Alox01/sentinela-smart/docs/mapa/fotos/corte_placa.png

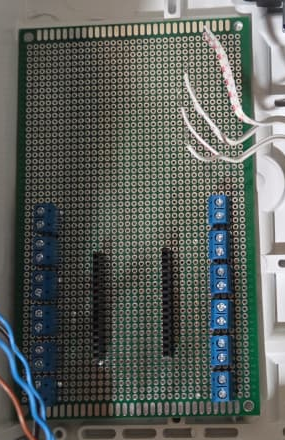
docs/mapa/fotos/corte_placa.png
