Alox01/sentinela-smart/docs/mapa/fotos/corte_fonte.png

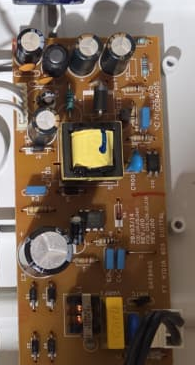
docs/mapa/fotos/corte_fonte.png
