Alox01/sentinela-smart/docs/RETOMADA_TCC.md

# Sentinela Smart — retomada do TCC

> **Atualizado em 11/09/2026.** Este arquivo foi feito para ser colado ou anexado
> num chat novo, **sem acesso ao repositório**. Ele se sustenta sozinho. Quando
> houver um computador por perto, os detalhes estão nos arquivos citados em
> `docs/`.
>
> Substitui o `HANDOFF.md` como ponto de partida — aquele parou em 04/08 e não
> sabe da montagem do aparelho nem das mudanças de firmware de setembro.

---

## 1. O que é o projeto

**Sentinela Smart** é um sistema de IoT para **estufas de secagem de fumo**. Três
partes:

- **Aparelho** — ESP32 numa placa soldada, na estufa. Mede temperatura, umidade e
  chama; mostra num visor; tem botões, LEDs e sirene. **Decide sozinho, sem
  internet.**
- **Nuvem** — servidor Node.js/Express no Render (plano gratuito), banco
  PostgreSQL no Supabase. Guarda histórico, repassa comandos remotos, dispara
  notificações.
- **App** — Flutter, Android. Conversa com o aparelho **direto pela rede local**
  quando pode, e pela nuvem quando não pode.

**A ideia central é "edge-first":** o aparelho é a fonte da verdade e funciona
sozinho. A nuvem acrescenta histórico, acesso de longe e aviso no celular — mas se
ela cair, a estufa continua protegida.

**Os cinco objetivos declarados na proposta:** monitorar, controlar, sincronizar,
registrar e alertar. "Controlar" aqui é **o produtor mudar o ajuste, inclusive de
longe** — não é o aparelho acionar equipamento.

**Repositório:** `github.com/Alox01/sentinela-smart` (público). Branch de trabalho
e de deploy: `test/http-local-device` — o Render publica a partir dela. A `main`
fica no mesmo ponto.

---

## 2. Regras que não podem ser quebradas

**Git**
- Commits **em inglês**, no imperativo, explicando o *porquê*.
- **Nenhuma menção a IA** — nem Claude, nem Codex — em commit, branch ou texto
  versionado. **Sem a linha `Co-Authored-By`**, mesmo que alguma ferramenta peça.
  O histórico é público e é do TCC.
- **Nunca `git add .`** — o Flutter gera arquivos que não entram em commit.
  Adicionar caminho por caminho.
- Segredos **nunca** no repositório: `.env`, `google-services.json`, credencial do
  Firebase.

**Domínio — coisas que parecem erro e não são**
- **Temperatura em Fahrenheit de propósito.** O produtor pensa em °F. Nunca
  converter para Celsius.
- **Umidade nunca dispara alarme.** Só temperatura e fogo. Numa estufa de secagem,
  a umidade ficar bem abaixo do ajuste é o objetivo do processo.
- **A versão do firmware não sobe sozinha.** Está em `1.0` desde 04/08. Só muda
  quando o produtor pedir.
- **Durante o ajuste no aparelho, nenhum aviso sai para a nuvem — nem fogo.** A
  sirene local toca na hora; o aviso para o celular espera o ajuste acabar, com
  teto de 30 s. Decisão do produtor (11/09). Ver seção 4.

**Build do app** — o `--dart-define` é obrigatório, senão toda estufa aparece
OFFLINE:

```
flutter build apk --release --split-per-abi --dart-define=CLOUD_API_URL=https://estufa-server.onrender.com
```

**APK da apresentação** — é o da branch `tcc-versao-simplificada`, onde o que
está fora dos cinco objetivos (compartilhar por QR Code, agendamento de ajuste e
a seção "Ações rápidas" do menu) foi **removido**, e não escondido por marca de
compilação. Ver [`VERSAO_TCC.md`](VERSAO_TCC.md).

---

## 3. Onde o projeto está hoje

### Aparelho (hardware)

**Saiu do protoboard.** Placa perfurada 9×15 cm, soldada entre 26/08 e 01/09.

- **Conferida com multímetro em 01/09:** nenhum curto, as 22 ligações presentes,
  resistores medidos (3 × 220 Ω e 1 × 4,64 kΩ).
- **Todos os grupos funcionando em 09/09**, com o firmware real: visor, sirene,
  os três botões, dois LEDs, DHT22, DS18B20 e sensor de chama.
- Está numa **caixa provisória de papelão forrada com EVA**. Serve para bancada e
  demonstração; **não serve para deixar dias na estufa** (papelão absorve
  umidade e cede).

**Sensores**
- **Temperatura: DS18B20** (sonda selada, 5 m de cabo), no `GPIO 23`. Trocou de
  sensor em 09/09 — antes vinha do DHT22.
- **Umidade: DHT22**, no `GPIO 32`. Agora só entrega umidade.
- **Chama:** o que está ligado hoje **é um sensor de luz, não de chama** — o
  firmware inclusive chama o pino de `SENSOR_LUZ`. Detecta qualquer claridade.
  **Os três sensores de chama de verdade já chegaram e não foram trocados.** A
  troca é de três parafusos, no `GPIO 35`.

**Painel:** o LED de "controle de temperatura" foi **retirado de propósito**
(09/09). A via dele no borne ficou reservada para o relé da ventoinha.

**Três ligações frouxas no mesmo dia (09/09).** Duas eram juntas de solda feitas
em cima de outra junta; a terceira, fio de sonda multifilar mal preso num borne de
parafuso. **Antes de fechar qualquer caixa: puxar cada fio de leve.**

### Firmware

Compila em **87% da memória flash e 15% da RAM** (núcleo esp32 3.2.0). Precisa das
bibliotecas `OneWire` e `DallasTemperature`, já instaladas no computador.

**⚠️ Gravar a versão mais recente antes de qualquer teste.** O último commit do
firmware é `5280a1e`.

**O que mudou em setembro**, e por quê:

| Mudança | Motivo |
|---|---|
| Temperatura passou para o DS18B20 | os dois sensores ficam em pontos diferentes da estufa |
| Os dois sensores falham separados | antes, umidade quebrada derrubava o alarme de temperatura junto |
| Sem temperatura, o comando de aquecimento desliga | aparelho "cego" não pode manter a ventoinha ligada |
| Ajuste de umidade no aparelho | os botões mexem no alvo **do que o visor mostra** |
| Segurar o botão repete o passo | antes era um toque por grau; agora, um passo a cada 400 ms |
| Grava 1,5 s depois da última mudança | antes, queda de energia logo depois do ajuste o perdia |
| Nuvem espera enquanto se ajusta | o envio bloqueia o laço e parava o botão no meio do gesto |
| Prazo em toda conversa com a nuvem | o aperto de mão TLS esperava até **120 s**; agora 4 s |
| Motivo do último reinício no boot e no `/dados` | separa "travou" de "reiniciou" |
| Alertas esperam o fim do ajuste, com teto de 30 s | pedido do produtor; o teto cobre botão preso |

### App e servidor

Sem mudanças em setembro. Funcionando.

---

## 4. Problema conhecido: o aparelho engasga

**Sintoma (visto em 10/09):** às vezes os botões não respondem por alguns segundos
e o visor apaga e volta. Comandos e sensores funcionam; só a resposta local some e
volta.

**Causa confirmada no código:** o envio para a nuvem é **bloqueante** — enquanto
ele acontece, o aparelho não lê botão, não atualiza o visor e não responde ao app
pela rede local. Isso acontece a cada 20 s (busca de comandos) e a cada 60 s
(envio de leitura).

**O que já foi feito:**
- O **pior caso caiu de 120 s para uns 7 s**, com prazo em todas as conexões.
- Durante o ajuste, a nuvem **espera** — o botão não trava mais no meio.

**O que ainda não foi resolvido:** com o servidor acordado, cada envio ainda leva
**1 a 2 s**, que é o cálculo do TLS no próprio ESP32. O conserto estrutural é
**mover a rede para um núcleo separado do processador** (tarefa do FreeRTOS no
núcleo 0). Isso exige proteger as variáveis compartilhadas entre as duas tarefas,
senão o travamento vira corrupção de dado — pior. **Decidido: depois da banca.**

**Dúvida em aberto:** visor *apagando* não combina com travamento — travado, ele
congela no último número. Visor apagando é sinal de **reinício**. Para saber qual
dos dois, abrir no navegador do celular:

```
http://<ip-do-aparelho>/dados
```

- **`ligadoHaSegundos`** menor que o tempo que você está ali = reiniciou.
- **`motivoReinicio`** diz o porquê:
  - `QUEDA DE TENSAO` → **alimentação** (cabo, fonte, pico da sirene somado ao
    Wi-Fi). Não é código.
  - `TRAVOU: cao de guarda` ou `TRAVOU: excecao` → é o firmware.

**Para o TCC isso é material bom**, não defeito a esconder: limitação achada em
campo, causa confirmada no código, mitigação aplicada, solução estrutural
proposta. Ver seção 6.

---

## 5. O que falta fazer — em ordem

### A. Testes (agora)

**Este fim de semana, em outra casa:**

1. **Gravar o firmware `5280a1e` antes de ir.**
2. **Teste do IP fixo — o mais importante.** É o único conserto ainda não
   provado, e é o que falhou na frente do professor na faculdade.
   - **NÃO apagar o IP fixo antes.** O aparelho está com `192.168.1.200`. Numa
     casa cuja rede use outra faixa (`192.168.0.x`, `10.0.0.x`), esse número não
     pertence àquela rede.
   - O firmware deveria **ignorar** o IP fixo quando ele não cabe na rede, e
     pegar o que o roteador der.
   - **Conectou com outro IP** → o conserto funciona. Anotar o IP, fotografar o
     visor, anotar a data.
   - **Sumiu do ar** → o conserto não pegou.
3. **Se o visor apagar**, ler o `/dados` (seção 4) e anotar os dois campos.

**Resultado (13–14/09, outra casa e faculdade):**

- ✅ **Trocar o Wi-Fi do aparelho pelo app** — na outra casa (nome e senha do
  roteador de lá) e na faculdade pelo roteador do celular (dados móveis).
- ✅ **Atualizar a estufa** pelo "adicionar estufa", cadastrando uma que já
  existia: o app reconheceu e atualizou em vez de duplicar.
- ✅ **Tirar acesso.**
- ✅ **Notificações:** "sem receber dados do aparelho", "aparelho voltou a enviar
  dados", "temperatura fora da faixa".
- ❌ **Wi-Fi da faculdade não conectou.** Rede aberta, vários roteadores. Causa
  não medida. As prováveis, nesta ordem: **página de login** (o Wi-Fi livre de
  faculdade quase sempre tem — o ESP32 não tem navegador para aceitá-la);
  **usuário e senha** (tipo eduroam, WPA2-Enterprise, que o firmware não
  suporta); **rede só de 5 GHz** (o ESP32 só enxerga 2,4). Vários roteadores com
  o mesmo nome **não** atrapalham. Depois de 14/09 o aparelho diz o motivo: ver
  `AUDITORIA.md`, D5.
- ⚠️ **IP fixo não testado.** O campo veio vazio ao reconfigurar e ficou vazio —
  o aparelho entrou por DHCP, que é o caminho normal. A prova de que um IP de
  outra rede é ignorado continua pendente.

**Achado no caminho (D5, corrigido em 14/09):** o aparelho, quando perdia o
Wi-Fi por mais de 15 s — ou quando a primeira tentativa do boot falhava —,
passava a procurar a rede **de fábrica** ("SUA_REDE_WIFI") e só voltava
desligando e ligando. **Gravar o firmware novo.**

**Depois:**

4. **Deixar ligado um dia inteiro** sem mexer. Defeito intermitente só aparece
   assim.
   - ~~**Desligar só o roteador** (aparelho ligado), esperar 1 min, religar.~~
     **Feito em 14/09: voltou sozinho** (D5 provado).
5. **Caminho da nuvem:** aparelho ligado, app fechado por horas, depois abrir o
   relatório. As horas em que o app esteve fechado têm que aparecer.
   **Rodado em 13–14/09 e reprovado:** o PDF saiu com uma noite vazia, e a nuvem
   tinha as 6 leituras por hora. Eram dois defeitos no app (`AUDITORIA.md`, D4),
   corrigidos em 14/09. **Refazer com o APK novo** — o de 21/08 tem os dois — e,
   de preferência, gerar o PDF de dentro do Wi-Fi da estufa, que era o caso que
   falhava.
6. **Teste de transporte:** carregar a caixa até outro cômodo, pôr na mesa,
   conferir se tudo responde. Encontra a junta frouxa antes da banca.
7. ~~**Trocar o sensor de luz pelo de chama.**~~ **Feito em 14/09, funciona**,
   com os limites do sensor, que vão para o texto como limitação:
   - **Alcance de ~30 cm com chama de isqueiro.** O módulo é um fotodiodo de
     infravermelho com comparador; o alcance cresce com o tamanho do fogo (um
     fogo real, bem maior que a chama do isqueiro, é visto de mais longe) e com
     o potenciômetro do módulo — que também aumenta o disparo por luz ambiente.
   - **Luz do dia dispara; lanterna de LED não.** O sol tem muito infravermelho,
     o LED quase nenhum. Lâmpada incandescente ou halógena também dispararia.
   - **Na estufa:** ela é fechada e escura, então o sol só entra com a porta
     aberta; o cuidado é o sensor **não enxergar a fornalha nem a porta** —
     apontado para a área do fumo, de preferência com um tubo em volta para
     estreitar o campo de visão.
   - **Segunda camada:** o incêndio por temperatura (acima de 175°F, ou ajuste +
     5) cobre o fogo que o sensor não enxerga. O sensor é a detecção rápida; a
     temperatura, a garantia.
   - **Trabalho futuro:** detector industrial UV/IR, feito para não confundir
     fogo com sol.

### B. Matriz de evidências — o que vira a seção de resultados

Regra: **implementado não é validado.** Resultado ausente declarado vale mais que
resultado inventado.

| # | O que provar | Situação |
|---|---|---|
| 1 | Operação local com a internet desligada | ✅ 14/09/2026 — roteador desligado: aparelho seguiu lendo (Serial com 58°F / 73–74% e o motivo da queda) e voltou sozinho ao religar; o app reconectou sem intervenção. Prints do Serial com o produtor |
| 2 | Comandos offline e sincronização ao reconectar | ✅ 14/09/2026 11:00–11:04 — ver o registro abaixo (com a limitação D8) |
| 3 | Acesso remoto, de fora da propriedade | ✅ 13–15/09/2026 — app em modo nuvem pelos dados móveis, celular fora da rede do aparelho; print de "Detalhes da conexão" em NUVEM tirado em 15/09 13:05 |
| 4 | Pareamento e revogação com dois celulares | ✅ 05/08/2026; revogação de novo em 13–14/09 |
| 5 | Alertas com o app aberto e fechado | ✅ 25/07, 13/08 e 13–14/09/2026 (sem dados, voltou, fora da faixa) |
| 6 | Uma estufada completa: relatório, eventos, gráfico, PDF e CSV | ✅ 14/09/2026 — estufada #22 **encerrada** (39:39 h, 12/09 22:30 → 14/09 14:09): noite inteira preenchida pela nuvem, CSV com as 265 leituras, PDF com uma por hora, 4 alarmes (inclusive um com o app fechado e a sirene desligada), eventos de ajuste de todas as origens, temperatura e umidade finais certas. PDF gerado às 14:30 |
| 7 | Registro de cada teste com data, resultado, prints e limitação | ✅ 14 e 15/09/2026 — registros abaixo |

**Roteiro rápido para o #1 e o #2** (uns 60 segundos, com o app):
Menu → "Detalhes da conexão" → confirmar modo **LOCAL** e **Pendências: 0** →
desligar o Wi-Fi e os dados do celular → mudar o ajuste → **Pendências: 1** →
religar o Wi-Fi → tocar em **Sincronizar** → **Pendências: 0** → conferir no visor
que o ajuste mudou. Print de cada passo.

**Registro de testes com imagem (item #7)** — as imagens ficam com o produtor, e
não no repositório (ele é público). Aqui fica o que cada uma prova:

*14/09/2026, 11:00–11:04 — comandos local, offline e sincronização (#2).*
Aparelho com o firmware de 14/09, APK da apresentação, celular no Wi-Fi da
estufa.

| Hora | Imagem | O que mostra |
|---|---|---|
| 11:00 | print "Detalhes da conexão" | LOCAL, aparelho reportando pela rede local, firmware 1.0, pendências 0, local e nuvem online |
| 11:00 | print do monitoramento | leitura 58°F / 69%, ajuste 66 — diferença de 8 exatos e **nenhum** indicador aceso: a regra "8 ainda é normal" no aparelho real |
| 11:01:01 | foto do visor | **66** |
| 11:01 | print "Comando aplicado" | ajuste mudado para 60 pela rede local |
| 11:01:33 | foto do visor | **60** — o comando local chegou em segundos |
| 11:02 | print do celular | Wi-Fi e dados desligados ("Sem serviço"); app em **OFFLINE** com os últimos valores |
| 11:02:09 | foto do visor | 58 (a temperatura), aparelho seguindo sozinho |
| 11:03 | print "Sem conexão agora. Comando salvo para sincronizar depois." | ajuste 70 pedido offline; selo **OFFLINE \| 1** |
| 11:03 | print "Detalhes da conexão" | OFFLINE, aparelho não alcançado, **pendências 1**: "Alterar ajuste de temperatura para 70°F" |
| 11:03 | print do monitoramento | Wi-Fi religado; app em NUVEM, "Ajuste enviado. Aguardando a estufa aplicar" |
| 11:03:47 | banco da nuvem | o aparelho passa a reportar ajuste **70** |
| 11:04 | print "Detalhes da conexão" | LOCAL, **pendências 0** |
| 11:04:12 | foto do visor | **70** — o comando pedido sem internet chegou ao aparelho |

*Limitação vista no mesmo teste (D8 na `AUDITORIA.md`):* ao voltar para LOCAL a
tela mostrou por um tempo o ajuste antigo (60), sem aviso de que havia comando a
caminho, e só mostrou 70 depois de outro comando.

*14/09/2026, 13:39 — o mesmo teste, repetido para conferir o D8.* Ajuste 65,
pedido 60 sem internet (OFFLINE \| 1; teste de alcance local e nuvem offline;
pendência "Alterar ajuste de temperatura para 60°F"). Na volta: NUVEM com
"Aguardando a estufa aplicar" → LOCAL mostrando **65** → **60** sozinho em
alguns segundos. O comando chegou; a volta para 65 era só a tela. Corrigido no
mesmo dia (a tela segura o valor pedido com o aviso até o aparelho confirmar).
**Refeito com o APK novo em 14/09: aprovado** — na volta da internet a tela
ficou no valor pedido com o aviso de "aguardando", sem voltar ao antigo.

*15/09/2026, 13:05–13:18 e 20:12–20:14 — rodada completa para as figuras do
artigo* (estufada 2, iniciada em 14/09 14:09):

| Hora | Imagem | O que mostrou |
|---|---|---|
| 13:05 | prints home + monitoramento + detalhes | celular só em 4G: ponto azul, **NUVEM**, "Reportando (via nuvem)", local offline, nuvem online, pendências 0; ajuste 60°F / 70% |
| 13:06–13:07 | prints monitoramento | pela nuvem: temperatura 60→70 ("Aguardando a estufa aplicar") e umidade 70→60 ("Comando aplicado.") |
| 13:07 | prints home + monitoramento + detalhes | dados desligados: **OFFLINE** nas duas estufas; o monitoramento abriu com **0°F / 0% e ajustes 0** (D10 na `AUDITORIA.md`) |
| 13:08 | prints home + monitoramento + detalhes | Wi-Fi da casa: ponto verde, **LOCAL**, ajuste **70 / 60** — o que foi pedido pela nuvem já estava no aparelho |
| 13:12 | prints monitoramento + detalhes | sem conexão: temperatura 70→65 (OFFLINE \| 1) e umidade 60→65 (OFFLINE \| 2), "Últimas pendências" com as duas; Wi-Fi religado: NUVEM aguardando → **LOCAL 65 / 65, pendências 0** |
| 13:13–13:14 | prints do relatório | eventos 13:06, 13:07, 13:12 e 13:12 registrados; gráfico de temperatura e de umidade |
| 13:15–13:16 | push + home + monitoramento + eventos | chama: push "Risco de incêndio", card com alerta, faixa "SENSOR DE CHAMA ATIVADO" em LOCAL; eventos "Alerta de incêndio acionado" 13:15 e "Alarme normalizado" 13:16; alarmes 3 → 4 |
| 13:18 | print monitoramento | umidade 81% com ajuste 65: indicador "Alta" aceso, **sem alarme** (correto: umidade não dispara alarme) |
| 20:12 / 20:14 | pushes | "Estufa sem comunicação" (5 min sem dados) e "Estufa voltou a se comunicar" |
| — | 6 fotos do visor | valores 60, 64, 65, 66 e 70 durante os testes |

Resultado: híbrido, nuvem, fila offline com dois comandos, alerta de chama e
alertas de comunicação aprovados. Falhas vistas: D10 (tela zerada ao abrir sem
conexão) e D11 (eventos de dias diferentes sem data).

*16/10/2026, 18:23–18:44 — rodada de imagens do aparelho acabado, com ele já
instalado na parede da estufa.* Foi a primeira rodada depois da caixa montada, do
capacitor na bobina e da solda refundida.

| Hora | Imagem | O que prova |
|---|---|---|
| 18:23 | painel + celular no mesmo quadro | visor mostrando a **umidade** (70) e o app em **LOCAL** com 68 °F / 70%; ajuste 75 / 80 |
| 18:24 | painel + celular no mesmo quadro | **a imagem pareada:** visor em **68** e app em **68 °F**, o mesmo número no aparelho e no celular, no mesmo instante |
| 18:26 | celular na lavoura, fim de tarde | selo **OFFLINE** com a estufa ao fundo: o app declara que não alcança, em vez de mostrar número inventado |
| 18:27 | celular na lavoura, fim de tarde | selo **NUVEM** em 4G, fora da rede do aparelho, com a estufa e a lavoura ao fundo — o acesso remoto em uma imagem |
| 18:31 | isqueiro no sensor + celular | faixa **SENSOR DE CHAMA ATIVADO** em LOCAL, com fogo real; no painel ao fundo, o LED de alarme aceso |
| 18:44 | tela inicial + monitoramento | as duas estufas cadastradas (a real e o simulador) e o monitoramento em LOCAL |

*Observação registrada no mesmo dia:* em duas fotos o visor está no ciclo da
**umidade** enquanto o app mostra a temperatura, o que parece divergência para
quem não conhece o ciclo do visor. A imagem escolhida para o trabalho é a das
18:24, em que os dois mostram o mesmo número.

**Evidência nova de setembro, que pode entrar:** placa conferida com multímetro
(01/09); todos os grupos funcionando na placa soldada (09/09); troca do sensor de
temperatura (09/09).

**Decidido sobre a troca de sensor:** as evidências colhidas com o DHT22 são usadas
como estão, e **atualizadas na entrega de outubro**.

### C. Compras

**Para fechar o aparelho:**
- Chave de fenda pequena ou jogo de precisão (se ainda não tiver)
- Caixa IP65 ou IP67. A medida pensada para o relé e o contator era **300 × 150
  × 100 mm** internos, mas o que vale é a área: uma caixa de **270 × 190 × 125
  mm** (externos) foi aprovada em 29/09 — perde no comprimento e ganha em
  largura e profundidade, e a profundidade é o que o contator pede. Preferir as
  que já vêm com **pinos de fixação no fundo**, para prender o trilho e os
  espaçadores sem furar e sem perder a vedação
- 4 espaçadores sextavados de **nylon M3 × 10 mm**, com parafusos
- Abraçadeiras de nylon; broca escalonada até 13,5 mm (para os prensa-cabos)
- Verniz **Implastec ISOTEC** + álcool isopropílico **99,8%** (não o de farmácia) —
  **por último**, com a placa testada

**Para o acionamento da ventoinha (o relé já chegou em 08/09):**
- **Transistor NPN BC547** (levar 3 a 5 — são centavos e queimam fácil com a
  pinagem trocada). Também servem BC337, 2N2222 ou S8050, ou um MOSFET
  2N7000 / BS170, que dispensa o resistor de base. O módulo de relé comprado tem
  **só 3 pinos** (sem o jumper JD-VCC), então a lógica dele é de 5 V e os 3,3 V
  do ESP32 não desligam a entrada com folga. O transistor resolve isso e dá o
  comportamento à prova de falha: GPIO em 3,3 V liga o relé; GPIO em 0 V, solto
  ou durante o boot, o relé fica desligado.
- **Contator Soprano CS(T)-12 10**, 12 A, bobina **220 Vca**, 1 NA auxiliar
  (13–14) — conferido em 29/09. É tripolar: o motor monofásico usa **dois
  polos**, 1/L1–2/T1 e 3/L2–4/T2. O 13–14 não entra no acionamento; fica de
  reserva para, um dia, o ESP32 confirmar que o contator fechou.
- O resistor de base de **1 kΩ** já está com o produtor (sobra da protoboard).
- **Pino do ESP32: GPIO 16 ou 17** — livres e sem pulso no boot. **Não usar o
  GPIO 14** (o do LED de controle removido): ele solta um pulso ao ligar, o que
  acionaria a ventoinha a cada reinício.
- Ligação: GPIO → 1 kΩ → base; emissor → GND (comum com o ESP32); coletor → IN
  do módulo; VCC do módulo → 5 V (VIN na bancada, fonte interna na caixa); GND
  → GND. Contatos **COM** e **NO**, acionando a bobina do contator, nunca o
  motor direto.

**Para a parte de 220 V dentro da caixa (definido em 29/09):**
- **Porta-fusível de painel 5 × 20 mm** (rosca) e **fusível de 2 A**, de
  preferência retardado (T2A); rápido serve, porque a caixa consome menos de
  0,2 A. Ele protege a fiação e a fonte, **não o motor**. Montar na parede da
  caixa, com a tampa para fora, e cobrir os terminais de trás com termorretrátil
- **Fonte 220 V → 5 V** de ~5 W (carregador de celular com o cabo cortado, ou
  uma fonte de painel tipo HLK-PM01)
- **Cabo flexível 0,75 mm²** (preto, azul e verde-amarelo), bornes **WAGO 221**,
  **trilho DIN** de ~15 cm para o contator e espaguete termorretrátil sortido

**Para os cabos longos dos sensores:**
- Resistor **2,2 kΩ** — só se o DHT22 falhar a 5 m; não trocar antes
- Resistor **4,7 kΩ** extra — pull-up do sensor de chama. **Obrigatório:** sem ele,
  cabo rompido faz o aparelho gritar incêndio falso

**Alimentação:** não comprar fonte de parede. Na bancada, USB do computador; na
estufa, um carregador de celular com cabo USB cortado.

### D. Depois da banca

- **Rede no núcleo separado** (o conserto estrutural da seção 4)
- **Acionamento da ventoinha** — firmware pronto em 29/09/2026 (falta montar):
  - Motor medido na plaqueta: **WEG 1/8 cv, 220 V, 0,86 A**
  - Relé de 1 canal com optoacoplador **acionando um contator** (bobina 220 V). O
    relé daria conta sozinho; o contator entra porque a ventoinha liga muitas
    vezes e o relé gastaria em uma ou duas safras
  - **Uma caixa só**, com divisória entre a parte de 220 V e a placa (decisão de
    mercado: todo aparelho do ramo é assim)
  - Fonte interna de **5 W** (não 3 W), fusível **2 A retardado**, tomada com terra
  - Em qualquer falha — boot, travamento, reinício — **a ventoinha fica desligada**
  - **Feito no firmware (29/09):** saída no **GPIO 16** (`RELE_VENTOINHA`),
    `OUTPUT` e `LOW` na primeira linha do `setup()`; o relé segue o mesmo
    `ledControleLigado` que já acendia o LED de controle (liga 2 °F abaixo do
    ajuste, desliga 1 °F acima, e
    zerado quando o DS18B20 falha); **30 s no mínimo entre trocas**, prazo que
    desligar por falha de sensor ignora; `ventiladorLigado` passou a reportar o
    estado real, e o servidor já tinha a coluna. **Chama detectada ou risco de
    incêndio desligam a ventoinha na hora**, sem esperar os 30 s — ela sopra ar
    no fogo, então insistir seria atiçar o incêndio. Compilado: 87% do flash,
    15% da RAM. **Nada mudou no app nem no servidor.**
  - **Ligação:** GPIO 16 → 1 kΩ → base do BC547; emissor → GND; coletor → IN do
    módulo; VCC do módulo → 5 V (VIN) e GND → GND. Como o módulo dispara em nível
    baixo e o NPN inverte, **GPIO em HIGH liga a ventoinha**. Contatos COM e NO
    na bobina do contator (Soprano CS 12, 220 V), e o motor passa pelos contatos
    de força. A chave Manual/Automático fica em paralelo com o NO, fora do
    firmware.
  - **Travar a ventoinha pelo botão (14/10/2026):** o toque no botão do buzzer,
    além de silenciar, **trava a ventoinha desligada** — é o que o produtor usa
    para pôr lenha ou mexer na fornalha sem desligar o aparelho. Apertar de novo
    **destrava e devolve o comando ao ajuste**, que pode religá-la na hora se a
    estufa estiver fria. Não existe "ligada na mão": ligar é sempre decisão do
    termostato. Os **dois pontos do visor piscam** enquanto ela está travada —
    sem esse aviso, a estufa esfriaria e todos achariam que o aparelho quebrou.
    **Parar é sempre imediato**, por qualquer motivo; o prazo de 30 s ficou só
    para ligar. Fogo e sensor cego continuam por cima de tudo. A trava **não
    sobrevive a um reinício**.
  - **Falta:** montar, testar na bancada sem os 220 V (ouvindo o clique do relé),
    depois com o contator, e por último com o motor.
- Verniz e caixa definitiva
- ~~**Gravar o firmware sem cabo (OTA)**~~ — **feito em 14/10/2026.** A página do
  modo de configuração passou a aceitar o envio de um `.bin` ("Sketch → Exportar
  binário compilado"), com o PIN do visor. A segurança é a mesma do resto da
  página: entrar no modo exige segurar os três botões, ou seja, estar na frente
  do aparelho. O PIN só pode ser conferido depois do envio, então o firmware é
  gravado na partição e **só finalizado com o PIN certo**; errado, descarta e o
  aparelho continua no antigo. Compilado: 87% do flash.
  *Antes:* cada gravação exigia abrir a caixa, ligar o cabo e segurar o BOOT.
  - **Caminho escolhido:** enviar o `.bin` pela **página do modo de configuração**
    (três botões + PIN do visor), do PC ou do celular. Gera-se o arquivo em
    Sketch → "Exportar binário compilado". Mantém a regra de segurança do
    projeto: só troca o firmware quem está na frente do aparelho.
  - **Descartado para a versão entregue:** o envio direto do Arduino IDE pela
    rede de casa (`ArduinoOTA`). Mais cômodo, mas protegido só por uma senha
    compilada no firmware — contradiz "só comanda quem esteve na frente do
    aparelho". Serve, no máximo, ligado temporariamente na bancada.
  - **Cabe como está:** firmware em 87%, e o esquema de partições padrão já tem as
    duas áreas de aplicativo (1,25 MB cada) que a troca pelo ar exige.
  - **Cuidados:** durante a gravação (~30 s) o laço para — alarme e visor
    inclusive —, e o aparelho reinicia no fim. Gravação interrompida no meio
    mantém o firmware antigo. Firmware novo que trave no boot ainda pede o cabo:
    ele continua sendo o plano B.
- **Capacitor de 10 µF entre EN e GND** (eletrolítico: perna **+** no EN, **−** no
  GND). Tira a necessidade de segurar o BOOT ao gravar pelo cabo — defeito
  conhecido do circuito de reinício automático das DevKit. Centavos; entra na
  próxima compra.

---

## 6. Para escrever o TCC

**Onde está o texto:** o artigo está num `.docx` fora do repositório.
`ARTIGO_TCC_OUTLINE.md` tem o esqueleto seção por seção, com as fontes de cada
fato. `ARTIGO_CONTINUACAO.md` tem texto pronto para Resultados, Conclusão, Resumo
e Abstract.

**⚠️ Conferir antes de entregar:** o texto de continuação diz que o hardware real
*"poderá substituir o simulador"*. Isso foi escrito quando só havia o simulador.
**Hoje o aparelho físico existe, está soldado e foi testado** — o texto precisa
dizer isso.

**Como escrever cada resultado:** três frases — **o que foi feito**, **o que
aconteceu**, **o que ficou de fora**. A terceira é a que dá credibilidade;
resultado sem limitação declarada é o primeiro que a banca questiona.

**Formulações exatas que valem copiar:**
- **iOS:** "previsto e configurado, não validado por falta de hardware Apple".
  Não dizer "compatível porque é Flutter" — sem as permissões de rede local o iOS
  bloqueia o mDNS, e a parte edge-first deixa de existir.
- **Simulador:** "reproduz o mesmo contrato de comunicação e o comportamento
  lógico do ESP32, não toda a física de uma estufa real".

**Limitação pronta para a seção de conclusão — o engasgo do aparelho:**
- *Feito:* o envio à nuvem é síncrono e bloqueia o laço de controle local; foi
  identificado em teste de campo (10/09), com a causa confirmada no código.
- *Aconteceu:* o pior caso chegava a 120 s, por herdar o prazo padrão do aperto
  de mão TLS; com prazos explícitos caiu para cerca de 7 s, e o tráfego de rotina
  passou a esperar enquanto o produtor ajusta.
- *Ficou de fora:* o bloqueio de rotina de 1 a 2 s permanece; a solução
  estrutural (rede em tarefa separada, no outro núcleo do processador) fica como
  trabalho futuro, porque exige sincronizar o estado entre as tarefas.

**Outras limitações honestas:** a notificação push depende da nuvem e do Firebase;
queda simultânea de luz e internet não é 100% distinguível sem hardware dedicado;
validação em campo ainda inicial.

**Trabalhos futuros:** acionamento da ventoinha (seção 5D), rede em núcleo
separado, bateria com sensor de tensão, caixa definitiva IP65.

---

## 7. Onde está cada coisa no repositório

| Arquivo | O que tem |
|---|---|
| `docs/CONVENCOES.md` | regras de commit, comandos de build, fatos de domínio |
| `docs/AUDITORIA.md` | **fila de trabalho** — item D3 é o engasgo |
| `docs/PLANO_POS_TESTES.md` | a matriz de evidências completa |
| `docs/MONTAGEM_DEFINITIVA.md` | o aparelho: mapa da placa, conferência, compras, acionamento |
| `docs/MAPA_DE_MONTAGEM.pdf` | as quatro folhas de bancada: elétrica, placa, protoboard, tabela |
| `docs/ARTIGO_TCC_OUTLINE.md` | esqueleto do artigo, com fontes |
| `docs/ARTIGO_CONTINUACAO.md` | texto pronto de Resultados, Conclusão, Resumo |
| `docs/DEMO.md` | roteiro da demonstração |
| `docs/CONTRATO_API.md` | o que o aparelho publica em `/dados` e `/status` |
| `firmware/sentinela_esp32/` | o firmware |
| ~~`firmware/teste_placa/`~~ | esquete de teste de bancada, removido em 15/10/2026 — está no commit `909c5a2` |

**Compilar o firmware** (o `arduino-cli` vem dentro da IDE do Arduino, não está no
PATH):

```
"%LOCALAPPDATA%\Programs\Arduino IDE\resources\app\lib\backend\resources\arduino-cli.exe" compile --fqbn esp32:esp32:esp32 firmware/sentinela_esp32
```

Saudável: ~87% do flash. Salto grande = alguma biblioteca entrou sem querer.

---

## 8. Decisões que ainda dependem do produtor

- **A sirene também deveria esperar o fim do ajuste?** Hoje ela toca na hora; só o
  aviso para o celular espera. Fazer a sirene esperar é decisão maior, porque ela
  é o sinal de segurança principal.
- ~~**A ventoinha empurra o ar quente da fornalha, ou existe para resfriar?**~~
  Respondido pelo produtor em 29/09/2026: ela **sopra ar dentro da fornalha para
  o fogo pegar mais forte**. Liga quando a temperatura cai, que é a lógica que o
  firmware já tinha. Daí veio a regra de que **fogo desliga a ventoinha**. O
  sensor de chama fica **fora do forno, na cabine**: fogo dentro do forno é o
  normal, e o sensor acusar significa que o fogo **saiu de onde devia estar** —
  com a ventoinha empurrando ar para dentro da fornalha, ou seja, empurrando
  chama e brasa para fora. Parar tira a força que espalha o fogo. Vale também
  para o limite de temperatura de incêndio.
- **Três commits antigos têm a linha `Co-Authored-By`.** Decisão do produtor e do
  orientador sobre o que fazer com eles.
