Alox01/sentinela-smart/docs/README.md

# Índice da documentação

São 28 arquivos. Este índice existe para ninguém abrir seis para achar um — e
para separar o que **vale hoje** do que é **registro do que já foi**.

## Comece por aqui

| Se você quer… | Leia |
|---|---|
| mexer no código | **`CONVENCOES.md`** — regras de commit, comandos de build, e os fatos de domínio que parecem bug e não são |
| saber o estado do projeto | **`HANDOFF.md`** |
| pegar a próxima tarefa | **`AUDITORIA.md`** — é a fila de trabalho, com caixas |
| ver as melhorias mais recentes | **`MELHORIAS_CODIGO_2026-10-15.md`** — segurança, TLS, rastreabilidade e pendências operacionais |

## O sistema como ele é

- **`CONTRATO_API.md`** — o JSON que app, aparelho e nuvem falam entre si. É a
  referência de quem mexe em qualquer uma das três pontas.
- **`CONFIGURACAO_ESP32.md`** — pinagem, modo de configuração, endereçamento na
  rede, chave por aparelho e PIN de emparelhamento. O maior e o mais consultado.
- **`NOTIFICACOES_PUSH.md`** — quais avisos existem, quem acorda de madrugada e
  a pegadinha dos canais do Android. Ao fim, preserva separadamente uma ideia
  de produto **pós-TCC**, que não entra no APK nem na apresentação da banca.
- **`HISTORICO_FIRMWARE.md`** — o que cada versao do firmware mudou e por que.
  Morava no topo do `.ino`; o motivo medido em campo esta aqui, o *quando* esta
  no `git log`.
- **`AMBIENTE_ESTUFA.md`** — como é a propriedade e a estufa. Sem isso, decisão
  de limiar e de sensor vira chute.
- **`SEGURANCA.md`** e **`SEGURANCA_COMANDOS.md`** — o modelo de ameaça e o
  emparelhamento por PIN.
- **`PLANO_BANCO_DADOS.md`** — o que é guardado, por quanto tempo e por quê.

## Planos e filas

- **`AUDITORIA.md`** — dívida técnica, com progresso marcado.
- **`PLANO_POS_TESTES.md`** — testes de campo e o que cada um provou.
- **`ROADMAP_PRE_APK.md`** — o que precedeu o primeiro APK. Histórico.

## Trabalho futuro (nada disso está construído)

- **`HUB_LORA.md`** — evolução pós-TCC: hub local com ESP-NOW/LoRa, tela touch,
  SD, alarmes sem internet e comandos confirmados. Leia o aviso do topo: não
  entra no APK, na demonstração nem nos critérios da banca.
- **`AGENDAMENTO_CURA.md`** — curva de cura por fases, além do agendamento
  simples que já existe.
- **`SUPRESSAO_INCENDIO.md`** — atuação contra fogo, não só aviso.
- **`VIABILIDADE_COMERCIAL.md`** — se um dia virar produto.

## TCC

- **`VERSAO_TCC.md`** — o que a branch `tcc-versao-simplificada` removeu da
  versão de produção, por quê, e o que continua existindo. É a resposta para
  "por que o sistema não faz X?".

- **`MAPA_DO_CODIGO.md`** — o que responder quando perguntarem "qual biblioteca
  você usou para isso?" ou "onde está a lógica do alarme?". Feito para ler uma vez
  antes de apresentar.

- **`ARTIGO_TCC_OUTLINE.md`** e **`ARTIGO_CONTINUACAO.md`** — estrutura e
  rascunhos do texto.
- **`DIAGRAMAS.md`** — DER, arquitetura, sequência e o modelo local.

## Apoio a quem desenvolve

- **`IOS.md`** — o que já está configurado para iPhone, o que só se resolve com
  um Mac, e por que a falta de duas chaves no `Info.plist` mata a rede local sem
  dar erro nenhum.
- **`EXECUCAO_LOCAL.md`** — subir servidor e app na máquina.
- **`ESP32_VIRTUAL.md`** e **`TESTE_ESP32_REAL.md`** — testar com e sem aparelho.
- **`DEMO.md`** — roteiro de demonstração.
- **`NUVEM_POR_APARELHO.md`** — como um aparelho vira estado na nuvem.
- **`MONTAGEM_DEFINITIVA.md`** — sair do protoboard: o que comprar, por que
  caixa IP67 não basta sozinha, e as armadilhas de compra (TM1637 × TM1650,
  módulo de 5 V numa GPIO de 3,3 V, o teto de 80 °C do DHT22).
- **`MAPA_DE_MONTAGEM.pdf`** — as quatro folhas para levar junto da bancada:
  a parte elétrica inteira numa figura (com foto das peças deste aparelho), a
  placa perfurada via por via, a mesma montagem em protoboard e a tabela de
  ligações. Desenhado por `mapa/montar_pdf.py`, que o refaz do zero — mexer no
  PDF é mexer no script, nunca no arquivo gerado.

## Quando o documento e o código divergem

Quando um documento contradiz o código, **o código está certo** — e o documento
virou dívida. Corrija-o no mesmo commit.
