Alox01/sentinela-smart/docs/CONVENCOES.md

# Convenções do projeto

Regras que valem para qualquer um que mexa neste repositório. Existem porque
**cada uma já foi quebrada pelo menos uma vez**, e o estrago só apareceu depois.

## Git

- **Mensagens de commit em inglês**, no imperativo, descrevendo o *porquê* — não
  o *o quê*, que o diff já conta.
- **Nunca `git add .` nem `git add estufa_app`.** O Flutter regenera
  `estufa_app/{linux,macos,windows}/flutter/generated_*` a cada build, e esses
  arquivos **não entram em commit**. Estagie caminho por caminho
  (`git add estufa_app/lib docs/…`).
- **Nada de segredo versionado:** `.env`, `google-services.json` e a credencial
  do Firebase estão no `.gitignore` e devem continuar fora.
- Branch de trabalho: `test/http-local-device` — é dela que o Render publica.

## Build

**APK** — o `--dart-define` é obrigatório. Sem ele o app sobe com a nuvem
desconfigurada e **toda estufa aparece OFFLINE**, incluindo o simulador:

```
flutter build apk --release --dart-define=CLOUD_API_URL=https://estufa-server.onrender.com
```

Esse comando gera **um APK só, com as três arquiteturas dentro** — 64,6 MB, dos
quais o celular usa um terço. Para instalar num aparelho de verdade, prefira
separado por arquitetura:

```
flutter build apk --release --split-per-abi --dart-define=CLOUD_API_URL=https://estufa-server.onrender.com
```

Saem três, em `build/app/outputs/flutter-apk/`:

| Arquivo | Tamanho | Para quem |
|---|---|---|
| `app-arm64-v8a-release.apk` | 23,7 MB | **qualquer celular Android dos últimos ~8 anos** — é este |
| `app-armeabi-v7a-release.apk` | 21,4 MB | aparelho antigo, 32 bits |
| `app-x86_64-release.apk` | 25,3 MB | emulador no PC |

Na dúvida sobre o aparelho: `adb shell getprop ro.product.cpu.abi`.

**Nesta branch não existe `ESCOPO_TCC`.** Ela *é* a versão reduzida: o que a
marca escondia foi removido do código, e sai um APK só. A branch de produção
(`test/http-local-device`) continua com o app completo e com a marca — é de lá
que o produtor instala.

O APK único continua servindo para **mandar para alguém sem perguntar o modelo
do celular** — ele instala em qualquer um, ao custo dos 40 MB que sobram.

**Firmware** — o `arduino-cli` não está no PATH; ele vem dentro da instalação da
IDE do Arduino:

```
"…/Arduino IDE/resources/app/lib/backend/resources/arduino-cli.exe" compile --fqbn esp32:esp32:esp32 firmware/sentinela_esp32
```

Saudável: ~86% do flash, ~15% da memória. Salto grande = alguma biblioteca
entrou sem querer.

**Testes** — servidor: `node --test "estufa_server/test/*.test.js"`.
App: `flutter test` dentro de `estufa_app`.

## Domínio (erros que parecem bug e não são)

- **`Push nuvem -> HTTP 401` pode ser o banco pausado, não chave errada**
  (14/10/2026). O Supabase do plano gratuito **pausa o projeto** depois de dias
  sem atividade. Com o banco fora, a consulta da chave do aparelho volta vazia,
  a nuvem cai na comparação com a chave universal — que o aparelho não manda,
  ele manda a dele — e responde **401**, exatamente como se a chave estivesse
  errada. Antes de mexer em chave, abra o painel do Supabase e veja se o projeto
  está **pausado**; se estiver, "Resume project" resolve e os dados voltam
  inteiros. **Risco de banca:** confirmar o painel na véspera, e deixar o
  aparelho ligado reportando nos dias anteriores, porque é o tráfego dele que
  evita a pausa.

- **Temperatura em Fahrenheit de propósito.** O produtor pensa em °F; converter
  para Celsius "para ficar certo" quebra a leitura dele.
- **Número de versão do firmware não sobe sozinho.** Reiniciou em `1.0` em
  04/08/2026 e só muda quando o produtor pede — ele diz *o que está na mão de
  alguém*, não *o que mudou no código*, que o `git log` já conta. Versões citadas
  em documentos antigos (`v1.16.0`, `v1.18.0`, `v1.24.0`…) são da numeração de
  bancada, listada em `HISTORICO_FIRMWARE.md`, e não existem mais como alvo de
  gravação.
- **Umidade não vira evento no relatório** (11/08/2026). Ela continua sendo
  medida, guardada e desenhada no gráfico, que tem aba própria — mas "umidade
  abaixo do ajuste" se repetia a estufada inteira e empurrava para fora da tela o
  que diz alguma coisa: alarme, mudança de ajuste, queda de conexão. Numa estufa
  de secagem, ficar muito abaixo do ajuste **é o objetivo do processo**.
- **A umidade tem ajuste no aparelho desde 09/09/2026, e ele não aciona nada.**
  Os botões mexem no alvo **do que o visor está mostrando** — umidade se está na
  umidade, temperatura se está na temperatura. Antes, entrar em ajuste jogava o
  visor de volta para a temperatura, e quem estava olhando a umidade concluía que
  tinha errado o botão. O número continua sendo **registrado, nunca atuado**: ele é
  a linha tracejada do gráfico de umidade e o que o app sincroniza, e nenhuma
  decisão do aparelho olha para ele.
- **Durante o ajuste no aparelho, nenhum aviso sai para a nuvem — nem fogo**
  (11/09/2026, decisão do produtor). Enviar é bloqueante, e enviar no meio do
  gesto parava o segurar-para-subir. A **sirene local toca na hora** de qualquer
  jeito, porque ela não trava nada; o que espera é só o aviso para quem não está
  na estufa. O alerta **não se perde**: fica pendente e sai no primeiro laço
  depois do ajuste, com o alvo já no valor final — e passar do ponto e voltar no
  mesmo ajuste não manda nada, porque nada mudou. **Teto de 30 s**
  (`ESPERA_MAX_ALERTA_NO_AJUSTE_MS`): sem ele, um botão preso manteria o ajuste
  aberto para sempre, e o aviso de fogo nunca sairia.
- **Umidade nunca dispara alarme.** Só temperatura e fogo. Isso vale também na
  **aparência**: no relatório da estufada a umidade sai como `registro`, em
  cinza, e não com a marca vermelha de quem acionou alarme. Ela chegou a sair
  vermelha, no meio das linhas de "Alarme acionado", e a estufada parecia ter
  tido dezessete emergências que nunca existiram. Numa estufa de secagem a
  umidade ficar muito abaixo do ajuste é **o objetivo do processo**.
- **Desvio é mais de 8 do ajuste, para cima e para baixo — em todo lugar**
  (14/09/2026, decisão do produtor). °F na temperatura, % na umidade. Vale para
  a sirene e o aviso no celular (só temperatura), o LED, o gráfico, os eventos do
  relatório e a gravação antecipada no banco. Diferença de **8 exata ainda é
  normal**; 9 já é desvio. Os lugares: `margemF` (firmware), `margemAjuste`
  (app, usado também pelo `detector_oscilacao.dart`), `TOLERANCIA_TEMP` /
  `TOLERANCIA_UMID` (`logica.js`) e `LIMITE_*` (`storage_policy.js`). Mudar um
  sem os outros é o defeito que já aconteceu três vezes: uma tela chamando de
  desvio o que o aparelho trata como normal. Duas coisas somam ou sobem acima
  dos 8 de propósito: a **folga da acomodação** (até +8 por 5 min depois de mudar
  o ajuste) e o nível **crítico** do relatório (mais de 20).
- **O aparelho é a fonte da verdade.** O app espelha o que ele reporta, não emite
  um segundo parecer.
- **O interruptor da sirene é sobre o ALARME**, não sobre todo som: apitos de
  confirmação tocam mesmo com ela desligada, e a notificação do celular é canal
  separado, com preferências próprias.

## Onde vai um arquivo novo

Convivem duas organizações no app, porque uma migração começou e parou:
`features/<assunto>/` e as pastas por camada na raiz (`screens/`, `services/`,
`widgets/`, `models/`). Sem destino declarado, cada um decide sozinho —
e já aconteceu: uma tela nova criou `features/home/screens/` porque a pasta não
existia, sem que isso fosse decisão de ninguém.

**O destino é `features/`.** Regra de bolso:

- **Tem dono claro?** (agendamento, notificações, monitoramento, aparelho, home,
  relatório) → `features/<assunto>/` — com `models/`, `screens/`, `services/`,
  `widgets/` dentro, conforme precisar.
- **Serve a todo mundo?** (`api_service`, `isar_service`, `monitor_estufas`, as
  entidades do Isar) → fica onde está, na raiz. É infraestrutura, não assunto.
- **Na dúvida entre dois assuntos**, escolha o que *usa*, não o que *parece*.

**Migração por oportunidade, nunca em bloco.** Mover arquivo em massa produz um
commit gigante que ninguém revisa e apaga o histórico de quem mexeu no quê. Ao
tocar num arquivo da raiz que tem dono claro, mova-o **no mesmo commit** se for
barato; se não for, deixe.

O que sobrou na raiz hoje (`screens/`, três widgets) é legado, não
modelo a seguir.

## Plataformas: Android e iOS, mais nada

**Decidido em 04/08/2026.** A web saiu, e junto foram `linux/`, `macos/` e
`windows/`, que existiam só porque o Flutter os cria.

O que a web custava, e que agora não existe: um **banco em memória inteiro**
escrito à mão (`isar_service_web`, 316 linhas) mais uma segunda cópia dentro do
próprio `isar_service_native` (22 desvios `kIsWeb`), três pares
`_web`/`_io`/`_stub`, cinco modelos `_web` e um caminho separado de formulário. E
o preço apareceu no mesmo dia: remover o backup exigiu editar os dois lados do
banco, e a remoção automática levou junto o `_limparHistoricoAntigo` do lado web.
O `analyze` pegou — mas o lado que ninguém executava foi quem quase quebrou a
retenção do lado que todo mundo executa.

Além disso a web nunca poderia contar a história do sistema: **no navegador não
existe rede local com o aparelho**, então ela seria só a nuvem — o contrário do
edge-first que o projeto defende.

**iOS é alvo declarado, e ainda não existe de fato.** A pasta `ios/` é o
esqueleto que o Flutter criou. Para valer, falta: `GoogleService-Info.plist`
(push), `NSLocalNetworkUsageDescription` e `NSBonjourServices` no `Info.plist`
(sem isso o iOS **bloqueia mDNS e a rede local**, e o app só falaria com a
nuvem), um Mac para compilar e conta de desenvolvedor. Nada disso é obstáculo de
código — mas quem mexer no app deve saber que **iOS hoje não é testado**.

**Consequência boa e imediata:** sumiu a armadilha de `estufa_app/{linux,macos,
windows}/flutter/generated_*` reaparecer modificado a cada build e entrar em
commit sem querer. Ela já pegou duas vezes.

## Arquivos gerados (`.g.dart`)

Os `.g.dart` do Isar são **versionados de propósito** — ~8.500 linhas, 38% do
app. Não é descuido: eles precisam estar em sincronia com os modelos, e já houve
incidente de código gerado desatualizado derrubando o app no boot
(`IsarError: Collection id is invalid`).

Portanto: **ao mexer numa entidade do Isar, regenere e commite junto.**

```
dart run build_runner build --delete-conflicting-outputs
```

Não confundir com os `generated_*` de `linux/macos/windows`, que o Flutter
regera a cada build e **não entram em commit**.

## Onde está o plano

- `AUDITORIA.md` — dívida técnica, com caixas de progresso. **É a fila de
  trabalho.**
- `HANDOFF.md` — estado geral e o que falta.
- `PLANO_POS_TESTES.md` — testes de campo e resultados.

Marque a caixa **no mesmo commit** da mudança. Documento que diz "feito" sobre
trabalho que não existe é pior que documento nenhum — já aconteceu aqui.

## Trabalho em partes

O projeto é grande demais para uma tacada só, e trabalho longo demais erra mais
perto do fim. Então:

- **Uma tarefa por vez**, ou em áreas que não se cruzam. Duas frentes na mesma
  tela dão conflito silencioso.
- **Quem escreve não verifica.** Conferir o próprio trabalho tende a acreditar em
  si mesmo; a conferência vale mais vinda de fora.
- **Mutação de teste se desfaz com cópia, nunca com `git checkout`.** Provar que
  um teste pega a regressão exige estragar o código de propósito — e desfazer
  isso com `git checkout -- arquivo` **apaga todo o trabalho não commitado
  daquele arquivo**, não só a estragadinha. Já aconteceu aqui, e custou a
  reconstrução de uma tela inteira. Copie antes, restaure da cópia.
- **Refatoração precisa de prova de que nada mudou** — inventário antes/depois,
  a suíte inteira, e um teste de fumaça que exercite o caminho real.
