Alox01/sentinela-smart/docs/DIAGRAMAS.md

# Diagramas do TCC (fontes editáveis)

Fontes dos diagramas do artigo, em código, para renderizar e exportar como
imagem. Fiéis ao schema/código do projeto — atualizar aqui se o código mudar.

**Como gerar a imagem para o Word:** cole o bloco em <https://mermaid.live>,
depois use *Actions → PNG* (ou SVG) e insira no documento. Para PNG de alta
resolução, aumente o zoom antes de exportar.

---

## 1. DER — banco de dados em nuvem (PostgreSQL/Supabase)

Escopo: persistência na nuvem. As entidades de *estufada* e *eventos* ficam hoje
no banco local do app (Isar, NoSQL) e não entram neste DER relacional.
Fonte: `database/schema.sql`.

> **O bloco Mermaid abaixo mostra quatro tabelas; o banco tem sete.**
> `push_dispositivos`, `comandos_pendentes` e `comandos_agendados` nasceram
> depois, direto no `db.js`, e nunca entraram aqui. Ficar fora do desenho foi o
> mesmo motivo de elas terem escapado da revisão de RLS uma vez.
>
> A figura completa, com as sete e com a distinção entre chave estrangeira
> declarada e ligação por `identificador_hardware`, é gerada por
> `docs/figuras/der_nuvem.py` e sai em `docs/figuras/der_nuvem.png`. É ela que
> vai para o artigo.

```mermaid
erDiagram
    dispositivos ||--|| configuracoes : "tem"
    dispositivos ||--o{ leituras : "gera"
    dispositivos ||--o{ comandos_sync : "recebe"

    dispositivos {
        uuid id PK
        text nome
        text identificador_hardware UK
        text tipo_dispositivo
        text ip_local
        boolean ativo
        timestamptz created_at
        timestamptz updated_at
    }
    configuracoes {
        uuid dispositivo_id PK_FK
        numeric temperatura_meta
        bigint temp_timestamp
        numeric umidade_meta
        bigint umid_timestamp
        boolean modo_silencioso
        bigint modo_silencioso_timestamp
        timestamptz updated_at
    }
    leituras {
        bigserial id PK
        uuid dispositivo_id FK
        timestamptz timestamp_leitura
        bigint timestamp_origem_ms
        numeric temperatura
        numeric umidade
        numeric temperatura_meta
        numeric umidade_meta
        boolean alerta_incendio
        text aviso
        text cor_status
        text fase_atual
        boolean tem_energia
        boolean tem_internet
        integer sinal_wifi
        boolean aquecedor_ligado
        boolean ventilador_ligado
        boolean umidificador_ligado
        text fonte
        timestamptz created_at
    }
    comandos_sync {
        bigserial id PK
        uuid dispositivo_id FK
        text identificador_hardware
        jsonb payload
        text status
        text origem
        text erro
        timestamptz created_at
        timestamptz synced_at
    }
```

Relacionamentos e regras (do schema):
- `dispositivos` 1:1 `configuracoes` (a PK de `configuracoes` é também FK;
  `on delete cascade`).
- `dispositivos` 1:N `leituras` (`on delete cascade`).
- `dispositivos` 1:N `comandos_sync` (`on delete set null` — a FK aceita nulo).
- `identificador_hardware` é único em `dispositivos`.
- Checks de domínio: `tipo_dispositivo ∈ {simulador, hardware}`;
  `leituras.fonte ∈ {simulador, hardware, manual}`;
  `comandos_sync.status ∈ {pendente, enviado, aplicado, ignorado, erro}`;
  `comandos_sync.origem ∈ {app, hardware, simulador, admin}`.

---

## 2. Arquitetura híbrida (app ↔ controlador ↔ nuvem)

Fontes: `DEMO.md`, `api_service.dart` (resolução local → porta 80 → nuvem).

```mermaid
flowchart LR
    subgraph local["Rede local · Wi-Fi da propriedade"]
        controlador["Controlador<br/>ESP32 real ou virtual<br/>sensores · borda"]
        app["App (celular)<br/>Flutter<br/>resolve local → nuvem"]
    end
    nuvem["Nuvem<br/>Render + PostgreSQL (Supabase)<br/>histórico · acesso remoto"]

    app <-->|"1 · LOCAL (Wi-Fi)"| controlador
    app <-->|"2 · NUVEM (fallback)"| nuvem
    controlador -->|"push HTTP · POST /leitura"| nuvem
```

Modos: **LOCAL** (app lê o aparelho pela Wi-Fi, sem internet — prioridade);
**NUVEM** (assume quando o local não responde); **OFFLINE** (nenhum acessível —
comandos e leituras ficam em fila até reconectar).

## 3. Sequência da sincronização (fila offline + Last-Write-Wins)

Fontes: `DEMO.md` (cenário 3), lógica de sync do servidor e da fila local.

> **A nuvem não aparece no bloco abaixo, e deveria.** Aqui a fila volta sempre
> pela rede local, e não é o que acontece: na volta da conexão o aplicativo
> entrega por onde conseguir, e pela nuvem o comando ainda espera o controlador
> buscar. É dessa espera que sai a limitação de "até cerca de vinte segundos"
> declarada no artigo — ou seja, justamente o que o desenho omitia.
>
> A figura com os dois caminhos, em bloco `alt`, é gerada por
> `docs/figuras/sequencia_sync.py`. É ela que vai para o artigo.

```mermaid
sequenceDiagram
    actor U as Usuário
    participant A as App
    participant F as Fila local (Isar)
    participant C as Controlador

    U->>A: altera ajuste de temperatura
    A->>C: tenta enviar comando
    C-->>A: inacessível (offline)
    A->>F: enfileira comando + timestamp
    F-->>A: pendente
    Note over A: UI: "comando enfileirado"

    Note over U,C: aparelho volta · próxima leitura

    A->>F: busca comandos pendentes
    F-->>A: comando + timestamp
    A->>C: POST /sincronizar
    Note over C: aplica Last-Write-Wins por campo:<br/>o timestamp mais recente vence;<br/>comando antigo é ignorado
    C-->>A: estado atualizado
    A->>F: marca como sincronizado
```

## 4. Modelo do banco local (Isar, NoSQL) — complementar ao DER

Não é um DER: o Isar não usa tabelas nem chaves estrangeiras. São **coleções de
objetos**, e as ligações são **referência lógica por id** (o app casa os ids;
o banco não impõe integridade). `PK` = id automático, `IDX` = `@Index`,
`UQ` = índice único. Fontes: `estufa_app/lib/models/*_entity.dart`.

```mermaid
classDiagram
    class EstufaEntity {
        Id id
        String chave
        String nome
        String ip
        String tokenAcesso
        DateTime criadaEm
    }
    class CicloSecagemEntity {
        Id id
        String ipEstufa
        String nomeEstufa
        DateTime inicio
        DateTime fim
        String status
        String observacao
    }
    class EventoCicloEntity {
        Id id
        String ipEstufa
        int cicloId
        String nomeEstufa
        DateTime timestamp
        String tipo
        String severidade
        String descricao
        double valorAnterior
        double valorAtual
    }
    class HistoricoLeituraEntity {
        Id id
        String ipEstufa
        String nomeEstufa
        DateTime timestamp
        double temperatura
        double umidade
        double temperaturaMeta
        double umidadeMeta
        String aviso
        bool alertaIncendio
    }
    class PendingSyncCommandEntity {
        Id id
        String ipEstufa
        String payloadJson
        DateTime createdAt
    }

    EstufaEntity ..> CicloSecagemEntity : ip = ipEstufa
    EstufaEntity ..> HistoricoLeituraEntity : ip = ipEstufa
    EstufaEntity ..> PendingSyncCommandEntity : ip = ipEstufa
    CicloSecagemEntity ..> EventoCicloEntity : id = cicloId
    CicloSecagemEntity ..> HistoricoLeituraEntity : ip + intervalo
```

Índices por coleção: `EstufaEntity.chave` (único); `ipEstufa` é indexado em
`CicloSecagemEntity`, `EventoCicloEntity`, `HistoricoLeituraEntity` e
`PendingSyncCommandEntity`; `cicloId` é indexado em `EventoCicloEntity`.
Ligações: as demais coleções apontam para a estufa por `ip = ipEstufa`; o evento
aponta para o ciclo por `cicloId`; a leitura associa-se ao ciclo por `ipEstufa`
mais o intervalo de tempo (`inicio..fim`), não por id direto.
