Alox01/sentinela-smart/docs/figuras/casos_de_uso.png

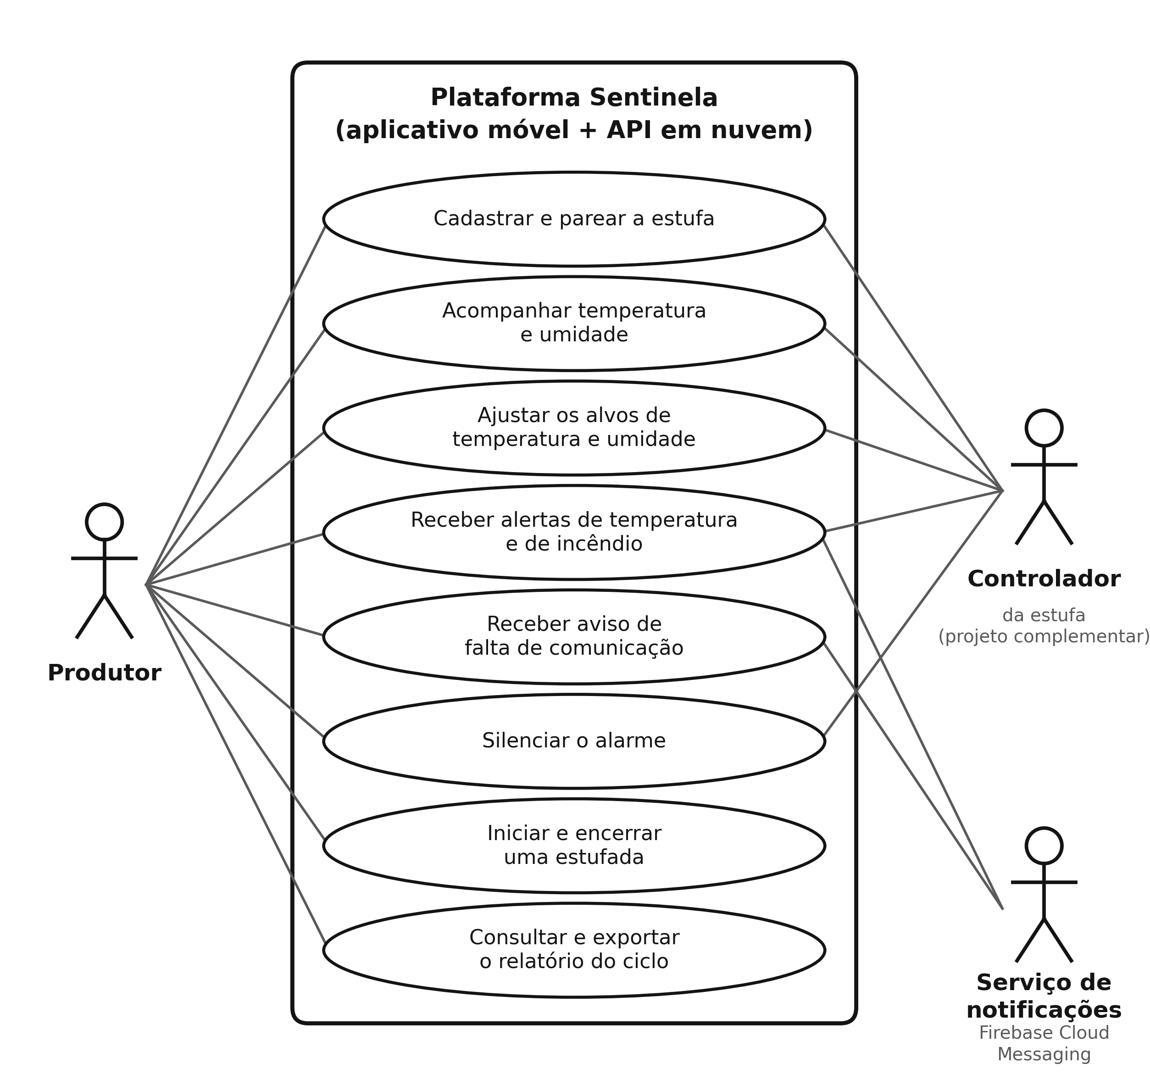
docs/figuras/casos_de_uso.png
