Alox01/sentinela-smart/docs/figuras/der_chen.png

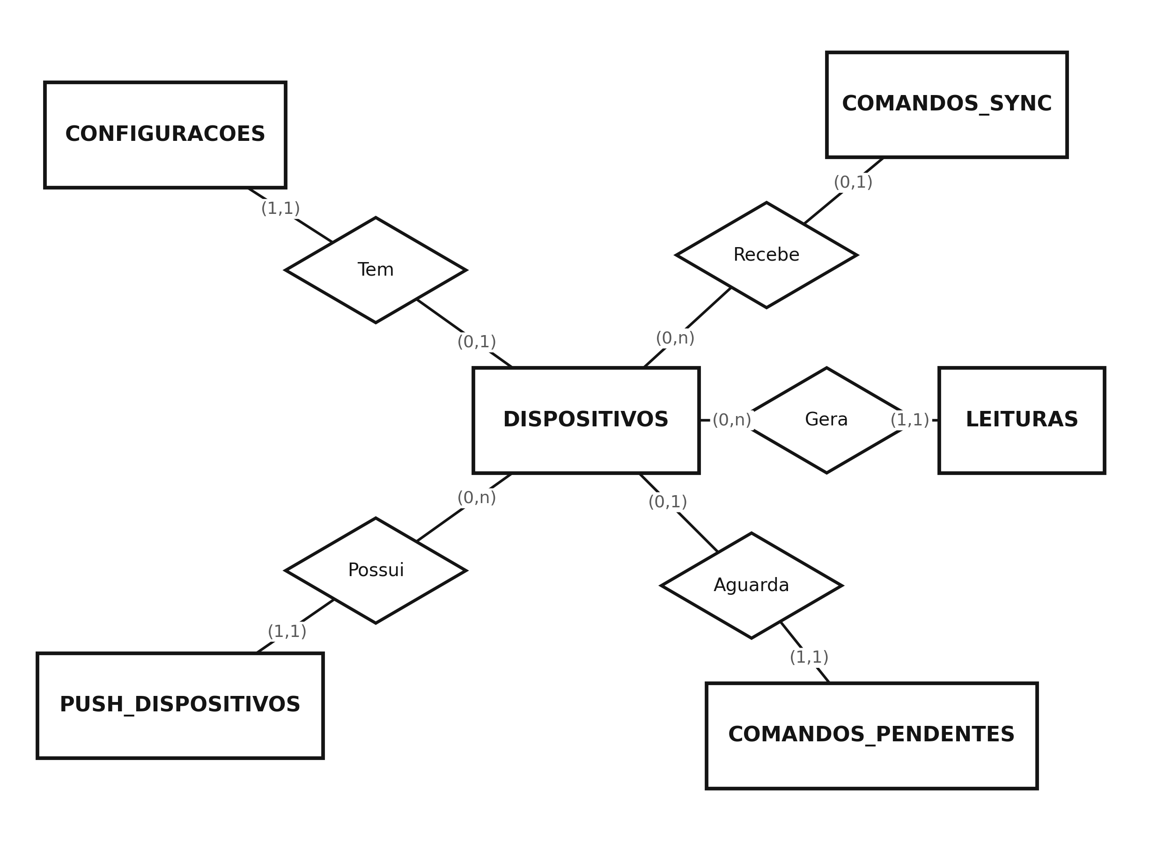
docs/figuras/der_chen.png
