Alox01/sentinela-smart/docs/figuras/der_nuvem.png

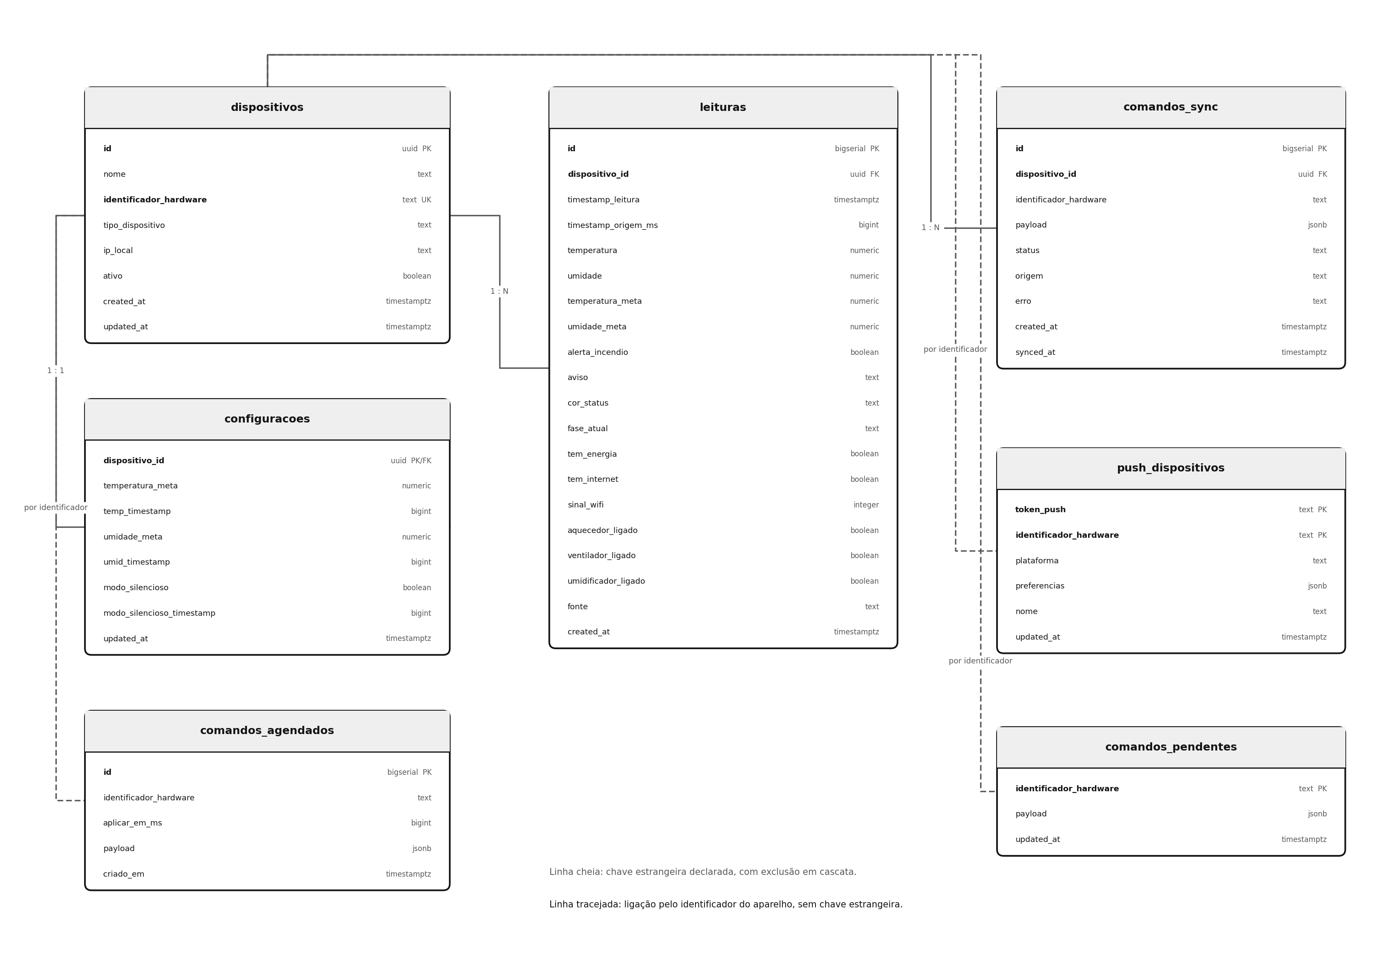
docs/figuras/der_nuvem.png
