Alox01/sentinela-smart/docs/figuras/sequencia_sync.png

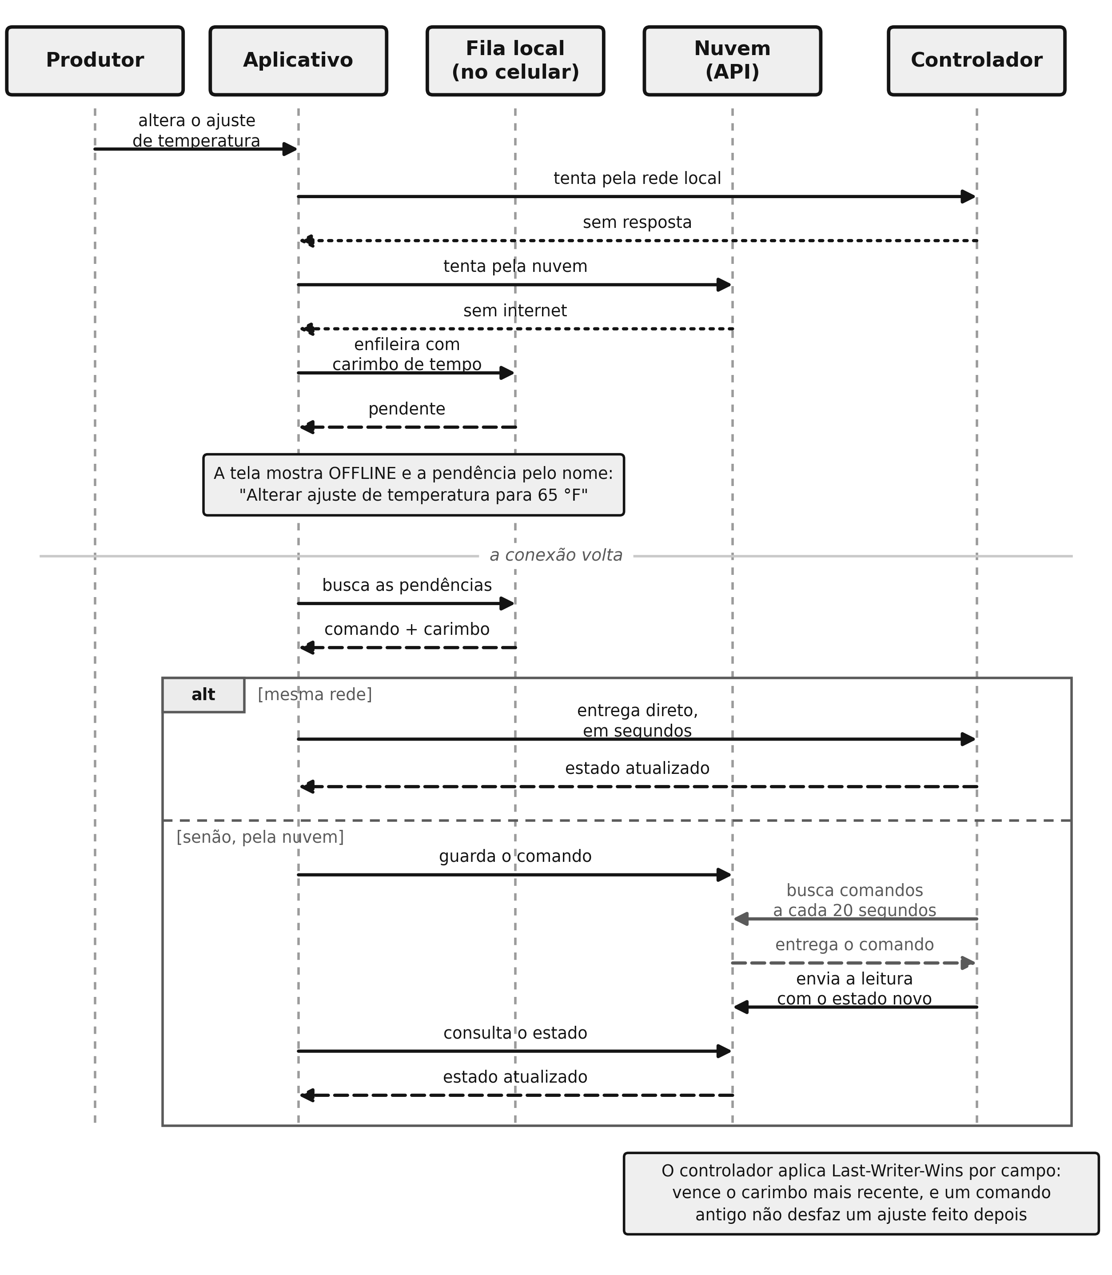
docs/figuras/sequencia_sync.png
