Alox01/sentinela-smart/docs/mapa/fotos/corte_contator.png

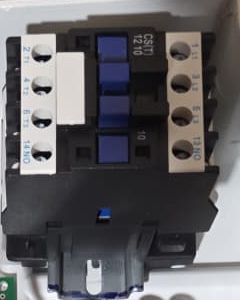
docs/mapa/fotos/corte_contator.png
