Alox01/sentinela-smart/docs/MAPA_DE_MONTAGEM.pdf

# SENTINELA SMART mapa elétrico do acionamento da ventoinha

## CONTATOR Soprano CS(T)-12 10

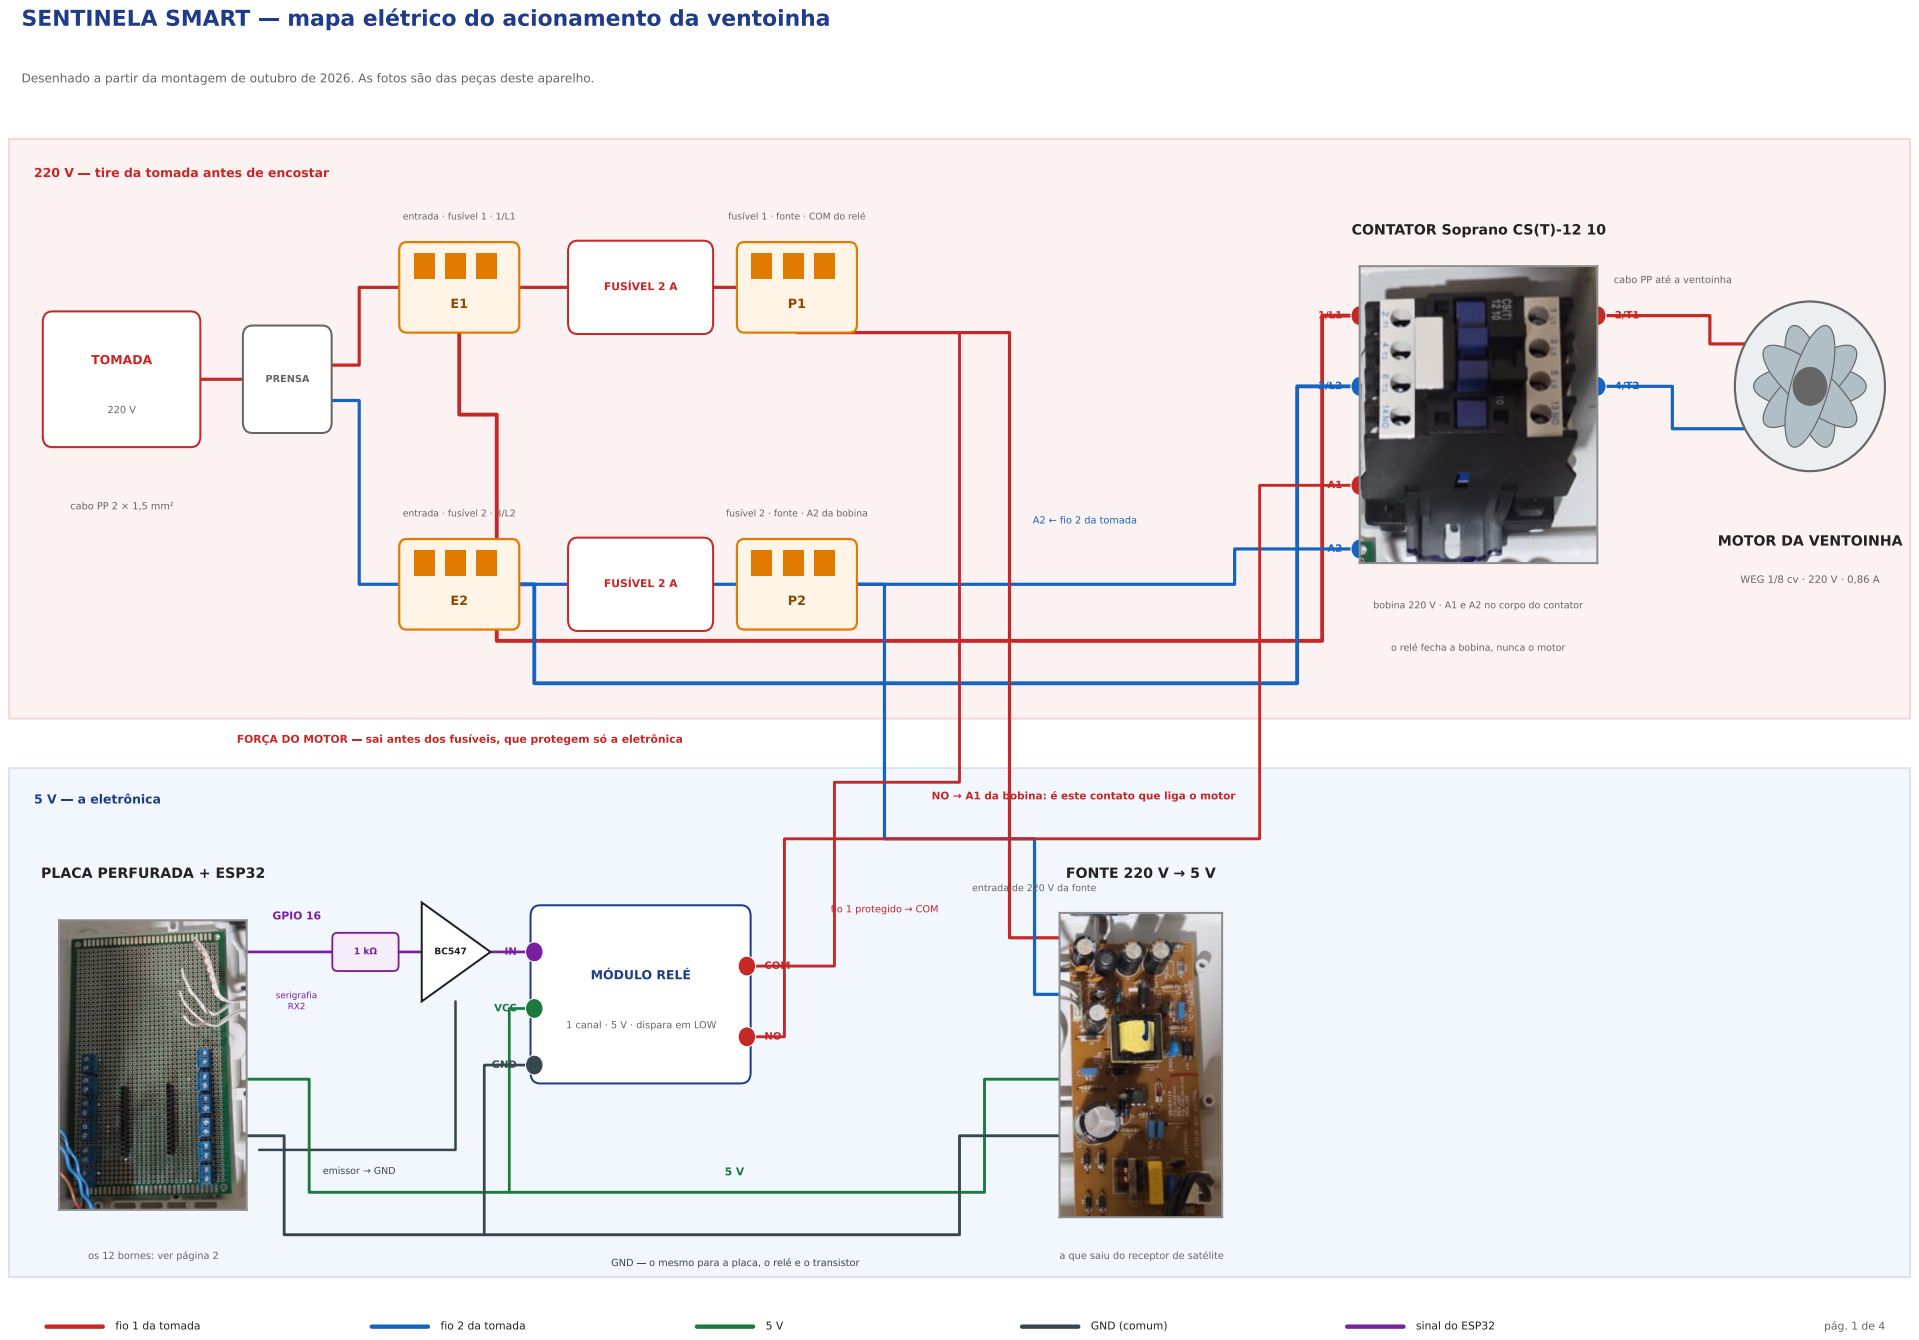
[picture p8: page 1]
tire da tomada antes de encostar; a eletrônica; fio 1 da tomada; fio 2 da tomada; GND (comum); sinal do ESP32; pág. 1 de 4; TOMADA; PRENSA; FUSÍVEL 2 A; MÓDULO RELÉ; entrada · fusível 1 · 1/L1; entrada · fusível 2 ·; FORÇA DO MOTOR; sai antes dos fusíveis, que protegem só a eletrônica; VCC; GND; COM; GPIO 16; serigrafia RX2; emissor; o mesmo para a placa, o relé e o transistor; fio 1 protegido; A1 da bobina: é este contato que liga o motor; WEG 1/8 cv · 220 V · 0,86 A; PLACA PERFURADA + ESP32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

Desenhado a partir da montagem de outubro de 2026. As fotos são das peças deste aparelho.

fusível 1 · fonte · COM do relé

cabo PP até a ventoinha

fusível 2 · fonte · A2 da bobina cabo PP 2 × 1,5 mm²

MOTOR DA VENTOINHA

bobina 220 V · A1 e A2 no corpo do contator

o relé fecha a bobina, nunca o motor

entrada de 220 V da fonte

1 canal · 5 V · dispara em LOW

os 12 bornes: ver página 2

a que saiu do receptor de satélite

# A PLACA PERFURADA, COMO ESTÁ MONTADA

Montada em 26 29/08 e 01/09/2026; o DS18B20 entrou em 09/09 e ocupou as duas vias que ainda estavam livres. Os nomes das vias são os da serigrafia da própria placa.

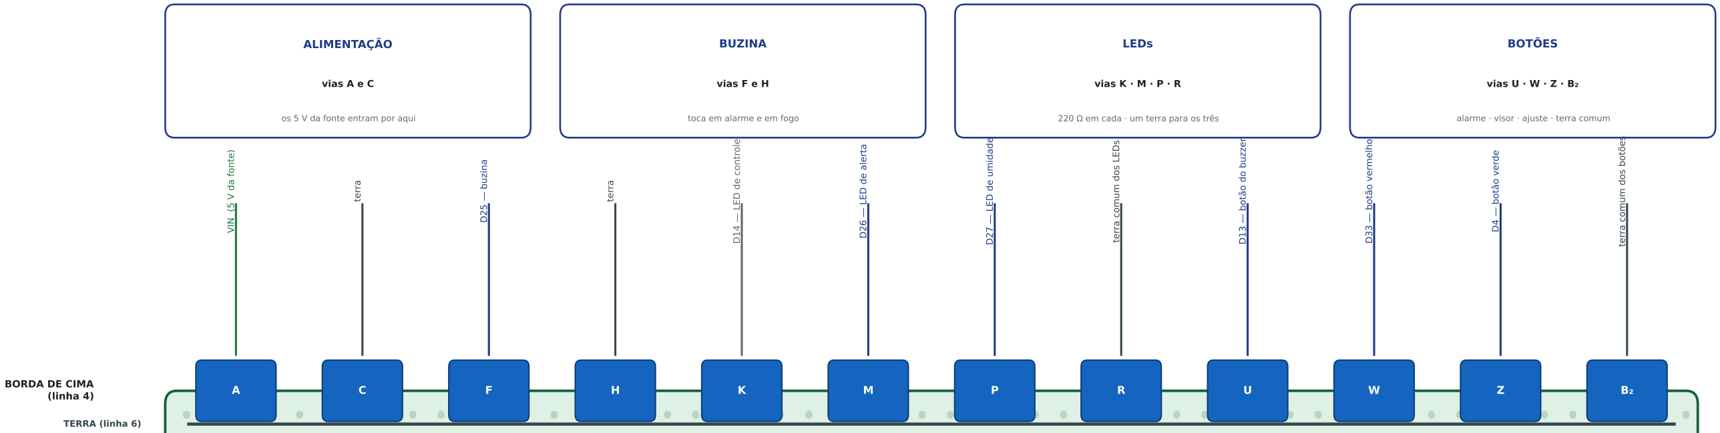
[picture p9: figure]
ALIMENTAÇÃO; vias A e C; os 5 V da fonte entram por aqui; BUZINA; vias F e H; toca em alarme e em fogo; LEDs; vias K · M · P · R; em cada · um terra para os três; BOTÕES; vias U · W · Z · B; alarme · visor · ajuste · terra comum; TERRA (linha 6); AVIN ⁽⁵ V da fonte⁾; Cterra; FD²⁵ buzina; Hterra; KD¹⁴ LED de controle; MD²⁶ LED de alerta; PD²⁷ LED de umidade; Rterra comum dos LEDs; UD¹³ botão do buzzer; WD³³ botão vermelho; ZD⁴ botão verde; Bterra comum dos botões; BORDA DE CIMA (linha 4)
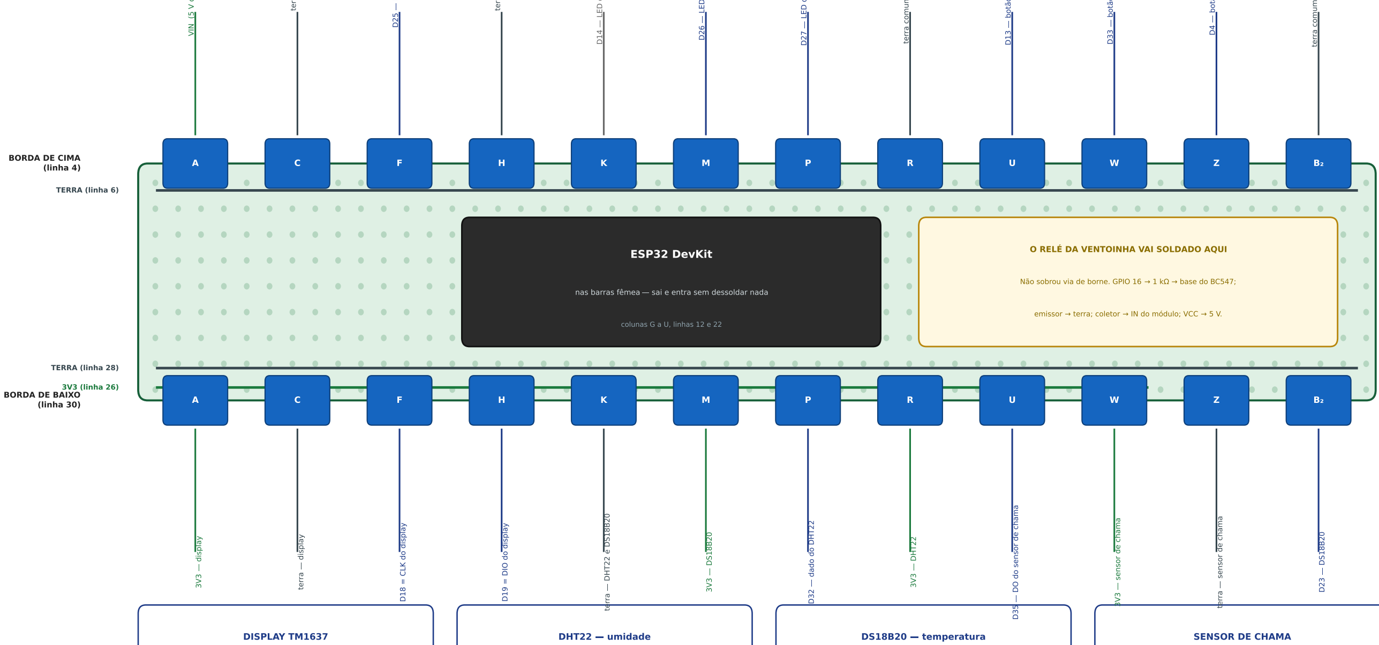
[picture p10: figure]
DISPLAY TM1637; DHT22; umidade; temperatura; SENSOR DE CHAMA; ESP32 DevKit; colunas G a U, linhas 12 e 22; TERRA (linha 28); 3V3 (linha 26); A 3V3 display; C terra display; F D¹⁸ = CLK do display; H D¹⁹ = DIO do display; K terra DHT22 e DS18B20; P D³² dado do DHT22; R 3V3 DHT22; U D³⁵ DO do sensor de chama; W3V3 sensor de chama; Z terra sensor de chama; B D²³ DS18B20; BORDA DE BAIXO (linha 30); O RELÉ DA VENTOINHA VAI SOLDADO AQUI; emissor; terra; coletor; IN do módulo; VCC

nas barras fêmea | sai e entra sem dessoldar nada
Não sobrou via de borne. GPIO 16 | 1 k | base do BC547;

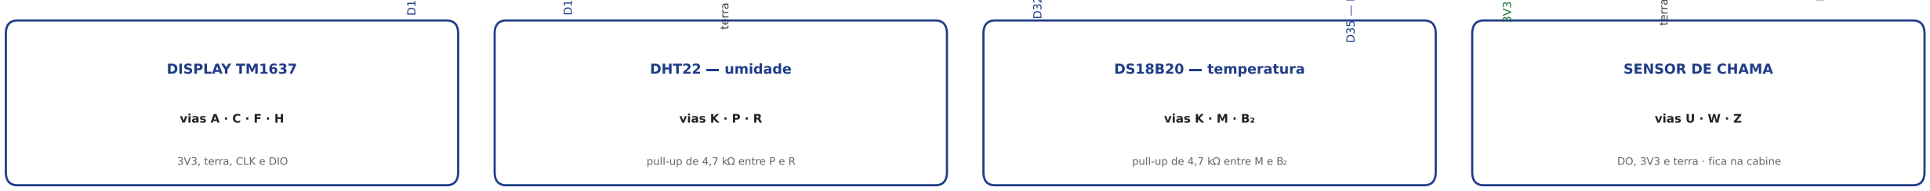
[picture p11: figure]
vias A · C · F · H; 3V3, terra, CLK e DIO; vias K · P · R; pull-up de 4,7 k entre P e R; vias K · M · B; pull-up de 4,7 k entre M e B; vias U · W · Z; DO, 3V3 e terra · fica na cabine

A via K da borda de cima está no mapa porque a placa foi feita para três LEDs. O terceiro | controle, D14 | nunca foi instalado: são dois LEDs.

# O MESMO APARELHO EM PROTOBOARD

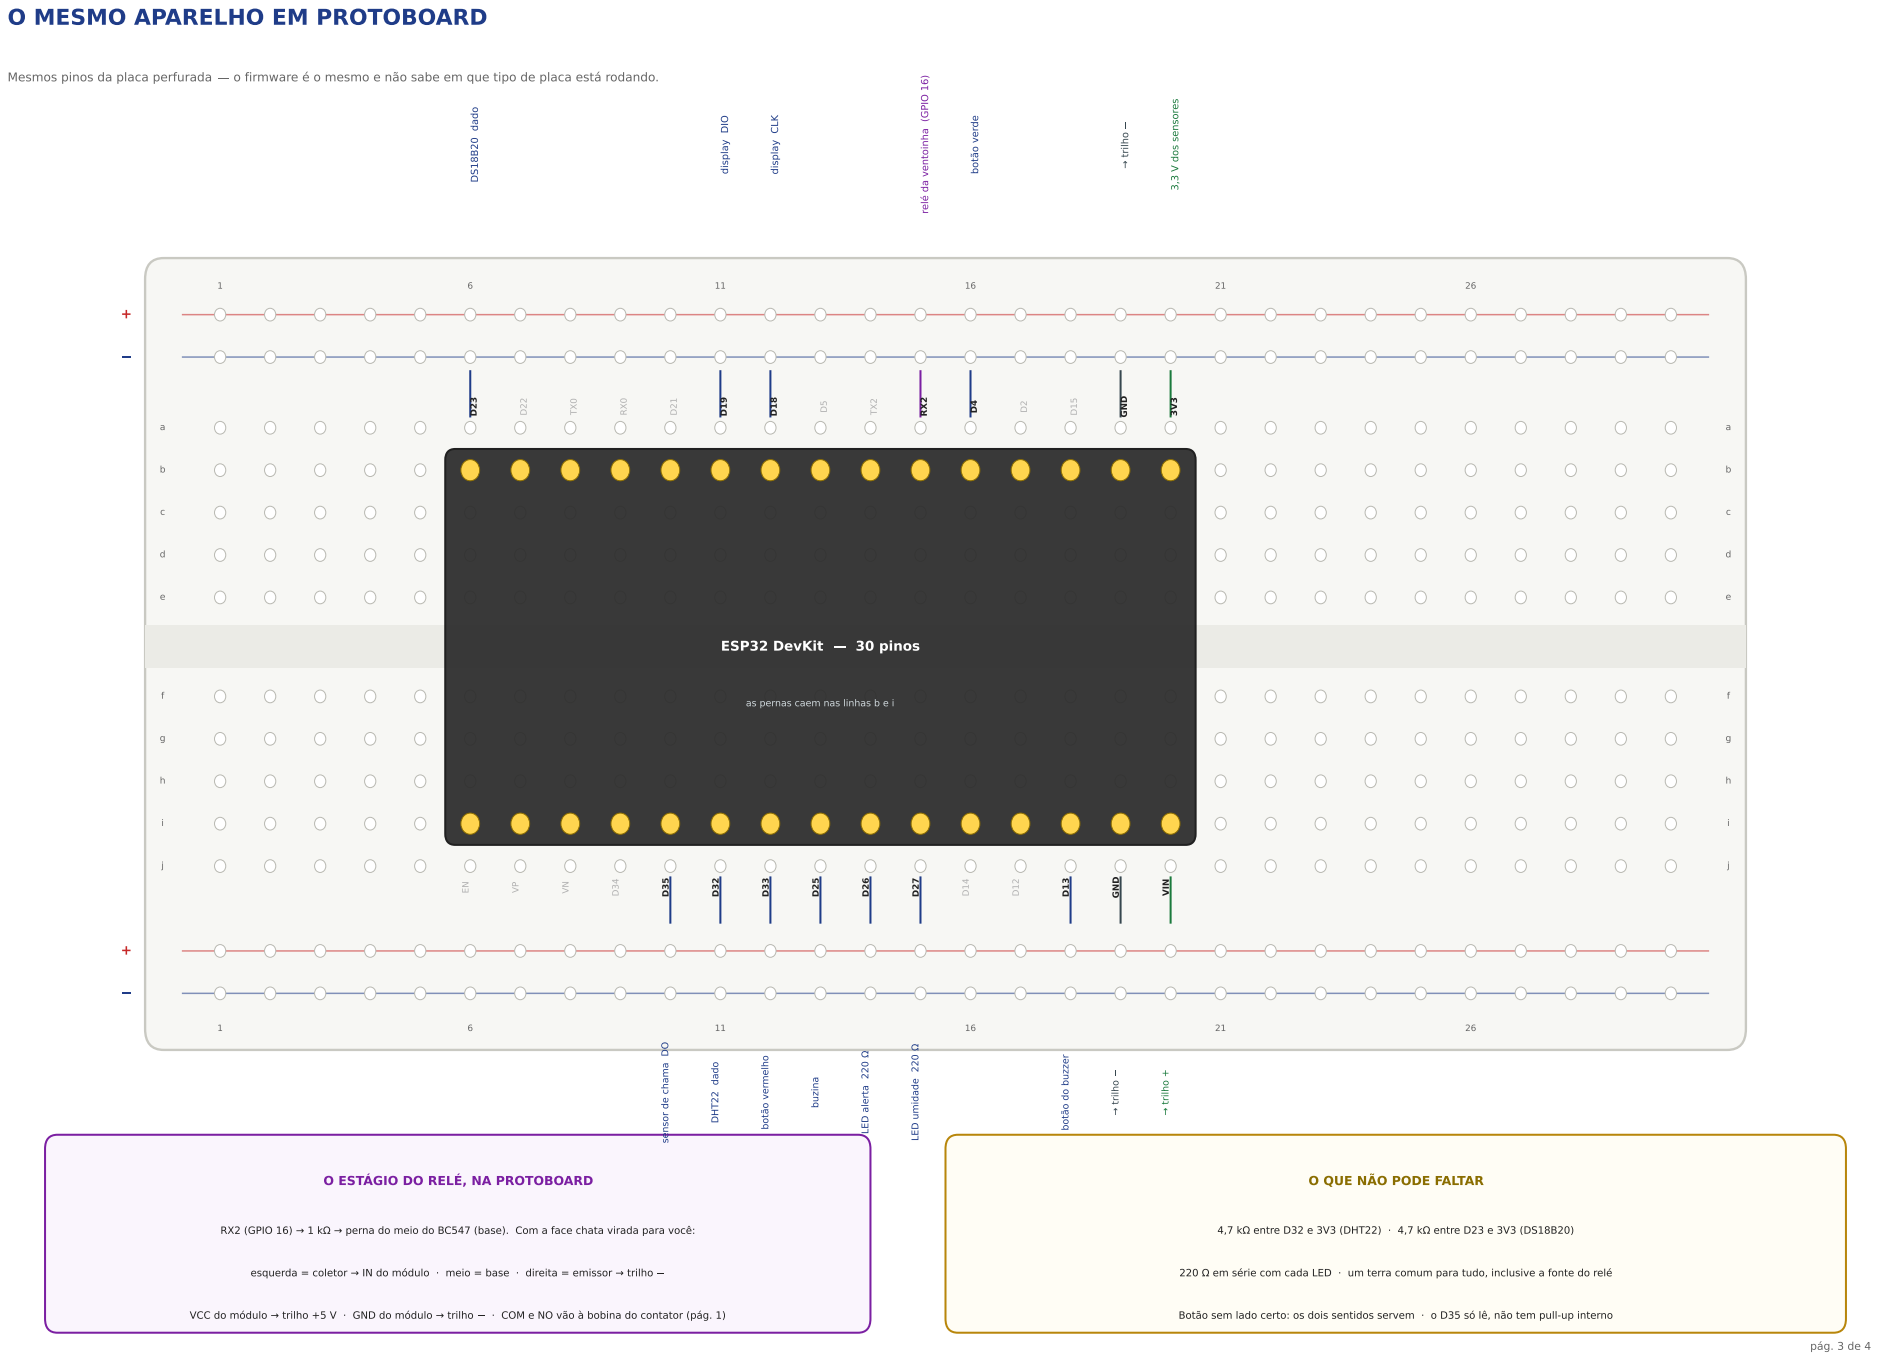
[picture p12: page 3]

RX2 relé da ventoinha (GPIO 16)

as pernas caem nas linhas b e i

D35 sensor de chama DO

O ESTÁGIO DO RELÉ, NA PROTOBOARD

O QUE NÃO PODE FALTAR

Botão sem lado certo: os dois sentidos servem · o D35 só lê, não tem pull-up interno

# TABELA DE LIGAÇÕES

Os nomes dos pinos são os da serigrafia do ESP32; as vias são as da placa perfurada (página 2).

## OS QUATRO WAGO DA PARTE DE 220 V

PINO | O QUE É | PLACA PERFURADA | PROTOBOARD | OBSERVAÇÃO
VIN | 5 V da fonte | cima · via A | trilho +
GND | terra comum | cima · C H R B / baixo · C K Z | trilho | um só retorno para LEDs e botões
3V3 | alimentação dos sensores | baixo · A R W M | trilho de 3,3 V
D4 | botão verde | ajuste e + | cima · via Z | linha b ou i
D13 | botão do buzzer | silencia e trava a ventoinha | cima · via U | linha b ou i | segurar 3 s liga/desliga o alarme
D33 | botão vermelho | troca o visor e | cima · via W | linha b ou i
D25 | buzina | cima · via F | linha b ou i
D18 | display TM1637 | CLK | baixo · via F | linha b ou i
D35 | sensor de chama | DO | baixo · via U | linha b ou i | só entrada, sem pull-up interno
D16 | relé da ventoinha | soldado direto (sem via livre) | linha b ou i | 1 k + BC547 · serigrafia RX2
WAGO | O QUE SE JUNTA DENTRO DELE | OBSERVAÇÃO
E1 | fio 1 da tomada · entrada do fusível 1 · 1/L1 do contator | o motor sai daqui, antes do fusível
E2 | fio 2 da tomada · entrada do fusível 2 · 3/L2 do contator | o motor sai daqui, antes do fusível
P1 | saída do fusível 1 · fonte 220 V · COM do relé | protegido por 2 A
P2 | saída do fusível 2 · fonte 220 V · A2 da bobina | protegido por 2 A

A REGRA DA VENTOINHA, NO FIRMWARE

Liga 2 °F abaixo do ajuste e desliga 1 °F acima. Entre duas partidas passam sempre 30 s; parar nunca espera. Para na hora com fogo detectado, com a sonda falhando ou travada no botão

e nesse caso os dois pontos do visor piscam. No boot o GPIO 16 nasce baixo: a ventoinha nunca parte sozinha ao ligar o aparelho.
