Alox01/sentinela-smart/docs/PLANO_POS_TESTES.md

# Plano depois dos testes de campo

> Escrito em 25/07/2026, atualizado em 11/08/2026. App e servidor no ar, e o
> firmware **1.0 gravado** no aparelho. A ordem abaixo pressupõe que os testes de
> campo aconteçam primeiro — vários itens só fazem sentido depois deles.
>
> **A matriz de evidências está logo abaixo** e é o que vira a seção de
> resultados do TCC. O resto deste documento é o histórico de como se chegou até
> ela.

## Matriz de evidências

A distinção que organiza tudo: **implementado** não é **validado**. Código
funcionando e teste automatizado provam qualidade técnica; a seção de resultados
precisa de uso real, com data, resultado e limitação declarada.

Preencher conforme testar. O que estiver em branco fica em branco — resultado
ausente declarado vale mais que resultado inventado.

> **Fechada em 16/10/2026.** Os sete itens foram testados em campo entre 25/07 e
> 15/09/2026. O relato hora a hora de cada rodada, com o que cada imagem prova,
> está em `RETOMADA_TCC.md`; aqui fica o resultado em uma linha, que é o que a
> seção de resultados precisa.

| # | O que provar | Data | Resultado | Limitação declarada |
|---|---|---|---|---|
| 1 | **Operação local com a internet desligada** — comandar e ler com o roteador sem link | 14/09/2026 | **Aprovado.** Roteador desligado: o aparelho seguiu lendo e controlando sozinho (58 °F / 73–74 % no Serial, com o motivo da queda registrado) e voltou à rede sozinho ao religar; o app reconectou sem intervenção | A prova é o Serial e os prints, não captura automatizada. O aparelho não mede tensão da rede elétrica: para ele, "sem internet" e "sem energia" só se distinguem pela ausência de leituras |
| 2 | **Comandos acumulados e sincronização** — dar ordens offline e ver a fila esvaziar ao reconectar | 14/09/2026 11:00–11:04 | **Aprovado.** Ajuste 66 → 60 pela rede local em 32 s; celular sem Wi-Fi e sem dados, ajuste 70 pedido offline (selo `OFFLINE \| 1`, pendência nomeada); ao religar, a fila esvaziou e o visor mostrou **70** às 11:04:12 | Descoberto no mesmo teste (D8): ao voltar para LOCAL a tela mostrava o ajuste antigo por alguns segundos, sem avisar que havia comando a caminho. **Corrigido no mesmo dia e refeito com o APK novo: aprovado** |
| 3 | **Acesso remoto** — comandar de fora da propriedade, pela nuvem | 13–15/09/2026 | **Aprovado.** Celular só em dados móveis, fora da rede do aparelho: selo **NUVEM**, "Reportando (via nuvem)", e comandos aplicados pela nuvem (60 → 70 °F e 70 → 60 %), confirmados no visor e no banco | O servidor é de plano gratuito e hiberna: a primeira chamada depois do ócio leva segundos. Mitigado pelo `keep_alive` e pelos prazos de conexão, não eliminado |
| 4 | **Pareamento e revogação com dois celulares** | 05/08 e 13–14/09/2026 | **Aprovado.** O segundo celular ganhou acesso pelo QR, perdeu na revogação e recuperou com QR novo; o principal nunca perdeu | Atraso de alguns segundos até o segundo celular aceitar comando; causa não determinada entre duas hipóteses (ver seção da revogação) |
| 5 | **Alertas com o app aberto e fechado** | 25/07, 13/08 e 13–14/09/2026 | **Aprovado.** Em 13/08 achou-se em campo um aviso que não saía: estufa desligada à noite, religada fria de manhã, nenhuma notificação. Corrigido e **reverificado no aparelho** (desligar → "sem comunicação" → religar → "temperatura fora da faixa") | O aviso sai **na borda**, uma vez por episódio; ficar horas fora da faixa não repete. Canais do Android congelam na criação: mudar som exige incrementar o sufixo do id |
| 6 | **Uma estufada completa** — relatório, eventos, gráfico, PDF e CSV de uma cura inteira | 14/09/2026 | **Aprovado.** Estufada #22 encerrada, **39 h 39 min** (12/09 22:30 → 14/09 14:09): CSV com as **265 leituras**, PDF com uma por hora, **4 alarmes** — um deles com o app fechado e a sirene desligada —, eventos de ajuste de todas as origens e valores finais corretos | O registro local só acontece com a tela de monitoramento aberta; os trechos com o app fechado vêm da nuvem, que grava 6 por hora. Um defeito achado aqui (D11): eventos de dias diferentes apareciam só com a hora, e a lista parecia fora de ordem. **Corrigido em 15/10/2026** |
| 7 | **Registro de cada teste** com data, resultado, prints e limitações | 14, 15/09 e 16/10/2026 | **Aprovado.** Dois registros hora a hora, com o que cada imagem prova, em `RETOMADA_TCC.md`: a rodada de comandos (11:00–11:04) e a rodada completa de 15/09 (13:05–13:18 e 20:12–20:14), esta última incluindo alerta de chama, pushes de "sem comunicação" e de retorno. Em 16/10, com o aparelho já instalado na parede da estufa, uma rodada de imagens em campo: visor e app com o mesmo número no mesmo quadro, LOCAL, NUVEM em 4G fora da rede, OFFLINE declarado e alerta de chama com fogo real | As imagens ficam com o produtor e **não** no repositório, que é público. Nesta rodada apareceu o D10 (tela zerada ao abrir sem conexão), **corrigido em 15/10/2026** |

### O que já está provado por partes

Não substitui os sete acima, mas conta como evidência de apoio:

- **Gráfico da estufada** (05/08) — desenhava vazio para estufada encerrada há
  mais de uma hora; corrigido e coberto por 4 testes que contam os pontos.
- **Contagem de alarmes** (11/08) — contava leituras, não episódios; agora bate
  com o que o produtor conta a mão na lista de eventos.
- **Modo de configuração** (04-05/08) — três botões com retorno visual, PIN
  exigido também para gravar, saída pelo botão.
- **Firmware** — compilação real no CI a cada push, core esp32 3.2.0, 86% do
  flash.
- **Aviso que não saía depois do silêncio** (13/08) — o servidor guardava o
  último estado de cada aparelho em memória para avisar só na subida. Quando o
  aparelho ficava horas mudo e voltava **ainda** fora da faixa, ele comparava com
  o que sabia de antes, concluía "já estava assim" e calava. Agora o aviso de
  "sem comunicação" faz o servidor esquecer aquele aparelho — silêncio não deixa
  ninguém sabendo de nada. 5 testes, e verificado no aparelho.
- **Sirene própria para fogo** (13/08) — os canais dividiam o mesmo som, e "vá
  ver a lenha" soava igual a "corra". Os sons passaram a ser agrupados por
  **ação**: sirene para incêndio e >175 °F (*sair*), som antigo para desvio de
  temperatura e sem comunicação (*ir conferir*).
- **Testes automatizados** — 208 no app e 234 no servidor em 15/10/2026. Provam robustez do
  software; **não** provam utilidade da solução, que é o que os sete itens acima
  fazem.

### Como escrever cada um no TCC

Três frases: **o que foi feito**, **o que aconteceu**, **o que ficou de fora**.
A terceira é a que dá credibilidade — resultado sem limitação declarada é o que
a banca cutuca primeiro.

Duas formulações que valem copiar, porque são exatas:

- **iOS:** "previsto e configurado, não validado por falta de hardware Apple".
  Não dizer "compatível porque é Flutter": o app depende de `GoogleService-Info.plist`,
  chave APNs e das permissões de rede local no `Info.plist` — sem estas o iOS
  **bloqueia mDNS**, e a metade edge-first para de existir. O que já foi feito
  está em `IOS.md`.
- **Simulador:** "reproduz o mesmo contrato de comunicação e o comportamento
  lógico do ESP32, não toda a física de uma estufa real".

## Por que testar antes de continuar

Muita coisa foi escrita em poucos dias, e o risco era ter código correto no
papel e não provado. Os testes de **notificação** já foram feitos e acharam dois
bugs que nenhum teste automatizado pegaria — um silencioso (comando parado numa
caixa que o simulador nunca consulta) e um intermitente (a resolução do nome
mDNS estourando o prazo da sonda).

Sobram os que **dependem do aparelho em campo**. O ESP já está com a **1.18.0**,
então nenhum deles espera gravação.

## 1. Testes de campo (só o produtor pode fazer)

| Teste | O que prova | Depende de |
|---|---|---|
| Segurar o botão do buzzer 3 s | liga/desliga a sirene sem celular (2 apitos × 1 longo) | 1.13.0 ✅ |
| Som contínuo no fogo | chama e temperatura de incêndio contínuos; alarme comum intermitente | 1.18.0 ✅ |
| Modo de configuração num celular real | portal cativo e IP fixo, **nunca abertos fora do código** | 1.13.0 ✅ |
| Ponte de leitura | energia sim, internet da propriedade não, celular no 4G → **sem** falso "sem comunicação" | APK |
| Cadastrar / atualizar estufa | os fluxos novos de provisionamento | APK |

### Acrescentados em 04/08/2026 — **liberados**, o firmware foi gravado

O aparelho foi regravado em 04/08 e está com a 1.0. Antes de qualquer um destes,
confirme em "Detalhes da conexão" que o app mostra **Firmware 1.0**: se disser
1.24.0, é o firmware velho e o teste mede a coisa errada.

| Teste | O que prova | Como saber que falhou |
|---|---|---|
| Segurar os 3 botões | os LEDs acendem **enquanto conta** e o apito só vem ao entrar; a contagem aguenta o dedo escorregando | LED não acende, ou a contagem parece loteria como antes |
| Entrar em configuração logo depois de uma leitura | a nuvem espera enquanto os 3 botões estão na mão | segurar 3 s não faz nada, aleatoriamente |
| Configurar numa rede **sem senha** | `semsenha=1` grava senha vazia de propósito | o aparelho não conecta e não diz por quê |
| Salvar pelo app numa rede com senha | senha vazia continua mantendo a atual | o aparelho some da nuvem depois de salvar |

E, sem depender de gravação:

| Teste | O que prova |
|---|---|
| Abrir o relatório de uma estufada **encerrada há mais de uma hora** | o gráfico desenha linha e pontos (era o caso que abria vazio) |
| Abrir "Relatórios" logo depois do monitoramento | entra sem o giro de carregamento |
| Compartilhar acesso por QR num segundo celular | o único caminho que sobrou; sem convite escrito não há reserva |

### Revogação de acesso — **testada e aprovada** (05/08/2026)

Feita com dois celulares e o aparelho real, na rede local. O ciclo inteiro:

1. QR Code compartilhado, estufa cadastrada no segundo celular, **comando
   confirmado** — sem esta etapa uma recusa depois não provaria nada;
2. revogação pelo celular principal ("Tirar acesso dos outros celulares");
3. **o segundo celular passou a ser recusado** — é este passo que prova;
4. QR Code novo compartilhado, **o segundo celular voltou a comandar**;
5. o celular principal **nunca perdeu o acesso**.

**Ressalva medida: há um atraso de alguns segundos.** Depois de o segundo celular
atualizar a estufa pelo QR Code novo, o primeiro comando ainda deu "Chave
inválida"; sair da estufa e entrar de novo resolveu. Duas causas plausíveis, e
não foi determinado qual das duas (ou as duas):

- o app entrega a chave **por cópia** — lista, cartão e monitor seguram valores
  em memória, e há uma janela entre gravar no banco e todos pegarem o novo. É a
  mesma família do defeito corrigido horas antes, em outro caminho (ver
  `AUDITORIA.md`, item D1);
- o nome `.local` ainda não resolvia no segundo celular, então o comando foi pela
  nuvem e caiu na janela de consistência eventual descrita em
  `SEGURANCA_COMANDOS.md`.

Nos dois casos **se resolve sozinho**, e o contorno é natural (sair e entrar).
Registrado como está: um resultado com ressalva medida vale mais que um resultado
redondo que esconde o que aconteceu.

### O caminho até aqui (o que os testes acharam em 05/08)

Vale para a seção de resultados: a revogação **não funcionou de primeira**, e as
quatro tentativas frustradas acharam quatro defeitos diferentes — firmware antigo
sem a rota que devolve a chave, sonda de alcance engolindo a chave nova, mDNS não
resolvendo e mandando tudo para a nuvem, e por fim a lista da home segurando a
chave velha. Nenhum deles apareceu como erro: todos se manifestaram como a mesma
frase, "Chave inválida", apontando para a causa errada.

### Desembaraçar as três estufas (29/07/2026) — **primeiro de todos**

As três estufas cadastradas ficaram apontadas para o **mesmo aparelho** (o ESP
real), então os três cartões espelhavam o mesmo display. Causa em
`HANDOFF.md`: o app aprendia o `idHardware` de quem atendesse no endereço e
sobrescrevia o que já sabia, e endereços repetidos fizeram três estufas virarem
uma. Enquanto isso não for desfeito **à mão**, nada mais medido na lista de
estufas significa coisa alguma.

| Estufa | Endereço | ID do aparelho |
|---|---|---|
| Esp32-1 (real) | nome mDNS dele | `ESP32_215788` |
| Esp32-2 (do primo) | o do aparelho **dele** | vazio — aprende ao conectar lá |
| Estufa L (simulador) | qualquer um, diferente dos outros | `ESP32_REALISTIC_V2` |

O simulador **precisa** do id digitado: não existe aparelho na rede para ser
descoberto. Foi o que fez o cartão dele dizer OFFLINE depois de trocar o
endereço — e o motivo de a mensagem virar "SEM ID".

Depois de arrumar, o que provar: **cada cartão com números próprios**, e o
Esp32-1 parando de piscar entre LOCAL e NUVEM (a histerese de duas falhas).

| Teste | O que prova |
|---|---|
| Salvar duas estufas no mesmo endereço | é **recusado**, com explicação |
| Cartão sem id | diz **SEM ID**, não OFFLINE |
| Detalhes da conexão | mostram a versão do firmware e o id do aparelho |

**O que anotar em cada um:** o que aconteceu, quanto tempo levou e se o app
estava aberto ou fechado. Esses números viram a seção de resultados do TCC — e,
se algo falhar, são eles que dizem se o problema é canal, permissão ou
preferência.

### Resultados já obtidos (25/07/2026)

| Teste | Resultado |
|---|---|
| Lembrete de agendamento (simulador) | ✅ chegou na hora marcada |
| Agendamento aplicar o ajuste (simulador) | ❌ **falhava** — o agendador jogava na caixa que só aparelho real consulta. Corrigido e coberto por teste. |
| Silêncio de 10 min durante fogo (1.15.0, campo) | ✅ cala — mas achou o furo abaixo |
| Fogo **começando** dentro dos 10 min silenciados | ❌ **não tocava nada**. O silêncio cobria fogo de que o produtor nunca ficou ciente. Corrigido na 1.16.0 e ✅ **confirmado em campo**. |
| Nome da estufa no push | ✅ chegou "Esp32-2 · …", teste e alarme real |
| Versão do firmware pela nuvem | ✅ 1.17.0 confirmada de fora, sem terminal na rede local |
| **Queda de energia** (29/07/2026) | ✅ passou inteiro: o "sem comunicação" chegou no prazo, o ajuste **voltou do NVS** (não nos valores padrão) e o aviso de retorno chegou ao religar |
| Chave própria registrada na nuvem (TOFU, 1.18.0) | ✅ o aparelho registrou sozinho, no ciclo de comandos, sem intervenção |
| Desembaraçar as três estufas | ✅ feito à mão pelo produtor |
| Alarme com "Não perturbe" ligado | ✅ **toca** — a permissão de furar o DND funciona |
| Alarme no modo silencioso | ❌ não toca (limitação do Android, ver `NOTIFICACOES_PUSH.md`) |
| Alarme no modo vibrar | vibra, não toca |
| Conexão local pelo nome mDNS | ⚠️ caía na nuvem por alguns segundos, de forma **intermitente**. Causa: a resolução do nome estourava o timeout de 2 s da sonda. Corrigido (4 s só para nomes). |
| "Temperatura muito elevada" (leitura falsa via `POST /leitura`) | ✅ chegou como alarme, com título próprio, separado do incêndio |
| O mesmo aviso com "Tocar" **desligado** | ✅ chegou como notificação comum — o interruptor faz o que promete |
| Sirene parando ao abrir o app | ✅ depois de trocar a seleção de canais por `cancelAll()` |

**Como testar sem o aparelho:** `POST /leitura` com um `idHardware` real e
`riscoIncendio: true` (ou `perigoChama: true`) dispara o alerta com o ESP
desligado — o servidor lê o estado direto do corpo. Como o aviso sai na **borda
de subida**, mande uma leitura normal entre um teste e outro. Isso vira leitura
de verdade: o app mostra o valor e ele pode entrar no histórico da estufada.

> **Não dá para testar push pelo simulador:** `avaliarAlertas` o ignora de
> propósito, para o aparelho de demonstração não disparar alarme.

### Os testes de notificação estão concluídos (25/07/2026)

Sobraram apenas os que dependem do aparelho em campo: modo de configuração num
celular real, queda de energia, hold de 3 s e a ponte de leitura.

## 2. Correções do que os testes acharem

Deixado em branco de propósito. É a razão de os itens abaixo não estarem
agendados: qualquer falha em campo tem prioridade sobre funcionalidade nova.

Dois pontos já conhecidos, que os testes podem confirmar ou derrubar:

- **Acomodação de 5 min pode ser curta** para fornalha lenta: se o alarme de
  temperatura baixa disparar sempre depois de um ajuste para cima, o valor
  precisa subir (`TEMPO_ACOMODACAO_MS`).
- **Os alarmes usam a mesma sirene.** Confirmado em teste e **decidido**: cada
  aviso ganha o seu som, o atual fica com o desvio de temperatura. Aguardando os
  áudios do produtor. Requisitos dos arquivos e a pegadinha do canal congelado
  em `NOTIFICACOES_PUSH.md`.

## 3. Decisão do limiar de incêndio — **fechada** (29/07/2026)

**Fica em 175 °F.** O produtor mediu o que faltava: atiçar a fornalha passa do
ajuste em **não mais de 2 °F**, e só passa disso com clima muito quente, ajuste
em 160 °F e fumo quase seco. Com 160 + 2, sobram 13 °F até o limite — o alarme
falso que a inferência previa não acontece. Velocidade de subida e "sustentado
por N minutos" foram descartados antes, também por evidência dele. Detalhes e o
raciocínio em `AMBIENTE_ESTUFA.md` §3.

## 4. Provisionamento, Parte 1 — **feito** (25/07/2026)

A tela de sucesso da configuração leva endereço e chave de volta ao formulário
de cadastro, em vez de o produtor decorar um nome como
`sentinela-215788.local`. E, quando aberta pelo menu de uma estufa já cadastrada,
oferece **atualizar** — sem isso, trocar a chave no aparelho deixava a do app
velha e os comandos passavam a ser recusados sem explicação.

Falta só testar em campo.

## 5. Escrita do TCC

O prazo que o produtor definiu era começar por volta de 08/08/2026. Os quatro
objetivos específicos estão implementados; o que falta para a escrita são os
**números dos testes** do item 1.

## Fora deste plano (trabalho futuro declarado)

- **Provisionamento Parte 2** — chave gerada pelo aparelho, TOFU. Muda o servidor
  de chave global para chave por aparelho: grande, e não bloqueia o TCC.
- **Curva de cura por fases** — ver `AGENDAMENTO_CURA.md`.
- MQTT, HTTPS no ESP, atuadores/relé, APK assinado para a Play Store.
