Alox01/sentinela-smart/pcb/sentinela/esquematico.pdf

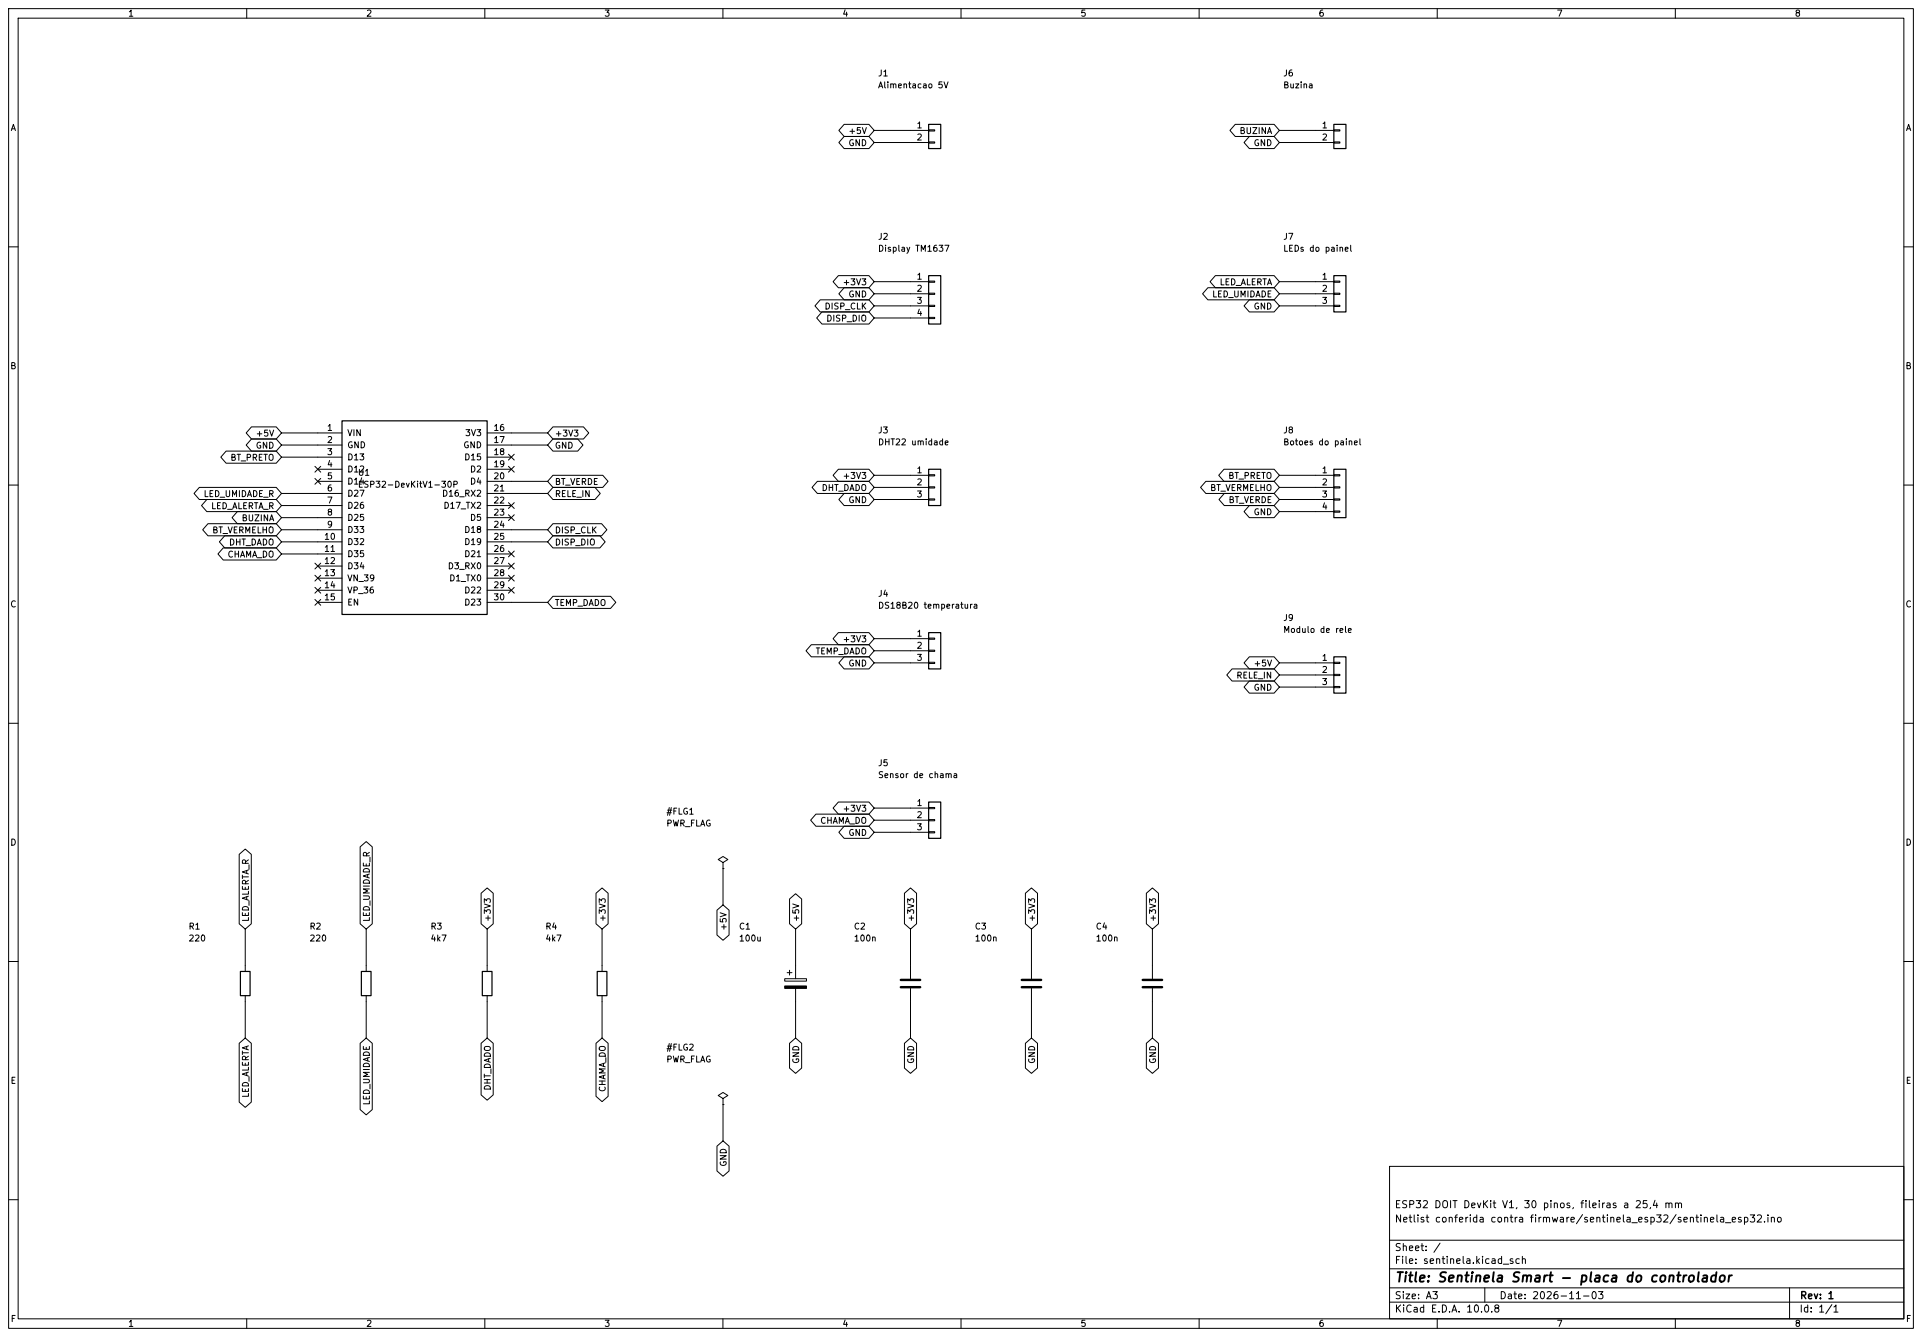
[picture p13: page 1]

ESP32 DOIT DevKit V1, 30 pinos, fileiras a 25,4 mm
Netlist conferida contra firmware/sentinela_esp32/sentinela_esp32.ino

Sheet: /
File: sentinela.kicad_sch
Title: Sentinela Smart - placa do controlador

Size: A3 | Rev: 1 | F Date: 2026-11-03
KiCad E.D.A. 10.0.8 | Id: 1/1
