Alox01/sentinela-smart/pcb/sentinela/sentinela.kicad_sch

## KiCad design pcb/sentinela/sentinela.kicad_sch (2026-11-03)

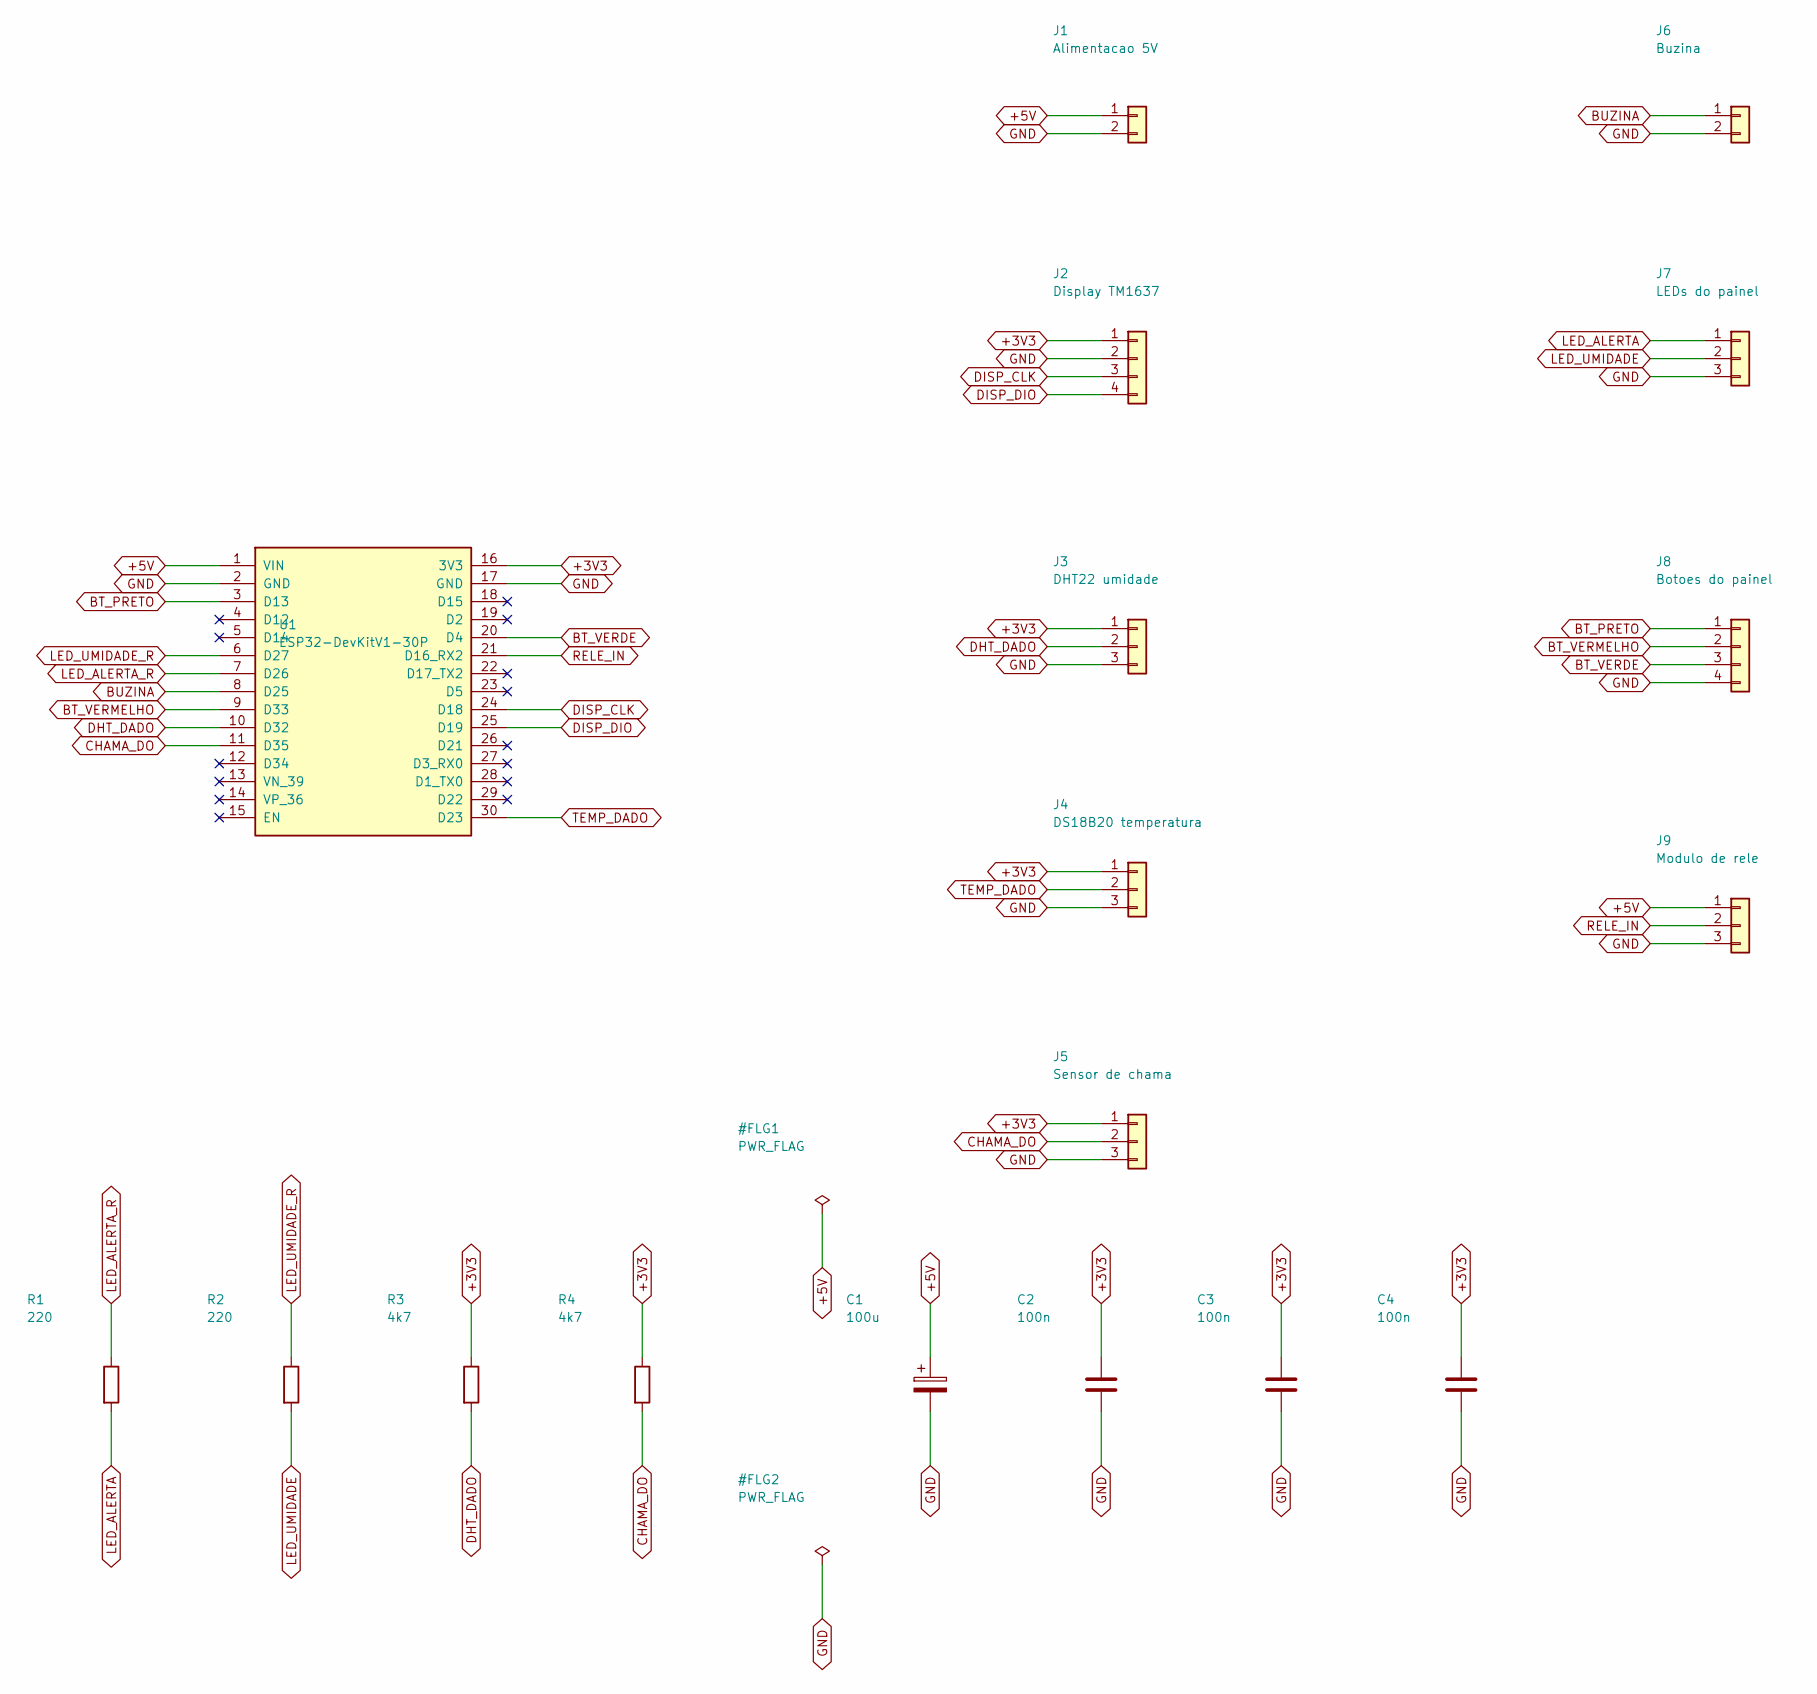
[picture p14: schematic sentinela.kicad_sch]

Parts:
C1: 100u; CP_Radial_D6.3mm_P2.50mm
C2, C3, C4: 100n; C_Disc_D5.0mm_W2.5mm_P5.00mm
J1: Alimentacao 5V; PhoenixContact_MSTBA_2,5_2-G-5,08_1x02_P5.08mm_Horizontal
J2: Display TM1637; PhoenixContact_MSTBA_2,5_4-G-5,08_1x04_P5.08mm_Horizontal
J3: DHT22 umidade; PhoenixContact_MSTBA_2,5_3-G-5,08_1x03_P5.08mm_Horizontal
J4: DS18B20 temperatura; PhoenixContact_MSTBA_2,5_3-G-5,08_1x03_P5.08mm_Horizontal
J5: Sensor de chama; PhoenixContact_MSTBA_2,5_3-G-5,08_1x03_P5.08mm_Horizontal
J6: Buzina; PhoenixContact_MSTBA_2,5_2-G-5,08_1x02_P5.08mm_Horizontal
J7: LEDs do painel; PhoenixContact_MSTBA_2,5_3-G-5,08_1x03_P5.08mm_Horizontal
J8: Botoes do painel; PhoenixContact_MSTBA_2,5_4-G-5,08_1x04_P5.08mm_Horizontal
J9: Modulo de rele; PhoenixContact_MSTBA_2,5_3-G-5,08_1x03_P5.08mm_Horizontal
R1, R2: 220; R_Axial_DIN0207_L6.3mm_D2.5mm_P10.16mm_Horizontal
R3, R4: 4k7; R_Axial_DIN0207_L6.3mm_D2.5mm_P10.16mm_Horizontal
U1: ESP32-DevKitV1-30P

Connections:
+3V3: C2.1, C3.1, C4.1, J2.1, J3.1, J4.1, J5.1, R3.1, R4.1, U1.16 (3V3)
+5V: C1.1, J1.1, J9.1, U1.1 (VIN)
BT_PRETO: J8.1, U1.3 (D13)
BT_VERDE: J8.3, U1.20 (D4)
BT_VERMELHO: J8.2, U1.9 (D33)
BUZINA: J6.1, U1.8 (D25)
CHAMA_DO: J5.2, R4.2, U1.11 (D35)
DHT_DADO: J3.2, R3.2, U1.10 (D32)
DISP_CLK: J2.3, U1.24 (D18)
DISP_DIO: J2.4, U1.25 (D19)
GND: C1.2, C2.2, C3.2, C4.2, J1.2, J2.2, J3.3, J4.3, J5.3, J6.2, J7.3, J8.4, J9.3, U1.2 (GND), U1.17 (GND)
LED_ALERTA: J7.1, R1.2
LED_ALERTA_R: R1.1, U1.7 (D26)
LED_UMIDADE: J7.2, R2.2
LED_UMIDADE_R: R2.1, U1.6 (D27)
RELE_IN: J9.2, U1.21 (D16_RX2)
TEMP_DADO: J4.2, U1.30 (D23)
