Alox01/sentinela-smart/firmware/sentinela_esp32/sentinela_esp32.ino

/*
  Sentinela Smart - firmware do ESP32 (controlador local + camada de rede)

  Baseado no controlador standalone (DHT22, botoes, display, LEDs, buzzer),
  mantendo toda a logica local intacta - ela continua funcionando mesmo sem
  Wi-Fi (edge-first). Acrescenta por cima uma camada de rede que fala o contrato
  do app (docs/CONTRATO_API.md):

    GET  /status        -> estado completo (status + config)
    GET  /  e  /dados   -> formato simples compativel com o app
    POST /sincronizar   -> ajustes com token e Last-Write-Wins por campo

  Dependencias (Arduino Library Manager):
    - DHT sensor library (Adafruit)
    - TM1637Display (Avishay Orpaz)
    - ArduinoJson v7+ (Benoit Blanchon)
  Placa: ESP32 (framework Arduino).

  ATENCAO:
    1. WIFI_SSID e WIFI_PASS abaixo sao apenas o valor DE FABRICA, usado ate
       alguem configurar o aparelho.
    2. Depois de gravado, da para trocar de rede sem computador: segure o VERDE
       e o VERMELHO juntos por 3 s, conecte na rede "Sentinela-Config" e abra o
       app (ou o navegador). O que for salvo ali fica na NVS e tem precedencia.
    3. NAO ha o que preencher em DEVICE_TOKEN. O aparelho gera a propria chave
       no primeiro boot e o app a le dele, com o PIN do visor. Ninguem digita
       chave em lugar nenhum.
*/

#include <WiFi.h>
#include <ESPmDNS.h>
#include <WebServer.h>
#include <DNSServer.h>
#include <esp_netif.h>
#include <HTTPClient.h>
#include <WiFiClientSecure.h>
#include <time.h>
#include <esp_system.h>
#include <Update.h>
#include <DHT.h>
#include <OneWire.h>
#include <DallasTemperature.h>
#include <TM1637Display.h>
#include <ArduinoJson.h>
#include <Preferences.h>

// ===================== CONFIG (preencher) =====================
const char* WIFI_SSID       = "SUA_REDE_WIFI";
const char* WIFI_PASS       = "SUA_SENHA_WIFI";
// Deixe como esta. Ate a 1.19.0 esta constante tinha de casar com um campo
// "Chave de acesso" no app; desde a 1.20.0 o aparelho gera a propria chave no
// primeiro boot e o app a le por `/config/identidade`, e na v1.25.0 o campo
// saiu do app de vez. O valor abaixo e reconhecido como "de fabrica" no setup e
// substituido por uma chave aleatoria - preenche-lo a mao so serve para gravar
// varios aparelhos com a MESMA chave, que e o contrario do que se quer.
// Vazio libera comandos sem token, e so faz sentido em bancada.
const char* DEVICE_TOKEN    = "COLE_AQUI_O_MESMO_TOKEN_DO_APP";
// O id do aparelho e gerado do chip (MAC) no setup -> unico por ESP, sem
// precisar configurar nada. Cada aparelho vira o seu na nuvem (status por
// aparelho). Ex.: "ESP32_A1B2C3".
// Reiniciado em 1.0 em 04/08/2026, por decisao do produtor: a numeracao anterior
// ia ate 1.26.0 e era de bancada, contando cada experimento. A de agora e a do
// produto, e comeca quando o aparelho esta pronto para ser usado de verdade.
//
// NAO INCREMENTAR SOZINHO. O produtor avisa quando a versao muda - o numero
// passou a significar "o que esta na mao de alguem", e nao "o que mudou no
// codigo", que e o que o git ja conta. O historico antigo, com o motivo medido
// em campo de cada mudanca, esta em docs/HISTORICO_FIRMWARE.md.
//
// Continua sendo o unico jeito de saber, pelo /status, o que um aparelho em
// campo esta rodando - por isso ele existe e aparece no app.
const char* VERSAO_FIRMWARE = "1.0";
// URL da nuvem: para onde o aparelho empurra as leituras (historico + acesso
// remoto) e de onde ele busca os ajustes feitos pelo app quando o celular esta
// longe da propriedade. Deixe "" para operar so na rede local.
const char* CLOUD_URL = "https://estufa-server.onrender.com";
const unsigned long PUSH_INTERVAL_MS = 60000;  // envia uma leitura a cada 1 min
// Mais frequente que o push: e o tempo que o produtor espera entre mexer no app
// de longe e a estufa obedecer. Nao diminua muito: cada busca e um handshake
// HTTPS que segura o loop por 1-2 s, tempo que falta ao controle local.
const unsigned long COMANDOS_INTERVAL_MS = 20000;

// Prazos de toda conversa com a nuvem. Sem eles, o aperto de mao TLS herdava o
// padrao da biblioteca - 120 s - e o laco inteiro ficava parado esse tempo com o
// servidor gratuito acordando: sem ler botao, sem atualizar o visor, sem
// atender o app pela rede local. Numa emergencia seria pior: a sirene tocando e
// o botao de silencio morto por dois minutos.
//
// Estourar o prazo nao perde nada. O envio e a busca se repetem no proximo
// ciclo, e a propria tentativa ja acorda o servidor - a seguinte encontra ele de
// pe. O aparelho segue decidindo sozinho enquanto isso; e o ponto do edge-first.
const unsigned long TIMEOUT_HANDSHAKE_S = 4;     // em SEGUNDOS: e a unidade da biblioteca
const unsigned long TIMEOUT_CONEXAO_MS = 3000;
const unsigned long TIMEOUT_RESPOSTA_MS = 3000;

// Quanto um alerta pode esperar o produtor terminar de ajustar. Nao e o tempo
// normal de espera - esse e o proprio fim do ajuste, 5 s depois do ultimo
// toque. E o teto para quando o ajuste nao termina: um botao preso ou em curto
// seguraria o modo de ajuste aberto para sempre, e com ele o aviso de fogo.
const unsigned long ESPERA_MAX_ALERTA_NO_AJUSTE_MS = 30000;
unsigned long alertaRetidoDesdeMs = 0;
// =============================================================

// ---- Pinos (mapa de referencia) ----
#define DHTPIN 32
#define DHTTYPE DHT22
DHT dht(DHTPIN, DHTTYPE);

// A temperatura vem do DS18B20, nao do DHT22. A sonda dele e selada e fica
// dentro da estufa, no meio do fumo; o DHT22 mede a umidade em outro ponto.
// Ler as duas no mesmo sensor seria descrever um lugar so e chamar de dois.
#define SENSOR_TEMP 23
OneWire barramentoTemp(SENSOR_TEMP);
DallasTemperature sensorTemp(&barramentoTemp);

#define SENSOR_LUZ 35
const bool SENSOR_LUZ_ATIVO_LOW = true;

#define BOTAO_BUZZER 13
#define BOTAO_VERDE 4
#define BOTAO_VERMELHO 33

#define LED_ALERTA 26
#define LED_UMIDADE 27
#define LED_CONTROLE_TEMP 14
#define BUZZER 25

// Saida da ventoinha da fornalha. O GPIO nao fala com o rele direto: 3,3 V nao
// apagam o optoacoplador do modulo, que e alimentado em 5 V e dispara em nivel
// baixo - o rele ficava colado para sempre. Entre os dois ha um NPN (BC547) com
// 1 k na base, que inverte o sinal: GPIO em HIGH satura o transistor, puxa o IN
// do modulo para o GND e fecha o contato. Por isso HIGH = ventoinha ligada.
// O 16 nao e pino de boot nem de flash, e no reset ele nasce baixo: a ventoinha
// nunca parte sozinha.
#define RELE_VENTOINHA 16

// O prazo minimo de 30 s entre partidas SAIU em 21/10/2026, a pedido do
// produtor. A justificativa dele: a histerese ja faz a ventoinha demorar para
// ligar, porque a temperatura da estufa leva minutos para atravessar a faixa de
// 3 F entre entrar e sair - entao o prazo nao somava protecao, so atrasava o
// que o produtor acabara de mandar pelo botao.
//
// O que ele protegia era o caso de a temperatura ficar parada na fronteira.
// Fica registrado para quem vier: se o contator comecar a bater seguido, e aqui
// que se volta - e a volta e mais barata que a espera, porque um prazo curto
// (uns 5 s) ja cortaria a batida sem o atraso que incomodava.
// Quanto a temperatura precisa afastar do ajuste para a ventoinha entrar e para
// ela sair. Ver atualizarEstadoTemperatura() para o porque de serem diferentes.
const int VENTOINHA_LIGA_ABAIXO_F = 2;
const int VENTOINHA_DESLIGA_ACIMA_F = 1;

// Teto do que se pode PEDIR. Vale para os botoes do aparelho e para o que
// chega da nuvem, porque os dois passam por definirTemperaturaAlvo().
const int ALVO_MAXIMO_F = 165;

// Piso do que se pode PEDIR. Existe pelo mesmo motivo do teto, e por um defeito
// que custou 14 horas de historico em 21/10/2026: os botoes levaram o ajuste a
// 55 F, o servidor recusava abaixo de 60 e o aplicativo tambem nao oferecia
// menos. So o aparelho ficou de fora, e um ajuste que ele aceitava a nuvem
// recusava.
//
// O piso virou 50 F em 21/10/2026, por decisao do produtor, e foi movido nos
// TRES lugares de uma vez - aqui, em `ajusteTemperaturaMinimoF` no aplicativo e
// em `LIMITE_TEMPERATURA_MIN` no servidor (`sync.js` e `agendamentos.js`).
// Mover em dois e esquecer o terceiro e exatamente o defeito que esta linha
// existe para impedir.
//
// O estrago nao foi um comando recusado - foi TODA a telemetria parar. O envio
// de leitura leva a configuracao vigente junto, entao o servidor devolvia 400 e
// descartava a leitura inteira, a cada minuto, em silencio. Do lado de fora
// parecia falta de internet, e o aparelho estava com a rede perfeita
// (`segundosSemRede: 0`).
const int ALVO_MINIMO_F = 50;

// Teto do que se pode SUPORTAR. Acima disto a ventoinha nao liga e, se
// estiver girando, para na hora - sem consultar a histerese, o prazo minimo
// nem a trava do botao.
//
// Existe como rede de baixo de propositao: a decisao normal de ligar vem de
// ledControleLigado, calculado la em atualizarEstadoTemperatura(). Se um dia
// um defeito de codigo deixar essa variavel ligada com a estufa a 170 F, a
// ventoinha continuaria soprando ar na fornalha - que e exatamente o que
// transforma temperatura alta em incendio. Esta trava le a temperatura e
// decide sozinha, sem depender de nenhuma outra conta estar certa.
const int TEMPERATURA_LIMITE_VENTOINHA_F = 165;
bool ventoinhaLigada = false;
unsigned long ultimaTrocaVentoinhaMs = 0;

// Ventoinha travada desligada pelo botao do buzzer. Serve para o produtor parar
// so a ventoinha enquanto poe lenha ou mexe na fornalha, sem desligar o
// aparelho. E so isso: travar e destravar. NAO existe "ligada na mao" - apertar
// de novo devolve o comando ao ajuste, e e ele que decide se ela gira agora.
// Nao sobrevive a um reinicio: religar o aparelho destrava.
bool ventoinhaBloqueada = false;

// A trava se solta sozinha depois deste prazo, e o motivo e esquecimento.
// Travada e esquecida, a ventoinha nunca mais gira: a estufa esfria, a fase
// atrasa e a estufada se perde - e o unico aviso sao os dois pontos piscando
// no visor, que ninguem ve de longe nem de noite. Esquecer e barato de
// acontecer e caro de descobrir, entao o prazo existe como rede.
//
// Soltar a trava NAO liga a ventoinha: devolve o comando ao ajuste, que decide
// pela temperatura, como se o produtor tivesse apertado o botao de novo. Se a
// estufa estiver quente, ela segue parada.
const unsigned long TEMPO_MAXIMO_TRAVA_VENTOINHA_MS = 5UL * 60 * 1000;

// Espera minima entre PARTIDAS do contator. So para ligar: desligar e
// instantaneo, sempre, porque desligar e o lado da seguranca.
//
// Voltou em 25/10/2026, depois de o produtor travar o aparelho em campo. O
// prazo de 30 s que existia aqui saiu em 21/10 a pedido dele, e o historico do
// firmware registrou o risco: "se o contator comecar a bater seguido, e aqui
// que se volta, e um prazo curto de uns 5 s cortaria a batida sem o atraso".
// O caso previsto era a temperatura parada na fronteira da histerese. O que
// aconteceu foi mais direto: dois toques no botao preto em poucos segundos
// invertem a trava duas vezes, abrindo e fechando o contator - duas partidas
// de um motor de 1 a 3 CV a centimetros da placa. O transitorio travava o
// ESP32, e so saia tirando da tomada.
//
// Cinco segundos, e nao trinta: o que incomodava era atrasar o que o produtor
// acabara de mandar. Cinco nao se percebe no uso e nao deixa a batida nascer.
const unsigned long ESPERA_ENTRE_PARTIDAS_MS = 5000;
// Instante em que a trava foi posta. Zero quer dizer destravada, mesmo idioma
// de ultimaTrocaVentoinhaMs.
unsigned long ventoinhaBloqueadaDesdeMs = 0;

// Os dois pontos do visor piscam enquanto ela esta travada. E o unico aviso de
// que ela nao vai ligar sozinha - sem ele, a estufa esfriaria e todo mundo
// acharia que o aparelho quebrou.
const unsigned long INTERVALO_PISCA_PONTOS_MS = 600;
unsigned long ultimoPiscaPontos = 0;
bool pontosAcesos = false;

#define DISPLAY_CLK 18
#define DISPLAY_DIO 19
TM1637Display display(DISPLAY_CLK, DISPLAY_DIO);

WebServer server(80);

// ---- Estado local (do controlador original) ----
bool ultimoBuzzer = HIGH;
bool ultimoVerde = HIGH;
bool ultimoVermelho = HIGH;

bool estavelBuzzer = HIGH;
bool estavelVerde = HIGH;
bool estavelVermelho = HIGH;

unsigned long debounceBuzzer = 0;
unsigned long debounceVerde = 0;
unsigned long debounceVermelho = 0;

const unsigned long debounceDelay = 80;

unsigned long ultimoTempoLeitura = 0;
unsigned long tempoInicioUmidade = 0;
unsigned long ultimoTempoAjuste = 0;
unsigned long ultimoPiscaAjuste = 0;
unsigned long ultimoTempoBuzzer = 0;

const unsigned long intervaloLeitura = 2500;
const unsigned long tempoMostrarUmidade = 10000;
const unsigned long tempoSairAjuste = 5000;

// Segurar repete. O app usa 200 ms no BotaoContinuo, e aqui os mesmos 200 ms
// pareciam depressa demais - o motivo e o visor: ele pisca a cada
// intervaloPiscaAjuste (400 ms), entao a 200 ms o numero mudava duas vezes por
// lampejo e outras duas com o visor apagado. O produtor via saltos de quatro em
// quatro, sem enxergar onde parar. No celular o numero fica aceso e o mesmo
// ritmo se le com calma.
//
// Casado com o piscar: um valor por lampejo, todos visiveis.
const unsigned long INTERVALO_REPETICAO_MS = 400;
unsigned long ultimaRepeticaoVermelho = 0;
unsigned long ultimaRepeticaoVerde = 0;

// Quanto tempo sem mexer antes de gravar. Antes a gravacao so acontecia ao sair
// do ajuste, 5 s depois do ultimo toque, e um corte de energia nesse intervalo
// levava o ajuste junto.
const unsigned long ESPERA_APOS_ALTERACAO_MS = 1500;
const unsigned long intervaloPiscaAjuste = 400;
const unsigned long intervaloBuzzer = 1000;
const unsigned long duracaoBuzzer = 180;

bool displayAjusteLigado = true;
bool mostrandoUmidade = false;
bool modoAjuste = false;

bool alertaLuz = false;
bool alertaTemperatura = false;
bool buzzerLigadoAgora = false;
bool ledControleLigado = false;

// Silencio com prazo, espelhando TEMPO_SILENCIO do servidor (logica.js): o
// alarme volta sozinho depois de 10 min se a temperatura continuar fora. Guarda
// o instante-limite em millis() (nao no relogio NTP) para funcionar mesmo sem
// hora sincronizada. 0 = nao silenciado.
const unsigned long TEMPO_SILENCIO_MS = 10UL * 60UL * 1000UL;
unsigned long silencioAteMillis = 0;

// Que fogo ja estava acontecendo quando o silencio comecou. E so esse que o
// silencio cobre: quem aperta o botao esta dizendo "ja sei DESTE fogo", e nao
// "nao me avise de fogo por 10 minutos". As duas causas andam separadas porque
// sao noticias diferentes - a chama pegou no papel, ou a estufa inteira passou
// do limite de fogo.
bool luzCobertaPeloSilencio = false;
bool tempIncendioCobertaPeloSilencio = false;

// Leituras em numeros inteiros: o display tem 4 digitos e as casas decimais do
// DHT22 nao acrescentam nada util para o produtor.
int temperaturaF = 0;
int umidade = 0;

// Dois sensores, duas flags. Perder a umidade nao pode derrubar o alarme de
// temperatura, que e a funcao central do aparelho - e antes, com um sensor so,
// derrubava.
// Conversao do DS18B20 em andamento: pedida em lerSensores(), recolhida em
// colherTemperaturaSePronta(). A 10 bits ela leva ~190 ms; 220 da folga.
const unsigned long ESPERA_CONVERSAO_MS = 220;
unsigned long conversaoPedidaEmMs = 0;
bool conversaoPendente = false;

bool leituraOk = false;
bool umidadeOk = false;

int temperaturaAlvoF = 76;
int margemF = 8;

// Acomodacao apos mudar o alvo: a estufa leva tempo para alcancar o ajuste
// novo, e alarmar nesse caminho seria acusar um problema que o proprio
// produtor causou. A folga acompanha o tamanho da mudanca (mexer 1 grau nao
// pode perdoar um desvio de 20) e vale por um tempo. Espelha a mesma regra do
// app. Incendio NUNCA e afetado: seguranca nao se acomoda.
// 5 min: medido na estufa real, que alcanca um alvo 10-15 F acima em menos que
// isso. Precisa ser igual ao do app e do simulador.
const unsigned long TEMPO_ACOMODACAO_MS = 5UL * 60UL * 1000UL;
const int FOLGA_ACOMODACAO_MAX = 8;
unsigned long acomodacaoAteMillis = 0;
int folgaAcomodacao = 0;

// Ajustes guardados na memoria nao-volatil (NVS): sem isso, uma queda de
// energia devolvia o alvo ao padrao de fabrica no meio de uma estufada - o
// produtor recuperava a luz e a estufa voltava aquecendo para o alvo errado.
// O silencio do alarme NAO e guardado de proposito: apos um reinicio o alarme
// deve voltar a valer.
Preferences prefs;
bool configSuja = false;
uint32_t configRevisao = 0;
unsigned long ultimoSalvamentoConfig = 0;
const unsigned long INTERVALO_SALVAR_CONFIG_MS = 5000;

// ---- Novo: ajuste de umidade e timestamps para o Last-Write-Wins ----
// O hardware nao controla umidade fisicamente (sem umidificador), mas registra
// o ajuste que o app envia para exibir e reportar. Os timestamps sao epoch ms,
// vindos do app; iniciam em 0 para que o primeiro comando sempre venca.
int umidadeAlvo = 90;
long long tempTimestamp = 0;
long long umidTimestamp = 0;
long long modoSilenciosoTimestamp = 0;

// Buzzer do alarme de TEMPERATURA: o produtor pode desliga-lo (ha quem nao
// aguente o bipe durante a estufada). Fogo NUNCA e afetado - o sensor de chama
// e a temperatura de incendio (limiteFogoF()) sempre tocam. So o alarme de temperatura
// comum cala. Persistido em NVS; LWW pelo buzzerTimestamp.
bool buzzerTemperaturaAtivo = true;
long long buzzerTimestamp = 0;

unsigned long ultimaTentativaWifi = 0;
const unsigned long intervaloReconexaoWifi = 15000;

// ---- Recuperacao do radio, sem reiniciar o aparelho ----
//
// Repetir WiFi.begin() recupera queda simples de sinal e NAO recupera radio
// travado: sobre uma pilha que ficou num estado intermediario, begin() nao faz
// nada, e o aparelho fica fora da rede ate alguem tirar da tomada. Depois de
// algumas tentativas sem sucesso, o radio e desmontado e montado de novo.
//
// ESP.restart() nao entra nesta escada, em nenhum degrau. Reiniciar e APAGAR o
// aparelho: o visor morre, a sirene cala e o rele abre enquanto o chip sobe.
// Numa estufa com fogo aceso isso e pior do que ficar sem aplicativo - o
// termostato e o alarme sao locais e seguem funcionando sem rede nenhuma. Se o
// radio nao voltar, o aparelho continua cuidando da estufa; so o app se perde.
const int TENTATIVAS_ATE_REMONTAR_RADIO = 4;
int tentativasWifiSeguidas = 0;
unsigned long wifiCaiuEmMs = 0;
// Remontar e um corte de energia do radio seguido de religar. As duas metades
// ficam em passadas diferentes do laco: dormir entre elas pararia o controle,
// que e justamente o que nao pode parar.
bool radioDesligadoParaRemontar = false;
unsigned long radioDesligadoEmMs = 0;
const unsigned long PAUSA_REMONTAGEM_MS = 300;
// Quantas vezes o radio precisou ser remontado desde que o aparelho foi
// gravado. Fica na memoria permanente porque o diario e so RAM: sem isto, um
// aparelho que se recupera sozinho de madrugada nao deixa rastro nenhum, e
// "parece que esta bom" nao se distingue de "aconteceu tres vezes".
unsigned int remontagensDoRadio = 0;
// O que se faz UMA vez por boot ao entrar na rede (relogio, rede aprendida, IP
// fixo). Antes so acontecia se a PRIMEIRA tentativa desse certo; quando a rede
// so aparecia depois, o relogio nunca era acertado.
bool redePreparada = false;
// Por que a ultima tentativa de Wi-Fi falhou, dito pelo proprio radio. Escrito
// pela tarefa de eventos do Wi-Fi, lido pelo laco e pela pagina de configuracao:
// sem isto, "nao conectou" nao tinha causa nenhuma a mostrar.
volatile uint8_t motivoFalhaWifi = 0;
unsigned long ultimoPushNuvem = 0;
// Ultimo estado de emergencia ja enviado, para detectar a borda e empurrar na
// hora em que algo comeca (ou termina), em vez de esperar o ciclo de 1 min.
bool ultimoFogoEnviado = false;
bool ultimoAlarmeEnviado = false;
unsigned long ultimaBuscaComandos = 0;
unsigned long ultimaTentativaMdns = 0;
String idHardware;  // definido no setup a partir do chip (unico por ESP)
String nomeLocal;   // ex.: sentinela-a1b2c3 -> http://sentinela-a1b2c3.local
bool mdnsAtivo = false;
const unsigned long intervaloTentativaMdns = 15000;

// --- Configuracao de rede em tempo de execucao ---
// Wi-Fi e chave saem da NVS; as constantes do topo viram apenas o valor de
// fabrica, usado enquanto ninguem configurou pelo modo de configuracao. Sem
// isto, trocar de roteador exigiria regravar o firmware com um computador.
String wifiSsid;
String wifiPass;
String tokenAparelho;
// Chave anterior, guardada SO enquanto a nuvem nao souber da nova. A rotacao
// precisa provar posse da antiga; sem guardar, gerar chave nova trancaria o
// proprio aparelho fora da nuvem. Apagada assim que a troca e aceita.
String chaveAnterior;
bool chaveRegistradaNaNuvem = false;
// A tarefa de rede descobriu algo sobre a chave e pede ao laco que grave.
volatile bool pedidoGravarChave = false;

// Guardado para poder medir a folga de pilha dela em /dados.
TaskHandle_t tarefaNuvemHandle = NULL;

// Diario das ultimas linhas, lido em /log quando nao ha cabo. Ver registrar().
const int LOG_LINHAS = 24;
String diario[LOG_LINHAS];
int diarioProx = 0;
// Agora o laco e a tarefa de rede escrevem aqui, cada um no seu nucleo, e o
// navegador le em /log. Sem tranca, uma escrita no meio de uma leitura entrega
// um texto que acabou de ser liberado da memoria - e isso reinicia o aparelho.
SemaphoreHandle_t trancaDiario = NULL;

// Protege o estado que os DOIS nucleos escrevem: os alvos com seus carimbos de
// tempo e as marcas de chave. Ate agora so o diario tinha tranca, e o resto
// andava por coincidencia.
//
// O caso que motiva: aplicarAjustes() e chamada pela tarefa de rede (nucleo 0,
// comando vindo da nuvem) e pelo /sincronizar (nucleo 1, comando da rede
// local). Ela faz le-compara-escreve em `long long`, que no ESP32 sao DOIS
// armazenamentos de 32 bits. Duas chamadas no mesmo instante podem deixar
// metade de um carimbo atualizada - e um carimbo com a metade alta absurda faz
// TODO comando futuro ser ignorado ate o proximo reinicio, em silencio.
//
// Regra de ordem, para nao travar: quem segura esta tranca pode pedir a do
// diario (registrar() faz isso), nunca o contrario. E NADA de I/O com ela na
// mao - as funcoes de rede copiam o que precisam e soltam antes do HTTPS.
SemaphoreHandle_t trancaEstado = NULL;

void travarEstado() {
  if (trancaEstado != NULL) xSemaphoreTake(trancaEstado, portMAX_DELAY);
}

void soltarEstado() {
  if (trancaEstado != NULL) xSemaphoreGive(trancaEstado);
}

// IP fixo (opcional). Vazio = DHCP, que e o normal. Existe porque em muita
// propriedade o roteador e do provedor e o produtor nao tem acesso para fazer
// reserva de DHCP - sem isto, so restaria reconferir o IP a cada queda de luz.
String ipFixo;
String gatewayFixo;
String mascaraFixa;
// Gateway e mascara que o roteador entregou na ultima conexao por DHCP. Servem
// de base quando o produtor fixa um IP sem informar os dois - ele nao tem por
// que saber esses numeros, e o roteador ja os disse ao aparelho.
String gatewayAprendido;
String mascaraAprendida;

// --- Modo de configuracao (ponto de acesso) ---
// Entra segurando o VERDE e o VERMELHO juntos por 3 s: quem nao esta na frente
// do aparelho nao abre a pagina. Sai sozinho depois de um tempo ocioso, para um
// modo aberto por engano nao ficar exposto ate alguem lembrar.
// Responder a QUALQUER consulta de nome com o proprio IP e o que faz o celular
// abrir a pagina sozinho ("conectar-se a rede"), como num Wi-Fi de hotel. Sem
// isto o produtor teria que digitar 192.168.4.1 de cabeca.
DNSServer dnsServer;
const byte PORTA_DNS = 53;
const char* NOME_AP_CONFIG = "Sentinela-Config";
const unsigned long TEMPO_SEGURAR_CONFIG_MS = 3000;
// Quanto tempo os dois podem parecer soltos sem que a contagem recomece. Um
// unico digitalRead solto zerava tudo, e sem nada na tela dizendo - a pessoa
// continuava segurando achando que estava em 2,5 s quando estava em 0,3.
const unsigned long TOLERANCIA_SOLTURA_MS = 150;
// Quanto tempo segurar QUALQUER botao para sair do modo de configuracao. Nao e
// toque: o aparelho fica na estufa, e um esbarrao no meio do preenchimento
// custaria refazer os 3 s da combinacao e reconectar o celular na rede dele.
const unsigned long TEMPO_SAIR_CONFIG_MS = 1500;
unsigned long algumBotaoDesdeMs = 0;
// Entrar exige segurar dois botoes por 3 s, entao no instante em que o modo
// abre a mao AINDA esta em cima deles. Sem esperar a soltura, os mesmos dedos
// que abriram fechariam 1,5 s depois - o modo piscaria e ninguem entenderia por
// que. So conta para sair depois que todos ficarem soltos uma vez.
bool botoesSoltosDesdeQueEntrou = false;
const unsigned long TEMPO_CONFIG_OCIOSO_MS = 5UL * 60UL * 1000UL;
bool modoConfig = false;
// PIN de emparelhamento: 4 digitos sorteados a cada entrada no modo de
// configuracao e mostrados no visor. E o que prova que quem pede a chave esta
// OLHANDO o aparelho - sem ele, o ponto de acesso e aberto e qualquer um ao
// alcance do wifi naquele momento levaria a chave. O visor tem 4 digitos, entao
// o PIN cabe nele inteiro; a chave longa, nao.
//
// 4 digitos bastam porque o PIN e temporario: vale so enquanto o modo de
// configuracao durar (que ja expira sozinho), so na rede local, e morre depois
// de poucos erros. Mesmo racional do pareamento de Bluetooth.
int pinConfig = -1;
int tentativasPin = 0;
const int MAX_TENTATIVAS_PIN = 5;
unsigned long comboConfigDesdeMs = 0;
// Ultima vez que os dois estavam mesmo apertados. Serve para nao desistir da
// contagem por causa de um chacoalho do contato ou de um dedo que escorrega.
unsigned long ultimoComboPressionadoMs = 0;
unsigned long ultimaAtividadeConfig = 0;

// --- Liga/desliga a sirene de temperatura no proprio aparelho ---
// Segurar SO o botao do buzzer por 3 s alterna `buzzerTemperaturaAtivo`. Existe
// porque o interruptor do app e global (vale para todas as estufas): desligar
// uma so estufa e uma decisao tomada na frente daquele aparelho, e o produtor no
// meio da lavoura pode nao ter celular, sinal, nem internet. Fogo nunca e
// afetado - so a sirene de temperatura cala.
const unsigned long TEMPO_SEGURAR_BUZZER_MS = 3000;
unsigned long buzzerSeguradoDesdeMs = 0;
bool buzzerAlternadoNesteAperto = false;

// Prototipos explicitos: o gerador automatico do Arduino as vezes nao monta a
// assinatura certa para funcoes que recebem tipos do ArduinoJson.
void aplicarAjustes(JsonObjectConst entrada, JsonArray aplicadas,
                    JsonArray ignoradas);
void buscarComandosNuvem();
const char* motivoDoReinicio();
void prepararConexaoNuvem(WiFiClientSecure &cliente, HTTPClient &http);
void sincronizarChaveNuvem();
bool estadoDeAlertaMudou();
void carregarConfigPersistida();
void salvarConfigSeNecessario();
bool botaoRepetindo(int pino, unsigned long &ultimaRepeticao);
void definirTemperaturaAlvo(int novoAlvo);
void definirUmidadeAlvo(int novoAlvo);
void ajustarAlvo(int passo);
int margemVigente();
void atualizarEstadoTemperatura();
bool estaSilenciado();
void silenciarPorPrazo();
void reativarAlarme();
void verificarSegurarBuzzer();
void confirmarAlternanciaBuzzer(bool ligou);
long long nowMs();
void iniciarMdns();
void aplicarIpFixoSeCouberNaRede();
void verificarModoConfig();
void entrarModoConfig();
void descartarAjusteAcidental();
void sairModoAjuste();
void handleConfigPagina();
void handleConfigSalvar();
void guardarRedeAprendida();
void handleConfigIdentidade();
void prepararRedeConectada();
void marcarChaveRegistrada();
void aoPerderWifi(arduino_event_id_t evento, arduino_event_info_t info);
const char* textoMotivoFalhaWifi(uint8_t motivo);
void aplicarVentoinha();
void colherTemperaturaSePronta();
void forcarReescritaVisor();
void tarefaNuvem(void* _);
void gravarPendenciasDeChave();
uint8_t pontosDoVisor();
void registrar(const String& linha);
void handleLog();
void handleAtualizarUpload();
void handleAtualizarFim();
bool pinDoVisorConfere();

// ============================================================
//  SETUP
// ============================================================
// Monta o aparelho na ordem em que uma coisa depende da outra: identidade a
// partir do chip, config gravada, sensores e saidas, rede, e so entao as rotas
// HTTP. O controle local ja funciona antes da rede - e o ponto do edge-first.
void setup() {
  // Antes de qualquer outra coisa: a ventoinha move um motor de 220 V, e o
  // caminho ate aqui (Serial, MAC, config, sensores) leva mais de um segundo.
  // Deixar o pino solto nesse intervalo e deixar o contator no chute.
  pinMode(RELE_VENTOINHA, OUTPUT);
  digitalWrite(RELE_VENTOINHA, LOW);

  trancaDiario = xSemaphoreCreateMutex();
  trancaEstado = xSemaphoreCreateMutex();

  Serial.begin(115200);
  delay(1000);

  // Identidade usa o MAC inteiro. Usar so os 6 hex finais causou uma colisao
  // real entre dois ESP32 em propriedades diferentes: ambos viraram 215788,
  // compartilharam a mesma linha na nuvem e a segunda chave recebeu HTTP 401.
  uint64_t chipMac = ESP.getEfuseMac();
  char idBuf[20];
  snprintf(idBuf, sizeof(idBuf), "ESP32_%012llX",
           (unsigned long long)(chipMac & 0xFFFFFFFFFFFFULL));
  idHardware = idBuf;
  char nomeLocalBuf[28];
  snprintf(nomeLocalBuf, sizeof(nomeLocalBuf), "sentinela-%012llx",
           (unsigned long long)(chipMac & 0xFFFFFFFFFFFFULL));
  nomeLocal = nomeLocalBuf;
  Serial.print("ID do aparelho: ");
  Serial.println(idHardware);
  Serial.print("Motivo do ultimo reinicio: ");
  Serial.println(motivoDoReinicio());

  carregarConfigPersistida();

  dht.begin();

  // 10 bits: 0,25 C de resolucao, ~187 ms de conversao. O display mostra
  // Fahrenheit inteiro e a margem de alarme e de 8 F, entao resolucao maior so
  // custaria tempo de laco - a 12 bits a conversao trava 750 ms, e esse laco
  // tambem atende HTTP.
  sensorTemp.begin();
  sensorTemp.setResolution(10);
  // A biblioteca, por padrao, segura requestTemperatures() ate a conversao
  // terminar. Aqui quem espera e o laco, sem travar.
  sensorTemp.setWaitForConversion(false);
  Serial.print("DS18B20 encontrados no barramento: ");
  Serial.println(sensorTemp.getDeviceCount());

  pinMode(SENSOR_LUZ, INPUT);
  pinMode(BOTAO_BUZZER, INPUT_PULLUP);
  pinMode(BOTAO_VERDE, INPUT_PULLUP);
  pinMode(BOTAO_VERMELHO, INPUT_PULLUP);

  pinMode(LED_ALERTA, OUTPUT);
  pinMode(LED_UMIDADE, OUTPUT);
  pinMode(LED_CONTROLE_TEMP, OUTPUT);
  pinMode(BUZZER, OUTPUT);

  digitalWrite(LED_ALERTA, LOW);
  digitalWrite(LED_UMIDADE, LOW);
  digitalWrite(LED_CONTROLE_TEMP, LOW);
  digitalWrite(BUZZER, LOW);

  display.setBrightness(7);
  display.clear();

  WiFi.onEvent(aoPerderWifi, ARDUINO_EVENT_WIFI_STA_DISCONNECTED);
  conectarWifi();

  // Coleta os cabecalhos de autenticacao (o WebServer so guarda os listados).
  const char* cabecalhos[] = {"Authorization", "X-Device-Token", "X-API-Token"};
  server.collectHeaders(cabecalhos, 3);

  server.on("/status", HTTP_GET, handleStatus);
  server.on("/", HTTP_GET, handleSimple);
  server.on("/dados", HTTP_GET, handleSimple);
  server.on("/log", HTTP_GET, handleLog);
  server.on("/sincronizar", HTTP_POST, handleSincronizar);
  server.on("/salvar", HTTP_POST, handleConfigSalvar);
  server.on("/config/identidade", HTTP_GET, handleConfigIdentidade);
  // Gravacao sem cabo: o upload roda no terceiro parametro, e o primeiro so
  // e chamado quando o arquivo inteiro chegou.
  server.on("/atualizar", HTTP_POST, handleAtualizarFim, handleAtualizarUpload);
  server.onNotFound([]() {
    // No ponto de acesso, qualquer endereco cai no formulario: o produtor nao
    // precisa acertar a URL, basta abrir o navegador.
    if (modoConfig) {
      String meuEndereco = WiFi.softAPIP().toString();
      // O celular testa a internet buscando uma URL conhecida e esperando uma
      // resposta especifica. Responder com DESVIO para o aparelho e o sinal que
      // ele entende como "esta rede tem uma pagina para abrir" - e o que faz
      // surgir o aviso de conectar-se a rede. Servir a pagina direto aqui nao
      // aciona esse aviso de forma confiavel.
      if (server.hostHeader() != meuEndereco) {
        server.sendHeader("Location", "http://" + meuEndereco + "/", true);
        server.send(302, "text/plain", "");
        return;
      }
      handleConfigPagina();
      return;
    }
    server.send(404, "application/json", "{\"erro\":\"Rota nao encontrada\"}");
  });
  server.begin();
  iniciarMdns();

  // 12 KB de pilha: o handshake TLS e guloso, e uma pilha curta aqui vira
  // reinicio por estouro no meio de uma conexao.
  xTaskCreatePinnedToCore(tarefaNuvem, "nuvem", 12288, NULL, 1,
                          &tarefaNuvemHandle, 0);

  Serial.println("Sistema iniciado");
  Serial.print("Servidor HTTP em: http://");
  Serial.println(WiFi.localIP());
}

// ============================================================
//  LOOP
// ============================================================
// O laco e todo por tempo decorrido, sem delay(): qualquer espera bloqueante
// aqui atrasaria a leitura do sensor e a resposta dos botoes, que sao a parte
// que precisa funcionar mesmo com a internet fora.
void loop() {
  unsigned long agora = millis();

  server.handleClient();
  if (modoConfig) dnsServer.processNextRequest();
  manterWifi();

  verificarModoConfig();

  // A tarefa de rede descobriu algo sobre a chave e pediu para gravar. A
  // gravacao fica aqui porque o objeto Preferences e um so para os dois
  // nucleos. Ver tarefaNuvem().
  gravarPendenciasDeChave();

  verificarSensorLuz();
  verificarBotoes();
  verificarTempos();
  salvarConfigSeNecessario();

  if (agora - ultimoTempoLeitura >= intervaloLeitura) {
    ultimoTempoLeitura = agora;
    lerSensores();
  }
  colherTemperaturaSePronta();

  atualizarSaidas();
  atualizarDisplay();
}

// ============================================================
//  REDE
// ============================================================
// A conversa com a nuvem roda no NUCLEO 0, sozinha. O laco do controle fica no
// nucleo 1 e nao pode parar: e ele que le botao, decide alarme e mexe no rele.
// Cada chamada HTTPS segura quem a executa por 1 a 3 s - o handshake e caro e
// bloqueante -, e enquanto isso o aparelho ficava cego e surdo. Visto no visor:
// os dois pontos paravam de piscar e nenhum botao respondia.
//
// O que a tarefa toca do lado de fora: alvos e timestamps (inteiros, escrita
// atomica no ESP32) e as marcas de chave, que ela NAO grava na memoria
// permanente - pede, e o laco grava. Isso existe porque o objeto Preferences e
// um so: dois nucleos abrindo-o ao mesmo tempo e corrupcao garantida.
void tarefaNuvem(void* _) {
  for (;;) {
    // No modo de configuracao o aparelho e um ponto de acesso, sem saida para a
    // internet: tentar falar com a nuvem so gastaria tempo em conexoes fadadas
    // a falhar.
    //
    // Com a combinacao na mao, a nuvem espera. Sao 20 s ate a proxima busca e
    // 60 ate o proximo envio - nada que se perca. Hoje um handshake preso no
    // outro nucleo nao atrasa mais a contagem dos 3 s, mas a regra fica: o que
    // se quer ali e entrar na configuracao, nao conversar com o servidor.
    //
    // E quem esta ajustando o alvo tambem espera: um alvo que ainda esta sendo
    // movido nao e ajuste, e cada valor intermediario seria ruido na nuvem.
    if (!modoConfig && comboConfigDesdeMs == 0) {
      // Durante o ajuste, alerta nenhum sai daqui - nem fogo - ate o produtor
      // terminar, com teto de 30 s. A regra e o motivo estao em
      // estadoDeAlertaMudou().
      if (estadoDeAlertaMudou()) {
        ultimoPushNuvem = millis();
        empurrarLeituraNuvem();
      } else if (!modoAjuste && millis() - ultimoPushNuvem >= PUSH_INTERVAL_MS) {
        ultimoPushNuvem = millis();
        empurrarLeituraNuvem();
      }

      if (!modoAjuste && millis() - ultimaBuscaComandos >= COMANDOS_INTERVAL_MS) {
        ultimaBuscaComandos = millis();
        buscarComandosNuvem();
        // Pega carona no mesmo intervalo: nao ha pressa, e a funcao sai na hora
        // quando nao ha nada a registrar.
        sincronizarChaveNuvem();
      }
    }
    // Dorme de verdade: entrega o nucleo em vez de rodar em vazio.
    vTaskDelay(pdMS_TO_TICKS(200));
  }
}

// Grava o que a tarefa de rede descobriu sobre a chave. Roda no laco, que e o
// unico lugar que mexe na memoria permanente.
void gravarPendenciasDeChave() {
  if (!pedidoGravarChave) return;
  pedidoGravarChave = false;
  // Copia sob tranca e grava solto: o Preferences e lento e nao pode segurar a
  // tarefa de rede do outro nucleo.
  travarEstado();
  const bool registrada = chaveRegistradaNaNuvem;
  const bool semAnterior = chaveAnterior.length() == 0;
  soltarEstado();
  prefs.begin("sentinela", false);
  prefs.putBool("chaveReg", registrada);
  if (registrada && semAnterior) {
    prefs.remove("chaveAnt");
  }
  prefs.end();
}

// Primeira tentativa de entrar na rede da casa, com prazo. Falhar nao e fatal:
// o aparelho segue no controle local e manterWifi() continua tentando.
void conectarWifi() {
  if (wifiSsid.length() == 0) return;
  WiFi.mode(WIFI_STA);
  // Sem economia de energia no radio. O padrao do ESP32 em STA e dormir entre
  // os beacons do roteador e acordar de tempos em tempos: a resposta que leva
  // 50 ms passa a levar segundos de vez em quando, ou se perde. No app isso
  // aparece como o selo indo de LOCAL para OFFLINE e voltando sozinho a cada
  // dez ou quinze segundos, com a rede inteira funcionando - e o pior e que
  // some quando alguem vai olhar, porque mexer no celular mantem o trafego
  // acordado.
  //
  // O preco sao uns 25 mA a mais, continuos. O aparelho vive na tomada, e a
  // caixa fica fora da zona quente da estufa: nao ha onde esses 80 mW
  // incomodem. Prazo de sonda do lado do app ja tinha sido alongado por causa
  // deste sintoma (4 s para nome mDNS) - tratava o efeito, nao a causa.
  WiFi.setSleep(false);
  WiFi.setAutoReconnect(true);
  // Entra SEMPRE por DHCP, mesmo havendo IP fixo configurado. O fixo so e
  // aplicado depois, e so se pertencer a faixa que o roteador entregou.
  //
  // Antes ele era aplicado aqui, antes de begin(), sem conferir nada - e um IP
  // de outra rede deixava o aparelho mudo sem dar erro nenhum: ele ASSOCIA no
  // Wi-Fi normalmente (isso e camada 2), mas fica com endereco de outra faixa,
  // sem gateway e sem DNS validos. Nao alcanca a nuvem e ninguem o alcanca. Foi
  // o que aconteceu ao levar o aparelho para outra rede levando junto o IP fixo
  // da rede de origem. Entrar por DHCP primeiro custa uns segundos e garante que
  // um numero errado nunca mais tire o aparelho do ar.
  WiFi.begin(wifiSsid.c_str(), wifiPass.c_str());

  Serial.print("Conectando ao Wi-Fi");
  unsigned long inicio = millis();
  while (WiFi.status() != WL_CONNECTED && millis() - inicio < 15000) {
    delay(300);
    Serial.print(".");
  }
  Serial.println();

  if (WiFi.status() == WL_CONNECTED) {
    prepararRedeConectada();
  } else {
    Serial.print("Sem Wi-Fi - operando em modo local standalone. Motivo: ");
    Serial.println(textoMotivoFalhaWifi(motivoFalhaWifi));
  }
}

// Passos de quem acabou de entrar na rede. Uma vez por boot: o relogio segue
// sincronizando sozinho depois de configurado, e o IP fixo aplicado vale para
// as reconexoes seguintes.
void prepararRedeConectada() {
  if (redePreparada) return;
  redePreparada = true;
  motivoFalhaWifi = 0;
  Serial.print("Conectado. IP: ");
  Serial.println(WiFi.localIP());
  guardarRedeAprendida();
  aplicarIpFixoSeCouberNaRede();
  // NTP para timestamp real (fuso nao importa, usamos epoch em ms).
  configTime(0, 0, "pool.ntp.org", "time.google.com");
}

// Guarda o motivo que o radio deu para cair ou nao entrar.
void aoPerderWifi(arduino_event_id_t, arduino_event_info_t info) {
  const uint8_t motivo = info.wifi_sta_disconnected.reason;
  // Saida pedida pelo proprio aparelho (entrar no modo de configuracao, um
  // begin() novo): nao e causa de nada, e apagaria o motivo verdadeiro antes de
  // a pagina de configuracao mostra-lo.
  if (motivo == WIFI_REASON_ASSOC_LEAVE) return;
  motivoFalhaWifi = motivo;
}

// O codigo do radio em portugues, do jeito que o produtor consegue agir.
const char* textoMotivoFalhaWifi(uint8_t motivo) {
  switch (motivo) {
    case 0:
      return "nenhuma falha registrada";
    case WIFI_REASON_NO_AP_FOUND:
    case WIFI_REASON_NO_AP_FOUND_W_COMPATIBLE_SECURITY:
    case WIFI_REASON_NO_AP_FOUND_IN_AUTHMODE_THRESHOLD:
    case WIFI_REASON_NO_AP_FOUND_IN_RSSI_THRESHOLD:
      // O ESP32 so enxerga 2,4 GHz: rede so em 5 GHz some para ele.
      return "rede nao encontrada (nome errado, longe demais, ou rede so de 5 GHz)";
    case WIFI_REASON_AUTH_FAIL:
    case WIFI_REASON_AUTH_EXPIRE:
    case WIFI_REASON_4WAY_HANDSHAKE_TIMEOUT:
    case WIFI_REASON_HANDSHAKE_TIMEOUT:
    case WIFI_REASON_MIC_FAILURE:
      // Rede com usuario E senha (as de faculdade, tipo eduroam) cai aqui.
      return "senha recusada (ou rede que pede usuario e senha)";
    case WIFI_REASON_ASSOC_FAIL:
    case WIFI_REASON_ASSOC_TOOMANY:
    case WIFI_REASON_CONNECTION_FAIL:
      return "o roteador recusou a entrada (cheio ou bloqueando aparelhos)";
    case WIFI_REASON_BEACON_TIMEOUT:
      return "sinal perdido (longe do roteador)";
    default:
      return "outro motivo (codigo do radio)";
  }
}

// Anota o que o roteador entregou, para um IP fixo configurado depois nao
// precisar que o produtor saiba o gateway e a mascara da rede dele. So grava
// quando muda: a NVS tem ciclos de escrita contados, e isto roda a cada conexao.
void guardarRedeAprendida() {
  if (WiFi.status() != WL_CONNECTED) return;
  const String gateway = WiFi.gatewayIP().toString();
  const String mascara = WiFi.subnetMask().toString();
  if (gateway == "0.0.0.0" || mascara == "0.0.0.0") return;
  if (gateway == gatewayAprendido && mascara == mascaraAprendida) return;

  gatewayAprendido = gateway;
  mascaraAprendida = mascara;
  prefs.begin("sentinela", false);
  prefs.putString("gwDhcp", gateway);
  prefs.putString("mascDhcp", mascara);
  prefs.end();
  Serial.print("Rede aprendida - gateway ");
  Serial.print(gateway);
  Serial.print(", mascara ");
  Serial.println(mascara);
}

// Fixa o endereco antes de conectar, quando o produtor configurou um. Se algo
// estiver malformado, cai no DHCP: um IP invalido deixaria o aparelho invisivel
// na rede, que e pior do que um endereco que muda.
// Dois enderecos estao na mesma faixa sob esta mascara?
static bool mesmaFaixa(IPAddress a, IPAddress b, IPAddress mascara) {
  for (int i = 0; i < 4; i++) {
    if ((a[i] & mascara[i]) != (b[i] & mascara[i])) return false;
  }
  return true;
}

// Troca o endereco entregue pelo DHCP pelo IP fixo - mas SO se ele pertencer a
// rede em que o aparelho acabou de entrar.
//
// Chamada depois da conexao de proposito: e o unico momento em que se sabe qual
// e a faixa de verdade. Gateway e mascara vem medidos do proprio roteador, e nao
// adivinhados: ha redes com gateway em .254, e chutar .1 nelas deixaria o
// aparelho sem DNS - local funcionando, nuvem muda, nada na tela explicando.
void aplicarIpFixoSeCouberNaRede() {
  if (ipFixo.length() == 0) return;

  IPAddress ip;
  if (!ip.fromString(ipFixo)) {
    Serial.println("IP fixo invalido: seguindo no DHCP.");
    return;
  }

  const IPAddress atribuido = WiFi.localIP();
  IPAddress mascara = WiFi.subnetMask();
  IPAddress gateway = WiFi.gatewayIP();
  // Valores informados a mao (pela pagina do proprio aparelho) ainda valem,
  // desde que facam sentido nesta rede.
  IPAddress informado;
  if (informado.fromString(mascaraFixa)) mascara = informado;
  if (informado.fromString(gatewayFixo)
      && mesmaFaixa(informado, atribuido, mascara)) {
    gateway = informado;
  }

  if (!mesmaFaixa(ip, atribuido, mascara)) {
    // O caso que ja tirou o aparelho do ar: IP fixo trazido de outra rede.
    // Ignorar e ficar no DHCP mantem tudo funcionando; aplicar deixaria o
    // aparelho associado e inalcancavel.
    Serial.print("IP fixo ");
    Serial.print(ipFixo);
    Serial.print(" nao pertence a esta rede (");
    Serial.print(atribuido);
    Serial.println("): ignorado, seguindo no DHCP.");
    return;
  }

  // O gateway tambem responde como DNS na esmagadora maioria das redes.
  if (!WiFi.config(ip, gateway, mascara, gateway)) {
    Serial.println("Falha ao aplicar IP fixo: seguindo no DHCP.");
    return;
  }
  Serial.print("IP fixo: ");
  Serial.println(ipFixo);
}

// Reconecta em segundo plano sem travar o controle local.
void manterWifi() {
  // No modo de configuracao o radio esta servindo o ponto de acesso: tentar
  // reconectar aqui derrubaria a pagina que o produtor esta usando.
  if (modoConfig) return;
  if (wifiSsid.length() == 0) return;
  if (WiFi.status() == WL_CONNECTED) {
    if (wifiCaiuEmMs != 0) {
      registrar(String("Rede de volta depois de ") +
                ((millis() - wifiCaiuEmMs) / 1000) + "s fora.");
      wifiCaiuEmMs = 0;
    }
    tentativasWifiSeguidas = 0;
    radioDesligadoParaRemontar = false;
    prepararRedeConectada();
    iniciarMdns();
    return;
  }

  if (mdnsAtivo) {
    MDNS.end();
    mdnsAtivo = false;
  }
  // Segunda metade da remontagem: o radio foi desligado numa passada anterior
  // e agora volta. Sem delay() - quem espera e o laco, andando.
  if (radioDesligadoParaRemontar) {
    if (millis() - radioDesligadoEmMs < PAUSA_REMONTAGEM_MS) return;
    radioDesligadoParaRemontar = false;
    WiFi.mode(WIFI_STA);
    // Mesma razao da conexao inicial: radio remontado volta dormindo.
    WiFi.setSleep(false);
    WiFi.begin(wifiSsid.c_str(), wifiPass.c_str());
    registrar(F("Radio religado; tentando entrar na rede de novo."));
    return;
  }

  if (millis() - ultimaTentativaWifi < intervaloReconexaoWifi) return;
  ultimaTentativaWifi = millis();

  if (wifiCaiuEmMs == 0) wifiCaiuEmMs = millis();
  tentativasWifiSeguidas++;

  // A cada N tentativas sem sucesso, desmonta o radio em vez de repetir um
  // begin() que ja se mostrou inutil.
  if (tentativasWifiSeguidas % TENTATIVAS_ATE_REMONTAR_RADIO == 0) {
    remontagensDoRadio++;
    prefs.begin("sentinela", false);
    prefs.putUInt("radioOff", remontagensDoRadio);
    prefs.end();
    registrar(String("Radio travado ha ") + ((millis() - wifiCaiuEmMs) / 1000) +
              "s: desmontando e montando de novo (" + remontagensDoRadio +
              "a vez desde a gravacao).");
    WiFi.disconnect(true);
    WiFi.mode(WIFI_OFF);
    radioDesligadoParaRemontar = true;
    radioDesligadoEmMs = millis();
    return;
  }
  // A rede CONFIGURADA. Ate 14/09/2026 aqui estavam WIFI_SSID e WIFI_PASS - o
  // valor de fabrica, "SUA_REDE_WIFI" -, esquecidos quando o Wi-Fi passou a ser
  // configuravel (20/07). Qualquer queda de mais de 15 s, ou uma primeira
  // tentativa que nao desse certo, deixava o aparelho procurando uma rede que
  // nao existe ate alguem desligar e ligar de novo.
  Serial.print("Wi-Fi fora do ar (");
  Serial.print(textoMotivoFalhaWifi(motivoFalhaWifi));
  Serial.println("): tentando de novo.");
  WiFi.begin(wifiSsid.c_str(), wifiPass.c_str());
}

// Publica um nome estavel na rede local sem depender do IP entregue pelo
// roteador. O sufixo vem do MAC, portanto duas estufas nao disputam o mesmo
// nome. mDNS e uma conveniencia: o IP continua sendo o caminho alternativo.
void iniciarMdns() {
  if (mdnsAtivo || WiFi.status() != WL_CONNECTED || nomeLocal.length() == 0) {
    return;
  }

  if (ultimaTentativaMdns != 0 &&
      millis() - ultimaTentativaMdns < intervaloTentativaMdns) {
    return;
  }
  ultimaTentativaMdns = millis();

  if (!MDNS.begin(nomeLocal.c_str())) {
    Serial.println("Falha ao iniciar mDNS; use o IP exibido acima.");
    return;
  }

  MDNS.addService("http", "tcp", 80);
  mdnsAtivo = true;
  Serial.print("Nome local: http://");
  Serial.print(nomeLocal);
  Serial.println(".local");
}

// ============================================================
//  MODO DE CONFIGURACAO
// ============================================================

// Vigia a combinacao de botoes e o tempo ocioso do modo aberto.
void verificarModoConfig() {
  if (modoConfig) {
    // PIN queimado: o modo nao serve mais para NADA - as duas rotas que fazem
    // alguma coisa exigem o PIN, e ele morreu. Ficar aberto ate o prazo vencer e
    // so um ponto de acesso sem senha no ar sem utilidade nenhuma. Sai na hora.
    if (pinConfig < 0) {
      Serial.println("PIN bloqueado: saindo do modo de configuracao.");
      delay(200);
      ESP.restart();
    }
    if (millis() - ultimaAtividadeConfig >= TEMPO_CONFIG_OCIOSO_MS) {
      Serial.println("Modo de configuracao ocioso: reiniciando.");
      delay(200);
      ESP.restart();
    }
    // Sair na mao, sem esperar os 5 minutos. Quem desistiu, ou errou o PIN, nao
    // tem por que deixar o aparelho fora do ar - em configuracao ele nao le
    // sensor para a nuvem nem reporta nada.
    //
    // Segurar, e nao tocar: um toque acidental aqui custaria refazer tudo.
    bool algum = digitalRead(BOTAO_BUZZER) == LOW ||
                 digitalRead(BOTAO_VERDE) == LOW ||
                 digitalRead(BOTAO_VERMELHO) == LOW;
    if (!algum) {
      botoesSoltosDesdeQueEntrou = true;
      algumBotaoDesdeMs = 0;
      return;
    }
    if (!botoesSoltosDesdeQueEntrou) return;
    if (algumBotaoDesdeMs == 0) {
      algumBotaoDesdeMs = millis();
      return;
    }
    if (millis() - algumBotaoDesdeMs >= TEMPO_SAIR_CONFIG_MS) {
      // Dois apitos curtos: o mesmo par que confirma qualquer decisao tomada no
      // aparelho. Sem som, soltar o botao e ver o visor apagar seria
      // indistinguivel de o aparelho ter travado.
      for (int i = 0; i < 2; i++) {
        digitalWrite(BUZZER, HIGH);
        delay(80);
        digitalWrite(BUZZER, LOW);
        delay(80);
      }
      Serial.println("Saindo do modo de configuracao pelo botao.");
      delay(200);
      ESP.restart();
    }
    return;
  }

  // Verde e vermelho juntos. Eram os TRES, e o botao do buzzer responde de
  // forma intermitente - a combinacao dependia justamente do botao menos
  // confiavel do aparelho, e quem segurava os 3 s nao tinha como saber se
  // errou o gesto ou se o botao nao desceu.
  //
  // Segurar os tres continua abrindo o modo, porque verde e vermelho estao
  // entre eles: quem aprendeu o gesto antigo nao fica de fora.
  //
  // O preco e que os dois que sobraram sao justamente os de ajuste de alvo. O
  // primeiro a fechar contato mexe no alvo antes de a combinacao ser
  // reconhecida - entrarModoConfig() descarta isso recarregando o que esta
  // gravado.
  bool comboPressionado = digitalRead(BOTAO_VERDE) == LOW &&
                          digitalRead(BOTAO_VERMELHO) == LOW;
  if (!comboPressionado) {
    // Uma leitura solta nao cancela nada: contato de botao chacoalha, e a mao
    // que segura dois botoes de uma vez inevitavelmente escorrega. So desiste
    // depois de TOLERANCIA_SOLTURA_MS realmente sem os dois.
    if (comboConfigDesdeMs != 0
        && millis() - ultimoComboPressionadoMs < TOLERANCIA_SOLTURA_MS) {
      return;
    }
    if (comboConfigDesdeMs != 0) {
      // Desistiu no meio dos 3 s. Quem descarta o ajuste acidental e
      // entrarModoConfig(), e aqui ele nunca vai ser chamado - sem este
      // descarte o alvo ficaria com o toque que abriu a combinacao.
      comboConfigDesdeMs = 0;
      descartarAjusteAcidental();
      return;
    }
    comboConfigDesdeMs = 0;
    return;
  }
  ultimoComboPressionadoMs = millis();

  if (comboConfigDesdeMs == 0) {
    comboConfigDesdeMs = millis();
    return;
  }
  if (millis() - comboConfigDesdeMs >= TEMPO_SEGURAR_CONFIG_MS) {
    entrarModoConfig();
  }
}

// Desfaz o ajuste de alvo que o primeiro botao da combinacao fez sem querer.
//
// Apertar dois botoes quase nunca e simultaneo, e desde que a combinacao e
// verde + vermelho os dois SAO os botoes de ajuste: o que desce primeiro abre a
// janela de ajuste ou mexe no alvo antes de existir combinacao nenhuma. Isso
// deixou de ser acidente de borda - como era com os tres botoes - e passou a
// acontecer em toda tentativa.
//
// Reler a NVS devolve o ultimo valor que o produtor realmente confirmou, e nada
// legitimo se perde porque salvarConfigSeNecessario() nao grava enquanto a
// combinacao esta contando.
void descartarAjusteAcidental() {
  prefs.begin("sentinela", true);
  const int tempGravada = prefs.getInt("tempAlvo", temperaturaAlvoF);
  const int umidGravada = prefs.getInt("umidAlvo", umidadeAlvo);
  const long long tempTsGravado = prefs.getLong64("tempTs", tempTimestamp);
  const long long umidTsGravado = prefs.getLong64("umidTs", umidTimestamp);
  prefs.end();

  travarEstado();
  temperaturaAlvoF = tempGravada;
  umidadeAlvo = umidGravada;
  // Os carimbos voltam junto com os valores. Sem isso o alvo antigo ficaria com
  // a hora do toque acidental e venceria, no LWW, um comando remoto legitimo
  // mais velho que o toque - mas mais novo que o alvo que esta voltando.
  tempTimestamp = tempTsGravado;
  umidTimestamp = umidTsGravado;
  soltarEstado();

  if (modoAjuste) sairModoAjuste();
}

// Abre o ponto de acesso "Sentinela-Config" e sorteia o PIN do visor. Enquanto
// estiver aberto, o aparelho aceita ser reconfigurado - por isso ele sai
// sozinho por inatividade.
void entrarModoConfig() {
  modoConfig = true;
  comboConfigDesdeMs = 0;
  botoesSoltosDesdeQueEntrou = false;
  algumBotaoDesdeMs = 0;
  ultimaAtividadeConfig = millis();

  // Confirmacao fisica de que entrou no modo: um apito curto e um pisca dos
  // tres LEDs juntos. O visor de 7 segmentos nao mostra texto legivel, entao o
  // sinal do produtor e este - inconfundivel e sem depender de olhar o display.
  //
  // Toca DE PROPOSITO mesmo com a sirene de temperatura desligada, e isso nao e
  // descuido: o interruptor e sobre o ALARME, nao sobre todo som do aparelho.
  // Isto e resposta a uma acao que o produtor acabou de fazer, com ele na frente
  // segurando os botoes. Calar aqui deixaria segurar os dois sem retorno
  // nenhum, e a instrucao da tela ("segure ate apitar") viraria mentira.
  // PIN novo a cada entrada: um PIN fixo viraria segredo permanente de 4
  // digitos, que e fraco. Sorteado por entrada, ele so vale para esta sessao.
  pinConfig = (int)(esp_random() % 10000);
  tentativasPin = 0;

  digitalWrite(LED_ALERTA, HIGH);
  digitalWrite(LED_UMIDADE, HIGH);
  digitalWrite(LED_CONTROLE_TEMP, HIGH);
  digitalWrite(BUZZER, HIGH);
  delay(250);
  digitalWrite(BUZZER, LOW);
  digitalWrite(LED_ALERTA, LOW);
  digitalWrite(LED_UMIDADE, LOW);
  digitalWrite(LED_CONTROLE_TEMP, LOW);

  configSuja = false;
  descartarAjusteAcidental();

  if (mdnsAtivo) {
    MDNS.end();
    mdnsAtivo = false;
  }

  WiFi.disconnect(true);
  WiFi.mode(WIFI_AP);
  WiFi.softAP(NOME_AP_CONFIG);

  // Anuncia o proprio aparelho como servidor DNS na entrega do endereco. Sem
  // isto alguns Android consultam o DNS que ja tinham e nunca percebem o
  // portal - o celular conecta, mas nada abre sozinho.
  esp_netif_t* rede = esp_netif_get_handle_from_ifkey("WIFI_AP_DEF");
  if (rede != nullptr) {
    esp_netif_dns_info_t dns;
    dns.ip.type = ESP_IPADDR_TYPE_V4;
    dns.ip.u_addr.ip4.addr = (uint32_t)WiFi.softAPIP();
    uint8_t oferecerDns = 1;
    esp_netif_dhcps_stop(rede);
    esp_netif_set_dns_info(rede, ESP_NETIF_DNS_MAIN, &dns);
    esp_netif_dhcps_option(rede, ESP_NETIF_OP_SET,
                           ESP_NETIF_DOMAIN_NAME_SERVER, &oferecerDns,
                           sizeof(oferecerDns));
    esp_netif_dhcps_start(rede);
  }

  dnsServer.start(PORTA_DNS, "*", WiFi.softAPIP());

  Serial.print("Modo de configuracao. Rede: ");
  Serial.print(NOME_AP_CONFIG);
  Serial.print(" -> http://");
  Serial.println(WiFi.softAPIP());
}

// Evita que um SSID com aspas quebre o HTML do formulario.
String escaparHtml(const String& texto) {
  String saida;
  saida.reserve(texto.length() + 8);
  for (unsigned int i = 0; i < texto.length(); i++) {
    char c = texto.charAt(i);
    if (c == '&') saida += "&amp;";
    else if (c == '<') saida += "&lt;";
    else if (c == '>') saida += "&gt;";
    else if (c == '"') saida += "&quot;";
    else saida += c;
  }
  return saida;
}

// Serve o formulario de configuracao pelo navegador. E o caminho de quem esta
// sem o app, e continua sendo a recuperacao quando algo no app nao serve.
void handleConfigPagina() {
  ultimaAtividadeConfig = millis();

  // A senha nao volta preenchida: quem abre a pagina nao precisa ve-la, e
  // deixa-la no HTML seria entregar a senha do Wi-Fi a quem estiver na rede.
  String html = F(
      "<!doctype html><html lang=\"pt-br\"><head><meta charset=\"utf-8\">"
      "<meta name=\"viewport\" content=\"width=device-width,initial-scale=1\">"
      "<title>Sentinela Smart</title><style>"
      "body{font-family:sans-serif;background:#0e1012;color:#fff;margin:0;"
      "padding:24px}h1{font-size:20px}label{display:block;margin:14px 0 4px;"
      "font-size:14px;color:#bbb}input{width:100%;padding:10px;border-radius:8px;"
      "border:1px solid #333;background:#1c1c1e;color:#fff;font-size:16px;"
      "box-sizing:border-box}button{margin-top:20px;width:100%;padding:12px;"
      "border:0;border-radius:8px;background:#2e7d32;color:#fff;font-size:16px}"
      "p.aviso{color:#888;font-size:12px;margin-top:18px}"
      ".nome{background:#1c1c1e;border:1px solid #2e7d32;border-radius:8px;"
      "padding:12px;margin-bottom:8px}.nome b{font-size:17px;color:#7bd88f;"
      "word-break:break-all}.nome span{font-size:12px;color:#888}"
      "details{margin-top:14px}summary{color:#bbb;font-size:14px;cursor:pointer}"
      "p.falha{background:#2a1c1c;border:1px solid #b23b3b;border-radius:8px;"
      "padding:10px;font-size:13px;color:#f0b4b4}"
      "</style></head><body><h1>Configurar aparelho</h1>"
      // O nome vem primeiro e destacado: e o dado que o produtor precisa levar
      // para o app, e ate agora so aparecia no Monitor Serial - ou seja, so
      // para quem tivesse um computador com a IDE do Arduino.
      "<div class=\"nome\"><span>Cadastre este endere&ccedil;o no app:</span>"
      "<br><b>");
  html += escaparHtml(nomeLocal + ".local");
  html += F("</b></div>");
  // Por que a rede anterior nao funcionou, se nao funcionou. E aqui que o
  // produtor chega depois de "nao conectou", e ate agora a pagina nao dizia nada.
  if (motivoFalhaWifi != 0) {
    html += F("<p class=\"falha\">&Uacute;ltima tentativa na rede <b>");
    html += escaparHtml(wifiSsid);
    html += F("</b>: ");
    html += textoMotivoFalhaWifi(motivoFalhaWifi);
    html += F(" (c&oacute;digo ");
    html += String(motivoFalhaWifi);
    html += F(").<br>Wi-Fi com p&aacute;gina de login ou com usu&aacute;rio "
              "e senha (comum em faculdade) n&atilde;o serve para o aparelho: use "
              "o roteador da propriedade ou o do celular.</p>");
  }
  html += F(
      "<form method=\"POST\" action=\"/salvar\">"
      // O mesmo numero que o app pede. Vem primeiro porque sem ele nada do
      // resto e gravado, e descobrir isso depois de preencher tudo seria pior.
      "<label>PIN do visor (4 n&uacute;meros)</label>"
      "<input name=\"pin\" inputmode=\"numeric\" maxlength=\"4\" required>"
      "<label>Rede Wi-Fi</label><input name=\"ssid\" value=\"");
  html += escaparHtml(wifiSsid);
  html += F(
      "\" required><label>Senha do Wi-Fi</label>"
      "<input name=\"senha\" type=\"password\" placeholder=\"(deixe vazio para "
      "manter a atual)\">"
      // Vazio aqui quer dizer "mantenha a que voce tem", que nao serve para
      // mudar para uma rede SEM senha: a antiga ficaria gravada e o aparelho
      // nao conectaria. Esta caixa e a unica forma de pedir senha nenhuma.
      "<label style=\"font-weight:normal\"><input type=\"checkbox\" "
      "name=\"semsenha\" value=\"1\"> Rede sem senha</label>"
      // A chave sai da frente. Ela ficava lado a lado com a rede, com um campo
      // vazio esperando texto - convite a digitar algo. Digitar aqui grava por
      // cima da chave que o aparelho gerou e que o app ja conhece, e o aparelho
      // some da nuvem. Quem precisa disso e raro; quem abre esta pagina para
      // trocar de Wi-Fi e a regra.
      "<details><summary>Chave de acesso (avan&ccedil;ado)</summary>"
      "<p class=\"aviso\">O aparelho tem chave propria e o app a le sozinho. "
      "N&atilde;o preencha nada aqui no uso normal: o que for digitado grava por "
      "cima da chave atual e o aparelho some do app e da nuvem.</p>"
      "<label>Chave de acesso</label>"
      "<input name=\"token\" placeholder=\"(vazio mant&eacute;m a chave do "
      "aparelho)\">"
      "<label style=\"font-weight:normal\"><input type=\"checkbox\" "
      "name=\"novachave\" value=\"1\"> Gerar uma chave nova</label>"
      "<p class=\"aviso\">Marque so ao trocar de dono ou se a chave vazou. A "
      "chave nova aparece na tela seguinte. Depois disso entre de novo no modo "
      "de configura&ccedil;&atilde;o e refa&ccedil;a \"Conectar o aparelho ao "
      "Wi-Fi\" pelo app: e assim que ele pega a chave nova. Ate la os comandos "
      "param de funcionar.</p>"
      "</details>"
      "<details><summary>Endere&ccedil;o fixo (opcional)</summary>"
      "<p class=\"aviso\">Use quando n&atilde;o der para reservar o IP no "
      "roteador. Deixe vazio para o roteador escolher.</p>"
      "<label>IP fixo</label><input name=\"ip\" placeholder=\"192.168.1.220\" "
      "value=\"");
  html += escaparHtml(ipFixo);
  html += F(
      "\"><label>Gateway</label><input name=\"gateway\" "
      "placeholder=\"192.168.1.1\" value=\"");
  html += escaparHtml(gatewayFixo);
  html += F(
      "\"><label>M&aacute;scara</label><input name=\"mascara\" "
      "placeholder=\"255.255.255.0\" value=\"");
  html += escaparHtml(mascaraFixa);
  html += F(
      "\"></details>"
      "<button type=\"submit\">Salvar e reiniciar</button></form>"
      // Gravar firmware sem cabo. Fica aqui, dentro do modo de configuracao,
      // porque entrar nele exige a combinacao de botoes: so troca o firmware
      // quem esta na frente do aparelho. O PIN do visor fecha o resto.
      "<details><summary>Atualizar o firmware (avan&ccedil;ado)</summary>"
      "<p class=\"aviso\">Envie o arquivo <b>.bin</b> gerado no Arduino por "
      "\"Sketch &rarr; Exportar bin&aacute;rio compilado\". N&atilde;o desligue "
      "o aparelho durante o envio; ele reinicia sozinho no fim.</p>"
      "<form method=\"POST\" action=\"/atualizar\" "
      "enctype=\"multipart/form-data\">"
      "<label>PIN do visor</label>"
      "<input name=\"pin\" inputmode=\"numeric\" maxlength=\"4\" required>"
      "<label>Arquivo .bin</label>"
      // Sem filtro de tipo de proposito. O seletor do Android traduz o
      // accept para um tipo MIME, nao acha nenhum dono para .bin e mostra a
      // pasta vazia - o arquivo esta la e nao da para escolher. Quem erra o
      // arquivo nao quebra nada: o cabecalho e conferido na gravacao.
      "<input type=\"file\" name=\"firmware\" required>"
      "<button type=\"submit\">Enviar firmware</button></form></details>"
      "<p class=\"aviso\">O aparelho reinicia e volta ao normal. "
      "O alarme continua funcionando durante a configura&ccedil;&atilde;o.</p>"
      "</body></html>");

  server.send(200, "text/html; charset=utf-8", html);
}

// ---- Gravacao do firmware sem cabo ----
//
// Recebe o .bin pela pagina do modo de configuracao e grava na particao OTA. A
// seguranca e a mesma do resto dessa pagina, e por isso ela vive aqui: entrar no
// modo exige segurar dois botoes do aparelho, e o PIN do visor confirma.
//
// O PIN so pode ser conferido DEPOIS do upload - os campos do formulario chegam
// junto com o arquivo, e recusar no meio deixaria a particao pela metade. Por
// isso grava-se primeiro e so se finaliza (`Update.end`) com o PIN certo; com o
// PIN errado, `Update.abort()` descarta tudo e o aparelho continua no firmware
// antigo.
void handleAtualizarUpload() {
  if (!modoConfig) return;

  HTTPUpload& envio = server.upload();
  if (envio.status == UPLOAD_FILE_START) {
    ultimaAtividadeConfig = millis();
    Serial.print("Atualizacao: recebendo ");
    Serial.println(envio.filename);
    // UPDATE_SIZE_UNKNOWN: o tamanho so se conhece ao fim do envio.
    if (!Update.begin(UPDATE_SIZE_UNKNOWN)) Update.printError(Serial);
  } else if (envio.status == UPLOAD_FILE_WRITE) {
    // Mantem o modo de configuracao vivo: um envio lento passaria dos 5 min de
    // inatividade e o aparelho reiniciaria no meio da gravacao.
    ultimaAtividadeConfig = millis();
    if (Update.write(envio.buf, envio.currentSize) != envio.currentSize) {
      Update.printError(Serial);
    }
  }
}

void handleAtualizarFim() {
  if (!modoConfig) {
    Update.abort();
    server.send(403, "application/json",
                "{\"erro\":\"fora do modo de configuracao\"}");
    return;
  }
  if (!pinDoVisorConfere()) {  // ja respondeu ao cliente
    Update.abort();
    Serial.println("Atualizacao recusada: PIN invalido");
    return;
  }
  if (!Update.end(true)) {
    Update.printError(Serial);
    server.send(500, "text/html; charset=utf-8",
                "<meta charset=\"utf-8\"><h2>Falhou</h2>"
                "<p>O arquivo n&atilde;o serviu. O aparelho continua com o "
                "firmware antigo. Tente de novo com o .bin certo.</p>");
    return;
  }
  Serial.println("Atualizacao gravada. Reiniciando.");
  server.send(200, "text/html; charset=utf-8",
              "<meta charset=\"utf-8\"><h2>Atualizado</h2>"
              "<p>O aparelho est&aacute; reiniciando com o firmware novo.</p>");
  delay(300);
  ESP.restart();
}

/// Confere o PIN do visor. Devolve false JA TENDO RESPONDIDO ao cliente.
///
/// Compartilhado entre a rota que ENTREGA a chave e a que a GRAVA. Por um tempo
/// so a primeira pedia o PIN, o que deixava a segunda — a que pode trocar a
/// rede, o endereco e a propria chave — aberta a quem estivesse ao alcance do
/// wifi durante os 5 minutos do modo de configuracao. O ponto de acesso e
/// ABERTO: estar nele nao prova nada.
bool pinDoVisorConfere() {
  if (pinConfig < 0) {
    server.send(403, "application/json",
                "{\"erro\":\"pin bloqueado\",\"detalhe\":\"Saia e entre de novo no modo de configuracao.\"}");
    return false;
  }
  const int pinRecebido = server.hasArg("pin") ? server.arg("pin").toInt() : -1;
  if (pinRecebido != pinConfig) {
    tentativasPin++;
    // Poucos erros e o PIN morre: 4 digitos so sao seguros com limite de
    // tentativas, senao da para varrer os 10 mil em minutos.
    if (tentativasPin >= MAX_TENTATIVAS_PIN) pinConfig = -1;
    server.send(403, "application/json",
                String("{\"erro\":\"pin invalido\",\"restantes\":")
                    + (pinConfig < 0 ? 0 : (MAX_TENTATIVAS_PIN - tentativasPin))
                    + "}");
    return false;
  }
  tentativasPin = 0;
  return true;
}

// Entrega ao app a identidade do aparelho, incluindo a CHAVE. So responde no
// modo de configuracao, e essa restricao e a seguranca inteira: entrar nele
// exige segurar dois botoes juntos, ou seja, estar na frente do aparelho, e sai
// sozinho por inatividade. Em operacao normal a rota nao existe - `/status` diz
// apenas se ha chave, nunca qual.
//
// Serve para o produtor nunca precisar ver nem digitar a chave: o app le daqui e
// guarda. Uso unico foi considerado e descartado - se o app fechasse ou o
// celular caisse da rede do aparelho no meio, a chave se perderia e o produtor
// ficaria preso. Presenca fisica mais o prazo do modo de configuracao dao a
// mesma protecao sem a fragilidade.
void handleConfigIdentidade() {
  if (!modoConfig) {
    server.send(404, "application/json", "{\"erro\":\"fora do modo de configuracao\"}");
    return;
  }
  ultimaAtividadeConfig = millis();

  // Estar na rede do aparelho nao basta: o ponto de acesso e aberto. Sem o PIN
  // do visor, quem estiver ao alcance do wifi levaria a chave sem nunca chegar
  // perto do aparelho.
  if (!pinDoVisorConfere()) return;

  JsonDocument doc;
  doc["idHardware"] = idHardware;
  doc["nomeLocal"] = nomeLocal;
  doc["chave"] = tokenAparelho;
  // A rede em que o aparelho esta hoje. O app precisa dela para reenviar a MESMA
  // rede quando volta aqui so para trocar a chave: `/salvar` recusa SSID vazio,
  // e no modo de configuracao o celular esta na rede do aparelho, sem como
  // descobrir a de casa sozinho. Nao e segredo — aparece na lista de redes de
  // qualquer celular ao alcance.
  doc["wifiSsid"] = wifiSsid;
  doc["versaoFirmware"] = VERSAO_FIRMWARE;
  // Gateway aprendido do roteador. O app usa a faixa dele para ja deixar o
  // campo de IP fixo quase pronto: no modo de configuracao o celular esta na
  // rede do APARELHO (192.168.4.x) e nao tem como descobrir a faixa da casa
  // sozinho - mas o aparelho ja esteve la e anotou.
  doc["gatewayAprendido"] = gatewayAprendido;
  String corpo;
  serializeJson(doc, corpo);
  server.send(200, "application/json", corpo);
}

void handleConfigSalvar() {
  ultimaAtividadeConfig = millis();

  // Mesma prova de presenca da rota que entrega a chave, e por um motivo mais
  // forte: aqui da para TROCAR a rede, o endereco e a propria chave. Ficou de
  // fora quando o PIN foi criado - o raciocinio ("o ponto de acesso e aberto,
  // estar nele nao prova nada") sempre valeu para as duas, e so uma foi
  // protegida.
  if (!pinDoVisorConfere()) return;

  String ssid = server.arg("ssid");
  String senha = server.arg("senha");
  String token = server.arg("token");
  ssid.trim();
  token.trim();

  if (ssid.length() == 0) {
    server.send(400, "text/html; charset=utf-8",
                "<p>Informe a rede Wi-Fi.</p><a href=\"/\">Voltar</a>");
    return;
  }

  String ip = server.arg("ip");
  String gateway = server.arg("gateway");
  String mascara = server.arg("mascara");
  ip.trim();
  gateway.trim();
  mascara.trim();

  // IP preenchido mas invalido e pior do que nao ter nenhum: o aparelho sumiria
  // da rede. Recusa antes de gravar, para o erro aparecer com o produtor ainda
  // na frente do formulario.
  IPAddress conferencia;
  if (ip.length() > 0 && !conferencia.fromString(ip)) {
    server.send(400, "text/html; charset=utf-8",
                "<p>IP fixo invalido. Use o formato 192.168.1.220.</p>"
                "<a href=\"/\">Voltar</a>");
    return;
  }

  // Chave nova pedida no formulario: guarda a anterior para poder PROVAR posse
  // na rotacao com a nuvem. Sem isso a nuvem ficaria com a antiga para sempre e
  // o aparelho sem como corrigir, porque a rotacao exige a chave que ela tem.
  const bool gerarNova = server.arg("novachave") == "1";
  String chaveSubstituida;
  if (gerarNova) {
    chaveSubstituida = tokenAparelho;
    token = gerarChaveAleatoria();
  }

  prefs.begin("sentinela", false);
  prefs.putString("wifiSsid", ssid);
  // Senha vazia mantem a atual: assim da para voltar aqui e mexer so no
  // endereco fixo, ou so na chave, sem redigitar a senha do Wi-Fi. Isso nao consegue exprimir "esta
  // rede nao tem senha" — a antiga ficaria gravada, o aparelho tentaria entrar
  // com ela numa rede aberta e nao conectaria, sem nada dizendo por que. Daí a
  // marca explicita: quem quer rede aberta pede rede aberta.
  //
  // Ausente = comportamento de antes, entao app e formulario velhos continuam
  // valendo.
  const bool redeAberta = server.arg("semsenha") == "1";
  if (redeAberta) prefs.putString("wifiPass", "");
  else if (senha.length() > 0) prefs.putString("wifiPass", senha);
  // Chave vazia MANTEM a atual, como a senha do Wi-Fi logo acima - e como o
  // proprio formulario sempre prometeu. Gravar vazio apagava a chave, e o boot
  // seguinte gerava uma aleatoria que nem o app nem a nuvem conheciam: o
  // aparelho ficava na rede, funcionando, e trancado para fora de tudo. Desde a
  // v1.20.0 o app manda vazio de proposito (ele ja leu a chave do aparelho),
  // entao salvar pelo app derrubava o aparelho.
  if (token.length() > 0) prefs.putString("token", token);
  if (gerarNova) {
    prefs.putString("chaveAnt", chaveSubstituida);
    prefs.putBool("chaveReg", false);
    travarEstado();
    chaveAnterior = chaveSubstituida;
    chaveRegistradaNaNuvem = false;
    soltarEstado();
  }
  prefs.putString("ipFixo", ip);
  prefs.putString("gateway", gateway);
  prefs.putString("mascara", mascara);
  prefs.end();

  Serial.print("Configuracao gravada. Rede: ");
  Serial.println(ssid);

  // Quem chamou pede JSON? Entao e o app, e ele precisa da CHAVE NOVA aqui.
  //
  // O aparelho reinicia logo abaixo e sai do modo de configuracao: nao ha
  // segunda chance de ler. Sem devolve-la agora, trocar a chave pelo app exigiria
  // voltar ate a estufa, refazer a combinacao de botoes e digitar um PIN novo —
  // duas idas para uma operacao so.
  //
  // So sai quando a chave ACABOU de ser gerada nesta chamada. A chave em uso nao
  // volta por aqui: para le-la existe `/config/identidade`, que cobra o PIN.
  if (server.arg("formato") == "json") {
    JsonDocument doc;
    doc["sucesso"] = true;
    doc["nomeLocal"] = nomeLocal + ".local";
    if (gerarNova) doc["chaveNova"] = token;
    if (ip.length() > 0) doc["ipFixo"] = ip;
    String corpo;
    serializeJson(doc, corpo);
    server.send(200, "application/json", corpo);
    delay(1500);  // deixa a resposta sair antes de reiniciar
    ESP.restart();
    return;
  }

  // Repete o endereco aqui tambem: o ponto de acesso vai sumir no reinicio, e
  // esta e a ultima tela em que o produtor pode anotar o nome.
  String confirmacao = F(
      "<!doctype html><meta charset=\"utf-8\">"
      "<body style=\"font-family:sans-serif;background:#0e1012;color:#fff;"
      "padding:24px\"><h1>Salvo</h1>"
      "<p>O aparelho esta reiniciando e vai conectar na rede nova.</p>"
      "<p>Cadastre este endereco no app:<br><b style=\"font-size:18px;"
      "color:#7bd88f\">");
  confirmacao += escaparHtml(nomeLocal + ".local");
  if (gerarNova) {
    // Ultima tela em que a chave nova aparece. Depois do reinicio ela volta a
    // ser segredo: em operacao normal /status so diz se existe chave, nunca qual.
    // Anotar nao e mais o caminho principal - o app le a chave sozinho no modo
    // de configuracao - mas continua sendo a rede de seguranca de quem esta com
    // o navegador na mao e sem o app.
    confirmacao += F(
        "</b></p><p>Chave nova:<br>"
        "<b style=\"font-size:18px;color:#7bd88f\">");
    confirmacao += escaparHtml(token);
  }
  confirmacao += F("</b></p>");
  if (ip.length() > 0) {
    confirmacao += F("<p>Ou o endereco fixo: <b>");
    confirmacao += escaparHtml(ip);
    confirmacao += F("</b></p>");
  }
  confirmacao += F("</body>");

  server.send(200, "text/html; charset=utf-8", confirmacao);

  delay(1500);  // deixa a resposta sair antes de reiniciar
  ESP.restart();
}

// Troca o alvo por um caminho so, abrindo a janela de acomodacao proporcional
// ao tamanho da mudanca. Todo lugar que mexe no ajuste passa por aqui.
void definirTemperaturaAlvo(int novoAlvo) {
  // O teto vale aqui porque aqui passa tudo: os botoes do aparelho, o comando
  // vindo da nuvem e o que a sincronizacao traz de volta. Barrar so no botao
  // deixaria a porta da nuvem aberta.
  if (novoAlvo > ALVO_MAXIMO_F) novoAlvo = ALVO_MAXIMO_F;
  if (novoAlvo < ALVO_MINIMO_F) novoAlvo = ALVO_MINIMO_F;

  int delta = novoAlvo - temperaturaAlvoF;
  if (delta == 0) return;

  // A folga cobre so a distancia que a mudanca CRIOU. Aproximar o alvo da
  // temperatura atual nao gera folga nenhuma: a estufa nao precisa percorrer
  // nada, entao um desvio que ja existia continua sendo alarme.
  int desvioAntes = abs(temperaturaF - temperaturaAlvoF);
  int desvioDepois = abs(temperaturaF - novoAlvo);
  int folga = leituraOk ? (desvioDepois - desvioAntes) : 0;
  if (folga < 0) folga = 0;
  if (folga > FOLGA_ACOMODACAO_MAX) folga = FOLGA_ACOMODACAO_MAX;
  // Ajustes seguidos: vale a maior folga enquanto a janela estiver aberta.
  bool janelaAberta = acomodacaoAteMillis != 0 &&
                      (long)(millis() - acomodacaoAteMillis) < 0;
  folgaAcomodacao = (janelaAberta && folgaAcomodacao > folga) ? folgaAcomodacao : folga;
  acomodacaoAteMillis = millis() + TEMPO_ACOMODACAO_MS;
  if (acomodacaoAteMillis == 0) acomodacaoAteMillis = 1;

  temperaturaAlvoF = novoAlvo;
  configSuja = true;
  configRevisao++;
  atualizarEstadoTemperatura();
}

// Umidade nao tem janela de acomodacao porque nao tem alarme para acomodar:
// ela e registrada, nunca atuada. O limite de 0 a 100 existe porque o numero e
// percentual - fora disso nao seria ajuste, seria erro guardado e sincronizado.
void definirUmidadeAlvo(int novoAlvo) {
  if (novoAlvo < 0) novoAlvo = 0;
  if (novoAlvo > 100) novoAlvo = 100;
  if (novoAlvo == umidadeAlvo) return;

  umidadeAlvo = novoAlvo;
  configSuja = true;
  configRevisao++;
}

// Ajusta o alvo DO QUE O VISOR ESTA MOSTRANDO. Antes, entrar em ajuste forcava
// o visor de volta para a temperatura: quem estava olhando a umidade e apertava
// para ajustar era jogado para outro numero sem explicacao, e concluia que
// tinha errado o botao. Mexer no que esta na frente dispensa dizer qual dos
// dois o botao muda.
void ajustarAlvo(int passo) {
  travarEstado();
  const bool ajustandoUmidade = mostrandoUmidade;
  int alvoAtualizado;
  if (ajustandoUmidade) {
    definirUmidadeAlvo(umidadeAlvo + passo);
    umidTimestamp = nowMs();  // ajuste fisico participa do LWW
    configSuja = true;
    configRevisao++;
    alvoAtualizado = umidadeAlvo;
  } else {
    definirTemperaturaAlvo(temperaturaAlvoF + passo);
    tempTimestamp = nowMs();
    configSuja = true;
    configRevisao++;
    alvoAtualizado = temperaturaAlvoF;
  }
  soltarEstado();
  Serial.print(ajustandoUmidade ? "Umidade desejada: "
                                : "Temperatura desejada: ");
  Serial.println(alvoAtualizado);
  ultimoTempoAjuste = millis();
  displayAjusteLigado = true;
  ultimoPiscaAjuste = millis();
}

// Margem valendo agora: a normal mais a folga da acomodacao, se a janela
// ainda estiver aberta.
int margemVigente() {
  if (acomodacaoAteMillis == 0) return margemF;
  if ((long)(millis() - acomodacaoAteMillis) >= 0) {
    acomodacaoAteMillis = 0;  // venceu
    folgaAcomodacao = 0;
    return margemF;
  }
  return margemF + folgaAcomodacao;
}

// Le da NVS tudo o que precisa sobreviver a uma queda de energia: ajustes,
// rede, chave. Onde nao ha nada gravado, vale o valor de fabrica do topo.
void carregarConfigPersistida() {
  prefs.begin("sentinela", true);  // somente leitura
  temperaturaAlvoF = prefs.getInt("tempAlvo", temperaturaAlvoF);
  umidadeAlvo = prefs.getInt("umidAlvo", umidadeAlvo);
  // Os timestamps voltam junto para o Last-Write-Wins continuar valendo depois
  // de um reinicio: sem eles um comando antigo poderia vencer o ajuste atual.
  tempTimestamp = prefs.getLong64("tempTs", 0);
  umidTimestamp = prefs.getLong64("umidTs", 0);
  buzzerTemperaturaAtivo = prefs.getBool("buzzerAtivo", true);
  buzzerTimestamp = prefs.getLong64("buzzerTs", 0);
  // Quantas vezes o radio ja precisou ser remontado. Volta do NVS porque a
  // pergunta que ele responde e "isto vem acontecendo?", nao "aconteceu desde
  // que liguei agora".
  remontagensDoRadio = prefs.getUInt("radioOff", 0);
  // As constantes do topo sao so o valor de fabrica: o que o produtor gravou
  // pelo modo de configuracao tem precedencia.
  wifiSsid = prefs.getString("wifiSsid", WIFI_SSID);
  wifiPass = prefs.getString("wifiPass", WIFI_PASS);
  tokenAparelho = prefs.getString("token", DEVICE_TOKEN);
  chaveAnterior = prefs.getString("chaveAnt", "");
  chaveRegistradaNaNuvem = prefs.getBool("chaveReg", false);
  // Gera chave propria SO quando nao existe nenhuma - aparelho novo, ou com a
  // constante do topo ainda no valor de fabrica. Aparelho que ja tem chave NUNCA
  // e trocado sozinho: a troca automatica deixaria app e nuvem sem a chave nova
  // se o registro falhasse, e o produtor perderia o acesso ao que funcionava.
  // Trocar e sempre ato deliberado, no modo de configuracao.
  const bool precisaGerarChave =
      tokenAparelho.length() == 0
      || tokenAparelho == "COLE_AQUI_O_MESMO_TOKEN_DO_APP";
  if (precisaGerarChave) {
    tokenAparelho = gerarChaveAleatoria();
    chaveRegistradaNaNuvem = false;
  }
  ipFixo = prefs.getString("ipFixo", "");
  gatewayFixo = prefs.getString("gateway", "");
  mascaraFixa = prefs.getString("mascara", "");
  gatewayAprendido = prefs.getString("gwDhcp", "");
  mascaraAprendida = prefs.getString("mascDhcp", "");
  prefs.end();

  // A namespace acima estava aberta como somente leitura. Gravar nela falha e
  // fazia um aparelho novo gerar outra chave a cada reinicio. Reabre em escrita
  // somente quando ha de fato uma chave nova para persistir.
  if (precisaGerarChave) {
    prefs.begin("sentinela", false);
    prefs.putString("token", tokenAparelho);
    prefs.putBool("chaveReg", false);
    prefs.end();
    Serial.println("Chave de acesso gerada e gravada (primeira vez).");
  }

  Serial.print("Wi-Fi configurado: ");
  Serial.println(wifiSsid.length() > 0 ? wifiSsid : String("(nenhum)"));

  Serial.print("Ajustes recuperados: ");
  Serial.print(temperaturaAlvoF);
  Serial.print(" F / ");
  Serial.print(umidadeAlvo);
  Serial.println(" %");
}

// Grava no maximo a cada INTERVALO_SALVAR_CONFIG_MS. Segurar o botao gera um
// ajuste por toque, e a NVS tem numero limitado de escritas - juntar as
// mudancas numa so evita gastar a flash a toa.
void salvarConfigSeNecessario() {
  travarEstado();
  const bool precisaSalvar = configSuja;
  soltarEstado();
  if (!precisaSalvar) return;
  // Combinacao em contagem: o alvo pode ter andado no primeiro botao a fechar
  // contato, e o descarte dele e reler a NVS. Gravar agora tornaria o acidente
  // permanente, e o descarte leria de volta exatamente o que quer jogar fora.
  if (comboConfigDesdeMs != 0) return;
  // Espera o produtor parar de mexer, nao terminar de ajustar. Durante o ajuste
  // ultimoTempoAjuste anda a cada toque e a cada repeticao, entao isto libera
  // 1,5 s depois da ULTIMA mudanca - com o visor ainda piscando.
  if (modoAjuste && millis() - ultimoTempoAjuste < ESPERA_APOS_ALTERACAO_MS) return;
  if (millis() - ultimoSalvamentoConfig < INTERVALO_SALVAR_CONFIG_MS) return;

  // Fotografa o estado sob a tranca e solta antes da NVS, que e I/O lento.
  // A revisao impede apagar uma alteracao que chegue enquanto a foto e gravada.
  travarEstado();
  const int tempParaSalvar = temperaturaAlvoF;
  const int umidParaSalvar = umidadeAlvo;
  const long long tempTsParaSalvar = tempTimestamp;
  const long long umidTsParaSalvar = umidTimestamp;
  const bool buzzerParaSalvar = buzzerTemperaturaAtivo;
  const long long buzzerTsParaSalvar = buzzerTimestamp;
  const uint32_t revisaoSalva = configRevisao;
  soltarEstado();

  prefs.begin("sentinela", false);
  prefs.putInt("tempAlvo", tempParaSalvar);
  prefs.putInt("umidAlvo", umidParaSalvar);
  prefs.putLong64("tempTs", tempTsParaSalvar);
  prefs.putLong64("umidTs", umidTsParaSalvar);
  prefs.putBool("buzzerAtivo", buzzerParaSalvar);
  prefs.putLong64("buzzerTs", buzzerTsParaSalvar);
  prefs.end();

  travarEstado();
  if (configRevisao == revisaoSalva) configSuja = false;
  soltarEstado();
  ultimoSalvamentoConfig = millis();
  Serial.println("Ajustes salvos na memoria");
}

// Houve mudanca no que a nuvem precisa saber com urgencia? Detecta a BORDA:
// so devolve true na transicao, para uma emergencia em curso nao virar um
// envio a cada volta do loop.
bool estadoDeAlertaMudou() {
  bool fogo = alertaLuz || riscoIncendioAgora();
  // A CONDICAO, nao a sirene. Com `alarmeAtivoAgora()` aqui, desligar o buzzer
  // de temperatura fazia a transicao passar despercebida: o envio imediato para
  // a nuvem nao acontecia e o aviso esperava o ciclo de PUSH_INTERVAL_MS. E o
  // mesmo erro ja corrigido no servidor - deixar a sirene do galpao decidir o
  // que o celular fica sabendo. Silenciar o barulho aqui e um pedido sobre o
  // barulho aqui.
  bool alarme = alertaTemperatura;

  bool mudou = (fogo != ultimoFogoEnviado) || (alarme != ultimoAlarmeEnviado);
  if (!mudou) {
    alertaRetidoDesdeMs = 0;
    return false;
  }

  // Tudo espera quem esta ajustando - desvio, os 175 F e a chama. Decisao do
  // produtor: enviar e bloqueante, e enviar no meio do gesto travava o
  // segurar-para-subir. Com o dedo no botao ele ja esta ali, e a SIRENE LOCAL
  // continua tocando na hora, porque ela nao trava nada; o que espera e so o
  // aviso para quem nao esta na estufa.
  //
  // Esperar e NAO consumir. Os ultimos-enviados so andam quando o alerta sai,
  // entao ele fica pendente e vai no primeiro laco depois do ajuste, com o alvo
  // ja no valor final. Passar do ponto e voltar dentro do mesmo ajuste nao
  // manda nada ao celular: a nuvem ve o resultado, nao o caminho.
  if (modoAjuste) {
    if (alertaRetidoDesdeMs == 0) alertaRetidoDesdeMs = millis();
    if (millis() - alertaRetidoDesdeMs < ESPERA_MAX_ALERTA_NO_AJUSTE_MS) return false;
    Serial.println("Ajuste aberto ha tempo demais: enviando o alerta retido");
  }

  alertaRetidoDesdeMs = 0;
  ultimoFogoEnviado = fogo;
  ultimoAlarmeEnviado = alarme;
  return true;
}

// Empurra a leitura atual para a nuvem (POST /leitura), que guarda o estado ao
// vivo por aparelho para o /status remoto refletir este ESP em vez do simulador.
// Bloqueia o loop por ~1-2 s durante o handshake HTTPS; como so roda a cada
// PUSH_INTERVAL_MS, nao atrapalha o controle local.
// Todo cliente da nuvem nasce aqui, para nenhum escapar sem prazo. Eram tres
// construcoes identicas, e as tres sem timeout - consertar uma e esquecer as
// outras seria o caminho natural sem um lugar so.
//
// O setTimeout do HTTPClient NAO cobre o aperto de mao TLS: ele vale para a
// leitura da resposta. O aperto de mao tem prazo proprio, no cliente seguro, e
// e ele que chegava aos 120 s.
void prepararConexaoNuvem(WiFiClientSecure &cliente, HTTPClient &http) {
  cliente.setInsecure();  // nao valida certificado (simplifica; ok para o TCC)
  cliente.setHandshakeTimeout(TIMEOUT_HANDSHAKE_S);
  http.setConnectTimeout(TIMEOUT_CONEXAO_MS);
  http.setTimeout(TIMEOUT_RESPOSTA_MS);
}

// Por que o aparelho ligou desta vez. "O display apagou e voltou" tem duas
// causas que parecem iguais de fora e se consertam de jeitos diferentes: o laco
// parado esperando a rede, com o visor congelado, ou o chip reiniciando de
// verdade. Sem esta linha nao dava para separar as duas.
//
// No ESP32 o botao EN costuma ser reportado como ligar na energia, e nao como
// reset externo - por isso os dois dividem a mesma frase.
const char* motivoDoReinicio() {
  switch (esp_reset_reason()) {
    case ESP_RST_POWERON:   return "ligado na energia (ou botao EN)";
    case ESP_RST_SW:        return "reinicio pedido pelo proprio firmware";
    case ESP_RST_PANIC:     return "TRAVOU: excecao no codigo";
    case ESP_RST_INT_WDT:
    case ESP_RST_TASK_WDT:
    case ESP_RST_WDT:       return "TRAVOU: cao de guarda";
    case ESP_RST_BROWNOUT:  return "QUEDA DE TENSAO";
    case ESP_RST_EXT:       return "reset externo";
    case ESP_RST_DEEPSLEEP: return "saiu do sono profundo";
    default:                return "desconhecido";
  }
}

void empurrarLeituraNuvem() {
  if (strlen(CLOUD_URL) == 0) return;
  if (WiFi.status() != WL_CONNECTED) return;

  JsonDocument doc;
  doc["idHardware"] = idHardware;
  doc["timestampLeitura"] = nowMs();
  doc["temperaturaAtual"] = temperaturaF;
  doc["umidadeAtual"] = umidade;
  doc["temEnergia"] = true;
  doc["temInternet"] = true;
  doc["sinalWifi"] = wifiSinalPercent();
  // Endereco do aparelho na rede local. Vai junto porque, ate aqui, o nome mDNS
  // era a UNICA porta local do app - e quando ele falha (sufixo, roteador ou
  // celular que nao resolve .local) nao sobrava nada, com a nuvem funcionando
  // escondendo o problema. Com o endereco guardado, o app ganha uma segunda
  // porta e da para dizer de fora onde o aparelho esta.
  doc["ipLocal"] = WiFi.localIP().toString();
  doc["alarmeAtivo"] = alarmeAtivoAgora();
  // A CONDICAO de temperatura fora da faixa, separada de `alarmeAtivo` (que diz
  // se a sirene esta tocando agora). Os dois divergem quando o produtor desliga
  // a sirene deste aparelho ou pede os 10 min de silencio - e o aviso no celular
  // nao pode depender disso: ele tem tela de preferencias propria, e desligar a
  // sirene da estufa e um pedido sobre o barulho ali, nao sobre ser avisado.
  doc["alertaTemperatura"] = alertaTemperatura;
  doc["alertaIncendio"] = (alertaLuz || riscoIncendioAgora());
  doc["perigoChama"] = alertaLuz;
  doc["riscoIncendio"] = riscoIncendioAgora();
  doc["aquecedorLigado"] = ledControleLigado;
  doc["ventiladorLigado"] = ventoinhaLigada;
  doc["umidificadorLigado"] = false;
  doc["faseAtual"] = fasePorAlvo(temperaturaAlvoF);
  doc["aviso"] = avisoAtual();
  doc["corStatus"] = corStatusAtual();
  doc["fonte"] = "hardware";
  // Vai junto da leitura para dar para saber, pela nuvem, qual firmware cada
  // aparelho em campo esta rodando - sem isso so olhando o Serial no local.
  doc["versaoFirmware"] = VERSAO_FIRMWARE;

  JsonObject config = doc["config"].to<JsonObject>();
  config["idHardware"] = idHardware;
  config["temperaturaMeta"] = temperaturaAlvoF;
  config["tempTimestamp"] = tempTimestamp;
  config["umidadeMeta"] = umidadeAlvo;
  config["umidTimestamp"] = umidTimestamp;
  config["modoSilencioso"] = estaSilenciado();
  config["modoSilenciosoTimestamp"] = modoSilenciosoTimestamp;
  config["buzzerAtivo"] = buzzerTemperaturaAtivo;
  config["buzzerTimestamp"] = buzzerTimestamp;

  String corpo;
  serializeJson(doc, corpo);

  WiFiClientSecure cliente;
  HTTPClient http;
  prepararConexaoNuvem(cliente, http);
  String url = String(CLOUD_URL) + "/leitura";
  if (!http.begin(cliente, url)) return;
  http.addHeader("Content-Type", "application/json");
  travarEstado();
  const String chaveDoEnvio = tokenAparelho;
  soltarEstado();
  if (chaveDoEnvio.length() > 0) {
    http.addHeader("X-Device-Token", chaveDoEnvio);
  }
  int codigo = http.POST(corpo);
  registrar("Push nuvem -> HTTP " + String(codigo));
  http.end();

  // A nuvem so aceita esta leitura se ja conhecer a chave que foi junto (ou se
  // ela for a universal). Aceitou uma chave propria: o registro ou a troca que
  // sincronizarChaveNuvem() tentava ja valeu la. Sem isto, uma troca cuja
  // resposta se perdeu no caminho (a nuvem gravou, o aparelho estourou o prazo)
  // ficava tentando de novo a cada 20 s com a chave ANTIGA - que a nuvem ja
  // tinha descartado - e levando 401 para sempre, com uma chamada HTTPS
  // bloqueante a mais em cada ciclo. Visto no Serial em 14/09/2026.
  travarEstado();
  const bool faltavaConfirmar =
      !chaveRegistradaNaNuvem || chaveAnterior.length() > 0;
  const bool registroDadoPorFeito =
      chaveRegistradaNaNuvem && chaveAnterior.length() == 0;
  soltarEstado();
  if (codigo == 200 && faltavaConfirmar && chaveDoEnvio != DEVICE_TOKEN) {
    registrar(F("A nuvem ja aceita a chave deste aparelho."));
    marcarChaveRegistrada();
  }

  // 401 com o registro dado como concluido: a nuvem nao conhece mais esta chave.
  // Acontece quando a chave e gerada de novo aqui, quando a flash e apagada
  // inteira na gravacao, ou quando um registro ficou pela metade - e, ate agora,
  // o aparelho repetia o 401 para sempre, uma chamada HTTPS desperdicada por
  // ciclo, sem nunca tentar se apresentar de novo. Reabre a tentativa de
  // registro: se a nuvem tiver mesmo outra chave, ela responde 409 e
  // sincronizarChaveNuvem() desiste sozinha, entao isto nao vira laco.
  if (codigo == 401 && registroDadoPorFeito && chaveDoEnvio != DEVICE_TOKEN) {
    registrar(F("A nuvem recusou a chave: vou registrar de novo."));
    travarEstado();
    chaveRegistradaNaNuvem = false;
    soltarEstado();
    pedidoGravarChave = true;
  }
}

// ---- Diario curto na memoria ----
//
// Com o aparelho fechado na caixa nao ha Monitor Serial, e e justamente em campo
// que se precisa saber o que aconteceu. Guarda as ultimas linhas e serve em
// /log, pelo navegador do celular. Fica so na RAM: reiniciou, perdeu - o que
// importa aqui e o passado recente, nao o historico.
void registrar(const String& linha) {
  Serial.println(linha);
  if (trancaDiario == NULL) return;
  xSemaphoreTake(trancaDiario, portMAX_DELAY);
  diario[diarioProx] = String(millis() / 1000) + "s  " + linha;
  diarioProx = (diarioProx + 1) % LOG_LINHAS;
  xSemaphoreGive(trancaDiario);
}

void handleLog() {
  String saida;
  saida.reserve(LOG_LINHAS * 56);
  // Comeca na posicao seguinte a ultima escrita: assim sai da mais antiga para a
  // mais nova, que e como se le um diario. Copia tudo com a tranca na mao e
  // responde depois: a resposta pela rede e lenta e nao pode segurar quem quer
  // registrar.
  if (trancaDiario != NULL) xSemaphoreTake(trancaDiario, portMAX_DELAY);
  for (int i = 0; i < LOG_LINHAS; i++) {
    const String& linha = diario[(diarioProx + i) % LOG_LINHAS];
    if (linha.length() > 0) {
      saida += linha;
      saida += '\n';
    }
  }
  if (trancaDiario != NULL) xSemaphoreGive(trancaDiario);
  if (saida.length() == 0) saida = F("(sem registros ainda)\n");
  server.send(200, "text/plain; charset=utf-8", saida);
}

// A nuvem conhece a chave atual: para de tentar registrar ou trocar.
void marcarChaveRegistrada() {
  travarEstado();
  chaveRegistradaNaNuvem = true;
  chaveAnterior = "";
  soltarEstado();
  // Quem grava e o laco, em gravarPendenciasDeChave(): esta funcao roda na
  // tarefa de rede, no outro nucleo, e o Preferences nao aceita dois donos.
  pedidoGravarChave = true;
}

// Conta a propria chave para a nuvem, para ela deixar de depender da chave
// global. Registro simples enquanto o aparelho nunca teve chave la (TOFU);
// rotacao quando ha uma anterior guardada, porque ai a nuvem tem outra e so
// aceita a troca de quem provar posse da antiga.
//
// Roda de vez em quando, nao uma vez so: a primeira tentativa pode cair com a
// nuvem hibernada ou a internet fora, e nesse caso a chave nova nao pode ficar
// valendo apenas aqui.
void sincronizarChaveNuvem() {
  if (strlen(CLOUD_URL) == 0) return;
  if (WiFi.status() != WL_CONNECTED) return;
  // Fotografa as chaves e solta: daqui para baixo ha HTTPS, que leva segundos,
  // e segurar a tranca durante ele prenderia o /sincronizar do outro nucleo.
  travarEstado();
  const bool jaRegistrada = chaveRegistradaNaNuvem;
  const String anterior = chaveAnterior;
  const String atual = tokenAparelho;
  soltarEstado();
  if (jaRegistrada && anterior.length() == 0) return;
  if (atual.length() == 0) return;
  // Mesma regra do resto: emergencia manda, e o handshake HTTPS trava o loop.
  if (alertaLuz || riscoIncendioAgora()) return;

  const bool rotacionando = anterior.length() > 0;

  JsonDocument doc;
  doc["idHardware"] = idHardware;
  if (rotacionando) {
    doc["chaveAtual"] = anterior;
    doc["chaveNova"] = atual;
  } else {
    doc["chave"] = atual;
  }
  String corpo;
  serializeJson(doc, corpo);

  WiFiClientSecure cliente;
  HTTPClient http;
  prepararConexaoNuvem(cliente, http);
  String url = String(CLOUD_URL)
               + (rotacionando ? "/aparelhos/chave/rotacionar" : "/aparelhos/chave");
  if (!http.begin(cliente, url)) return;
  http.addHeader("Content-Type", "application/json");
  // Autentica com a credencial que a nuvem AINDA conhece: a anterior durante uma
  // rotacao, a atual quando e o primeiro registro.
  http.addHeader("X-Device-Token", rotacionando ? anterior : atual);
  int codigo = http.POST(corpo);
  http.end();

  registrar("Chave -> nuvem HTTP " + String(codigo));

  if (codigo == 200) {
    marcarChaveRegistrada();
    registrar(F("Chave registrada na nuvem."));
    return;
  }

  // 409: a nuvem ja tem chave para este aparelho e nao e esta. Sem a anterior
  // guardada nao ha como provar posse, entao insistir nao resolve - so o modo de
  // configuracao (presenca fisica) desfaz isso. Para de tentar para nao ficar
  // batendo na nuvem a cada ciclo.
  if (codigo == 409) {
    travarEstado();
    chaveRegistradaNaNuvem = true;
    soltarEstado();
    pedidoGravarChave = true;
    registrar(F("A nuvem ja tem outra chave para este aparelho."));
  }
}

// Busca na nuvem um ajuste feito pelo app quando o celular estava longe da
// propriedade. O aparelho nao e alcancavel de fora (fica atras do roteador do
// produtor), entao quem procura e ele. O servidor entrega o comando uma vez; o
// POST /leitura seguinte ja leva a config nova e serve de confirmacao. Se algo
// se perder, o app reenvia pela fila de pendencias que ele ja mantem.
void buscarComandosNuvem() {
  if (strlen(CLOUD_URL) == 0) return;
  if (WiFi.status() != WL_CONNECTED) return;
  // Emergencia manda: o handshake HTTPS trava o loop por 1-2 s, e durante um
  // incendio esse tempo faz falta para a sirene e os botoes. A nuvem espera.
  if (alertaLuz || riscoIncendioAgora()) return;

  WiFiClientSecure cliente;
  HTTPClient http;
  prepararConexaoNuvem(cliente, http);
  String url = String(CLOUD_URL) + "/comandos?idHardware=" + idHardware;
  if (!http.begin(cliente, url)) return;
  travarEstado();
  const String chaveDaBusca = tokenAparelho;
  soltarEstado();
  if (chaveDaBusca.length() > 0) {
    http.addHeader("X-Device-Token", chaveDaBusca);
  }

  int codigo = http.GET();
  if (codigo != 200) {
    http.end();
    return;
  }

  JsonDocument resposta;
  DeserializationError erro = deserializeJson(resposta, http.getString());
  http.end();
  if (erro) return;

  JsonObjectConst comando = resposta["comando"].as<JsonObjectConst>();
  if (comando.isNull()) return;  // nada esperando por este aparelho

  JsonDocument descartavel;
  JsonArray aplicadas = descartavel["a"].to<JsonArray>();
  JsonArray ignoradas = descartavel["i"].to<JsonArray>();
  travarEstado();
  aplicarAjustes(comando, aplicadas, ignoradas);
  soltarEstado();
  if (aplicadas.size() == 0) return;

  // Confirma na hora, em vez de esperar o proximo push: e a leitura empurrada
  // que avisa a nuvem que o comando foi obedecido, e ate ela chegar o app fica
  // mostrando "aguardando o aparelho".
  ultimoPushNuvem = millis() - PUSH_INTERVAL_MS;

  Serial.print("Comando da nuvem aplicado. Campos: ");
  Serial.println(aplicadas.size());
}

// epoch em milissegundos quando o NTP sincronizou; senao, fallback para millis().
long long nowMs() {
  time_t agora = time(nullptr);
  if (agora > 1700000000) {  // relogio plausivel (apos ~2023)
    return (long long)agora * 1000LL;
  }
  return (long long)millis();
}

// Converte o RSSI em algo que o produtor consiga ler. Aproximacao grosseira de
// proposito: serve para dizer "fraco" ou "bom", nao para medir.
int wifiSinalPercent() {
  if (WiFi.status() != WL_CONNECTED) return 0;
  long rssi = WiFi.RSSI();
  if (rssi <= -100) return 0;
  if (rssi >= -50) return 100;
  return (int)(2 * (rssi + 100));
}

// Nome da fase da cura correspondente ao ajuste atual. E vocabulario do
// produtor, nao do sistema: e assim que ele fala da estufada.
const char* fasePorAlvo(int alvo) {
  if (alvo <= 100) return "1. Amarelacao";
  if (alvo <= 110) return "2. Murchamento";
  if (alvo <= 120) return "3. Fixacao da Cor";
  if (alvo <= 135) return "4. Secagem da Folha";
  if (alvo <= 150) return "5. Secagem do Talo";
  if (alvo <= 165) return "6. ALERTA: ajuste acima do recomendado";
  return "CRITICO: ajuste muito elevado";
}

// Limite de incendio por temperatura. Espelha limiteFogo de logica.js: o
// aparelho e a nuvem precisam concordar sobre o que e fogo, e ate a v1.16.0 nao
// concordavam - o firmware usava 175 fixo enquanto o servidor ja acompanhava o
// ajuste. Com ajuste em 172, um alarmava aos 175 e o outro so aos 177.
//
// Acompanhar o ajuste importa porque a folga entre a maxima de trabalho
// (165 F) e o limite e de so 10 F, e o sensor fica no ar mais quente da estufa.
// Quem pede um ajuste alto de proposito nao deveria receber alarme de incendio
// por ter conseguido o que pediu.
// A regra vive em tres linguagens - aqui, em logica.js e em limiar_incendio.dart
// - e ja divergiu em campo. Com o teto de 165 F o ramo de cima virou inalcancavel,
// mas ele FICA: o teto e decisao de produto e pode mudar; a regra e do dominio.
// Apagar aqui e nao apagar nos outros dois seria recriar a divergencia de julho.
int limiteFogoF() {
  return temperaturaAlvoF > 170 ? temperaturaAlvoF + 5 : 175;
}

// Chave aleatoria de 32 hex (128 bits). Aleatoria e por aparelho e melhor que
// escolhida pelo produtor por dois motivos: nao repete entre aparelhos e nao e
// adivinhavel. `esp_random()` usa o gerador de hardware.
String gerarChaveAleatoria() {
  const char* hex = "0123456789abcdef";
  String chave;
  chave.reserve(32);
  for (int i = 0; i < 32; i++) chave += hex[esp_random() & 0x0F];
  return chave;
}

// Ha fogo agora? Chama vista pelo sensor de luz OU temperatura acima do limite
// de incendio. Nunca depende de umidade, e nunca e silenciavel por ajuste.
bool riscoIncendioAgora() {
  return leituraOk && temperaturaF > limiteFogoF();
}

// O silencio expirou? Comparacao com sinal para sobreviver ao rollover do
// millis() (~49 dias): negativo significa que o limite ainda esta no futuro.
bool estaSilenciado() {
  if (silencioAteMillis == 0) return false;
  if ((long)(millis() - silencioAteMillis) >= 0) {
    silencioAteMillis = 0;  // prazo vencido: volta a apitar
    return false;
  }
  return true;
}

// Silenciar e sempre "por 10 minutos a partir de agora" - nunca um liga/desliga.
// Apertar o botao de novo apenas reinicia o prazo, em vez de fazer a sirene
// voltar na hora, que era o comportamento antigo.
void silenciarPorPrazo() {
  silencioAteMillis = millis() + TEMPO_SILENCIO_MS;
  if (silencioAteMillis == 0) silencioAteMillis = 1;  // 0 e "nao silenciado"
  // Fotografa o fogo deste instante: e dele que o produtor esta ciente.
  luzCobertaPeloSilencio = alertaLuz;
  tempIncendioCobertaPeloSilencio = riscoIncendioAgora();
  digitalWrite(BUZZER, LOW);
  buzzerLigadoAgora = false;
}

// Rodada a cada ciclo enquanto o silencio vale. Responde se apareceu fogo que o
// silencio NAO cobre, e ao mesmo tempo descobre as causas que cessaram - uma
// chama que apaga e volta e fogo novo, e ninguem esta ciente dela ainda.
bool fogoNovoDuranteSilencio() {
  bool luzAgora = alertaLuz;
  bool tempAgora = riscoIncendioAgora();
  bool novo = (luzAgora && !luzCobertaPeloSilencio)
              || (tempAgora && !tempIncendioCobertaPeloSilencio);
  if (!luzAgora) luzCobertaPeloSilencio = false;
  if (!tempAgora) tempIncendioCobertaPeloSilencio = false;
  return novo;
}

// Encerra o silencio na hora, sem esperar o prazo vencer.
void reativarAlarme() {
  silencioAteMillis = 0;
  ultimoTempoBuzzer = 0;
}

// Sirene fisica ligada agora? Incendio ou temperatura fora da faixa. Os dois
// aceitam silencio temporario; fogo novo cancela o silencio em atualizarSaidas().
bool alarmeAtivoAgora() {
  if (!alertaLuz && !alertaTemperatura) return false;
  // O silencio de 10 min cobre todos os alarmes, inclusive o fogo que ja estava
  // acontecendo quando o botao foi apertado. Fogo novo cancela o silencio em
  // atualizarSaidas(), entao aqui basta consultar.
  if (estaSilenciado()) return false;
  // Buzzer de temperatura desligado cala so o alarme comum.
  if (!alertaLuz && !buzzerTemperaturaAtivo && !riscoIncendioAgora()) {
    return false;
  }
  return true;
}

// Textos que o produtor le (aparecem no app e no corpo do push), entao vao
// acentuados. O JSON e UTF-8; o visor de 7 segmentos nao mostra texto de
// qualquer forma, entao nao ha motivo para escrever sem acento.
String avisoAtual() {
  if (alertaLuz) return "Sensor de chama ativado";
  if (riscoIncendioAgora()) return "Risco de incêndio";
  if (alertaTemperatura) {
    return temperaturaF > temperaturaAlvoF ? "Temperatura alta" : "Temperatura baixa";
  }
  if (!leituraOk) return "Sem leitura de temperatura";
  return "Estável";
}

// Cor do cartao no app, derivada do mesmo estado que gera o aviso.
String corStatusAtual() {
  if (alertaLuz || riscoIncendioAgora()) return "red";
  if (alertaTemperatura) return temperaturaF > temperaturaAlvoF ? "orange" : "purple";
  return "green";
}

// Confere a chave de quem esta mandando um comando. Leitura e livre na rede
// local; alterar o aparelho exige a chave dele.
bool tokenValido() {
  String esperado = tokenAparelho;
  if (esperado.length() == 0) return true;  // sem token = liberado

  String recebido = "";
  if (server.hasHeader("Authorization")) {
    String h = server.header("Authorization");
    if (h.startsWith("Bearer ")) recebido = h.substring(7);
  }
  if (recebido.length() == 0 && server.hasHeader("X-Device-Token")) {
    recebido = server.header("X-Device-Token");
  }
  if (recebido.length() == 0 && server.hasHeader("X-API-Token")) {
    recebido = server.header("X-API-Token");
  }
  recebido.trim();
  return recebido == esperado;
}

// ============================================================
//  HANDLERS HTTP (contrato do app)
// ============================================================
// Estado completo em JSON: leitura, ajustes, alarme e identidade. E a rota que
// a nuvem e o app usam para saber tudo de uma vez.
void handleStatus() {
  JsonDocument doc;

  JsonObject status = doc["status"].to<JsonObject>();
  status["idHardware"] = idHardware;
  status["timestampLeitura"] = nowMs();
  status["temperaturaAtual"] = temperaturaF;
  status["umidadeAtual"] = umidade;
  status["temEnergia"] = true;  // sem sensor de tensao ainda
  status["temInternet"] = (WiFi.status() == WL_CONNECTED);
  status["sinalWifi"] = wifiSinalPercent();
  status["ipLocal"] = WiFi.localIP().toString();  // ver empurrarLeituraNuvem()
  status["alarmeAtivo"] = alarmeAtivoAgora();
  status["alertaTemperatura"] = alertaTemperatura;  // ver comentario em empurrarLeituraNuvem()
  status["alertaIncendio"] = (alertaLuz || riscoIncendioAgora());
  status["perigoChama"] = alertaLuz;
  status["riscoIncendio"] = riscoIncendioAgora();
  status["aquecedorLigado"] = ledControleLigado;
  status["ventiladorLigado"] = ventoinhaLigada;
  status["umidificadorLigado"] = false;
  status["faseAtual"] = fasePorAlvo(temperaturaAlvoF);
  status["aviso"] = avisoAtual();
  status["corStatus"] = corStatusAtual();
  // Faltava so aqui. `/dados` e o envio para a nuvem sempre mandaram a versao;
  // `/status` nao — e e ele que o app le quando esta LOCAL. O resultado era
  // "Firmware: Desconhecida" justamente na conexao direta com o aparelho, que e
  // onde a pergunta "o que esta gravado nele?" mais aparece.
  status["versaoFirmware"] = VERSAO_FIRMWARE;

  JsonObject config = doc["config"].to<JsonObject>();
  config["idHardware"] = idHardware;
  config["temperaturaMeta"] = temperaturaAlvoF;
  config["tempTimestamp"] = tempTimestamp;
  config["umidadeMeta"] = umidadeAlvo;
  config["umidTimestamp"] = umidTimestamp;
  config["modoSilencioso"] = estaSilenciado();
  config["modoSilenciosoTimestamp"] = modoSilenciosoTimestamp;
  config["buzzerAtivo"] = buzzerTemperaturaAtivo;
  config["buzzerTimestamp"] = buzzerTimestamp;

  String saida;
  serializeJson(doc, saida);
  server.send(200, "application/json", saida);
}

// Formato enxuto, compativel com o app desde antes de /status existir. No modo
// de configuracao a raiz vira o formulario, mas /dados continua JSON.
void handleSimple() {
  // No ponto de acesso a raiz e o formulario, nao o JSON: quem abre o navegador
  // ali esta configurando o aparelho, nao consultando leitura.
  // So a raiz vira formulario: `/dados` segue devolvendo JSON mesmo aqui, e e
  // por ele que o app descobre o nome local para mostrar ao produtor.
  if (modoConfig && server.uri() == "/") {
    handleConfigPagina();
    return;
  }

  JsonDocument doc;
  doc["temperaturaF"] = temperaturaF;
  doc["umidade"] = umidade;
  doc["temperaturaAlvoF"] = temperaturaAlvoF;
  doc["umidadeAlvo"] = umidadeAlvo;
  doc["margemF"] = margemVigente();
  doc["alertaTemperatura"] = alertaTemperatura;
  doc["alertaLuz"] = alertaLuz;
  doc["mostrandoUmidade"] = mostrandoUmidade;
  doc["modoAjuste"] = modoAjuste;
  doc["buzzerSilenciado"] = estaSilenciado();
  // A DECISAO do controle de temperatura. O nome vem de quando ela so acendia um
  // LED; esse LED nao existe mais no aparelho, e hoje quem obedece a ela e o
  // rele da ventoinha.
  doc["ledControleLigado"] = ledControleLigado;
  // O estado REAL do rele, que e o que se quer ver em campo. Difere da linha
  // acima quando a trava manual esta posta, ou quando ha fogo.
  doc["ventoinhaLigada"] = ventoinhaLigada;
  doc["ventoinhaBloqueada"] = ventoinhaBloqueada;
  doc["segundosAteDestravar"] = segundosAteDestravarVentoinha();
  doc["leituraOk"] = leituraOk;
  doc["umidadeOk"] = umidadeOk;
  // Os dois vao no /dados para serem lidos pelo navegador do celular, sem
  // computador: e assim que se investiga em campo, onde nao ha Serial. Tempo
  // ligado menor que o tempo que voce esta ali quer dizer que ele reiniciou.
  doc["motivoReinicio"] = motivoDoReinicio();
  // Memoria livre agora e o pior momento desde que ligou. O arquivo usa String
  // em tudo - diario, respostas, concatenacao a cada evento -, e isso fragmenta
  // o heap ao longo de semanas. Sem estes dois, um reinicio no decimo dia de
  // estufada nao tem como ser atribuido a nada. O minimo e o que importa: ele
  // guarda o fundo do poco mesmo que a medida de agora esteja folgada.
  doc["heapLivre"] = ESP.getFreeHeap();
  doc["heapMinimo"] = ESP.getMinFreeHeap();
  // Folga de pilha da tarefa de rede, em bytes. Os 12 KB dela foram escolhidos
  // por estimativa e nunca medidos; o handshake TLS e o que mais consome.
  // Ja vem em BYTES: no port Xtensa o StackType_t e uint8_t, diferente do
  // FreeRTOS de manual, onde a conta sai em palavras e se multiplica por 4.
  // Multiplicar aqui reportaria quatro vezes mais folga do que existe.
  doc["pilhaNuvemLivre"] =
      tarefaNuvemHandle != NULL
          ? (uint32_t)uxTaskGetStackHighWaterMark(tarefaNuvemHandle)
          : 0;
  doc["ligadoHaSegundos"] = millis() / 1000;
  // O que a rede andou fazendo enquanto ninguem olhava. Numero alto aqui com
  // "ligado na energia" no motivo quer dizer que o aparelho NAO reiniciou: foi
  // o radio que travou e voltou sozinho, e isso e outra investigacao.
  doc["remontagensDoRadio"] = remontagensDoRadio;
  doc["segundosSemRede"] =
      wifiCaiuEmMs == 0 ? 0 : (millis() - wifiCaiuEmMs) / 1000;
  doc["ip"] = WiFi.localIP().toString();
  doc["nomeLocal"] = nomeLocal + ".local";
  doc["tokenConfigurado"] = (tokenAparelho.length() > 0);
  doc["versaoFirmware"] = VERSAO_FIRMWARE;

  String saida;
  serializeJson(doc, saida);
  server.send(200, "application/json", saida);
}

// Aplica ajustes com Last-Write-Wins por campo. Vale tanto para o comando que
// chega direto do app na rede local (POST /sincronizar) quanto para o que o
// aparelho busca na nuvem: e a mesma regra, entao e o mesmo caminho.
void aplicarAjustes(JsonObjectConst entrada, JsonArray aplicadas,
                    JsonArray ignoradas) {
  // Temperatura (LWW por tempTimestamp).
  if (!entrada["temperaturaMeta"].isNull()) {
    long long ts = entrada["tempTimestamp"].as<long long>();
    if (ts > tempTimestamp) {
      definirTemperaturaAlvo((int)round(entrada["temperaturaMeta"].as<float>()));
      tempTimestamp = ts;
      configSuja = true;
      configRevisao++;
      aplicadas.add("temperaturaMeta");
    } else {
      ignoradas.add("temperaturaMeta");
    }
  }

  // Umidade (LWW por umidTimestamp). Registrada, nao atuada fisicamente.
  if (!entrada["umidadeMeta"].isNull()) {
    long long ts = entrada["umidTimestamp"].as<long long>();
    if (ts > umidTimestamp) {
      definirUmidadeAlvo((int)round(entrada["umidadeMeta"].as<float>()));
      umidTimestamp = ts;
      configSuja = true;
      configRevisao++;
      aplicadas.add("umidadeMeta");
    } else {
      ignoradas.add("umidadeMeta");
    }
  }

  // Silenciar (aceita modoSilencioso ou o formato antigo {"comando":"silenciar"}).
  bool temModo = !entrada["modoSilencioso"].isNull();
  bool ehComandoSilenciar =
      entrada["comando"].is<const char*>() &&
      String((const char*)entrada["comando"]) == "silenciar";
  if (temModo || ehComandoSilenciar) {
    long long ts = entrada["modoSilenciosoTimestamp"].isNull()
                       ? nowMs()
                       : entrada["modoSilenciosoTimestamp"].as<long long>();
    if (ts > modoSilenciosoTimestamp) {
      bool silenciar = temModo ? entrada["modoSilencioso"].as<bool>() : true;
      if (silenciar) {
        silenciarPorPrazo();
      } else {
        reativarAlarme();
      }
      modoSilenciosoTimestamp = ts;
      aplicadas.add("modoSilencioso");
    } else {
      ignoradas.add("modoSilencioso");
    }
  }

  // Liga/desliga o buzzer do alarme de temperatura (LWW por buzzerTimestamp).
  // Fogo nao passa por aqui - continua tocando sempre (ver atualizarSaidas).
  if (!entrada["buzzerAtivo"].isNull()) {
    long long ts = entrada["buzzerTimestamp"].isNull()
                       ? nowMs()
                       : entrada["buzzerTimestamp"].as<long long>();
    if (ts > buzzerTimestamp) {
      buzzerTemperaturaAtivo = entrada["buzzerAtivo"].as<bool>();
      buzzerTimestamp = ts;
      configSuja = true;
      configRevisao++;
      aplicadas.add("buzzerAtivo");
    } else {
      ignoradas.add("buzzerAtivo");
    }
  }
}

void handleSincronizar() {
  if (!tokenValido()) {
    server.send(401, "application/json",
                "{\"sucesso\":false,\"erro\":\"Nao autorizado\"}");
    return;
  }

  if (!server.hasArg("plain")) {
    server.send(400, "application/json",
                "{\"sucesso\":false,\"erro\":\"Payload invalido\"}");
    return;
  }

  JsonDocument entrada;
  DeserializationError erro = deserializeJson(entrada, server.arg("plain"));
  if (erro) {
    server.send(400, "application/json",
                "{\"sucesso\":false,\"erro\":\"JSON invalido\"}");
    return;
  }

  JsonDocument resp;
  JsonArray aplicadas = resp["alteracoesAplicadas"].to<JsonArray>();
  JsonArray ignoradas = resp["alteracoesIgnoradas"].to<JsonArray>();

  travarEstado();
  aplicarAjustes(entrada.as<JsonObjectConst>(), aplicadas, ignoradas);
  soltarEstado();

  resp["sucesso"] = true;
  JsonObject cfg = resp["configAtualizada"].to<JsonObject>();
  cfg["idHardware"] = idHardware;
  cfg["temperaturaMeta"] = temperaturaAlvoF;
  cfg["tempTimestamp"] = tempTimestamp;
  cfg["umidadeMeta"] = umidadeAlvo;
  cfg["umidTimestamp"] = umidTimestamp;
  cfg["modoSilencioso"] = estaSilenciado();
  cfg["modoSilenciosoTimestamp"] = modoSilenciosoTimestamp;
  cfg["buzzerAtivo"] = buzzerTemperaturaAtivo;
  cfg["buzzerTimestamp"] = buzzerTimestamp;

  String saida;
  serializeJson(resp, saida);
  server.send(200, "application/json", saida);
}

// ============================================================
//  CONTROLE LOCAL (preservado do firmware original)
// ============================================================
bool botaoFoiPressionado(int pino, bool &ultimoEstado, bool &estadoEstavel,
                         unsigned long &ultimoDebounce) {
  bool leituraAtual = digitalRead(pino);
  bool pressionado = false;

  if (leituraAtual != ultimoEstado) {
    ultimoDebounce = millis();
  }

  if ((millis() - ultimoDebounce) > debounceDelay) {
    if (leituraAtual != estadoEstavel) {
      estadoEstavel = leituraAtual;
      if (estadoEstavel == LOW) {
        pressionado = true;
      }
    }
  }

  ultimoEstado = leituraAtual;
  return pressionado;
}

// Verdadeiro a cada INTERVALO_REPETICAO_MS enquanto o botao segue apertado. O
// primeiro passo nao sai daqui - ele ja saiu do toque, em botaoFoiPressionado -
// entao a primeira repeticao vem 200 ms depois, e nao instantanea.
bool botaoRepetindo(int pino, unsigned long &ultimaRepeticao) {
  if (digitalRead(pino) != LOW) {
    ultimaRepeticao = 0;
    return false;
  }
  if (ultimaRepeticao == 0) {
    ultimaRepeticao = millis();
    return false;
  }
  if (millis() - ultimaRepeticao < INTERVALO_REPETICAO_MS) return false;

  ultimaRepeticao = millis();
  return true;
}

// Segurar SO o botao do buzzer por 3 s liga/desliga a sirene de temperatura
// deste aparelho. Exige os outros dois soltos: verde e vermelho juntos sao a
// combinacao do modo de configuracao.
//
// O aperto CURTO ja disparou no instante em que o botao desceu (silencia por 10
// min, e so quando ha alarme tocando). Nao ha conflito: os dois apontam para o
// mesmo lado - calar. Segurar leva mais longe, tornando o silencio permanente.
void verificarSegurarBuzzer() {
  bool soBuzzerPressionado = digitalRead(BOTAO_BUZZER) == LOW &&
                             digitalRead(BOTAO_VERDE) == HIGH &&
                             digitalRead(BOTAO_VERMELHO) == HIGH;

  if (!soBuzzerPressionado) {
    buzzerSeguradoDesdeMs = 0;
    buzzerAlternadoNesteAperto = false;
    return;
  }

  // Uma alternancia por aperto: sem isto, continuar segurando ficaria ligando e
  // desligando a cada passagem do loop.
  if (buzzerAlternadoNesteAperto) return;

  if (buzzerSeguradoDesdeMs == 0) {
    buzzerSeguradoDesdeMs = millis();
    return;
  }
  if (millis() - buzzerSeguradoDesdeMs < TEMPO_SEGURAR_BUZZER_MS) return;

  buzzerAlternadoNesteAperto = true;
  travarEstado();
  buzzerTemperaturaAtivo = !buzzerTemperaturaAtivo;
  // Participa do LWW como qualquer ajuste: um toque fisico e mais recente que
  // um comando remoto antigo, e o app reflete a mudanca na proxima leitura.
  buzzerTimestamp = nowMs();
  configSuja = true;
  configRevisao++;
  const bool buzzerLigado = buzzerTemperaturaAtivo;
  soltarEstado();

  // Religar deve religar de verdade: se havia um silencio de 10 min correndo,
  // ele perderia o sentido logo apos o produtor pedir a sirene de volta.
  if (buzzerLigado) reativarAlarme();

  confirmarAlternanciaBuzzer(buzzerLigado);
  Serial.print("Sirene de temperatura ");
  Serial.println(buzzerLigado ? "LIGADA (botao)" : "DESLIGADA (botao)");
}

// Confirmacao fisica, sem depender do visor: dois apitos curtos quando liga, um
// longo quando desliga. Como a confirmacao do modo de configuracao, ignora o
// interruptor de proposito - inclusive ao DESLIGAR, porque o apito e o aviso de
// que o pedido foi entendido. Sem ele, desligar seria indistinguivel de o
// aparelho nao ter percebido o toque.
void confirmarAlternanciaBuzzer(bool ligou) {
  if (ligou) {
    for (int i = 0; i < 2; i++) {
      digitalWrite(LED_ALERTA, HIGH);
      digitalWrite(BUZZER, HIGH);
      delay(120);
      digitalWrite(BUZZER, LOW);
      digitalWrite(LED_ALERTA, LOW);
      delay(120);
    }
  } else {
    digitalWrite(LED_ALERTA, HIGH);
    digitalWrite(BUZZER, HIGH);
    delay(500);
    digitalWrite(BUZZER, LOW);
    digitalWrite(LED_ALERTA, LOW);
  }
}
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
