Alox01/sentinela-smart/(commit log)

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2026-07-03 Add reading ingestion route and offline buffer
    Add POST /leitura so hardware (or a bridge) can push telemetry into cloud
    history, mirroring the app's offline command queue for the readings side.
    When the cloud DB is temporarily unreachable, readings are stored in a local
    JSONL buffer and replayed in chronological order once the connection returns.
    Also default alerta_incendio to false on insert so ingested payloads that omit
    the alarm flag no longer violate the NOT NULL constraint.
2026-07-03 Add virtual ESP32 push mode
    Let the simulator behave like the real device: when PUSH_TARGET_URL is set, the
    process pushes readings over HTTP (POST /leitura) to the cloud server instead of
    relying on the in-process polling. Readings that fail to send are held in a
    local buffer and replayed in order once the connection returns, mirroring what
    the physical ESP32 would need to do in the field.
    Generalize reprocessarBuffer to drain a buffer into any sink (cloud DB or HTTP
    push). Document the two-role topology and deployment in docs/ESP32_VIRTUAL.md.
2026-07-03 Add device-mode flag to avoid duplicate persistence
    When PUSH_TARGET_URL is set the process now runs as a device and disables the
    local persistence scheduler by default, so the cloud is the single writer of
    history. Add PERSISTIR_LOCAL to override, and document the two roles in the
    env example and docs.
2026-07-03 Add hybrid demo walkthrough
    Document the local/cloud/offline demo scenarios, including how the app auto
    switches between the local device and the cloud fallback, and how to show the
    reading buffer surviving a connection drop.
2026-07-03 Harden greenhouse form and temperature adjustment
    Clamp the temperature adjustment to the 60-200 range accepted by the server so
    out-of-range setpoints are no longer rejected with a 400. Show an error message
    when saving a greenhouse fails instead of failing silently.
2026-07-03 Fix release build by raising isar_flutter_libs compileSdk
    The isar_flutter_libs plugin pins compileSdk 30, which lacks android:attr/lStar
    and breaks assembleRelease with a resource linking error. Override it to 35 via
    finalizeDsl so the release APK builds. Debug builds also avoid the Isar 3.1.0
    negative-collection-id crash that only triggers in debug mode.
2026-07-03 Regenerate Isar schemas with correct collection ids
    The committed .g.dart files had truncated collection ids (generated by an older
    isar_generator), which made the current Isar runtime reject them at startup with
    "Collection id is invalid", crashing the app on device. Regenerating with the
    matching generator restores the full 64-bit ids.
2026-07-03 Allow network access in release build
    Add the INTERNET permission (Flutter only injects it for debug/profile, so the
    release APK had no network access and showed everything offline) and enable
    cleartext traffic so the app can reach local devices over plain HTTP.
2026-07-04 Speed up and stabilize connection resolution
    Probe local, port-80 and cloud candidates in parallel instead of sequentially,
    so resolution takes the slowest probe instead of the sum of timeouts. Give the
    cloud longer timeouts than the LAN (mobile networks plus Render need more than
    2s), remember the last working connection across screens so reopening a
    greenhouse no longer starts from scratch, drain queued commands right after a
    successful direct command, and label the port-80 probe distinctly in the
    connection details dialog.
2026-07-05 Align status leds and unify legend typography
    Left-align the Alta/Baixa leds inside a centered block so the dots line up
    vertically, and use the same font and icon size for the alarm legend as the
    temperature and humidity ones.
2026-07-05 Show full greenhouse name on home cards
    Let the name wrap to two lines on the home cards (with the status led pinned to
    the first line) so producers can read the whole name, and slightly reduce the
    monitoring title font so more of the name fits before truncating.
2026-07-05 Fit full 24-char greenhouse names on home cards
    The name still truncated on narrow phone cards even wrapped to 2 lines: the
    menu button reserved 34dp on every line (not just the first) and the card was
    almost square, leaving little room. Make cards slightly taller, allow 3 lines,
    shrink the 3-dot menu button and its reserved space, and use a smaller font so
    the full 24-character limit fits without ellipsis on phone-width cards.
2026-07-05 Clean up the drying report chart
    Stop the chart from looping back in time and crowding points together:
    - Sample history on a periodic interval or on events, but throttle event-driven
    samples with a 3-minute cooldown so bursts of adjustments no longer stack
    points on the same instant.
    - Draw the reading as a step line instead of a smoothed curve (the spline was
    overshooting and creating the loops), and add a dashed setpoint line so the
    reading can be compared against the target.
    - Sort readings by time so the line and the colored dots stay in order.
2026-07-05 Serve drying history from the cloud
    Add GET /historico so the app report can fill periods recorded while it was
    closed, and persist the setpoint per reading (new temperatura_meta/umidade_meta
    columns) so the remote history can rebuild the target line and point colors.
    The virtual ESP32 now pushes the current setpoint alongside each reading.
2026-07-06 Add PDF report service (work in progress)
    Add a PDF report generator for the drying cycle (header, summary, temperature
    and humidity charts, events and readings table) using the pdf/printing
    packages. Not wired to the UI yet; the download button still needs a PDF/CSV
    menu. Also add a handoff doc describing the current state and pending work.
2026-07-06 Add PDF download option to the report screen
    Turn the report download button into a PDF/CSV menu. The PDF is generated from
    the filtered cycle data and shared through the native share sheet (WhatsApp,
    print, save), which is far more useful for the grower than raw CSV. CSV stays
    available for data analysis.
2026-07-06 Drop the empty charts from the PDF report
    The pdf package chart rendered only the axes without plotting the series, so it
    added no value. Remove both charts and rely on the readings table, which
    already carries the full temperature/humidity record in a clear format.
2026-07-06 Pause monitoring polling when the app is backgrounded
    The monitoring screen polled the device every second even while the app was in
    the background, wasting battery and data until the OS suspended it. Observe the
    app lifecycle and stop the timer when the app leaves the foreground, resuming
    (with an immediate refresh) when it returns.
2026-07-06 Do not flag setpoint changes as climate oscillation
    When the operator changes the temperature/humidity setpoint, the reading is
    naturally far from the new target while the greenhouse catches up. The
    oscillation detector was treating that expected lag as a climate/fire event,
    adding spurious marks near every setpoint change. Add a settling window after a
    setpoint change during which the "attention" level deviation is ignored; only
    the critical level (>20) still fires as an alarm.
2026-07-06 Light the Alta/Baixa LEDs at 5 and respect the settling window
    The reading LEDs used a tight 2-degree/percent threshold and lit right after a
    setpoint change while the greenhouse was still reaching the new target. Raise
    the threshold to 5 (consistent with the graph and oscillation logic) and, during
    the settling window after a setpoint change, only light on the critical level
    (20), so a deliberate adjustment is no longer shown as a climate deviation.
2026-07-10 Extract oscillation detection into a testable class
    Move the temperature/humidity oscillation state machines (with the settling
    window after a setpoint change) out of the monitoring screen into a pure
    DetectorOscilacao class that returns detected events; the screen still registers
    them. Behavior preserved 1:1, with unit tests locking the transitions. The
    screen drops ~14 state fields and ~200 lines (1029 -> 761 across both phases).
2026-07-11 Start the settling window on setpoint tap, not on server echo
    The Alta/Baixa LED briefly lit when changing the setpoint because the settling
    window only opened once the server echoed the new value (up to a second later).
    Open it immediately when the user taps, so the LED no longer flickers.
2026-07-11 Document the real ESP32 test checklist
    The app already reads/controls the ESP32 locally (contract verified against the
    firmware). Add a checklist for flashing and registering it, and note the cloud
    history phase (app-as-bridge) to implement once the device is on hand.
2026-07-11 Add a per-greenhouse actions drawer (phase A)
    Replace the app bar's info/sync icons with a menu button that opens a right-side
    drawer scoped to the current greenhouse. The drawer holds connection details,
    sync pending, and a "Preparar nova estufada" action that sets the setpoints to
    90F/100F and reuses the existing end-cycle prompt. Fan control and scheduling
    are phase B, to do with the real ESP32.
2026-07-11 Widen the temperature alarm tolerance to 5 degrees
    The device siren fired at 2 F off the setpoint, which was too sensitive and beeped
    on small swings. Raise it to 5 F, matching the LED and report-event thresholds.
    Humidity still does not sound the siren by design (producers rarely track it).
2026-07-11 QA: validate the greenhouse address and refine graph thinning
    Reject clearly invalid addresses on the greenhouse form with a friendly hint
    (accepts IP, hostname/mDNS, optional http:// and port). Refine the report graph
    thinning so the final point replaces the last kept one when it is glued to it,
    avoiding a leftover close pair at the right edge.
2026-07-11 Show greenhouse power loss and plan push notifications
    Surface the power-supply state in the monitoring screen: an amber
    banner when the greenhouse reports no mains power, plus power-loss and
    power-restored events recorded in the cycle timeline.
    Add a design note for future push notifications (FCM) covering alarm,
    fire and power-loss alerts so the phone can warn even when the app is
    closed.
2026-07-11 Plan notification preferences and power-loss detection
    Detail the push-notification design: a global per-event preference
    matrix (notify and ring/vibrate toggles for alarm, fire, power loss and
    loss of communication), mapped to Android channels and enforced both in
    the open app and server-side.
    Document the hardware requirement for telling a power cut apart from an
    internet drop (battery-backed ESP32 with a mains-voltage sensor) and the
    'uncertain cause' message shown when only silence is observed.
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2026-07-18 Keep cloud reads tied to the greenhouse's own device
    Reading /status without an idHardware made the cloud answer with the
    default device (today, the simulator), so a greenhouse could briefly show
    another device's numbers. The root-path fallback was worse: it stamps the
    reading with the current time, which also hid the "not reporting" state.
    Neither happens on the cloud anymore - showing nothing beats showing the
    wrong greenhouse. Also stop probing the cloud before reading it, since the
    probe is the same GET /status and doubled every remote call, and give it a
    longer timeout so a server waking up is not declared dead.
2026-07-18 Tell apart a quiet device from a phone with no internet
    The greenhouse list still showed a green dot when the device had stopped
    reporting, because a card only turned red when the request itself failed -
    and the cloud keeps answering with the last reading. The monitoring screen
    had the same gap in its header and in the connection dialog.
    Both now use the reading timestamp, like the warning banner already did,
    and show SEM SINAL instead of folding it into OFFLINE: the grower needs to
    know whether it is his own internet or the greenhouse that went down.
    While here, the first load no longer claims OFFLINE before it has tried
    anything (CONECTANDO), and both pollings skip a round while one requ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
2026-07-18 Allow typing the device id when registering a greenhouse
    The device id was only ever filled by the automatic capture on the first
    local connection, which a greenhouse reached solely through the cloud never
    goes through - it would stay silent forever. The field is optional and the
    automatic capture still fills it when left blank.
    Editing a greenhouse also used to drop the captured id, since the update
    built a fresh entity without carrying it over. It is kept now unless the
    form provides another one.
2026-07-18 Hold commands on the cloud until the device fetches them
    An adjustment made away from the property never reached the equipment. The
    cloud applied every POST /sincronizar to the simulator, ignoring idHardware,
    and answered 200 - so the app reported success while nothing happened, and
    the device's next reading overwrote the value on screen.
    The device is behind the grower's router and cannot be reached from outside;
    it is always the one starting the conversation. So the command now waits in a
    per-device inbox until the device asks for it through GET /comandos, and the
    existing per-field LWW still settles the outcome on the device.
    Commands for the simulator keep being applied inline, so it s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
2026-07-18 Give the silence a deadline and fetch commands from the cloud
    Silencing had no expiry on the device: the 10-minute rule existed only in the
    server (TEMPO_SILENCIO in logica.js), so the real greenhouse stayed quiet for
    as long as the temperature was off. The button was worse - a plain toggle, so
    pressing it twice brought the siren straight back.
    Both now go through one path: silencing means "quiet for 10 minutes from now",
    and pressing again restarts the deadline instead of undoing it. The deadline
    uses millis() rather than the NTP clock, so it works before time syncs. Fire
    stays non-silenceable.
    The device also polls the cloud for adjustments made while the phone was away,
    applying them th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
2026-07-18 Address commands to the greenhouse they belong to
    Without a destination the cloud cannot tell which device a command is for, and
    would fall back to the simulator. Local commands do not need it - the device
    answering is the destination - but sending it either way keeps a single
    payload and lets the offline queue drain through whichever path is available.
2026-07-18 Show the pending adjustment instead of the stale one
    A command accepted by the cloud stayed invisible to GET /status, which keeps
    serving the device's last reported config. So the app snapped back to the old
    value seconds after the user changed it, and only caught up when the device
    had fetched the command and pushed a reading - up to eighty seconds of looking
    like the adjustment had failed.
    The live status now shows the device config with the pending command on top,
    flagged as aguardandoAparelho so the app can tell the two apart.
    Delivering a command no longer clears it either. The device confirms by
    reporting a config whose timestamp is at least as new, which also covers a
    reboot between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
    [sentinela_esp32.ino]
2026-07-18 Say when an adjustment is still waiting on the greenhouse
    The cloud reports aguardandoAparelho while a command has not been obeyed yet,
    but the app ignored it and simply showed the new value - so a command that the
    device never picked up looked exactly like one already applied.
    An amber banner now says the adjustment is on its way, which is a wait rather
    than a failure, so the red "no communication" banner keeps its meaning.
2026-07-18 Read each greenhouse once for the whole app
    The card on the greenhouse list and the monitoring screen each owned an
    ApiService and a timer, so opening a greenhouse threw away a reading taken
    milliseconds earlier and started over - up to fifteen seconds of an empty
    screen over the cloud. Meanwhile the cards behind kept polling, so N+1
    requests ran at once for no benefit.
    Both now observe one EstufaMonitor per greenhouse, keyed by the Isar id so
    editing the address does not turn it into a different greenhouse. The monitor
    hands the last reading to whoever subscribes, which is what makes the screen
    open already filled, and polls only while someone is watching - the cards stop
    on their own once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
2026-07-18 Stop re-probing every time the connection dialog opens
    Opening the dialog always started the reach test from scratch, and probing the
    cloud alone can take over ten seconds - so the section sat spinning on every
    visit, re-answering a question it had just answered.
    The result is kept on the ApiService, which the screens now share, so it
    survives closing and reopening. The dialog shows what is already known, says
    when it was checked, and offers a re-test for when the answer might have
    changed. Only the first visit probes on its own.
    The caption under the heading is gone: the section is named after what it does
    and the Aparelho line above already says whether the device is reporting.
2026-07-18 Show on the card when a reading came through the cloud
    The list only said whether a greenhouse was fine, never how the app was
    reaching it - so a reading fetched from far away looked the same as one taken
    on the local network. The dot now turns blue in that case, matching the NUVEM
    badge on the monitoring screen.
    Health still comes first: orange for a stale reading and red for an alarm both
    outrank blue, since how the data arrived matters far less than a greenhouse
    that needs attention.
    Also renames the name-field example, the last place still saying galpão.
2026-07-18 Require the token to read greenhouse data from the cloud
    The read routes (/status, /historico and the ESP32-format ones) answered
    without any authentication, so anyone holding the cloud URL could watch a
    greenhouse's telemetry and walk its history - readings are the grower's data,
    not public. Commands were already protected; reads now go through the same
    middleware. The device keeps serving its local /status openly on the farm
    network, where edge-first operation depends on it.
    Error responses stop echoing error.message: database failure details belong in
    the server log, not in what any client receives.
    idHardware is now validated on ingestion too - it becomes a map key and a
    device row, so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
2026-07-18 Document the security posture and warn on backup export
    The exported backup carries the greenhouse access keys - restoring needs
    them - so sharing the file is sharing the keys. The share sheet now says to
    treat it like a password.
    docs/SEGURANCA.md records what is protected, which risks were accepted and
    why (device-side TLS without cert validation, one shared token, no rate
    limiting), and what to rotate if a secret leaks.
2026-07-19 Survive a server restart without losing pending commands
    The command inbox lived only in memory, and the free tier recycles the
    process often - an adjustment made away from the farm would vanish silently
    if the dyno restarted before the device fetched it, with the app snapping
    back to the old value and no one the wiser.
    The inbox is now mirrored to Postgres (one row per device, merged payload):
    written when a command is stored, deleted when the device confirms, reloaded
    on boot. Memory stays the source of truth, so a database hiccup delays
    nothing - it only weakens the restart guarantee.
    GET /versao (public, no greenhouse data) reports the deployed commit and
    uptime. Today a security fix s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
2026-07-19 Bump firmware to 1.1.0 and note what each version means
    The version string never moved while the behavior changed underneath it, so
    /status could not tell which firmware a device in the field was running -
    and this week's mixed-version confusion is exactly the failure that invites.
    Verified: compiles clean on esp32 core 3.2.0 (82% flash, 14% RAM).
    [sentinela_esp32.ino]
2026-07-19 Run server, app and firmware checks on every push
    The test suites existed but nothing ran them automatically, and the firmware
    had never been through a compiler before being flashed. CI now runs the Node
    tests, flutter analyze/test, and a real ESP32 build of the sketch with the
    same core version used locally.
2026-07-19 Point the health check at /versao
    Requiring the token on /status locked out Render's own health checker, which
    sends no credentials - every deploy since then came up, failed the check and
    was discarded, leaving the pre-auth version serving indefinitely. The security
    fix silently blocked its own rollout.
    /versao is public, carries no greenhouse data and always answers 200, which is
    exactly what a liveness probe should hit.
2026-07-20 Only enforce database certificate validation when a CA is provided
    Defaulting to rejectUnauthorized: true looked stricter but broke every write:
    the Supabase pooler presents its own certificate chain, which fails public-CA
    validation (tested against the live pooler - "self-signed certificate in
    certificate chain"). Had this reached the deploy branch, persistence would
    have died silently on the next release.
    The connection stays encrypted either way. Real validation turns on by
    setting DB_SSL_CA to the certificate downloadable from the Supabase
    dashboard; without it the server logs a warning instead of refusing to work.
2026-07-20 Advertise each device by a stable mDNS name
    Registering a greenhouse meant hunting the IP on the serial monitor, and a
    router handing out a new lease silently broke the app's local path. The
    device now announces sentinela-<chip>.local (suffix from the MAC, so two
    units never fight over a name), re-announcing after Wi-Fi drops; the IP keeps
    working as the fallback and mDNS failure is only logged. Firmware 1.2.0,
    compiled at 84% flash / 15% RAM.
    Also drops the stale esp32/ copy of the sketch that predated firmware/.
    [sentinela_esp32.ino]
2026-07-20 Drop the stale MODO_RECEPTOR mention from a firmware comment
    The receiver mode was removed from the server long ago; the push comment
    still described the cloud as needing it. The per-device live state is what
    actually backs the remote /status now.
2026-07-20 Add a cloud retention window for readings
    The database had no automatic cleanup, so it only ever grew - which is how
    the readings table reached 2.7 million rows and blew past the Supabase free
    quota. The per-reading dedup caps the rate, but nothing removed old data.
    A daily job now deletes readings past a retention window (default ~300 days,
    CLOUD_RETENTION_DAYS), mirroring the app's local Isar retention. It runs on
    boot and every 24h, and a failure only logs - retention is housekeeping, not
    a critical path.
2026-07-20 Add notification preferences (phase 1 of push alerts)
    Groundwork for the push notifications the proposal calls for: a global
    preferences screen where the producer chooses, per event (temperature alarm,
    fire, power loss, no-communication), whether to be notified and whether the
    phone should ring/vibrate.
    Stored with shared_preferences and loaded at boot. Turning off the fire alert
    asks for confirmation - it is the critical event, and the screen reminds that
    the device's own siren stays independent. No Firebase yet: this layer is what
    those toggles will gate once the push channel exists.
2026-07-20 Send push alerts for fire, power loss and temperature alarms
    The app already registered FCM tokens and rendered incoming pushes, but the
    cloud had no endpoints to register against and nothing that ever sent one -
    the alerting half of the feature was missing.
    The server now stores subscriptions per (token, device), fires on the rising
    edge of each condition so a lasting problem does not notify every minute, and
    honours the per-event preferences the app uploads. Tokens the FCM rejects as
    gone are dropped, so the list cannot fill with uninstalled phones.
    Sending stays optional: without FIREBASE_SERVICE_ACCOUNT the sender reports
    itself disabled and the rest of the server runs untouched - a re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
2026-07-20 Warn when a greenhouse goes quiet
    A power cut is the case the device cannot report: it dies before it can say
    anything, so the only evidence is silence. Nothing was watching for that, which
    left the most likely emergency the one nobody would hear about.
    The cloud now checks subscribed devices every five minutes and, after fifteen
    without a reading, pushes an alert - and says plainly that the cause may be
    power or internet, because from here the two are indistinguishable. A second
    message confirms when readings resume. Both fire on the edge, so a long outage
    does not notify every cycle.
    Last contact falls back to the database when the live state is empty,
    otherwise a device that died before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
2026-07-20 Report an emergency the moment it starts
    The device only pushed on a fixed one-minute cycle, so a fire reached the
    cloud up to a minute late - and a quick test on the flame sensor began and
    ended between two pushes, so the cloud never saw it at all and no alert was
    ever sent. The siren and the app were right; the notification simply had
    nothing to react to.
    It now pushes immediately when fire or alarm turns on or off, detected on the
    edge so an ongoing emergency does not push every loop. The scheduled cycle
    still carries routine readings.
    [sentinela_esp32.ino]
2026-07-20 Send the firmware version with each reading
    Diagnosing a device in the field meant guessing which firmware it ran: the
    version only appeared on the local /status, so from the cloud there was no way
    to tell whether a fix had actually been flashed. It now rides along with the
    push and shows up in the remote status.
    [sentinela_esp32.ino]
2026-07-20 Let the device forgive the climb to a new setpoint
    Raising the target ten degrees set the siren off at once: the accommodation
    window lived only in the app, while the alarm that actually fires is the
    device's, on a fixed eight-degree margin. So the greenhouse was flagged for
    being far from a target the producer had just moved - the exact case the
    window exists to forgive.
    The device now runs the same rule as the app: changing the target opens a
    twenty-minute window whose slack matches how far the target moved, capped at
    twenty. Fire is never affected - safety does not accommodate. Every path that
    changes the target now goes through one function, so the physical buttons and
    a cloud command b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
    [sentinela_esp32.ino]
2026-07-20 Give the simulator the same post-adjustment tolerance
    The accommodation window existed in the app and, as of the last change, in the
    firmware - but not in the simulator, which alarmed the moment a target moved.
    Since the simulator stands in for a device during development and demos, the
    three would have disagreed about the same situation.
    Same rule everywhere now: changing the target opens a twenty-minute window
    whose slack matches how far it moved, capped at twenty, from either the app or
    the simulated physical button. Fire is never accommodated.
2026-07-20 Accept readings from a device that never received a command
    A freshly flashed ESP reports its config with all timestamps at zero - it has
    no command history yet. The reading validator required them to be positive, so
    every push from a new device came back 400 and the device stayed mute in the
    cloud: no live status, no history, and no fire alert, because the alert path
    never saw a reading at all.
    Zero is a legitimate "never adjusted" for a device reporting its own state.
    Commands keep the strict rule, which is where LWW actually needs a real
    instant; negative values are still rejected either way.
2026-07-20 Forgive only the distance the adjustment created
    Sizing the slack by how far the target moved silenced alarms it should not.
    Starting at 127F with a target of 70, moving the target to 110 counted as a
    40-degree change and bought 20 degrees of slack - enough to hide the 17 that
    remained. But the target moved toward the reading: the greenhouse has nothing
    to travel, and that deviation was already there before the touch.
    The slack is now the increase in deviation the change caused, so approaching
    the reading buys nothing and moving away buys exactly what it costs. Applied
    in the firmware, the app and the simulator, for temperature and humidity.
    Also fixes the suppression comparing the signed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
    [sentinela_esp32.ino]
2026-07-20 Keep the setpoints through a power cut
    The targets lived only in RAM, so any reboot returned them to the factory 76F.
    In the field that is the project's own headline scenario turned against it: a
    cut during a 140F cure would restore power and leave the greenhouse heating
    toward the wrong target, ruining the batch after the electricity was already
    back.
    Targets and their LWW timestamps now live in NVS, restored at boot. Writes are
    coalesced - holding a button steps one degree at a time and the flash has a
    finite write budget - and are held off while the producer is still adjusting.
    The alarm silence is deliberately not persisted: after a restart the alarm
    should stand.
    [sentinela_esp32.ino]
2026-07-20 Let the device decide whether the temperature is off
    The screen could show the siren ringing next to two unlit temperature
    indicators: the alarm came from the device while the indicators were the app's
    own calculation, each with its own accommodation state. Two verdicts on the
    same temperature, free to disagree - and when they did, the app looked broken.
    The indicators now follow the device's own reading of the situation, which it
    already publishes through corStatus, so siren and indicator always agree. This
    is also what edge-first means here: the device decides, the app reports.
    Humidity stays computed in the app - the device has no opinion on it and it
    never sounds the siren, so there is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
2026-07-20 Warn about a silent greenhouse sooner
    Fifteen minutes was too long for the headline scenario of the project: a
    power cut in the middle of a curing batch. Drop the silence threshold to
    five minutes and check every minute, so the alert lands in 5-6 min.
    Five missed pushes is the floor worth using. Below that the warning starts
    catching normal gaps - a router rebooting or the device reconnecting to
    Wi-Fi go quiet for a minute or two - and a false alarm at night teaches the
    grower to ignore the notifications.
    Both timings can now be tuned from the environment
    (WATCHDOG_SILENCIO_MIN, WATCHDOG_VERIFICACAO_MIN) to allow trying other
    values in the field without reflashing the server.
2026-07-20 Shorten the settling window to five minutes
    Measured on the real greenhouse: it reaches a target 10-15 F higher in
    under five minutes, so twenty minutes of forgiveness only delayed the
    alert for a deviation that was already real.
    The window has to hold the same value in the firmware, the simulator and
    the app, otherwise the app reports an oscillation while the device is
    still forgiving the same deviation. Changed in all three, with the reason
    recorded next to each constant.
    Firmware goes to 1.7.0 so a device in the field can be identified by
    /status.
    [sentinela_esp32.ino]
2026-07-20 Cap the settling slack at eight degrees
    Twenty was wide enough to hide a real problem inside the forgiveness for a
    setpoint change: a greenhouse sitting nineteen degrees off target looked
    the same as one still climbing to a new one.
    Eight matches the band the LEDs already treat as off target, so the slack
    can no longer cover a deviation the operator would want to see. Changed in
    the firmware, the simulator and the app together, and the tests now
    separate proportionality from the cap instead of exercising both at once.
    Firmware goes to 1.8.0.
    [sentinela_esp32.ino]
2026-07-20 Correct the ESP32 setup notes
    The document still opened with an integration gap that closed a while ago,
    claiming the firmware had no Wi-Fi, no HTTP server, no token and no
    persisted configuration. All four exist and are validated on hardware, so
    the file described a project that no longer exists.
    The access point setup mode is the part that really is missing, and it now
    says so plainly instead of sitting in a future-work list as though it were
    scheduled. Changing the Wi-Fi still means reflashing, which is worth
    admitting: it is the weakest point for a system that argues for autonomy
    in the field. What softens it is recorded next to it - mDNS and a DHCP
    reservation already cover the address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
2026-07-21 Let the grower change the Wi-Fi without a computer
    Until now the network name, password and access key were constants in the
    sketch, so moving the device to another router meant reflashing it with a
    laptop and a cable. For a system that argues for autonomy on a rural
    property, that turned every router change into a call for technical help.
    Holding all three buttons for three seconds turns the device into the
    Sentinela-Config access point, with a form at 192.168.4.1. What is saved
    there lives in NVS and takes precedence over the constants, which are now
    just factory defaults.
    Three buttons are the whole authentication, and deliberately so: anyone
    who can open the mode is already standing at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
2026-07-21 Open the setup page without typing an address
    The not-found handler was supposed to make any address reach the form, but
    it only ever catches wrong paths. A domain fails earlier than that, at name
    resolution, because the access point ran no DNS - so in practice the grower
    had to type 192.168.4.1 from memory, standing in a shed.
    Answering every name lookup with the device address makes the phone offer
    the page on its own, the way hotel Wi-Fi does.
    Worth noting for whoever tests it: Android warns that the network has no
    internet and asks whether to stay connected. Declining sends it back to
    mobile data and the page never loads.
    [sentinela_esp32.ino]
2026-07-21 Make the phone offer the setup page on its own
    Connecting to the access point worked, but nothing opened: the grower was
    left with an address to type from memory while standing in a shed, which
    is not a real answer.
    A phone decides a network has a sign-in page by fetching a known URL and
    looking at what comes back. Two things were missing for that verdict.
    Some Android versions ask the DNS server they already had, never reaching
    the wildcard responder, so the access point now advertises itself as the
    DNS server when it hands out addresses. And the check has to be answered
    with a redirect - serving the page directly with a 200 does not reliably
    trigger the prompt.
    This stays best effort: th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
    [sentinela_esp32.ino]
2026-07-21 Reach the setup form from the app menu
    The captive portal only ever gets the phone to offer the page, and whether
    it does is the phone's decision - Android private DNS defeats it outright.
    That left an address to type as the fallback, which is no fallback at all
    for the person this is built for.
    The grower already has the app, so the menu now carries the same three
    fields and posts them straight to the device. No address, no browser.
    Keeping the form inside the app rather than launching a browser avoids a
    new dependency and avoids handing off to the browser on a network with no
    internet, which is where browsers tend to stall. The page served by the
    device stays as the route for anyone with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
2026-07-21 Show the device address and allow a fixed IP
    Two gaps that only show up on a real property.
    The local name was the address to register in the app, and the only place
    it appeared was the serial monitor - which assumes the grower has a
    computer running the Arduino IDE. It now leads the setup page, appears
    again on the confirmation because the access point disappears on reboot,
    and shows in the app screen with a copy button.
    A DHCP reservation was the answer for a changing address, but plenty of
    rural routers belong to the internet provider and nobody else has the
    admin password. The device can now hold its own address instead. An
    invalid one is refused before it is stored, and one that fails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
    [sentinela_esp32.ino]
2026-07-21 Drop the power failure notification
    It could never fire. The device has no voltage sensor and no battery, so
    temEnergia is hardcoded true in the firmware, and the only path that would
    have raised the event was closed at both ends.
    Leaving it on the screen was worse than useless. A grower wanting to be
    warned about a power cut could reasonably keep power failure switched on
    and turn off no communication as redundant, then end up with no warning at
    all during the exact scenario this project exists for. The screen promised
    a distinction the system cannot make.
    Silence is ambiguous by nature - no power and no internet both arrive as
    nothing - so there is one event now, and its wording carries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
2026-07-21 Remove code that could not run
    Three leftovers, found while checking whether the power failure event had
    company.
    The root fallback adapter in the app was the one worth hurrying. It only
    ran if /status failed, which no device in the field does, but if it ever
    had run it translated a temperature alarm or a failed sensor reading into
    alertaIncendio - the critical, non-silenceable alert that now rings an
    alarm tone on the phone for thirty seconds. It also mapped a humidifier
    to whether the display happened to be showing humidity, and stamped a
    fixed ESP32_REAL as the hardware id. A false fire alarm kept on a shelf,
    waiting for a rare condition. Its two number and boolean helpers went with
    it,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
2026-07-21 Put the notification settings where they apply
    The preferences are stored under a single key with no greenhouse attached,
    so they have always applied to every greenhouse at once. The only way in
    was the menu of one particular greenhouse, which suggests the opposite.
    The screen says so at the top, but only once it is open.
    They now also sit in the app bar of the greenhouse list, which is the
    screen that actually covers all of them, and the entry inside a greenhouse
    states the scope in its subtitle so nobody has to open it to find out.
    Making them per greenhouse remains possible - the server already keys push
    registrations by device - but it is not obviously wanted yet.
2026-07-21 Write down how the curing barn actually works
    Decisions about thresholds, sensor choice and mounting only make sense
    against the real process, and none of that was written anywhere. Every
    time the work is picked up again it started by asking the same questions.
    Covers the forced air barn layout and airflow, the fact that the
    circulation fan runs constantly while only the ash pit blower modulates
    the heat, where the two measurement points sit and why they differ, and
    the working maximum of 165 F.
    Field knowledge and my own inferences are marked separately, so a wrong
    conclusion can be traced to whether the premise or the reasoning failed.
    Two findings worth acting on came out of it. The fi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
2026-07-22 Capture the commercial viability discussion
    Notes on scaling the project from a thesis prototype to a product sold in
    the thousands, so the reasoning is not lost between sessions.
    The core tension is that a lifetime purchase and an always-on cloud
    service cannot both be free forever - someone pays for the running server.
    The edge-first design is the way out: local monitoring costs nothing and
    can honestly be lifetime, while remote access is a service. The cost that
    scales with the number of units is the database, so moving history off the
    cloud and leaving a stateless relay decouples cost from scale. Push stays
    free, a small broker is cheap, and the free tiers were right for the
    thesis but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
2026-07-22 Record the local hub architecture
    Adds the design the discussion converged on: a second ESP32 in the house
    acting as a hub, with the phone always talking to the hub over Wi-Fi and
    the hub bridging to the barns over ESP-NOW nearby or LoRa far out. History
    lives on the hub's SD card, remote access rides a minimal stateless relay,
    and push stays free.
    Keeps the author's own decisions separate from the analysis that answered
    them - the phone never speaks LoRa, the phone storage fear is unfounded
    against the actual data sizes, occasional remote makes push the free
    critical path, and storage no longer decides ESP versus Pi so a cheap
    ESP32 hub can start with the heavy parts left to a small cloud.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
2026-07-22 Note the real ESP-NOW range and the SD power-loss guard
    Two engineering answers from the discussion, so they are not lost.
    The 200 m figure for ESP-NOW is open field, antenna to antenna. With the
    hub inside the house, masonry and metal in the way, and a barn full of wet
    leaf soaking up 2.4 GHz, the real range is closer to a few tens of metres
    and can be unreliable, which only an on-site test settles. An external
    antenna outside the house is the biggest single lever, and where obstacles
    are involved LoRa stops being a premium extra and becomes the right
    choice.
    Protecting the SD card against a power cut is not a battery job and is not
    measured in mAh - finishing a write needs under a tenth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
2026-07-22 Note the consumer CFTV P2P precedent
    Records the analogy the author raised: the remote relay planned here is
    the same pattern every consumer camera system uses to view over the
    internet. The device registers outbound by serial number, the phone asks
    the vendor server where it is, the server introduces the two sides, and
    traffic then flows peer to peer when hole punching works or through the
    server when it cannot.
    Two lessons worth keeping. Someone always pays for that relay - the
    manufacturer does, folded into the price - which confirms the earlier
    section. And this project's relay is far cheaper than a camera company's,
    because it moves tiny sensor readings rather than video, so if video c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
2026-07-22 Record the rejected router-as-server idea
    Keeps the reasoning for turning the producer's router into the hub, and
    why it was set aside, so the idea does not resurface and get re-argued.
    It is technically possible with OpenWrt, and fine for a personal
    prototype on a router you control, but it fails as a product: you do not
    control the customer's router, which in the countryside usually belongs to
    the internet provider and is locked; every house has a different model;
    and it does not solve the radio link anyway, since a router speaks only
    Wi-Fi, not ESP-NOW or LoRa, so an ESP node is still needed and may as well
    be the hub. The idea converges on the hub already chosen - a box the
    author build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
2026-07-22 Weigh Telegram as a free relay
    Records the author's idea of using the Telegram Bot API to avoid a paid
    cloud, and where it works and where it does not.
    The alert direction, hub to phone, works well and free, and is easy to
    call from an ESP32 unlike FCM, so it can carry the critical alert. The
    command direction, app to hub invisibly, hits a wall: the Bot API is
    bot to user, not a generic bus between two of your own programs, and there
    is no clean way for the app to inject a command the hub reads. The escapes
    each cost something - a user account that does not scale, making the
    producer use Telegram directly, or bringing back a server - and if a
    server is needed anyway the purpose-built MQTT r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
2026-07-22 Explain why remote access always needs a rented machine
    Adds the concept that grounds the whole relay discussion, so nobody
    concludes that a stronger server would solve remote access.
    A server is a role, not a kind of machine - the ESP already plays it. What
    matters are two independent axes: capability and reachability. A home PC
    outclasses the ESP on capability but sits behind the same NAT, so swapping
    one for the other buys nothing for remote. Render and a VPS are reachable
    because they live in a datacenter with a public address, not because they
    are powerful.
    So the hub never gets its own public address. The public address lives on
    a small rented machine that every hub connects out to -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
2026-07-22 Compare free relays, where connections are the limit
    Since the relay only passes readings and commands while history lives on
    the hub's SD card, it barely needs storage - at most a last value and a
    pending command per device. What limits it is simultaneous connections and
    message volume, not memory, which the author had already sensed.
    Lists the managed free tiers, around a hundred connections each, with
    Firebase Realtime Database noted because the project already uses Firebase
    and a command is just a write the hub listens for. And the self-hosted
    path, Mosquitto on an Oracle Always Free VM or a cheap VPS, which holds
    thousands of light connections at a fixed tiny cost and under the author'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
2026-07-22 Distinguish free FCM from the capped Firebase services
    The push service in use is free at any scale, with only technical limits
    the project never reaches - a four kilobyte message, per-device anti-spam,
    a high API quota. Worth stating plainly so it stays the piece not to worry
    about.
    The trap is treating Firebase as one thing. Only Cloud Messaging is
    effectively unlimited; the Realtime Database, Firestore and Functions each
    carry free-tier caps, and the database is the very service floated as a
    relay, so it would inherit the hundred-connection ceiling rather than the
    push's freedom. Enabling the pay-as-you-go plan keeps messaging free but
    starts billing the others past their quota. Recorded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
2026-07-22 Add a table for when to leave the free tier
    A planning aid so the move to a paid plan is made before anything breaks,
    with the principle of acting at about eighty percent of a limit rather
    than at the wall.
    Two tables, one per architecture. On the hub design the first paid step is
    far off, because the path runs free managed to free self-hosted on Oracle
    Always Free to paid, and the middle is free, so push and the SD history
    never limit and the relay connection count is the thing to watch. On the
    current Render and Supabase setup the wall arrives earlier and through
    storage instead. Each row names what to watch, where, the trigger and the
    action, and the note points at the providers' own usa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
2026-07-22 Note the seasonal use and how to pay only in season
    Records that the device is used mainly during the curing season, December
    to February or March in Rio Grande do Sul, roughly three to four months,
    confirmed by a quick search. Outside that window there is almost nothing
    to monitor.
    That is a cost advantage. Usage-based billing collapses to near zero off
    season on its own, flat monthly plans should be paused or downgraded, and
    the relay VPS can be destroyed and recreated each season because it holds
    no state, paying four months instead of twelve. Keeping the address stable
    with a domain or reserved IP and scripting the deploy makes the rebuild
    painless, and the edge-first design means local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
2026-07-22 Settle the sensor choice from the field photos
    Closes the sensor selection with what the photos and the author confirmed:
    temperature is a sealed DS18B20, and humidity, on a five metre unshielded
    cable in a barn with motors, comes down to two options the author asked to
    keep both. A RS485 Modbus probe is recommended because it is immune to
    noise and built to last a season, while a SHT31 with an I2C extender is the
    cheaper middle path that keeps the good element but needs the cable routed
    away from motor power and run as twisted pair.
    Records the caveats plainly: five volts fixes nothing because the interface
    is the problem not the supply, the cable must not run alongside motor
    power, the el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
2026-07-22 Sketch an automatic fire suppression option
    Records the author's idea of adding automatic fire suppression fed by a
    350 to 500 litre tank, with the engineering and the pitfalls that usually
    go unnoticed, and a clear note that it is beyond the thesis and, as a
    product, needs a fire-protection engineer and the relevant standards.
    The tank is framed honestly as buying a few minutes, not a full system.
    Pipe is split by zone, steel or CPVC inside the hot fire-exposed area and
    cheap PVC only outside, because ordinary PVC softens below the barn's own
    curing temperature. The nozzle section flags the real trap, that a common
    fusible head opens around the curing temperature and would soak the crop,
    s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
2026-07-22 Let the first setup happen from the home screen
    Configuring a device was only reachable from a greenhouse's monitoring
    menu, but on the very first setup the device is not on the network yet, so
    there is no greenhouse to register and no monitoring screen to open. The
    entry point sat behind the thing it was needed to create.
    It now also lives in the home app bar, reachable before any greenhouse
    exists, so the first configuration is possible: put the device in config
    mode, join its access point, open this from the home screen, and register
    the greenhouse afterwards with the name it reports. The in-menu shortcut
    stays for reconfiguring a device already on the network.
2026-07-23 Move device setup into the add-greenhouse flow
    The device setup entry sat as a loose icon on the home bar, which did not
    say how it related to adding a greenhouse. First-time setup is exactly when
    someone adds their first greenhouse, so the entry now lives at the top of
    the add-greenhouse screen, where a newcomer actually arrives, and the home
    bar icon is gone.
    It stays a link rather than an inline step because it cannot be one: the
    phone has to be on the device's own access point to configure it and on the
    property network to register the greenhouse, two different networks, so the
    first run is inherently two phases. The shortcut inside a greenhouse's menu
    stays for reconfiguring a device a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
2026-07-23 Signal config mode with a beep and the LEDs
    The setup instructions told the grower to wait for the display to read
    ConF, but the seven segment display cannot spell that legibly, so the cue
    was unreliable. Entering config mode now gives an unmistakable physical
    signal instead: a short beep and all three LEDs flashing together. The
    display shows four dashes while in config mode, a state clearly different
    from a reading without trying to write letters.
    The app instructions follow: they point at the beep and the LEDs rather
    than the display, and the line warning that Android would drop back to
    mobile data is removed. The setup docs and the firmware notes are updated
    to match, and the firmware v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
    [sentinela_esp32.ino]
2026-07-23 Match the save button to the add-greenhouse one
    The save button on the device setup screen used a darker green with white
    mixed-case text, while the add-greenhouse screen uses bright green with
    dark uppercase text. They now share the same style, so the two save
    buttons no longer look like they belong to different apps.
2026-07-23 Let the save buttons use the theme style
    The save buttons carried an explicit bright green with dark uppercase
    text, which stood apart from the start-batch button that just uses the
    theme default. Dropping the colour override lets both save buttons fall
    back to that same default, so the action buttons across the app now read
    as one style instead of a green outlier. The labels move to normal case to
    match.
2026-07-23 Drop the batch status badge
    The circle-and-icon badge beside the batch section was decoration. The
    started-on line already says whether a batch is running, so the badge added
    a flourish without adding information. Removing it leaves the section
    reading as text and a button, which is plainer and less busy.
2026-07-23 Tidy the greenhouse menu and add pull to refresh
    The menu icons were saying the wrong thing. Configure device used a
    two-arrows glyph that read as sync, so it becomes a gear. Prepare new batch
    used a plus that read as add rather than reset, so it becomes a restart
    arrow. Delete used the sweep variant while every other delete in the app
    uses the plain trash, so it now matches, and its subtitle drops to "Remove
    relatórios". The notifications subtitle is gone, and the configure subtitle
    loses its trailing "sem computador".
    Sync pending was awkward as a menu row. It is removed from the menu, stays
    available in connection details where a Sincronizar button already lives,
    and the more natural ge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
2026-07-23 Even out the notifications screen
    The toggles were green while every other control uses the theme colour, so
    they lose the override and fall back to it. The fire card drops its red
    border and the flame icon, so it reads like the other cards instead of
    being singled out, and its description becomes "sensor de incendio e
    temperatura muito elevada". The no-communication description is reworded to
    say the greenhouse stopped communicating and that it can be power or
    internet when the app is on cloud. The footer note shrinks to the point:
    the notifications are the app's, not the device alarm.
    The fire push follows suit and now names the cause, a flame at the sensor
    or a temperature that climbed t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
2026-07-23 Let the temperature alarm buzzer be turned off (firmware)
    Some growers cannot stand the intermittent buzzing during a batch, so the
    device now accepts a buzzerAtivo flag over the usual last-write-wins sync,
    persisted in NVS. Turning it off silences the ordinary temperature alarm on
    the device only.
    Fire is never affected. The flame sensor still sounds unconditionally, and
    so does an ignition temperature above 175 F, which is gated separately so a
    real fire is never muted. The push notification is a separate layer and
    keeps warning either way, so this quietens the shed, not the phone.
    The flag defaults to on and is reported in the status config, so the
    behaviour is unchanged until the app s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
    [sentinela_esp32.ino]
2026-07-23 Relay the buzzer flag through the server
    The device gained a buzzerAtivo flag; the server now carries it end to end
    so a phone away from the property can toggle it. Sync validation accepts
    the boolean paired with its timestamp, the target config holds it under
    last-write-wins, and the pending-command inbox already forwards the whole
    payload, so it only needed the field added to the timestamp map that clears
    a command once the device confirms it. A test pins the validation and the
    last-write-wins behaviour.
2026-07-23 Let the grower turn the device buzzer off from the app
    Completes the temperature-buzzer switch across the app. Opened from a
    greenhouse, the notifications screen now carries an "Alarme do aparelho"
    section for that device, a toggle that sends the buzzerAtivo command the
    same way a setpoint change goes. Opened globally from the home bell it does
    not appear, since a buzzer belongs to one device, which fits the plan to
    split global preferences on the home from per-greenhouse ones here.
    Turning it off asks to confirm and spells out what stays: fire still sounds
    on the device and the phone still gets the push, only the temperature siren
    in the shed goes quiet. The wording deliberately avoids say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
2026-07-23 Keep the Do Not Disturb card reachable once granted
    Once the app already had Do Not Disturb access the card dropped its button
    and became plain text, so tapping it did nothing and looked broken. The
    button now always shows: it grants the access when missing, and when the
    access is already there it opens the system settings so the grower can
    check or revoke it.
2026-07-23 Neutralise the Do Not Disturb card colours
    The card carried green or amber on its border, icon and button while the
    event cards above it are plain white on a neutral border. It now matches
    them: a white border, a white icon, and the button in the theme style.
2026-07-23 Recolour the batch picker to the theme
    The report batch picker used orange for its border, its selected rows and
    a flame icon, which stood apart from the rest of the app. The flame is
    gone and the accents move to the theme colour the buttons use, so the
    picker reads as part of the same system. The temperature and humidity
    figures keep their own colours, since those carry meaning.
2026-07-23 Standardise the confirm and delete buttons
    The delete dialogs used red text, the batch-delete screen used a red
    checkbox and a red primary button, and the prepare-new-batch dialog used
    green. They now use the theme style like every other button, so the action
    buttons across these flows read as one set. The confirmation dialogs still
    gate the destructive actions, so the red was decoration the confirm step
    already covers.
2026-07-23 Sketch the device provisioning design
    Records the plan for first-time setup so the reasoning survives to when it
    is built. Part one carries the mDNS name from the config success screen
    into a prefilled add-greenhouse form, which is cheap and independent. Part
    two has the device generate its own access key, reveal it only in config
    mode where holding the three buttons is the physical proof of presence,
    the way a router prints its password, and never in normal operation. Losing
    the key means re-entering config mode, with an option to regenerate.
    Getting the key to the cloud is the hard part and the writeup is honest
    about it: the server would move from one global token to a key per device,
    wh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
2026-07-24 Write the alerts in proper Portuguese
    The push notifications reached the grower stripped of accents - "Estufa
    sem comunicacao", "Parei de receber dados ha 24h". They were written that
    way out of caution in server strings, but these are the words someone
    reads on their phone at night, so they now carry their accents. The fire
    and test messages follow, and the return message says the greenhouse
    started communicating again rather than reporting.
    The device and simulator warnings go the same way, since they travel into
    the alarm notification body and the app screen. They also drop the
    shouting capitals, which read as noise rather than urgency. The JSON is
    UTF-8 throughout and the seven segment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
    [sentinela_esp32.ino]
2026-07-24 Finish standardising the dialog buttons
    Sweeping the app for coloured buttons turned up three the earlier pass
    missed: Remover on the greenhouse card, Importar in the backup dialog, and
    Voltar on the setup success screen. All three now use the theme style like
    the rest. What remains coloured are the app bar foregrounds, which are
    white text on a dark bar rather than buttons.
2026-07-24 Keep the dialog buttons on one line
    The fire dialog stacked its buttons while every other dialog kept them
    side by side. Nothing was configured differently: the two labels simply
    did not fit on one line, so the dialog wrapped them. Shortening them to
    Cancelar and Desligar, the same pair the device alarm dialog uses, puts
    them back on one line and makes the wording consistent too.
2026-07-24 Neutralise the setup instruction box
    The steps to follow before filling the setup form sat in an amber box,
    which read as a warning when it is only an instruction. It now uses the
    same neutral card styling as everywhere else.
    A sweep of the remaining amber and orange found only meaningful uses:
    orange stands for temperature in the readings, the chart and the panel,
    and amber or orange marks a state such as no signal, syncing, waiting for
    the device, or an event severity. Those stay, the same way the temperature
    and humidity figures kept their colours.
2026-07-24 Align the setup shortcut with its menu entry
    The shortcut on the add-greenhouse screen still carried the two-arrows
    glyph the menu entry dropped when it became a gear, so the same screen was
    reached from two different symbols. It now uses the gear as well, and the
    heading reads as what it is: the first setup of the device.
2026-07-24 Refine the provisioning design with key rotation
    Adds the author's refinement and the security correction it needs. The
    device knows it is the first run simply because the NVS has no key yet, so
    it generates one and keeps it, with no special first-config event. The name
    is already MAC derived, so it is permanent and unique for free and only
    needs to be shown, which simplifies part one.
    The key gets a nature of its own. It is permanent for convenience so it is
    not lost, but it must be regenerable, because a key that never changes
    leaves the previous owner with access after a sale. Config mode gains a
    generate-new-key option that locks the old owner out, and the device
    mediates the rotation w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
2026-07-24 Sweep the last decorative colour out
    A pass over the whole app for the conventions settled during the reactive
    fixes turned up little left, which is a good sign. The device name card on
    the setup success screen still used a green border and green text to
    highlight the address; that green carried no state, so it becomes the same
    neutral white as the other cards, with the copy button left to signal it is
    actionable. The web-only Editar hint drops its green too.
    What stays coloured is meaningful and untouched: green for a success check,
    red for an error or a fire or a lost connection, blue for humidity, orange
    for temperature, and amber for a pending or waiting state.
2026-07-24 Put destructive actions back in red
    Reviewing the assembled app, the choice flips: destructive actions read
    better in red, the industry convention that signals danger before the text
    is read. So delete and remove go red - the confirm buttons in the dialogs,
    the primary Apagar button on the batch-delete screen, and the two menu
    entries that lead there. Turning the device alarm off keeps the red it
    already had.
    The rule is deliberate about what stays neutral. Cancelar is the safe way
    out, not a destructive action, so it stays in the theme colour along with
    Salvar, Ajustar, Finalizar and the rest. Red marks only what destroys or
    switches off.
2026-07-24 Move the buzzer switch the instant it is tapped
    The device alarm toggle waited for the command to make the network round
    trip before it moved, so it felt frozen for a second or two, longer on
    cloud. It now flips immediately and sends in the background, reverting and
    warning only if the send fails, so the tap feels instant.
2026-07-24 Let the communication warnings expire
    When the phone has no internet, FCM holds a message and delivers it on
    reconnect. For a state warning that turns into a delayed scare: the producer
    gets "estufa sem comunicacao" together with the "voltou a se comunicar" that
    contradicts it, or worse, reads the alarm hours later and drives out for
    nothing.
    These warnings are only true while the state lasts, so they now carry a
    thirty minute lifetime and FCM drops what went stale instead of delivering
    it. Half an hour still reaches someone who spent a while out of signal and
    genuinely needs to know, without reviving yesterday.
    The fire alert deliberately has no lifetime and is still held indefinitely.
    A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
2026-07-24 Relay the local reading to the cloud
    There is a false alarm hiding in the most ordinary failure on a property:
    power is fine, the greenhouse is drying, the phone reads the device over
    Wi-Fi, but the property has no internet. The device cannot post, the cloud
    watchdog only ever sees absence, and after five minutes it warns that the
    greenhouse stopped communicating while the app on the same screen shows
    everything working.
    When the app is reading a device locally and has internet of its own, it is
    the only bridge available, so it now relays that reading to the cloud. The
    last-contact time stays fresh and the false alarm never gets born, which
    beats contradicting it afterwards. Whoever follows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
2026-07-24 Split the notification settings by scope
    The same notification screen was reachable from two places and behaved
    almost identically in both, which left no way to answer a real question:
    this greenhouse finished its batch, stop warning me about it, but keep
    warning me about the others.
    Scope now decides where a control lives. The screen reached from the
    greenhouse list stays global, holding the per-event switches, the Do Not
    Disturb card and the device siren. The greenhouse menu drops its copy and
    gains a single switch that mutes the app warnings of that greenhouse alone,
    with room under it to say what that means.
    Muting never silences fire, and never silences a device that went quiet.
    Those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
2026-07-24 Silence one siren from the device itself
    The app switch for the temperature siren is global on purpose, since nobody
    wants one greenhouse screaming while another stays quiet. That leaves the
    opposite case unanswered: this one greenhouse, right here, should stop.
    Holding only the buzzer button for three seconds now toggles its siren. It
    is the right place for the decision, because it is taken standing in front
    of the device, by someone who may have no phone, no signal and no internet
    in the middle of the field. The state persists in NVS and carries a
    timestamp, so it joins the same last-write-wins path as every other setting
    and the app catches up on the next reading.
    The other two buttons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
    [sentinela_esp32.ino]
2026-07-24 Quiet the siren the instant it is tapped
    The same lag the device alarm toggle had was still in the silence button,
    and it bites harder here: the siren is screaming next to the producer while
    the icon stays red waiting for the next reading to confirm, up to three
    seconds locally and longer over the cloud. The natural reaction is to press
    again, thinking the tap missed.
    The icon now goes quiet immediately and the command travels in the
    background, following the pending-adjustment pattern already used for the
    target: the optimistic state holds until a reading confirms it, and if the
    command never reached the device the icon comes back, since the siren really
    is still ringing.
    Fire is left out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
2026-07-24 Pull the batch report down to refresh
    The monitoring screen already refreshes by pulling down, so reaching for the
    toolbar button on the report screen is a gesture the app taught and then did
    not answer. It now refreshes the same way, with the button kept for whoever
    prefers to tap.
    Both paths run the same reload, and the pull awaits it, so the spinner
    closes when the data is actually there instead of vanishing early. All three
    states of the screen scroll always, including the empty one, otherwise the
    gesture would be dead exactly where content is short enough to fit.
    Most of the diff is the reindentation that wrapping the body causes; the
    change itself is small.
2026-07-24 Stop promising warnings the general settings turned off
    Muting a single greenhouse says underneath it that fire and lost
    communication still reach the phone. That sentence is only true while those
    two are enabled in the general settings, and the producer is free to turn
    either of them off for every greenhouse.
    The behaviour was already right: the per greenhouse mute starts from the
    global preferences and only switches the remaining events off, so it never
    turns back on something the producer disabled. Only the caption was lying,
    and a caption that lies about a fire alert is worth fixing on its own.
    It now reads the general settings and says what will actually happen,
    naming which of the tw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
2026-07-24 Say aparelho only when it means the device
    Three captions on the notification screen were reworded after reading them
    on a real phone.
    The Do Not Disturb footnote said the setting does not beat "o modo silencioso
    do aparelho", but everywhere else in the app aparelho is the ESP32 in the
    greenhouse, and that line is about the phone. Someone could read it as the
    greenhouse siren going quiet. It now names the celular.
    The device alarm card describes a switch that turns the temperature siren on
    as well as off, so it opens with liga e desliga rather than only the off
    half, and spells out that it covers every greenhouse registered in the app,
    which was the part worth being explicit about. The fir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
2026-07-24 Name both causes of the fire alert
    The alert titled "Incendio / chama" fires on two conditions, the flame
    sensor and a temperature high enough to mean fire, so naming only the flame
    described half of it. Title and description now carry both, and the
    description says acionado ou, which is what the firmware actually does.
    The intro at the top of the screen also grew a warning it was missing: no
    notification arrives while the phone itself has no internet. That is worth
    saying plainly rather than letting someone conclude the greenhouse went
    quiet. The three ideas - what to choose, that it covers every registered
    greenhouse, and the internet caveat - are split one per line, since run
    together th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
2026-07-24 Give the mute switch its own section
    Seen on a phone, the mute entry was the odd one out in the greenhouse menu.
    Its title ran to three lines and its caption to six while every neighbour
    had one of each, and the icon sank to the middle of all that height, out of
    line with the titles above it.
    It sat under CONEXAO too, which it never belonged to - silencing a warning
    says nothing about how the app reaches the device. It now has its own AVISOS
    heading between the connection entries and the quick actions.
    With the heading carrying the subject and the drawer header already naming
    the greenhouse, the title is just Silenciar avisos, and the caption drops
    the sentence explaining that a switch can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
2026-07-24 Fold the addresses into technical details
    The connection dialog opened with three network addresses in the producer's
    face, and one of them, Ativo, only repeated in machine language what Modo
    atual already said in words. Someone who wants to know whether the
    greenhouse is working reads none of that.
    None of it was a leak - the key is only ever reported as Configurada, never
    shown, and the addresses grant nothing on their own, since the server
    answers 401 without the key. The cloud address is the same for everyone and
    the local name is announced over mDNS to anyone already on the network. Even
    so, there is no reason for the device name to travel in every screenshot
    that gets shared for help.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
2026-07-24 Keep content out from under the navigation bar
    On the report screen the page ran under the phone's navigation bar. It only
    looks like a faint overlap, but that strip belongs to the system: anything
    landing there is not just dimmed, it stops accepting taps. A button at the
    foot of the page would be unreachable, and rotating the screen moves which
    content lands there.
    The report and the greenhouse list were the two screens whose body was not
    inside a SafeArea, so both get one. Everything else was already covered:
    monitoring, notifications, the greenhouse form and the device setup wrap
    their bodies, the batch deletion screen is held up by its own bottom bar,
    and the boot screens only ever cent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
2026-07-24 Drop the refresh button from the report bar
    With the pull gesture in place the toolbar button became a second door to
    the same room, and it was the one crowding the bar: a long title next to
    three icons. Monitoring, which the gesture was copied from, never had such a
    button, so the report screen keeping one was the odd case rather than the
    considerate one.
    The reload itself stays exactly as it was, now reached only by pulling the
    page down.
2026-07-24 Settle the batch card on one alignment
    The batch card stacked three alignments in a row: a centred heading, the
    status pinned left beside the button, and the supporting line centred again
    underneath. Read on a phone it looked knocked out of place, worst of all
    when "Nenhuma estufada em andamento" wrapped to two lines and pressed
    against the button.
    On phones the status and its supporting line now sit centred under the
    heading, and the button takes a row of its own across the width. The card
    grows slightly and gets a far larger target in exchange, which matters for
    hands in gloves, and the wrap has nothing left to fight with. Finalizar
    still asks for confirmation, so the wider button costs n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
2026-07-24 Hold the bell against the title, not the middle
    Shortening the caption had lined the bell up with the title, but only in the
    ordinary case. Whenever the general settings switched one of the two
    surviving warnings off, the caption explained why, grew to four or five
    lines, and the bell sank back to the middle of the row - the very
    misalignment the shortening was meant to cure. A fix that depends on text
    staying short is not a fix.
    The icon and the switch now anchor to the title, so the row stays lined up
    whatever the caption says.
    The exception captions also stop explaining themselves. What the producer
    needs at this switch is what will happen - only fire warns, or nothing
    warns - and that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
2026-07-25 Correct what the docs claim is missing
    The docs had drifted far enough to be misleading, which matters because the
    TCC gets written from them. The roadmap still listed push notifications and
    the Wi-Fi access point mode as future work, both delivered and one of them
    confirmed in the field. The ESP32 document had a section headed "nao
    implementado" describing static IP, which v1.10.0 added once a provider
    router with no DHCP reservation showed why it was needed. The handoff
    described firmware v1.9.0 while the tree is at v1.13.0. The push document
    opened by calling itself unimplemented and closed with a state section
    listing as pending the very screens that exist, still describing a power
    failu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
2026-07-25 Write down the cure schedule study
    Scheduling the target changes through the cure came up as an idea, and the
    study behind the answer is worth keeping whether or not it gets built.
    The finding that shapes everything: the device has no relay, so the target it
    holds is the alarm reference, not a command to the furnace. Scheduling it
    would keep the alarm in step with the phase instead of relying on the
    producer to remember - useful, and notably free of fire risk, since nothing
    in it adds heat.
    Of the three places it could live, the firmware is the right one, because a
    schedule that only works with internet contradicts the edge-first argument
    the project defends. Counting from the start of the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
2026-07-25 Add the scheduling screen and its local alarm
    The other half of scheduling an adjustment: the part the producer sees, and
    the reminder that reaches him.
    The reminder is a local alarm on the phone rather than a push, so it works
    with no internet at all - the common case out on the property - and it asks
    for an exact alarm to get through Doze, since a reminder to raise the heat
    that arrives late is no reminder. Where the exact permission is refused it
    falls back to the inexact schedule instead of losing the reminder outright.
    Rebooting clears system alarms, so the app re-arms everything on start;
    that duplicates the plugin's boot receiver on purpose, because not every
    manufacturer delivers BO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
2026-07-25 Drop the relative option from scheduling
    Offering "leave at" and "vary by" side by side gave two ways to say the same
    thing, and the second made the producer do arithmetic to know where he would
    end up. Only the absolute value remains, for humidity as much as for
    temperature.
    Both selectors now open on the target already in force rather than on a
    canned default, so the usual move is nudging a few degrees from where the
    greenhouse actually is instead of building the number from scratch.
    The plus and minus buttons are the ones from the adjustment panel, repeating
    while held at the same pace, so the gesture learned on one screen works on
    the other. That meant making the widget public rather t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
2026-07-25 Retry the cloud registration when signal returns
    Scheduling with no signal is the ordinary case on a property, not the
    exception, and until now it left the schedule crippled for good: the local
    reminder was armed, the cloud registration failed, and nothing ever tried
    again even if the phone found signal minutes later. Only half the feature
    survived, permanently.
    Registration is now retried when the app starts and when the scheduling
    screen opens, which is where someone who scheduled without signal tends to
    come back to check. The access key is not stored beside the schedule - it is
    a secret with no reason to sit duplicated on disk - so the retry reads it
    from the registered greenhouse.
    The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
2026-07-25 Stop a late schedule from undoing a newer decision
    Walking through what happens when each link fails in turn turned up two
    faults, both in the case where something comes back after the appointed
    hour.
    A schedule stamped the command with the moment it ran, not the moment it was
    meant for. If the server was down at 10:30 and returned at 14:00, the
    schedule fired then carrying a fresh timestamp, and last-write-wins handed it
    the argument against an adjustment the producer had made by hand at 11:00.
    The greenhouse would quietly go back to a target he had already moved on
    from. The stamp is now the scheduled hour, which lets the existing mechanism
    settle it correctly: what is newer wins, and a l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
2026-07-25 Ring for temperature the way the siren does
    Temperature outside the adjustment band reached the phone at notification
    volume, which is the volume people turn down at night - exactly when this
    warning matters and exactly when nobody is watching the greenhouse. It now
    rings like the device siren: alarm volume, the long tone rather than a beep,
    and past Do Not Disturb once that permission is granted. Fire and temperature
    are the two alerts worth getting out of bed for, and both are now sent at
    high priority so Android does not batch them into a quiet moment.
    Temperature gets its own channel rather than borrowing the fire one. Sharing
    would have made a drifting fire and a cold furnace sound ide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
2026-07-25 Make Tocar mean alarm, and only that
    The two switches on the notification screen now do what their names suggest.
    Notificar decides whether the message is sent at all; whether it beeps,
    buzzes or just slides into the shade is the phone's business, the same as any
    other app. Tocar decides one thing only: whether that message arrives as an
    alarm - the long siren, at alarm volume, past Do Not Disturb.
    It was wrong in both directions before. Turning Tocar off used to silence the
    notification completely, taking away a beep the phone's own settings should
    have governed; that channel is gone, and a warning with Tocar off simply
    travels on the ordinary channel. And the label read "Tocar / vibrar",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
2026-07-25 Write down the scheduling and the alarm channels
    Everything built since the last documentation pass, recorded while the
    reasoning is still fresh.
    The scheduling document was written when the feature was still a study of a
    multi-phase cure curve. Talking it through shrank the scope to something
    quite different - an alarm clock with an action, because most producers read
    the leaf to decide when to raise the heat and the table is a reference rather
    than a script. It now opens with what was built and why the work is split
    between phone and cloud, keeps the failure table for each link that can
    break, and preserves the original curve study below, since that analysis is
    what led to the smaller sha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
2026-07-26 Split fire into its two causes
    The fire alert covered two independent conditions under one switch: the
    flame sensor tripping, and the temperature passing the fire threshold. A
    producer who wanted to stop hearing about one had to give up the other, and
    the card had to describe both in a single line.
    They are separate events now, each with its own switches, its own Android
    channel and its own rising edge, so temperature crossing the limit still
    warns even when the flame sensor tripped first. Both remain critical: they
    ring like the siren and ask for confirmation before being turned off. The
    threshold stays at 175 F, and the description moves to the card it belongs
    to.
    Muting a greenhouse let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
2026-07-26 Give the scheduled reminder its own switches
    The reminder for a scheduled adjustment was the one warning with no card on
    the notification screen, so it could not be turned off from where every other
    warning is turned off - only by digging into the Android settings.
    It has a card now, and the switches keep the meaning they have everywhere
    else. Turning the notification off still schedules the adjustment in the
    cloud; only the reminder stops. Turning the ring on makes it arrive as an
    alarm, which is worth having for a reminder set at three in the morning to
    feed the furnace.
    The ring is the one default that starts off, on the producer's own reasoning:
    the alarm is for problems, and a reminde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
2026-07-26 Say what the reset actually resets
    "Preparar nova estufada" described an intention rather than an action, and
    the action is narrower than the name suggested: it puts the temperature and
    humidity targets back to 90 F and 100 percent. It starts no batch and clears
    no report. It is now called "Reiniciar ajustes do aparelho", and the line
    under it, along with the confirmation, says exactly which two values move and
    where they land. The confirm button follows the title.
2026-07-26 Separate what needs internet from what does not
    The scheduling screen said the phone warns without internet and the
    adjustment changes by itself, which was true but read as one promise, so the
    producer had no way to know which half to trust when the signal is gone.
    The two halves have different requirements and are now stated separately. The
    reminder is an Android alarm and arrives regardless of any network. The
    adjustment travels through the cloud, and if the phone never manages to
    register it before the appointed hour, or the device stays offline, it may
    not be applied at all.
    The menu line above it also switches from describing when to use the action
    to describing what it does, which is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
2026-07-26 Record the event split and plan around the field tests
    The push document still described three events and one fire alert. It now
    lists five, explains why the fire risk became two - independent causes, each
    with its own edge, so the temperature crossing the limit still warns after
    the flame sensor already tripped - and covers the scheduled reminder, whose
    ring is the one default that starts off.
    The new plan document exists because the honest next step is not a feature.
    Four firmware versions have never been flashed, the notification channels and
    semantics are new, and the scheduling feature was written today; all of it is
    correct on paper and unproven. So the plan opens with the field tests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
2026-07-28 Carry the setup straight into the registration
    First use asked the producer to read an address off one screen and type it
    into the next from memory, and sentinela-215788.local is exactly the kind of
    name that gets mistyped once and then debugged as a connection problem. The
    success screen now offers to carry the address and the key it just set back
    to the form, which fills both fields.
    Only when the setup was opened from the registration form. Reached from the
    menu of a greenhouse that already exists, the producer is reconfiguring what
    he has, and an invitation to register it again would be nonsense - so the
    button is behind a flag the caller sets rather than something the screen
    assumes.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
2026-07-28 Keep the saved key in step with the device
    Changing the key from the greenhouse menu left the app holding the old one.
    Every command after that came back refused as an invalid key, with nothing
    pointing at the cause - and the cause was an action the producer had just
    performed inside the app, two screens earlier.
    The success screen now offers to update the greenhouse it came from, and the
    saved address and key follow whatever was set. It is the same button that
    carries data into a new registration, so the flag became an enum: the caller
    says whether it is registering or updating, and the screen labels itself
    accordingly. Nothing is offered when the screen is opened on its own.
    The screen c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
2026-07-28 Apply a due schedule to the simulator too
    Scheduling against the simulator delivered the reminder and then quietly did
    nothing. The scheduler dropped every due command into the device inbox, but
    the simulator never reads that inbox - it is served from its own model inside
    the server, and only real devices come asking. The command sat there forever.
    That is the worst place for the gap to be, since the simulator exists so the
    whole system can be exercised without hardware: someone testing there would
    conclude the feature was broken. The sync route already made this distinction;
    the scheduler now makes it too, applying straight to the simulator and
    queueing only for real devices.
    A test pins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
2026-07-28 Give the mDNS probe time to resolve the name
    Opening the app with the device on the same Wi-Fi sometimes landed on the
    cloud for several seconds before switching to local. Intermittently, which is
    the shape of a timing problem rather than a logic one.
    The local address is an mDNS name, and resolving it happens inside the two
    second probe. On Android that first lookup after the phone wakes or rejoins a
    network runs past two seconds often enough to matter: the probe gives up, the
    resolver falls back to the cloud, and only the next round trip finds the
    device sitting right there on the same network.
    The probe now allows four seconds when the address is a name, and keeps the
    short deadline for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
2026-07-28 Stop overstating what the bypass permission buys
    Revoking the Do Not Disturb permission and testing again turned up the
    opposite of what the card claimed: the alert still rang. Do Not Disturb lets
    alarms through by default, and the critical warnings already play on the
    alarm stream, so they were passing through that door and never needed the
    permission to do it.
    There are two independent paths and the app controls only one of them. The
    permission is a guarantee for the producer who tightened Do Not Disturb far
    enough to block alarms too - not the thing that makes the alert audible.
    Saying that without it the fire alert "fica mudo" was scaring people into
    granting something they mostly alrea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
2026-07-28 Show the way back out of the Do Not Disturb permission
    Granting something the app offers no way to take back is a one way door, and
    the card had exactly that shape: it asked for the bypass and then went quiet
    about undoing it.
    The app cannot undo it directly. Android freezes a channel when it is
    created, and recreating one under the same id restores the settings it had,
    so a switch here would work sometimes and lie the rest of the time. What does
    exist is the system's own per channel screen, where every alert carries its
    own Ignore Do Not Disturb and its own sound - the producer has always been
    able to turn it off there.
    The card now points at that screen, alongside the in app route of tur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
2026-07-28 Drop the Do Not Disturb permission and just say what happens
    Three screens of explanation had piled up around a permission the producer
    was never going to reason about, and the last two commits were spent making
    its wording honest rather than making it useful. That is a sign the feature
    was wrong, not the wording.
    It is gone. What replaces it is one sentence in the footer - on silent or
    vibrate nothing rings, not even fire, while the greenhouse siren carries on -
    plus the amber card that already appears when the phone is actually muted,
    which is the moment the warning can still change something.
    The trade is small and worth naming. Without the bypass, someone who
    tightened Do Not Disturb f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
2026-07-28 Let the ten minute silence cover fire as well
    Fire was the one alarm that could not be silenced from anywhere: the button,
    the app, the three second hold, none of them reached it. The reasoning was
    that a fire alarm should never be switched off and walked away from.
    It still cannot be switched off. What it can do now is go quiet for ten
    minutes, the same as any other alarm, because by the time someone presses
    that button they already know - they saw the alert or heard the siren - and
    they are fetching water or calling for help with the thing screaming beside
    them. The deadline expires on its own and the alarm comes back, so silencing
    and forgetting remains impossible.
    One button, one behav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
2026-07-29 Catch the documents up with the device and the screen
    Three claims had gone false and one of them was the kind that gets repeated
    into a paper.
    Fire is no longer unsilenceable. It can be quieted for ten minutes like any
    other alarm, and only turning the buzzer off outright is still refused for
    it, since that has no expiry. The handoff, the ESP32 document and the
    greenhouse notes all said otherwise.
    The Do Not Disturb card is gone from the app, so the documents stop
    describing it as something the producer configures. What replaces it is the
    whole story: revoking the permission left the alert ringing, removing the
    alarm exception from Do Not Disturb left it ringing too, and the reason is
    tha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
2026-07-29 Catch the test plan up with what already happened
    The plan still opened by saying nothing had run on hardware and that the
    device was four versions behind, which stopped being true once the notifica
    tests ran and the producer flashed 1.13.0. Provisioning part one was still
    listed as work to do, and it was built two days ago.
    What remains is now stated as it is: the tests that need the greenhouse, and
    1.14.0 waiting to be flashed so the ten minute silence can be tried on fire.
2026-07-29 Sound fire continuously, both of its causes
    The flame sensor held the buzzer down while the fire temperature fell through
    to the same intermittent beep as an ordinary temperature alarm, which is the
    milder of the two things by a wide margin. Someone standing in the greenhouse
    without a phone had no way to tell them apart, and that contrast is the whole
    point of a siren out there: go look at the firewood, or run.
    Both causes hold the buzzer down now. The ordinary alarm keeps its beeping,
    and the ten second silence still covers everything, so this changes what the
    alarm sounds like and nothing about how it is quieted.
    The documents follow, including the state of the bench: 1.13.0 is on the
    d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
    [sentinela_esp32.ino]
2026-07-29 Let a new fire break through the silence
    Found in the greenhouse: silence the alarm, wait a minute, hold a flame to the
    sensor, and nothing happens. The ten minute silence was swallowing a fire that
    had not started yet.
    The argument for letting fire be silenced at all was that whoever presses the
    button has already seen it and gone to deal with it. That argument only covers
    the fire burning at the moment of the press. A fire that starts afterwards is
    news nobody has heard, which is the one thing the siren exists for.
    So the silence now photographs which causes were burning when it began, and
    anything beyond that cancels it outright. The two causes are tracked apart,
    since a flame on the se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
    [sentinela_esp32.ino]
2026-07-29 Agree with the server about what counts as fire
    The device called fire above a flat 175, while the server had long since let
    the limit follow the target - target plus five, once the target passes 170. Set
    the target to 172 and one of them raised the alarm at 175 and the other waited
    until 177. Nobody had noticed because nobody had run the greenhouse that hot.
    Following the target is the better of the two rules, so the device adopts it.
    There are only ten degrees between the hottest recommended working temperature
    and the limit, and the sensor sits in the hottest air in the building; asking
    for a high target on purpose should not earn a fire alarm for getting it.
    The comments stop quoting t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
2026-07-29 Stop letting an address decide which device a greenhouse is
    Two devices registered, one of them switched off in another house. Its stored
    address came round again on the network here and answered as the device here,
    and from then on the absent greenhouse displayed this one's readings, pulled
    from the cloud, which is about the worst way for this to go wrong: the numbers
    looked entirely normal.
    The app learned the hardware id from whoever answered at the address and wrote
    it over whatever it already knew. But an address is not an identity. Leases
    move, and separate networks reuse the same ranges, so the address saved for one
    greenhouse can later belong to a different device - including anothe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
2026-07-29 Show which firmware a device is actually running
    The device has been reporting its version all along and nothing kept it. The
    only way to ask which firmware was on a given ESP was to be on its network
    with a terminal, which is precisely what nobody has while standing in a
    greenhouse. Recent changes have been to alarm behaviour, so an out of date
    device does not merely lack features - it behaves differently during a fire.
    The server now keeps the version on the device row rather than the reading,
    because that is what it describes, and because the row survives both a restart
    here and the device being switched off - the two moments when there is no other
    way to find out. A reading that omits i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
2026-07-29 Hold the local connection through a single failed probe
    The card flickered between LOCAL and cloud within seconds on a healthy
    network. Resolving the mDNS name fails on its own now and then, and one missed
    probe was enough to switch the whole source of the numbers - so the reading
    jumped as well, since the cloud only knows what was last pushed to it.
    Two consecutive failures are now required before giving up on the device. If it
    really has gone, the following request fails and the forced re-resolution
    supplies the second failure, so the cost is one wasted request rather than a
    change of source.
    The connection details also name the device id the greenhouse reads. There was
    no way to answer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
2026-07-29 Refuse to save two greenhouses at one address
    This is the root of the mirroring: three greenhouses ended up reading the same
    device. The app learns which device a greenhouse is from whoever answers at its
    address, so a repeated address quietly makes two greenhouses into one, and one
    of them starts displaying the other's readings with nothing on screen to hint
    at it.
    Guarding the earlier symptoms - not overwriting a known id, refusing a reading
    from the wrong device - stops it spreading, but the address is where it starts,
    and saving is the only place to catch it. The greenhouse being edited does not
    count against itself.
    Existing duplicates still need untangling by hand, which the id field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
2026-07-29 Say when a greenhouse has no device, not that it is offline
    Clearing the learned id on an address change is the repair path, but it left
    the simulator's card reading OFFLINE with a crossed-out wifi icon. Nothing was
    wrong with the network. The app had no id to ask the cloud about, so it never
    asked - and it reported that as a connection problem, which sends someone
    hunting through wifi settings over an empty field.
    The card now says SEM ID with a question mark, and the connection details say
    the device is unidentified. A greenhouse reached locally is exempt, since it is
    about to learn the id from the device answering.
    The simulator is the case that has no way out on its own: there is no de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
2026-07-29 Read the device's siren state back instead of guessing it
    Holding the buzzer button for three seconds changes the siren on the device and
    the firmware does its part - it stamps the change so it wins the
    last-write-wins, and it reports the new state. The app never read it. The switch
    was an intention stored on the phone, so it went on showing the opposite of what
    was happening in the greenhouse.
    The switch stays global, since silencing one greenhouse's siren and leaving the
    others shrieking makes no sense, and a global switch cannot mirror devices that
    may each say something different. So the truth goes where the device is: each
    greenhouse's menu now shows what its own device reports, and sa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
2026-07-29 Require a probe answer to look like a Sentinela
    Any HTTP 200 counted as the device being present on the local network. An
    address can pass to something else entirely - a printer, a camera, the router -
    and anything listening on port 80 answers 200 with HTML. The app took that as
    the greenhouse and stayed there: no readings, because HTML does not decode, and
    no fallback to the cloud, because the probe kept insisting all was well.
    The probe on the root route already required decodable JSON. Only the /status
    one did not, so it now asks for a body carrying a status object.
    This came up while weighing whether to cache the resolved mDNS address as an IP
    to make the local probe fast again. That i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
2026-07-29 Give each device its own access key
    One global key authorised commanding every device, so a single leak handed over
    the whole property. Each device now generates its own random key and the cloud
    keeps them per device, which is what confines the damage to the device whose key
    leaked.
    Three decisions the design left open, settled here.
    Registration sits behind authentication rather than open. Trust on first use
    with an open route would let anyone claim an idHardware before the device did,
    and the id is not a secret - it comes back in every status response. Requiring
    the current credential keeps the anchor where it already is, with whoever holds
    the global key, and adds no new exposure. The d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
    [sentinela_esp32.ino]
2026-07-29 Record the power-loss test and the first key registered in the field
2026-07-29 Let the app carry a greenhouse's key to the cloud
    The device registers its own key, but the key also reaches the phone: the
    producer reads it in configuration mode, standing in front of the device, and
    that act is what anchors the trust. The app was already receiving it from that
    screen and keeping it locally, so it may as well pass it on.
    Saving or editing a greenhouse that has both an id and a key now sends the pair
    up. Best effort on purpose - whoever is registering a greenhouse must not watch
    it fail over this - and both routes land on the same trust-on-first-use, so
    whichever arrives first settles it.
    It goes to the cloud explicitly rather than through the resolved connection: the
    rou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
2026-07-29 Stop the greenhouse siren from deciding whether the phone is told
    Turning off a device's siren also stopped the phone being warned about
    temperature leaving the range. The cloud was reading alarmeAtivo, which the
    firmware computes as whether the buzzer is sounding right now - false once the
    siren is off, or during the ten minute silence.
    Those are separate channels. Switching off the noise in the greenhouse is a
    request about the noise in the greenhouse; the phone warning has its own
    preferences screen, and this quietly overrode whatever was set there without
    saying so anywhere.
    The firmware now reports alertaTemperatura, the condition itself, alongside
    alarmeAtivo, the siren state. The cl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
    [sentinela_esp32.ino]
2026-07-29 Authenticate a key change with the key being replaced
    Changing a greenhouse's key took it offline. The app was sending the new key as
    both the credential and the payload, and a freshly invented key authenticates
    nothing, so the cloud refused both ends at once: the registration and every read
    after it.
    What the app could do was re-present a key it already held. It could not swap
    one. Whoever proposes a new key has to prove they hold the current one, which
    means reading the previous key before overwriting it and authenticating with
    that.
    With nothing stored yet the plain registration is enough, since trust on first
    use accepts it from an authorised caller. When the cloud already holds a
    diff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
2026-07-30 Hand the key from device to app without anyone reading it
    The producer had no use for the access key and every sight of it was a chance to
    mistype or leak it. The device now serves its identity - id, local name and key -
    on a route that answers only in configuration mode, so holding the three buttons
    is what authorises the handover, and the mode times out on its own. In normal
    operation the route does not exist and status still says only whether a key is
    set. The form served by the device stops arriving with the key filled in.
    The app reads it there, keeps it in memory and carries it to registration
    without ever showing it. Where the device has no key of its own - firmware
    before this one -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
    [sentinela_esp32.ino]
2026-07-30 Carry the device id into the greenhouse being registered
    The configuration screen asked the device who it was and then used only two
    thirds of the answer. The id came back alongside the name and the key and was
    dropped, so a greenhouse registered through the new flow was born without one -
    reading SEM ID, and unable to fetch anything from the cloud until it happened to
    make a local connection and learn the id the long way round.
    It now travels with the address and the key, which is the whole point of asking
    the device in the first place.
    The Wi-Fi password field also gets a reveal toggle. Rural network passwords tend
    to be long and full of digits, typing one blind invites a mistake, and th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
2026-07-31 Warn that a fixed address has to belong to the network
    The example address was written as though every home network used the same
    range. They do not, and copying it onto a network numbered differently puts the
    device on a network of its own, where it can no longer find the router - it
    simply stops answering, with nothing to say why.
    The help now says which part of the address is the producer's to choose and
    where to read the rest: the phone's own address on the same wifi. Saving is
    refused outright when a fixed address and a gateway are given in different
    ranges, since that combination cannot work and the failure would otherwise
    surface long after, looking like a broken device.
    Gateway and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
2026-07-31 Learn the gateway and mask instead of asking for them
    Two fields asked the producer for numbers he has no reason to know, and the
    device had been told both by the router already. It now keeps what DHCP hands
    it and uses that when a fixed address is set without them: informed value first,
    then what the router taught it, then the guess.
    The guess was the reason the fields could not simply be deleted. Assuming .1
    breaks a network whose router sits on .254, and it breaks it quietly - the local
    network keeps working while the cloud goes silent, with nothing on screen to
    connect the two. Since a fixed address is a fallback reached after the device
    has already joined the network, the learned value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
    [sentinela_esp32.ino]
2026-07-31 Fill in the part of the address nobody should have to know
    Only the last number of a fixed address is anyone's choice; the rest belongs to
    the network and copying an example instead of it is what breaks the setup. The
    phone cannot work the range out for itself - during configuration it is on the
    device's own access point, not the house network.
    The device can. It already keeps the gateway the router hands it, so it now
    passes that along with the rest of its identity, and the field arrives with the
    range in place and the cursor after it.
    A field holding only the range counts as empty when saving. Sending a bare
    prefix would be an invalid address, and the device would quietly fall back to
    DH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
    [sentinela_esp32.ino]
2026-07-31 Fold the reachability check into the action it protects
    As its own button the check only worked after leaving the app and switching
    networks. Pressed at the moment it invites being pressed, it failed every time,
    and a button that fails when it obviously should not teaches people to distrust
    the screen around it.
    It now runs inside the action it was protecting. Continuing looks for the
    device first; if it does not answer, the screen says so and pressing again goes
    ahead anyway. The producer decides, which is right - the device may simply still
    be rebooting, and refusing to register a greenhouse over that would be worse
    than one to check on later.
    The address card leaves this screen when the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
2026-07-31 Complete the device name so it can actually be resolved
    The device announces itself on the network as sentinela-xxxxxx.local but reports
    its name without the suffix, and the automatic handover started using that
    answer as the address. A name with no .local is not an mDNS name: the system
    tries ordinary DNS, which nothing on a home network answers for it. The local
    connection simply never happened, and the cloud working covered for it.
    It worked before because the full name was typed by hand.
    The suffix is completed where addresses are turned into URLs, which repairs the
    greenhouses already saved without it - nothing to edit. Only names beginning
    with sentinela- are touched, and a port is k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
2026-07-31 Show whether a greenhouse is actually being watched
    A greenhouse nobody is subscribed to looks exactly like one that is. Registering
    for warnings is best effort, fired and forgotten, so a failure left no trace
    anywhere on screen - which is how a device sat offline for a day with no warning
    sent, and how it took a look at the cloud's own tables to notice.
    The result of each registration is now kept, and the greenhouse's menu says
    plainly whether this phone will be told. Two failures read differently because
    they are fixed differently: a greenhouse that does not yet know which device it
    belongs to can never be watched, and one that simply could not reach the server
    needs another try with inte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
2026-07-31 Give the app a second door to the device
    The mDNS name was the only local way in. When it failed - a missing suffix, a
    router or a phone that will not resolve .local - nothing was left, and the cloud
    working covered for it, so a greenhouse could sit on cloud readings for days
    while the device stood two rooms away.
    The device now reports its own address with every reading. The cloud keeps it in
    the column that was already waiting for it, and the app treats it as a fallback
    candidate. The name still comes first, deliberately: it survives a change of
    address and the address does not.
    The app remembers it between sessions too, because the moment it matters is a
    start with no cloud and no name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
    [sentinela_esp32.ino]
2026-07-31 Keep asking the device who it is until it answers
    The screen read the device once, when it opened, and the instructions on that
    same screen tell you to join the device's network afterwards. Followed in the
    order it teaches, the read always failed, and nothing tried again: no name, no
    id, no key, and the registration form back to asking for a key by hand - the one
    thing this flow exists to avoid.
    It now retries every few seconds until the device answers.
    The two reads are also independent again. A failure fetching the name was
    returning early and skipping the identity read, which is the one that carries
    the key.
    And the key field says where the key comes from. Someone told to enter a key
    w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
2026-07-31 Say whether the screen is talking to the device
    Opened from a greenhouse's menu, the configuration screen looks broken: the
    fields are empty, the key is asked for again, and the address range is not filled
    in. Nothing on it says why, so the reasonable conclusion is that the screen is
    out of date - which is exactly the conclusion that was reached.
    The real reason is that the phone is still on the house network and there is
    nothing at the device's address to answer. Now the screen says so, and says that
    it completes itself once the phone joins. Since the read repeats on its own, the
    notice turns green without anyone doing anything else.
    Not knowing whether you are connected is the same shape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
2026-07-31 Confirm the PIN instead of firing on the fourth digit
    Typing the last digit started the exchange while the keyboard still covered the
    screen, with nothing to say anything had begun. Confirming from the keyboard now
    starts it, and the keyboard leaves once the device answers.
    Behind that, something worse. The read repeats every three seconds, so a wrong
    PIN would have been sent again and again, spending all five of the device's
    attempts within fifteen seconds - the app blocking the pairing by itself, with
    the producer having typed once. A PIN that already failed is not sent again.
2026-07-31 Let one phone invite another to the same greenhouse
    Several phones could always command a greenhouse - the key belongs to the device,
    not the phone - and warnings were already per phone with their own preferences.
    What was missing was the second phone getting the key. The only route was
    configuration mode, which takes the device off the air while it lasts; asking a
    family member to walk to the greenhouse and interrupt monitoring to install the
    app is a poor trade when someone already trusted can simply pass it on.
    The greenhouse menu now produces an invitation and hands it to the system share
    sheet, so it travels by whatever the family already uses. On the other phone,
    adding a greenhouse o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
2026-07-31 Drop subscriptions for greenhouses the phone no longer has
    Deleting one at a time was not enough. The delete that follows removing a
    greenhouse can be lost - no internet, a stale key - and nothing tried again, so
    the watchdog went on watching a device belonging to no greenhouse at all, with
    nothing anywhere to show it.
    The phone now tells the cloud which greenhouses it follows, and the cloud
    discards the rest of that token's subscriptions. Orphans are cleared whatever
    caused them.
    A missing list is refused rather than read as "none", since that would empty the
    table on a malformed request. An empty list is accepted, because a producer who
    removed their last greenhouse means exactly that. O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
2026-08-02 Lift the whole drawer out of the monitoring screen
    The screen is where most of this week's field faults appeared, and the menu had
    become a screen inside it. The drawer now lives on its own, reusing the three
    read-only items taken out earlier, and the screen loses two hundred and sixty
    seven lines along with five methods that only existed to build menu entries.
    The coupling was real and remains, but it is now declared rather than implied:
    eleven values and three callbacks, grouped into two objects instead of thirteen
    loose positions. Anyone reading the constructor can see what the menu depends
    on.
    The other way - leaving the stateful items behind and passing them in ready
    made - was turned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
2026-08-02 Cover the seam where the wrong key would look entirely normal
    The key and the device id are both optional strings, passed from one object into
    another. Swapping them compiles, analyses clean, and draws a code that looks
    exactly like a correct one - handing someone else's phone the wrong credential.
    Nothing in the tests touched that hand-off.
    Two tests now open the drawer, tap through to sharing, and check the four fields
    one by one, then again through the round trip. Proved by swapping the two
    arguments and watching only these fail while everything else stayed green.
    It is the most expensive way this feature can fail and the least visible.
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2026-08-03 Let an invitation update a greenhouse instead of being refused
    An invitation could only ever create. When the key had been regenerated on the
    device and someone holding the new one sent it across, the guard recognised the
    device and refused - correctly, and into a dead end, because no other path
    carried the new key in.
    Same device plus an invitation now offers to update. Typed by hand it still
    refuses: a key someone types is a guess, while an invitation comes from
    somebody who holds the real one.
    It never writes on its own. A key overwritten wrongly silences the greenhouse
    until someone walks to the device, and nothing on screen would connect the two
    afterwards, so the confirmation names t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
2026-08-04 Record the distances, which undercut the case for radio
    The plan was sized for kilometres. The greenhouses are ten to fifty metres from
    the house, through two or three walls, and the household wifi already reaches
    two of them through those same walls. At that scale the radio link solves a
    problem that is already solved, and an access point costs less than a hub while
    needing no new protocol, no binary frame, no radio authentication and no card -
    with the firmware now running in a greenhouse untouched.
    Better to say so at the top of the document than to let someone read seven
    hundred lines first.
    What survives is narrower and real: the properties that run past fifty metres,
    and independence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
2026-08-04 Separate the two radio legs, which are nothing alike
    The plan sized one link and the answers revealed two. Hub to greenhouses is ten
    to fifty metres through a couple of walls, and household wifi already covers most
    of it - too close for radio to earn its place on its own. House to the grower out
    in the fields is kilometres, with no mobile data, and nothing in the system
    reaches that far: the app needs either the house wifi or a carrier, and out there
    neither exists.
    Dismissing the kilometres was wrong. They are the leg that justifies the whole
    idea, and the previous note said the opposite because it read both legs as one.
    That changes what the hub is. Not the thing that collects the greenh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
2026-08-04 Cancel the greenhouse form without a result, not with false
    Cancelling handed back a boolean to a route that now returns what the form did.
    The conversion fails after the route has already been marked as closed, so the
    screen never leaves: no back arrow, cancel does nothing, and every later attempt
    to close reports that there is no route left to close. Saving worked and then
    died on the way out, which is why it looked like saving was broken.
    Cancelling produced no result, so the honest value is the absence of one.
    The reason this took a day to find is the second change here. The failure was
    caught and discarded, leaving a message that named no cause - nothing on the
    device, nothing in the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
2026-08-04 Let the demonstration greenhouse be seen without a key
    Registering the simulator failed for want of a key nobody could know: it has no
    device to read one from, and the one the cloud held was the shared key. The
    button that fills the form could not invent it either.
    So the requirement goes instead. The simulator's readings are invented by the
    server, there is no greenhouse behind it, and commanding it moves nothing but
    the demonstration. Asking for a secret to see fabricated data protects nothing
    and costs everything - it was the only thing standing between someone and a
    demonstration. The exemption names that one identifier; real devices keep the
    rule.
    With that, no path into the registrat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
2026-08-04 Name the two shortcuts after what the grower is doing
    One described the app's job rather than his - and claimed to be the first
    configuration, though the same screen also reconfigures a greenhouse that has
    been running for weeks. It now says it connects the device to the wifi, which is
    true on both occasions and is the thing actually being done.
    The other asked him to know what a simulator is. Its own description already
    said demonstration, so the title was a second word for one idea. It says
    demonstration too.
    Neither changes behaviour; the tests that reach these shortcuts follow the new
    wording.
2026-08-04 Give the configuration screen two honest phases
    The warning sat above the instructions and announced that the device could not
    be found before a single step had been taken. Read first, it says something is
    broken; it convinced the grower twice that the device's wifi had failed when
    nothing had been attempted yet. Not having tried is not the same as having
    failed, and the screen now says which of the two it is: waiting for the PIN,
    found, or tried and missed.
    The instructions come first, since they are what to do about it.
    Below the PIN, the screen used to change shape on its own. Fields stood there
    from the moment it opened, the key field vanished once the PIN went in, and the
    fixed addres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
2026-08-04 Stop asking the grower for a key only the device knows
    The field survived as a fallback for firmware older than the identity route, so
    an old device would not be left without a path. It was the wrong trade. The key
    belongs to the device, which generates it; the grower has never seen it and has
    nowhere to look it up. A box asking for it reads as a broken app, and whatever
    gets typed there is written over the good key - which is how the device went
    silent for a day on 31/07.
    The fallback also did not work. Firmware without the identity route predates the
    firmware that treats an empty key as "keep the current one", so saving from here
    wipes it either way, typed or not.
    So a device that cannot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
2026-08-04 Ask for the wifi password every time, and stop mentioning the key
    "Leave empty to keep the current password" was written for someone changing only
    the network name. That is the rare visit. The common one is the first setup,
    where the same line invites skipping the field entirely and the device comes up
    without a password at all. Requiring it costs a retype in the rare case and
    saves building a second screen for it.
    The device still keeps its stored password when it receives an empty one; the
    app just never sends one now.
    The reassurance about the key went with it. It answered a worry the grower does
    not have - he was never told a key exists, and "you do not need to type it"
    mostly raises t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
2026-08-04 Say what an empty wifi password means, without demanding one
    Requiring it would have left an open network with no path through the app, so
    the field stays optional. What was wrong was the label. "Leave empty to keep the
    current password" describes a return visit to change only the network name - the
    rare trip - and on the first setup, which is the common one, it reads as
    permission to skip the field.
    It now says to fill it in, and that an open network is the one case to leave it
    alone.
    The device still reads an empty password as "keep the one I have", which is a
    different meaning from the one this label promises. It only diverges on a
    network that genuinely has no password, on a device tha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
2026-08-04 Let a device be told the network has no password
    An empty password field has always meant "keep the one you have", which is what
    someone returning to change only the network name wants. It leaves no way to say
    the opposite - that the new network is open - and the device would keep the old
    password, try it against a network that has none, and fail to associate with
    nothing anywhere explaining why.
    The two meanings now have two fields. semsenha=1 stores an empty password
    deliberately. The browser form carries a checkbox for it, and the app sends it
    whenever its password box is left blank, since that is what its label promises.
    Absent behaves exactly as before, so an older app or form still w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
    [sentinela_esp32.ino]
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2026-08-04 Make the three-button hold something you can feel happening
    Holding all three for three seconds worked or did not, seemingly at random, with
    nothing to tell the difference. Three things were behind it. The reading was
    raw, the only place in the firmware without debounce, so one chattering contact
    or one finger sliding reset the whole count. Nothing was shown before the three
    seconds elapsed, so a count that restarted at 1.2s looked identical to one about
    to finish. And the check ran after the cloud calls, each of which parks the loop
    in an HTTPS handshake for a second or two - press during one and you are noticed
    only when it ends, with the count starting from there, so a genuine three-secon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
    [sentinela_esp32.ino]
2026-08-04 Only mention push registration when it is missing
    The line announced "notifications on this phone: active" every time the drawer
    opened. A grower does not know a push subscription exists, cannot act on one,
    and reading that it is active mostly raises the question of when it would not
    be. The confirmation is wanted by whoever is chasing a fault, and for them the
    absence of the line says the same thing.
    What it was built for is the opposite case - a greenhouse nobody is subscribed
    to looks exactly like a subscribed one, which is how a device sat dead for a day
    with no alert - and that still shows, in orange, in the grower's words rather
    than the system's.
    Its instruction had also gone stale: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
2026-08-04 Reduce the sharing screen to the decision the grower makes
    Three paragraphs explained that the invitation carries the greenhouse key, that
    whoever holds it commands from anywhere, and why the QR is the only route. All
    true, and all about a mechanism the grower was never told exists - so it
    explained a machine in order to justify a rule, when the rule is the only part
    he decides anything about. One line now: share it only with people you trust,
    because whoever has this greenhouse in the app can command the device from
    anywhere.
    "Who is beside you" labelled a card that no longer has an opposite - the written
    invitation for people far away is gone - so it was a heading over nothing. And
    "no re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
2026-08-04 Stop the report accusing humidity of something it cannot do
    Humidity triggers no alarm anywhere - not on the device, not in the cloud, not
    in push - but in the curing report it carried the same red mark as a critical
    temperature, sitting among lines that say "alarm raised" and "alarm cleared".
    Read there, a run looked like it had emergencies it never had. In a drying
    greenhouse humidity sitting far below the setpoint is the point of the process.
    Humidity oscillation is now recorded rather than judged: a grey mark, no
    severity it has no authority to claim. The reading is still written down, with
    the distance from the setpoint, because that is worth knowing at the end of a
    run - it just no lo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
2026-08-04 Target Android and iOS, and nothing else
    The browser build was never used in the field and could never tell this system's
    story: in a browser there is no local network with the device, so it would have
    been the cloud half of an edge-first project. Keeping it cost a hand-written
    in-memory database, a second copy of that same fallback inside the native
    storage service, three _web/_io/_stub trios, five _web models and a separate form
    input path.
    The cost stopped being theoretical earlier today. Removing the backup meant
    editing both halves of storage, and the automatic removal took the history
    retention method on the web half with it. The half nobody ran nearly broke
    retention for the half eve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
2026-08-04 Configure iOS for the things that fail silently
    None of what was missing would have stopped a build. The app would compile,
    install, open, and then never find a device and never open an invitation, with
    nothing on screen saying why - so it is written now, while the reasons are
    fresh, rather than discovered on whatever day someone first has a Mac.
    iOS 14 blocks the entire local network for an app that has not declared why it
    wants it, which means no mDNS and no direct IP either. For a project whose whole
    argument is that it keeps working when the internet does not, that is the half
    that matters going dark while the cloud half keeps pretending everything is
    fine. The Bonjour service the firmw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
2026-08-04 Make the app agree with the device about where fire starts
    The banner painted an emergency at a fixed 175F. Firmware and server stopped
    using a fixed number when curing above 170 turned out to be a real practice -
    the limit follows the target once the target is high - and this widget never
    followed. With the target at 180, device and cloud stay quiet until 185 while
    the screen has been solid red since 175, on a greenhouse doing exactly what it
    was told.
    The rule now lives in one place on this side, next to a note naming the other
    two implementations and the day they last disagreed, because three languages
    cannot import from each other and the device has to decide alone.
    ApiService takes an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
2026-08-04 Cover the two route files that decide whether a night goes unwatched
    Schedules and push registration came out of the 993-line router into files of
    their own, and the tests stayed pointed at the whole. Both are places where
    failure is quiet: a schedule accepted and then forgotten means the grower sleeps
    through an adjustment he set, and a greenhouse with nobody subscribed looks
    exactly like a subscribed one - which is how a device sat dead for a day.
    So the assertions are about the honest answers rather than the happy path.
    Without a database a schedule is refused, not accepted and lost. Registration
    without persistence still returns success but says registered:false, which is
    the field the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
2026-08-05 Ask for the display PIN before writing, not only before reading
    The PIN was added because the configuration access point is open: anyone within
    wifi range during those five minutes could ask for the device's identity and
    walk off with its key. The route that hands the key over was protected. The route
    that overwrites it was not - /salvar changes the network, the address and the key
    itself, so the same person could have taken the device rather than merely
    copied it.
    The check is one function now, used by both. Kept apart they would drift again,
    which is exactly what happened the first time.
    The browser form gained a PIN field, placed first: finding out it was required
    after filling everythi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
    [sentinela_esp32.ino]
2026-08-05 Write down the three security limits we chose to keep
    Certificate validation, the global token and the missing audit trail were all
    weighed and left alone, which is a different thing from not having noticed them.
    Undocumented, the next person finds them and either believes nobody looked or
    "fixes" the first one - and pinning a CA on a device that keeps time by NTP buys
    a silent radio after a long outage in exchange for stopping an attacker who would
    have to sit on the network path out in the fields. The reasoning is recorded next
    to each, along with what the real fix looks like.
    The tool's local settings file was only ignored by a global gitignore in one
    machine's home directory. It belongs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
2026-08-05 Let the grower close configuration mode, and close it when it is useless
    Five wrong PINs kill the PIN, and both routes that do anything require it - so
    what stayed on the air was an open access point that could no longer serve
    anybody, until the five minute timer ran out. It restarts as soon as the PIN
    dies.
    There was also no way to give up. Holding any button for a second and a half now
    leaves, with two beeps, because the alternative was standing in the greenhouse
    waiting. Holding rather than tapping: the device sits where people work, and a
    knock during setup would cost the three-button hold and rejoining its network
    again. It only starts counting once every button has been released, sinc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
    [sentinela_esp32.ino]
2026-08-05 Stop the app spending the grower's attempts, and say when they run out
    Only the last rejected PIN was remembered, so alternating two wrong numbers sent
    each one again: type 1111, then 0000, and the 0000 costs a second attempt on the
    device for a number the app already knew was wrong. Five attempts exist for the
    grower to get it right, not for us to spend. Every rejected PIN is remembered
    now.
    When they do run out, the device blocks the PIN, restarts and leaves
    configuration mode - the display goes back to normal and its network
    disappears. The app said so in the hint under the field, which is where it went
    unread, and then fell through to "I could not find the device with that PIN",
    which s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
2026-08-05 Trim the blocked-PIN card to what the grower does next
    Two sentences were the screen talking about itself. That typing here leads
    nowhere is already shown - the field is gone. That the old PIN no longer works
    is implied by there being a new one on the display, and spelling it out invited
    the reader to wonder whether the old one might have.
2026-08-05 Stop the retry clock talking over the attempts count
    The screen retries every three seconds, because it tells people to join the
    device's network after it has already opened. That retry was reaching the
    "this PIN already failed" branch and rewriting the message underneath the
    field - so the line saying how many attempts were left vanished on its own,
    three seconds after appearing, without anyone touching anything. The count is
    the one number that matters there.
    The retry is silent now. Only an actual press answers, since only an actual
    press asked.
    The count also reads as what remains rather than as a parenthesis after the
    sentence, where "(4 tentativas)" could just as easily have meant fo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
2026-08-05 Ask once before writing an empty wifi password
    An empty password now deliberately means the network is open, and the device
    stores nothing. On a network that does have one it then cannot join, disappears
    from the cloud and the greenhouse reads SEM SINAL - with nothing on any screen
    connecting that to a field left blank minutes earlier. It happened on the first
    day the flag existed.
    So it asks, naming the network, and says what goes wrong if the answer is no.
    One dialogue against a failure whose cause is invisible by the time anyone
    notices it.
    The PIN message also stopped losing the number that matters. Confirming again
    right after a wrong PIN - which on many phones is just what closing th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
2026-08-05 Write down the revocation flow before it is built
    Three conversations converged on a design and none of it was written anywhere,
    which is how a decision survives as screenshots until somebody re-derives it
    wrong. Nothing here is in the code, and the document says so at the top.
    Two things it fixes about the obvious version. The device restarts immediately
    after saving, so an app that expects to read the new key afterwards is designing
    a second trip to the greenhouse with a second three-button hold - the key has to
    come back in the save response. And keeping the previous key to prove possession
    during cloud rotation is already implemented, on both ends, so nobody rebuilds it.
    One promise is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
2026-08-05 Let the grower revoke shared access from the app
    Rotating the key already worked, hidden behind "advanced" in a form on the device
    that nobody opens. The path existed and was invisible, which is the same as not
    existing on the day a QR code reaches the wrong person. It is now next to
    "Compartilhar acesso", where someone would look, and named for what it does
    rather than for the mechanism: the key is not the grower's vocabulary.
    Two things in the firmware made it possible without a browser. The identity route
    returns the current SSID, so the app can resend the same network - saving refuses
    an empty one, and inside configuration mode the phone cannot see the house
    network to type it. And savi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
    [sentinela_esp32.ino]
2026-08-05 Do not let a reachability probe swallow the new key
    The confirm step probes the device by name before handing its details back,
    so nobody registers a greenhouse at an address that never answers. After a
    revocation that probe is guaranteed to fail: the phone is still on
    Sentinela-Config, which disappeared when the device restarted. The function
    returns without popping, and the new key - which exists only in this screen's
    memory, because the device has already restarted and will not hand it over
    again - dies with the screen. This phone would be locked out along with the
    others, right after an action that looked like it succeeded.
    The address did not change during a revocation. Only the key di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
2026-08-05 Report the firmware version on /status as well
    Every other way the device describes itself carried the version - /dados and the
    push to the cloud both have it - but /status did not, and /status is what the app
    reads while it is on the local network. So the connection details said "Firmware:
    Desconhecida" precisely during a direct connection to the device, which is where
    the question of what is flashed on it actually comes up. It read as the app
    failing to ask.
    [sentinela_esp32.ino]
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2026-08-05 Write down what selling the device actually requires
    The path already exists - the ordinary first-time setup plus a revocation - but
    was never described, and the part that matters is the part nobody would guess:
    configuring changes nothing about who holds the key, so until the new owner
    revokes, the seller still commands the greenhouse over the internet from
    wherever he is.
    Order matters too. A seller who revokes before handing it over accomplishes
    nothing, since the buyer reads the new key off the device anyway and the seller
    held it in the meantime. Whoever stays is the one who revokes.
    Two things revocation does not fix are named rather than glossed: push
    subscriptions are per phone and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
2026-08-07 Do not burn a PIN on a request that never left the phone
    Typing the PIN before joining the device's network killed that number for the
    rest of the visit. The request failed with no reply, but the PIN was already
    marked as tried, and the guard against resending it - which exists so the
    three-second retry does not spend the device's five attempts - then applied to an
    attempt the device never saw. Joining the network afterwards changed nothing;
    only leaving the screen and coming back did. An attempt that did not arrive has
    not been spent.
    The message was pointing the wrong way too. It said the device could not be
    found "with that PIN", which sends someone to check a number that was correct.
    Wh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
2026-08-07 Finish adapting the screen to the mode that writes nothing
    The access-only mode inherited the configuration screen's guidance the same way
    revocation did, and I did not sweep it when I built the mode. It told the grower
    to fill in the house network below a screen that has no fields, and promised that
    the rest of the screen would complete itself when nothing does.
    Its button also went through the reachability probe, which is guaranteed to fail
    here: the phone is on the device's own network, which is the whole point. First
    tap did nothing while the probe timed out.
    The step-by-step disappears once the device answers. Every step describes getting
    to that moment, so keeping them afterwards ask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
2026-08-07 Keep revocation in the presented build; only sharing contradicts the story
    Hiding both was wrong. What conflicts with "only someone who stood in front of
    the device can command it" is the QR code, which lets access cross town.
    Revoking demands the three buttons and the PIN - it is the same rule's other
    half, physical presence to grant and physical presence to take away.
    It is also the answer to the question the panel is most likely to ask about
    selling the device or about someone who should no longer have access. Removing
    it left that question unanswerable in exactly the build being presented.
2026-08-11 Close the door the reduced build could not open but still answered
    Three things the scope flag missed, all the same shape: text and behaviour that
    assume a QR code the presented build does not have.
    The app still listened for invitation links. It could not generate one, but a
    code saved from before would still register the greenhouse with its key - and
    "only someone who stood in front of the device can command it" would stop being
    true in exactly the build where that sentence is defended.
    After revoking, both the confirmation and the card explaining what would happen
    told the grower to share a new QR code. In the reduced build the way back is what
    it always was there: walk to the device an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
2026-08-11 Keep the revocation diagnostics out of the presented build
    The line with the HTTP code and the key's fingerprint is a support tool. It
    earned its place while the key was going missing, and it stays in the full
    build for the next time something like that happens. Under the only action on
    the screen, during a presentation, it is technical noise - and whoever is
    debugging is not using that APK anyway.
2026-08-11 Write the access shortcut from the side of whoever reads it
    The verb goes first, because that first word is what decides whether someone
    taps the card.
    And it receives rather than shares. Whoever opens this is the phone about to
    gain access, standing at the device, not the one that already has it - a
    subtitle written from the giving side would send them looking for this screen on
    someone else's phone. "Sharing" would also imply the other phone has to do
    something, when it never even finds out.
2026-08-11 Name the screen after what it is doing, and the PIN after when it appears
    The title still said "Configurar aparelho" while taking access, which is the one
    mode where nothing is configured. The branch for it was written and never
    reached the file - a scripted multi-edit failed partway and the rest was assumed
    to have landed.
    The hint under the PIN said the numbers appear in configuration mode. True, and
    system vocabulary, and odd on a screen that just promised to configure nothing.
    It now says when they appear in terms of what the person just did: after holding
    the three buttons. That works for all three uses of this screen.
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2026-08-11 Round the hold up to two seconds, and say what the button is
    Nobody counts one and a half seconds in their head. Two is what the screen says
    now, while the firmware still releases at 1.5 - rounding up always works, since
    anyone who holds for two has passed 1.5. Rounding down would be the error: they
    would let go early and conclude the device ignored them.
    "Tap below" became "tap the button below", and the button itself dropped the
    sentence for the name of the thing it does.
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2026-08-12 Take scheduling out of the presented scope, switch and all
    "At two o'clock set it to 120F" is curve automation, and none of the five
    declared objectives asks for it: monitor, control, synchronise, record, alert.
    It goes behind the same build flag as sharing.
    Its sound preference goes with it. A switch for a reminder that can never fire
    is worse than no switch - it invites the grower to configure something that does
    not exist, and nothing he does there will ever be observable.
    The drawer inventory test now asserts both halves of the reduced scope, so
    removing one and forgetting the other fails rather than shipping.
2026-08-12 Call it reconfiguring when the device is already configured
    From inside an existing greenhouse the device is set up and reporting, so
    "configure" describes something that already happened. The first time has its own
    place, under adding a greenhouse.
    The prefix also does a small job: it says you are about to change something that
    works. Anyone who opened the drawer by mistake reads it and hesitates, which
    "configure" - sounding like something new and harmless - does not encourage.
2026-08-12 Let the run labels use the second line they always needed
    Name, date, time and "in progress" rarely fit one line on a phone, and what got
    cut was the end - which is exactly the part that tells one run from another. The
    grower was choosing between two identical-looking lines.
    The tap-to-reveal bubble from the monitoring app bar was the obvious borrow and
    the wrong one. That bar has a fixed height and nowhere to grow; this card has
    room. And the two places it would go already answer to a tap - one opens the
    list, the other picks the run - so the bubble would have been fighting the
    gesture that was already there.
2026-08-12 Count alarms as episodes, not as readings taken during one
    The summary counted readings whose alertaIncendio flag was set - and that flag,
    despite its name, carries alarmeAtivo, which is temperature or fire. So "ALARMES:
    17" never meant seventeen alarms. It was duration wearing a counter's clothes,
    measured in readings, whose spacing depends on thinning and on which source
    supplied them.
    The events already record the edge: alarme_processo and alerta_incendio are
    written once, when the siren starts. Counting those gives the number the word
    promises, and it matches what the grower can count by hand in the list directly
    below - the only check available to him.
    Drift stays out. The app notices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
2026-08-14 Stop a fixed IP from one network following the device into another
    [sentinela_esp32.ino]
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2026-08-18 Two sensors in two places is the requirement, not a workaround
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2026-08-26 Add a bench sketch that tells a bad joint from a bad pin
    The firmware cannot check the board: LEDs only light when temperature
    leaves the band and the buzzer only sounds on alarm, both slow to stage
    on a bench. The sketch drives one LED at a time, so two lighting together
    means a solder bridge rather than a wiring mistake.
    Also record why the terminal count fits: one per signal needs 14 and there
    are 12, and a common ground for the LEDs and for the buttons closes the
    gap. Found now rather than mid-assembly, where the fix would mean
    desoldering terminals already fixed.
    [teste_placa.ino]
2026-08-27 Put a multimeter on the list, and say what to do until it arrives
    The power terminal carries VIN and GND two columns apart, so a whisker
    of solder between them makes the first power-up a short across the
    supply. Continuity checking is what the meter is for here, not
    debugging.
    Until there is one, the first power-up goes through the computer's USB
    port rather than the wall supply: the port limits current and gives up
    instead of insisting, which turns a burnt board into a board that simply
    does not enumerate.
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2026-09-02 Correct the pull-up value to what the meter actually read
    The resistor was picked by elimination — three matching ones for the
    LEDs, the odd one out for the DHT22 — and that identified the right part
    while assuming the wrong value. It measures 860 ohms on the assembled
    board, not 4.7k.
    Left in place rather than swapped: it pulls harder than the datasheet
    asks but stays inside what the sensor sinks, and the 5 m cable stage
    already called for a stronger pull-up. The bench sketch decides it.
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2026-09-06 Settle how the fan gets switched, before it changes a purchase
    The motor turned out to be 1/8 hp on 220 V: 4 A of inrush against a 10 A
    contact, so a single relay switches it directly and no contactor is
    needed. That was the open question.
    Two decisions reach further than the relay itself. Keeping everything in
    one enclosure — the producer's call, since every device on the market is
    built that way — puts mains beside a hand-soldered board, so the box now
    needs a mains compartment and a divider, and that changes the size to buy
    today rather than later. And answering that the fan stays off when the
    board reboots or hangs is a hardware requirement, not firmware: the GPIOs
    float during boot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
2026-09-06 Take the wall adapter off the list and put back what it was missing
    The 5 V adapter was going to be thrown away twice over: the bench runs off
    the computer's USB, which also current-limits where a 2 A supply would
    not, and the single-enclosure decision moves the converter inside anyway.
    A phone charger already in the house covers the months in between.
    Adds the small screwdriver, which is what actually blocks the build today,
    and the standoffs — the copper side has solder peaks and cannot rest on
    anything, and nothing in the list said so.
    Also flags that the DS18B20 bought in August has no place in the firmware
    or on the board. Better asked now than after the box is drilled.
2026-09-06 Put every purchase in the shopping list, including the later stages
    The relay parts were sitting in the design section that argued for them,
    so the shopping list was missing a third of what the device needs. A list
    split across two places is not a list you can take to a store.
    The reasoning stays where it was; only the table moved.
2026-09-06 Spell out the standoffs, and tie the no-contactor answer to this motor
    The list said M3 standoffs without a height, which is the part that
    matters: the copper side carries 2-3 mm solder peaks, so anything under
    6 mm defeats the point. Nylon over metal, and screwed over adhesive,
    since adhesive lets go in a hot humid box.
    The contactor answer follows from a 1/8 hp nameplate, not from the
    socket. Greenhouse equipment gets swapped, and a bigger fan on the same
    relay is exactly the mistake this note is here to stop.
2026-09-06 Record the board's verification and how the parts get connected
    The continuity sweep and the group-by-group procedure existed only in
    working notes. The sweep is evidence the board was checked before power,
    and it comes with three results that look like faults and are not — the
    LED paths that stay silent behind 220 ohms, the terminal that reads 4.64k
    because the pull-up bridges it, and the two ground buses that only meet
    inside the module.
    The colour convention is written down for the same reason: brown is
    always ground and orange always supply, so an open box in two years
    answers without a document.
    Also notes what the floating flame pin means beyond the bench. A broken
    sensor cable put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
2026-09-06 Size the internal supply by the board, not by the fan
    Writes down that the mains splits into two paths that never meet again:
    one becomes 5 V for the board, the other stays at 220 V and is only gated
    by the relay contact. The fan never sees 5 V, so it never enters the
    supply's sizing.
    What does enter it adds up to about 675 mA at peak, mostly the ESP32
    transmitting. That puts the 3 W module under the peak, and a supply at
    its limit resets the board exactly when it transmits — which surfaces as
    a network problem, where nobody looks for it. Specified 5 W instead.
2026-09-06 Compare the relay to the motor rating, not the resistive one
    The note justified the relay against its 10 A figure, which is a
    resistive rating and the wrong yardstick for a motor. These relays also
    carry a horsepower rating for motor duty, typically 1/3 hp at 250 V, and
    1/8 hp sits inside it — a defensible comparison rather than a lucky one.
    Records why a shop or a search engine answers 'buy a contactor' for the
    same question: without the nameplate, caution is the correct answer, and
    most greenhouse motors are far larger than this one.
2026-09-06 Put a contactor in, for wear rather than for current
    The relay does carry this motor: 1/8 hp against a contact rated around
    1/3 hp. That was the whole question and it stays answered.
    But being able to switch it is not the same as lasting. The producer says
    the fan cycles many times per curing run with no pattern, which puts the
    relay past fifty thousand operations in a season against a life of about
    a hundred thousand. A contactor moves the arc off a seven-real part that
    gets thrown away and onto contacts built to take it and cheap to replace.
    The wear does not vanish — it changes to a part designed for it. And the
    contactor's height is now what sets the enclosure depth, which is why
    thi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
2026-09-06 Mark the snubber optional once the contactor carries the motor
    The relay now opens a coil at about a tenth of an amp instead of a motor
    at four, which is roughly one percent of the contact's rating. At that
    duty the relay outlives the device, so the RC pair went from fixing a
    real limit to extending one that no longer binds.
    Kept on the list because it costs ten reais and fails open, but marked
    optional so it is not confused with the DHT22 pull-up, which is not.
    Also notes the RC is for an AC coil: a flyback diode belongs on a DC coil
    and would not survive here.
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2026-09-09 Close the record: every group answers on the soldered board
    All six responded under the device's own firmware rather than the bench
    sketch, which is the result worth recording — the prototype's behaviour
    survived the move off the breadboard.
    Also writes down how to provoke each one from the real firmware, since
    that is not obvious: the buttons each do two different things depending
    on whether the device is adjusting, and the alarm needs the target about
    20 F away rather than 8. The margin widens after a target change to let
    the barn settle, so stopping at 8 reads as a broken alarm when it is only
    waiting.
2026-09-09 Give the 100 nF capacitors their job: the far end of long cables
    They were bought without a written purpose. Five metres of cable makes
    the supply sag at the sensor every time the radio transmits or the buzzer
    sounds, and the reading fails with nothing to point at. One across VCC
    and GND at the sensor body holds it steady.
    Also splits the pull-up question per sensor instead of treating the long
    run as one change. The DS18B20 needs nothing, the flame sensor needs the
    spare 4.7k so a broken cable stays quiet instead of crying fire, and the
    DHT22's swap waits until a reading actually fails — the resistor it would
    replace is already soldered to the board.
2026-09-09 Read temperature from the DS18B20 and leave humidity to the DHT22
    The two sensors sit in different places in the barn — the sealed probe
    goes among the tobacco, the humidity sensor hangs elsewhere — so reading
    both from one part described one location and called it two.
    Nothing outside the firmware changes: there is still exactly one
    temperature in the system, only its source moved. The database, server
    and app keep working on the same field.
    Splitting the sensors splits the failure too, and that is the real gain.
    A dead humidity sensor used to take the temperature alarm down with it,
    because one flag covered both; now it does not. The status gains
    umidadeOk for the half that leituraOk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
    [sentinela_esp32.ino]
2026-09-09 Catch the disconnected probe by range, not by equality
    Comparing the reading against DEVICE_DISCONNECTED_F with == let the
    sentinel through: it is a computed float, and the returned value did not
    land on the same representation. The error value became a temperature,
    reached the app as -197 F and tripped the low-temperature alarm.
    A DS18B20 cannot read below -67 F, so anything under -100 is a fault and
    never a measurement. Range says that; equality only says whether two
    floats happen to match.
    Boot now also prints how many probes answered on the bus, which is the
    one number that separates a wiring problem from a code problem.
    [sentinela_esp32.ino]
2026-09-09 Name the board's weak joint before it fails in a barn
    Three wires came loose in one day and all three were the same kind: a
    wire soldered on top of an existing joint, with no hole holding it. On
    this board they are the majority, because every jump reaching an ESP32
    pin or a bus lands where the hole is already taken.
    Reheating old solder without fresh flux is what makes them brittle, and
    a bench finds them in minutes. A greenhouse finds them at three in the
    morning and hides them again by the time anyone looks.
    Also records what the three symptoms looked like, and the reasoning that
    solved the first one: three things failing at once points at what they
    share, not at three faults.
2026-09-09 Separate the third fault: it was a screw terminal, not a solder joint
    The previous note filed all three of the day's failures under weak
    surface joints. The DS18B20 one was not on the perfboard at all — the
    loose wire sat in the adapter board that shipped with the probe.
    That is a different failure with a different cause. Probe wire is
    stranded, and stranded wire under a screw splays: the screw catches part
    of the bundle and the rest only pretends to be connected, which holds
    until someone touches the cable.
    So the tug test covers terminals too, including the ones on boards that
    arrived assembled.
2026-09-09 Adjust the target the display is already showing
    Entering adjust mode forced the screen back to temperature. Someone
    looking at humidity who pressed to adjust was thrown to a different
    number with no explanation, and read it as having pressed the wrong
    button.
    Now the buttons move whatever is on screen, and the humidity LED stays
    lit while adjusting — with a number blinking, that light is the only
    thing saying which of the two is being changed.
    The humidity target still actuates nothing: it is the dashed line on the
    app's chart and a value the app syncs, and no decision in the device
    reads it. So it gets no accommodation window either — there is no alarm
    to accommodate. It does get cla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
    [sentinela_esp32.ino]
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2026-09-09 Hold a button to keep adjusting, at the app's own pace
    Changing a target meant one press per unit, on a display that blinks
    while you do it. Ten presses to move ten degrees reads as a device that
    is not responding, which is how this surfaced.
    Holding now repeats every 200 ms — the same interval the app's
    BotaoContinuo uses. The producer already learned the gesture there, and
    two rhythms for one action would be two things to learn instead of one.
    Only inside adjust mode: outside it green flips the display and red opens
    the adjustment, and repeating those means nothing.
    Saving now waits 1.5 s after the last change instead of waiting to leave
    adjust mode. Before, a target lived only in RAM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
    [sentinela_esp32.ino]
2026-09-09 Slow the held repeat to one value per blink of the display
    Matching the app's 200 ms turned out to be the wrong way to match the
    app. On a phone the number sits lit and readable; here it blinks every
    400 ms, so a step every 200 ms changed the value twice per flash and
    twice more while dark. The producer saw it jumping in fours with no way
    to stop where he meant to.
    Tying the step to the blink instead shows every value it passes through.
    The number is the same idea as the app's — a pace you can follow — just
    arrived at from what this display actually does.
    [sentinela_esp32.ino]
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2026-09-11 Give every cloud call a deadline, the TLS handshake included
    None of the three cloud calls set a timeout, so each inherited the
    library's: five seconds for the response and 120 seconds for the TLS
    handshake. With the free server waking up, the whole loop sat still that
    long — no buttons, no display, and no answer to the app polling on the
    local network, which is why readings seemed to lag until a command
    nudged them.
    HTTPClient's setTimeout does not reach the handshake; that deadline
    lives on the secure client, and it is the one that ran to two minutes. A
    fix applied only to the HTTP object would have left the worst case
    untouched.
    It is also a safety change, not just a responsiveness on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
    [sentinela_esp32.ino]
2026-09-11 Say why the device last restarted, and how long it has been up
    "The display went dark and came back" has two causes that look the same
    from outside: the loop frozen on a network call with the display holding
    its last frame, or the chip actually resetting. They have different
    fixes, and nothing on the device told them apart.
    Boot now prints the reset reason in plain words — power, watchdog, an
    exception, a brownout. The same reason and the uptime go into /dados so
    they can be read from a phone browser, which is how this gets
    investigated in the field where there is no laptop on the Serial port.
    An uptime shorter than the time you have been standing there means it
    restarted.
    [sentinela_esp32.ino]
2026-09-11 Queue the loop stalls, with what is fixed and what is decided
    The analysis lived in a file outside the repository and in conversation.
    The work queue is where the next person looks, so the item goes there
    with its state split honestly: the two-minute worst case is capped, the
    one-to-two-second routine stall is not, and moving the network onto its
    own core is decided for after the defence rather than before it.
    Records the reason for waiting, because it is not caution for its own
    sake: two tasks writing the same targets without a mutex turn a stall
    you can feel into data corruption you cannot find.
    Also records the open question that decides what comes next. A display
    that goes dark and ret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
2026-09-11 Let every alert wait for the adjustment, fire included, up to 30 s
    Extends the previous change to deviation past 175 F and to flame, at the
    producer's request: nothing is sent to the cloud while the buttons are in
    use, because sending blocks the loop and stopped the held adjustment
    mid-gesture.
    Only the message to people away from the barn waits. The siren on the
    device still sounds at once — it never blocked anything — and the
    producer holding the button is standing next to it.
    The ceiling is the part that is not optional. Waiting ends when the
    adjustment ends, five seconds after the last touch; but a stuck or
    shorted button keeps the adjustment open indefinitely, and with it the
    fire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
    [sentinela_esp32.ino]
2026-09-11 Write a restart point that stands on its own
    The existing handoff stopped on 4 August and knows nothing of the device
    leaving the breadboard, the temperature sensor moving to the DS18B20, or
    any of September's firmware changes — while still being the file a new
    session opens first.
    The replacement is written to be pasted into a conversation with no
    access to the repository, because the work continues from a phone for a
    while. So it carries the facts rather than pointing at them: the rules
    that cannot bend, where each part stands, the open tests in order, the
    evidence matrix with what is proven and what is not, and the decisions
    still waiting on the producer.
    The old file keeps its histor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
2026-09-14 Say 5 F, the real limit, in the temperature deviation event
    The attention level fires above the 5 F tolerance, but the text said
    10 F, so the report printed "more than 10 F (8 F of difference)", a
    line that contradicts itself.
2026-09-14 Fetch the cloud history on the preloaded report too, and wait for it
    Since the report started using the data the monitoring screen loads
    ahead of time (04/08), the preload replaced the normal load instead of
    going through it, and the cloud lookup only lived inside the normal
    load. Opening the report the usual way, from monitoring within three
    minutes, never asked the cloud at all, so the fixes of 21/08 (device id
    and key on the request) sat on a path that almost never ran.
    The preload now feeds the normal load, so both paths fetch the cloud.
    Exporting also waits for that fetch when it is still in flight: the
    screen renders the phone's readings first and completes later, and a
    PDF or CSV tak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
2026-09-14 Record why the report never showed the cloud history
    The field run of 13-14/09 printed a PDF with a whole night empty while
    the database held six readings per hour. Two app defects, one hiding
    the other, both landing on "only what the phone recorded", which looks
    like "the app was closed" and so went unnoticed. The handoff marks the
    cloud-path test as failed and to be redone with the new APK.
2026-09-14 Log a deviation only past 8, the line the device alarms on
    The report's deviation events fired above 5 while the device siren,
    the LED and the chart all draw the line at 8, so a run could list
    "temperature below the setpoint" for a 6 or 7 F gap that nothing else
    in the system called a problem. The detector now uses the same
    margemAjuste as the LED and the chart, for temperature and humidity,
    above and below. Humidity still only logs, never alarms; the critical
    level above 20 and the accommodation allowance are unchanged.
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2026-09-14 Reconnect to the configured Wi-Fi, not the factory placeholder
    manterWifi() retried with WIFI_SSID/WIFI_PASS, the compile-time
    placeholders ("SUA_REDE_WIFI") that became mere factory defaults when
    the network turned configurable on 20/07. Any drop longer than 15 s,
    or a first attempt at boot that failed, left the device hunting for a
    network that does not exist, and the begin() also overwrote what the
    driver's own auto-reconnect would use. Only a power cycle brought it
    back, which is why power-loss tests passed and nobody saw it.
    The post-connect steps (NTP, learned gateway, fixed IP) also ran only
    when the first attempt succeeded, so a network that showed up later
    left the clock unset and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
    [sentinela_esp32.ino]
2026-09-14 Mark remote access as proven in the field on 13-14/09
    The app worked in cloud mode over mobile data with the phone off the
    device's network. The screenshot of the connection details showing
    cloud mode is still missing for the evidence record.
2026-09-14 Mark offline operation as tested in the field
    The producer confirmed the device keeps working with no internet. The
    photo and the exact date are still missing for the evidence record.
2026-09-14 Stop retrying a key swap the cloud has already accepted
    The Serial showed "Chave -> nuvem HTTP 401" every cycle next to
    "Push nuvem -> HTTP 200". The rotation call authenticates with the
    previous key; once the cloud has stored the new one it rejects the old
    key with 401, and the device only cleared the pending swap on a 200
    from that same call. A swap whose reply got lost on the way (the cloud
    saved it, the device timed out) therefore kept retrying every 20 s
    forever, adding one more blocking HTTPS call to each cycle.
    The cloud only accepts a reading whose device key it knows, so a 200
    on the reading push with the device's own key now closes a pending
    registration or swap.
    [sentinela_esp32.ino]
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2026-09-14 Record the first complete report and queue the setpoint-event gap
    The 14/09 report of run #22 came out whole: the night filled from the
    cloud, all 208 readings in the CSV, one per hour in the PDF. It also
    showed that setpoint-change events only exist for changes sent from the
    app, one per pause, while changes made on the device buttons never
    appear. Queued with the fix path: derive the event from the setpoint
    the device reports once it stops changing.
2026-09-14 Store the process alarm, not the siren, in the reading history
    The alarm column and the "alarm changed" save trigger used alarmeAtivo,
    which is false whenever the producer switches the device buzzer off or
    silences it. On 13/09 the greenhouse sat 10 F below the setpoint for two
    hours with the buzzer off and the history recorded no alarm at all. The
    push already keyed off the condition (alertaTemperatura or fire); the
    stored reading now does the same. Payloads without alertaTemperatura
    (simulator, old firmware) keep the previous behaviour.
2026-09-14 Log the alarm when the process alarms, not only when the siren sounds
    Alarm events and the phone's history followed alarmeAtivo, the siren
    state, so switching the device buzzer off erased the alarm from the
    report: on 13/09 the greenhouse spent two hours 10 F below the setpoint
    with no "Alarme acionado" line. They now follow the condition the
    device reports separately (alertaTemperatura, or fire), and the line
    says when the siren was off or silenced, so nobody reading the PDF
    assumes it rang. Payloads without alertaTemperatura keep using the
    siren, as before.
2026-09-14 Derive setpoint-change events from the readings, and export them whole
    The "setpoint changed" events were written by the app when it sent a
    command, so changes made on the device buttons, by another phone, by a
    schedule or with the app closed never appeared, and adjusting in the app
    with pauses left one line per pause. Every reading already carries the
    setpoint the device reported, and the cloud saves a reading whenever it
    changes, so the report now builds the events from the readings: one
    "changed from X to Y" line per change, merging changes less than five
    minutes apart and dropping a round trip back to the same value. Stored
    events of that kind are swapped at display time, so old runs get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
2026-09-14 Record the offline-command test and the stale value after syncing
    The 14/09 test proves item #2 end to end: a local command reached the
    display in seconds, a command made with the phone offline sat in the
    queue as one pending item, and after reconnecting the device applied
    it (cloud log at 11:03:47, display photo at 11:04:12). Each screenshot
    and photo is listed with what it shows, since the images stay off the
    public repo. The same run showed the monitoring screen falling back to
    the old setpoint once it switched to local mode, with no hint that a
    command was on its way; queued as D8 with a check to run before fixing.
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2026-09-14 Mark the pending-setpoint fix as passed in the field
    Redone on 14/09 with the new APK: after the connection came back the
    screen kept the requested setpoint with the waiting notice until the
    device confirmed it, with no flash of the old value.
2026-09-14 Note the occasional missed button press under the loop stalls
    With the 14/09 firmware the long stalls are gone; what remains is a
    press now and then that needs two or three taps. It matches the 1-2 s
    the loop still blocks on each 20 s cloud poll, when a short press is
    never read. Recorded with a small interrupt-based fix, left for later
    by the producer's choice.
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2026-09-14 Stop saving an all-zero reading when a run ends before any data
    Ending run #22 saved a reading of 0 F, 0 % and setpoints 0: the end
    event writes a reading from the values on screen, and the screen still
    held its starting zeros because no device reading had reached it yet.
    The report then showed a final temperature of 0 F and three invented
    events at the end (setpoint changed to 0 twice, alarm back to normal).
    The screen now only writes history after it has received a real
    reading, and the report skips all-zero readings already stored on the
    phone, so run #22 comes out right without redoing anything.
2026-09-14 Record the router-off test: offline operation and self-reconnect
    With the router switched off the device kept reading and showing, the
    Serial gave the drop reason in the right order (signal lost, then
    network not found), and once the router came back the device rejoined
    by itself and the app reconnected with no one touching anything. That
    proves the reconnect fix and evidence item 1. Notes the harmless
    'sta is connecting' line as known noise.
2026-09-14 Record the flame sensor swap and its limits for the write-up
    The real flame sensor replaced the light sensor on 14/09 and works,
    within what a low-cost IR photodiode module does: about 30 cm for a
    lighter flame, triggered by daylight but not by an LED flashlight.
    Notes why, how to place it in a closed barn (away from the furnace and
    the door), the temperature fire limit as the second layer, and a UV/IR
    detector as future work.
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2026-09-16 Note how to drive the fan relay from the ESP32
    The relay module that arrived has only three pins, so its input runs at
    5 V and the 3.3 V logic cannot switch it off cleanly. Records the NPN
    transistor (or small MOSFET) that fixes it, the fail-safe behaviour it
    gives, and the pin choice: GPIO 16 or 17, never GPIO 14, which pulses at
    boot and would start the fan on every restart.
2026-09-16 Record the 15/09 test round and the two issues it exposed
    The remote-access evidence was missing the NUVEM print and the test log
    item was still open. The round also showed the monitoring screen opening
    with zeroed values and live +/- buttons when offline, and event times
    across two days without dates.
2026-09-29 Drive the furnace fan relay from the temperature control
    The controller already decided when the fan should run and only lit an
    LED with it. Point that same decision at a relay output, hold each state
    for at least 30 s so the contactor and the motor are not cycled, and let
    a sensor failure stop the fan without waiting. The reported fan state
    was hardcoded false and now says what the output is doing.
    [sentinela_esp32.ino]
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2026-09-29 Stop the fan while there is fire
    The fan blows air into the furnace to make the fire burn stronger, so
    keeping it on during a flame or fire-risk alert would feed the fire. It
    now stops immediately in that case, without the minimum switching delay.
    [sentinela_esp32.ino]
2026-09-29 Explain where the flame sensor sits when the fan stops for fire
    The reason written down was wrong: the sensor is outside the furnace, so
    fire inside it is normal and a detection means flame left the furnace,
    pushed by the fan itself.
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2026-10-13 Correct the two board vias recorded as free
    Measured with the ESP32 unplugged: one is tied to 3V3 and the other to
    D23, so the fan relay is soldered straight to the board instead.
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2026-10-14 Show the real fan state on the diagnostics page
    The page already showed the temperature-control decision under a name
    that dates from a LED the device no longer has. With the controller
    closed inside the box there is no Serial, so the page is where the relay
    state has to be visible, and it differs from the decision during the 30 s
    hold and whenever there is fire.
2026-10-14 Let the buzzer button command the fan, and flash without a cable
    The producer had no way to stop the fan while working on the furnace, and
    every firmware change meant opening the sealed box. The button now also
    toggles the fan and holds that choice until pressed again, with the
    display colon blinking while it is the producer keeping it stopped; fire
    and a blind sensor still override it. The config page, which already
    requires holding the three buttons and the screen PIN, now accepts a .bin
    upload.
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2026-10-14 Cut the fan off one degree above the setpoint
    Cooling waits on the fire catching, so it is slow, while overshooting is
    quick: the upper edge of the hysteresis now acts earlier than the lower
    one. The 3 F dead band plus the 30 s hold still keep the contactor from
    cycling.
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2026-10-14 Warn that a paused database looks exactly like a wrong device key
    The free Supabase project pauses after idle days; with the database down
    the key lookup comes back empty and the cloud answers 401, which sends
    you hunting a credential problem that does not exist.
2026-10-14 Stop the fan the moment it should stop
    It feeds the fire, so holding it for another half minute after the barn
    passed the setpoint pushes the temperature the wrong way. The minimum
    switching time now guards only starts, which still keeps 30 s between two
    of them.
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2026-10-15 Stop waiting on the probe and on the display
    Two small stalls repeated forever: the loop sat ~190 ms waiting for the
    DS18B20 conversion every 2.5 s, and redrew the same four digits over the
    TM1637 on every single pass. The conversion is now collected when it is
    ready, and the display is written only when what it shows changes.
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2026-10-15 Let the phone's file picker show the firmware file
    The upload field asked for ".bin" only. Android turns that into a MIME
    type, finds no owner for .bin and shows the folder as empty - the file is
    right there and cannot be picked. Sending the update from a phone is the
    whole point of this page, so the filter goes.
    Picking the wrong file breaks nothing: the image header is checked before
    anything is written.
2026-10-15 Redraw the display even when nothing changed
    Writing it only on change was right for the loop and wrong for the
    hardware. The TM1637 cannot be read back, so the cache held what it
    believed was on screen - and when the display lost the frame it was never
    written again. The screen went black with the device working normally,
    which the app confirmed by showing everything fine. The frame is lost at
    the moment the contactor coil switches 220 V inches from the data wires.
    What gave the cause away: pressing the fan button brought the screen
    back. Not by restarting anything - toggling the lock changes the colon,
    so the cache saw a difference and wrote.
    Now the frame is redrawn once a second and ri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
2026-10-15 Put the coil suppressor back on the list, as needed this time
    It had been written down as optional, judged only by contact life, and
    with the contactor in the chain that argument was sound. The box being
    assembled changed the question: the display now blinks every time the
    contactor switches. The firmware redraws the screen it just lost, so what
    is left is cosmetic - but the spike still leaves the coil on every
    switch, inches from the display's data wires inside a closed box.
    The reason to do it is the part nobody sees. The same spike crosses the
    DS18B20's one-wire bus, and a corrupted reading there stops the fan by
    design. The known worst case is sagging the 5 V and restarting the
    controll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
2026-10-15 Give the app its own icon
    It was still the default Flutter logo. On a phone in an examiner's hand
    that is the first thing seen, and it says template.
    The artwork is the producer's: three leaves with circuit traces and a
    thermometer. The dark version is the one used - the whole app is dark, so
    it does not clash on the opening screen, and at 48 pixels the green
    leaves against the near-black hold their shape, while in the light
    version the cream leaves melt into one blob.
    Android needs two icons and this provides both: the square one for older
    phones, and the adaptive pair that newer ones crop into whatever shape
    the manufacturer wants. The trick that avoids cutting the artwork out of
    its bac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
2026-10-15 Stop the connection badge from flickering between its three states
    Reported right after the previous fix: the badge now alternates every few
    seconds between offline, cloud and local, and the greenhouse card can say
    one thing while its own monitoring screen says another.
    Three causes, one per layer.
    The resolution was valid for eight seconds while the screen reads every
    three, so every two or three readings the app stopped and probed
    everything again - and a probe is a fresh connection, which fails for a
    dozen passing reasons, the mDNS name chief among them. One such failure,
    with readings arriving normally, was enough to move the badge. A reading
    that arrived over the local connection prov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
2026-10-15 Drop the bench sketch from the tree, keep it findable
    It existed to check the board before the box was closed, and the box is
    closed. In the tree it would keep showing up in every search for the pin
    map and every firmware listing, as a second sketch that is not the
    firmware.
    The three places that walked someone through using it now say where to
    get it back - the commit that added it - instead of pointing at a path
    that no longer exists.
2026-10-15 Draw the wiring the way it gets read at the bench
    Everything about this build was written as prose and tables, and prose is
    the wrong shape for "which wire goes where" when you are holding a
    screwdriver. Four sheets, A3 landscape, still legible printed on A4.
    The electrical one is a single picture, with photos of this device's own
    parts, and each of the two mains wires keeps its colour from the plug to
    the motor so one can be followed with a finger. It states the two things
    that confuse people here: the motor's power leaves before the fuses,
    which protect only the electronics, and the relay closes the coil, never
    the motor.
    The perfboard sheet names all 24 vias from the board's own silkscr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
2026-10-15 Give the firmware job the two libraries the probe needs
    Every run since 9 September has failed on "OneWire.h: No such file or
    directory" - a hundred out of a hundred. The DS18B20 arrived that day
    with its two libraries, which were installed on the machine that compiles
    and never added here, so the build passed locally and only ever broke on
    the runner.
    A check that always fails stops being read, which is why today's mail
    about a red build was the first anyone looked.
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2026-10-15 Bring the radio back without taking the device down with it
    Reported from the field: the only way out of a stuck Wi-Fi was pulling
    the plug. The upkeep loop repeated WiFi.begin() every fifteen seconds and
    nothing else, which recovers a lost signal and does not recover a stuck
    radio - over a stack left half way, begin() does nothing at all.
    After four failed attempts the radio is now torn down and brought back:
    disconnect, power the radio off, and on the next pass through the loop
    set station mode and connect again. The two halves live in different
    passes on purpose, because sleeping between them would stop the control
    loop, which is the one thing that must not stop. If it still does not
    com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
2026-10-16 Correct the display fault: it was a cold joint, not the contactor
    With the box open and the board on a power bank, tapping anywhere on it
    made the display dim. The display's own wires did nothing. /dados settled
    which half it was: the seconds since boot kept counting, so the chip never
    restarted, which rules out the 5 V side and points past the regulator -
    the 3V3 and ground buses on the bottom edge, the ones that feed the
    display and the three sensors and not the ESP32.
    It dimmed rather than died: a resistive contact, not an open one, which
    is why continuity beeped and proved nothing. Reflowing fixed it.
    That rewrites D12. The producer recognised the fault from when the board
    still lived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
2026-10-17 Stop the app offering a setpoint the device will refuse
    The device now caps the setpoint at 165, and the app still went to 200 in
    two places: the plus and minus panel and the scheduling screen. Asking
    for 180 worked - the screen showed 180 with "waiting for the barn", the
    device cut it to 165 and the screen came back on its own - and looked
    exactly like a bug.
    Both now read the same two constants, and the file that holds them says
    which ceiling is the real one: the device's, because it cuts what comes
    from the buttons and from the cloud alike. The app's is only there so the
    screen stops offering what will be refused.
    The server still accepts up to 200 on purpose. That bound is a guard
    agai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
2026-10-18 Draw the same DER in Chen notation
    der_nuvem.png shows the tables as boxes of columns, which is what a tool
    exports and what most of these diagrams look like. The examiners expect the
    classic shape: entity in a rectangle, relationship in a diamond, attribute in
    a circle, (min,max) on each leg. Same seven tables, same two kinds of link,
    so either figure can go in the paper without the text changing.
    The attribute fans use alternating radii. With a single radius the twenty
    columns of leituras collide no matter how wide the arc is opened.
2026-10-18 Put the four figures on one printable palette
    The navy-and-green scheme was the default of the tool that drew them, so the
    four figures looked like someone else's figures, not like the paper's. They
    are now black line on white with a single mustard accent, the same in all
    four, and the accent always means the same thing: a link that exists by the
    hardware identifier, with no declared foreign key.
    In the sequence diagram the red arrows carried meaning, so dropping the
    colour would have lost it: failed replies are dotted now, not just dashed.
    That also survives the printer, which is where the paper ends up.
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2026-10-18 Record that the paper understated what the app does
    Writing the abstract, "sem internet" got used as a synonym for the offline
    mode. Offline is the third case, the one where there is no Wi-Fi either. The
    case the whole work exists to prove — local network, no internet, reading and
    commanding straight at the device — was written as "the app stayed reachable
    over the local network". Reachable is not commanding.
    Worse, the future work promised delivering the queue straight to the
    controller when both are on the same network. That is what the app already
    does: the command goes to whatever base the resolver returns, and the
    resolver probes the local candidates first. Only the cloud path wait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
2026-10-20 Catch the assembly map up with the board that exists
    Five places described the device as it was planned in August, not as it was
    built. The pinout table had no DS18B20 and no relay, and still listed the
    control LED that came out on 09/09. A whole section called the DS18B20 an open
    question when it has been the temperature sensor since September.
    The relay is the one that matters for anyone wiring the board: this file sends
    it to via K, and the firmware drives GPIO 16. The reason is in the code — 14
    pulses PWM while the chip boots, which would kick the fan on every reset, and
    16 comes up low. Changing the pin solved it, so the safety resistor the
    shopping list asked for is no longer needed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
2026-10-20 Let the fan lock release itself after five minutes
    The buzzer button stops the fan so the producer can put wood in the furnace
    without shutting the device down. It had no way back other than remembering:
    locked and forgotten, the fan never turned again, the barn cooled and the cure
    slipped. The only warning is two dots blinking on the display, which nobody
    sees from across the yard or at night.
    Releasing does not start the fan. It hands control back to the setpoint, which
    decides on temperature, exactly as pressing the button a second time always
    did. With the barn hot it stays off.
    Pressing the button before the deadline still releases immediately, and
    locking again restarts the five minu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
2026-10-20 Replace a guessed risk with what the producer measures
    The entry warned that the fan could start with someone still working at the
    furnace. That assumed stoking takes around five minutes. It does not come
    close, so by the time the deadline passes the job is long finished. Recording
    the field fact instead of my guess, so nobody later designs around a hazard
    that is not there.
2026-10-20 Stop a barn from changing device when the address changes hands
    A relative's controller was configured on the producer's network while his
    own was switched off, and the router handed the new ESP32 the address the old
    one had. From then on the app talked to that address, got a different
    idHardware back, and the registered barn started pointing at the wrong
    controller while carrying the old access key. Commands failed on credentials,
    in a barn that still showed the right name in the list.
    The firmware is not at fault: idHardware and the mDNS name both come from the
    chip MAC and never repeat. The app modelled identity as an address.
    EstufaEntity.chave was '<name>::<ip>' on a unique index with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
2026-10-21 Check who answers before trusting a local address
    The producer's controller was off, a relative's was switched on in the same
    network, and the router handed it the address the old one had. His barn,
    registered as sentinela-215788.local, started showing the other controller's
    numbers with a LOCAL badge, and commands failed on credentials.
    He said it had not always been like that, and that is what found it. d29d37e
    replaced ordered local probing with a parallel race to fix how long the barn
    took to connect. Its comment assumed ordering still protected identity, which
    holds only while nothing answers at the stale IP. With another ESP32 holding
    it, that one answers first and wins, because the m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
2026-10-21 Stop the radio from sleeping between beacons
    The producer sees the barn sit on LOCAL and drop to OFFLINE, sometimes to
    NUVEM, every ten or fifteen seconds, then come back on its own, with the
    network working and the device on the same Wi-Fi.
    WiFi.setSleep(false) was never called. An ESP32 in station mode defaults to
    sleeping between the router's beacons, so a reply that normally takes 50 ms
    occasionally takes seconds or is lost, and the app's probe concludes the
    device is gone.
    It hides from whoever looks for it: using the phone keeps the traffic awake.
    And it points at the wrong side, which is why it was already treated by its
    effect once, when the mDNS probe timeout was stretched to four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
2026-10-21 Correct the reason recorded for switching the radio off sleep
    The firmware entry blamed the flapping badge on Wi-Fi power save. D21 found
    the real cause in the app: the address learned from the device was normalised
    with port 3000, the local Node server's port, while the ESP32 serves on 80, so
    the mDNS escape route pointed where nothing answers.
    The change itself stands on its own merit and stays. What had to go was the
    explanation attached to it, because the explanation is what gets inherited: a
    later reader would have believed the symptom was understood and stopped
    looking. The audit entry now names the wrong hypothesis it displaced.
2026-10-21 Record that the badge stopped flapping on the real device
    D21 had the fix and the test but no field verification. The producer ran the
    corrected APK against his own controller and the badge stays on LOCAL. The
    note also says how to check it, since leaving the phone idle is what makes
    the fault show at all.
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2026-10-21 Keep a reading when only its configuration is out of range
    A reading carries the device's current configuration with it, and both were
    validated into the same list of errors, so one bad setpoint made the server
    refuse the whole reading. In the field that cost fourteen hours of telemetry
    while the link was perfect: temperature, humidity, alarm and history thrown
    away every minute because of a number that is not a measurement.
    Configuration is now validated separately. A malformed measurement is still a
    400, because nothing in it is usable, but a configuration out of range is
    dropped on its own and the reading is stored. The response names what was
    refused, and the server logs it at error lev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
2026-10-22 Identify a device by its whole MAC, and let a new one register
    The id and the mDNS name used the last 24 bits of the MAC. Espressif ships
    more than one OUI, so two chips could in principle share those bits, and
    identity is now the thing the app defends a barn with. Both widened to the
    full 48.
    Widening an id is the one change that must not look like a different device.
    ehMigracaoDeIdLegado accepts it in one direction only: six hex to twelve that
    end in those same six. Everything else is still another device, so the defence
    added for the relative's controller is not loosened to make the migration fit.
    The first key registration also came out from behind the auth middleware,
    because it could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
2026-10-22 Remove scheduling, and the quick actions it was part of
    None of the five declared objectives mentions timed adjustment, and the TCC
    build already hid it. Here it stops existing: the feature in the app, both
    route files and the scheduler in the server, their tests, the notification
    event, and the service start in main.
    The AÇÕES RÁPIDAS section went with it, because the other two items in it do
    not survive on their own either. Resetting the device's setpoints is a
    shortcut for what + and - already do on the main screen, and deleting cure
    cycles is a second door to the bin in the reports screen. No capability is
    lost; the drawer is two sections instead of three.
    Removing the ajusteAgendad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
2026-10-22 Take the QR invite out, and with it the flag that hid it
    The TCC scope flag existed so one codebase could ship two APKs: the full
    app shared access by QR Code, and the presented one hid that item because
    it contradicts the sentence the authentication chapter defends — only a
    phone that stood in front of the device can command it.
    On this branch there is no second APK to build, so the flag was paying
    for nothing: a constant read in three screens, a `escopoReduzido` field
    threaded through the drawer's data object only so a widget test could
    flip what `bool.fromEnvironment` resolves at compile time, and a test
    comparing the drawer against itself.
    Removing the invite removes the whole chain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
2026-10-22 Sweep out what the removed features left behind
    Deleting a screen leaves a tail: a table nothing writes to, a getter
    nothing reads, a field every caller still has to fill, and comments that
    describe a version of the app that no longer exists. The comments are
    the expensive part here — someone reading this code to understand it is
    told about a QR invite and a scheduling screen they will never find.
    The server kept the whole `comandos_agendados` story: table, index,
    insert, list and delete, with no caller since the scheduling routes
    left. It also kept `configVigente`, which existed so the scheduler could
    resolve "+10 F" at the moment of applying rather than of scheduling.
    Note the table it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
2026-10-23 Shorten the comments to what this version needs to say
    Not one executable line changes here: filtering the diff for comments
    and whitespace leaves the four largest files — api_service,
    isar_service_native, auth.js and alertas_push.js — with no difference at
    all. The rest is `dart format` reindenting what it touched. 731 lines
    out, 154 in, `lib` from 14,645 to 14,135.
    What leaves is the "why": the field defect that produced a line, the
    date it happened, what the wrong version did on screen. It is worth
    saying plainly that this is a loss — `limiar_incendio.dart` no longer
    records that the device and the server once disagreed on the same
    threshold, with the siren at 175 while the cloud w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
2026-10-25 Put back a short wait between fan starts, only to start
    Two presses of the black button, seconds apart, hung the device: the
    dots stopped blinking and only unplugging it came back. The green and
    red buttons kept working, which is the whole clue — the black one is the
    only button that touches the relay. Each press flips the fan lock, so
    two presses open and close the contactor, starting a 1-3 hp motor twice
    within seconds, centimetres from the board.
    The 30 s wait that would have prevented this was removed on 21/10 at the
    producer's request, and the firmware history recorded the risk in the
    same entry: "if the contactor starts chattering, this is where you come
    back, and a short wait of ab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
2026-10-28 Open the config mode with green plus red, not the black button
    The producer reports the black button answers intermittently, and it was part of
    the three-button combination that opens the config mode: the proof of physical
    presence depended on the least reliable button of the device, and holding the
    3 s without result was indistinguishable from getting the gesture wrong.
    Holding all three still opens it, since green and red are among them.
    Green and red are the target-adjust buttons, so the first contact to close now
    always moves the target before any combination exists - what used to be an edge
    accident happens on every attempt. Two guards: the NVS write is held off while
    the combination c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
2026-11-03 Draw the controller board in KiCad so the wires become copper
    Three surface joints have failed on three different dates, and all three
    were the same thing: a wire soldered on top of an existing joint, with no
    hole holding it. On a printed board those joints do not exist -- the trace
    is the jumper, and what is left to solder sits in a plated hole.
    The schematic comes from the firmware pin map and the terminal map, not from
    memory. The ESP32 symbol and footprint use the measurements the assembly
    document already records: columns G to U give 15 pins per row, lines 12 and
    22 give 25.4 mm between rows -- a DOIT DevKit V1 of 30 pins, confirmed pin by
    pin against every column the map cites.
    Place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
2026-11-03 Write the KiCad walkthrough and stop the labels overlapping the parts
    The labels were all justified left, so the ones leaving a pin towards the
    left wrote back over the symbol they came from. Justification now follows
    the label's own direction, and the wire stub grew to 7.62 mm.
    The walkthrough is the point of this commit: the generated project is a
    reference to compare against, not a replacement for drawing it. It carries
    the full label table, the footprint names, and the two checks -- electrical
    and design -- that have to come back at zero.
2026-11-03 Use pluggable terminal blocks so the wires are screwed off the board
    Wiring a KRE means a screwdriver inside the closed box, from the side, on
    your knees. The pluggable version splits that in two: the base stays
    soldered, the plug comes off whole and is wired on the bench with the screws
    facing up. Swapping a sensor mid-cure stops being surgery.
    Pitch is the same 5.08 mm, so the hole pattern does not change and a plain
    KRE still fits the same footprint if the pluggable ones run out.
